alxgmpr/adum4165-isolator/docs/revc/renders/pcb-3d-isometric.png

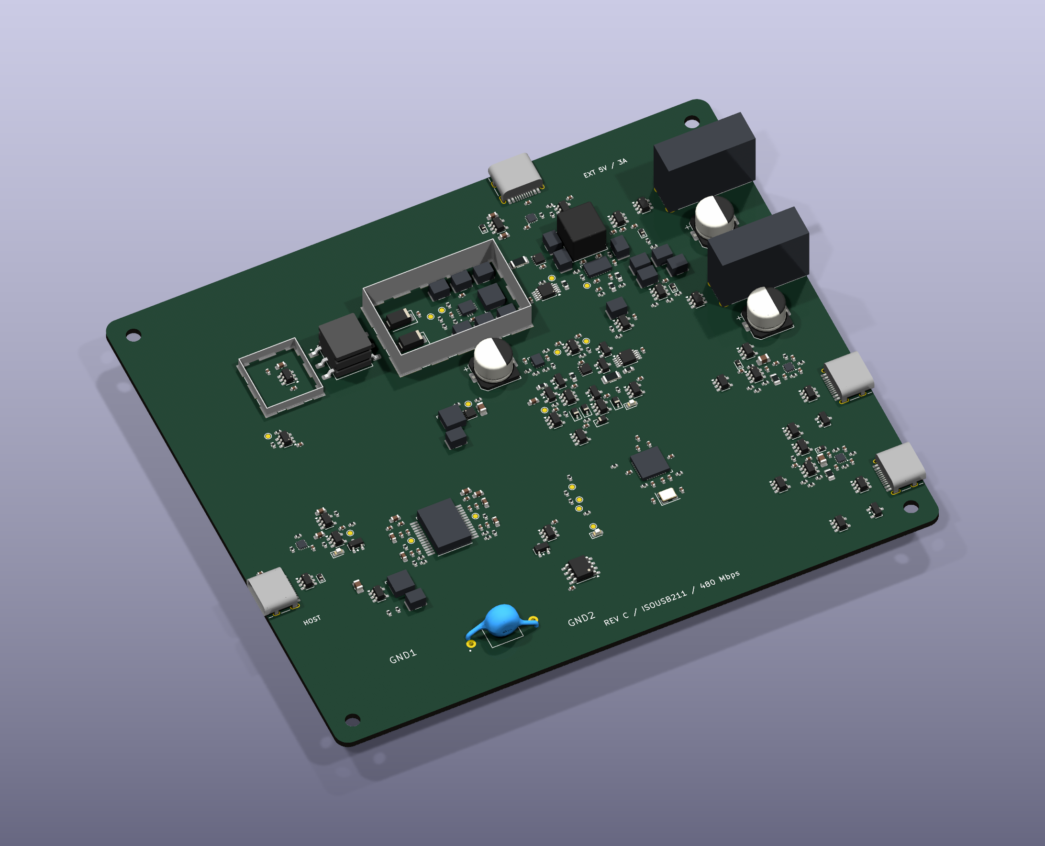
docs/revc/renders/pcb-3d-isometric.png
