alxgmpr/adum4165-isolator/docs/superpowers/reviews/2026-07-26-schematic-review.md

# Isolated 4-Port USB 2.0 Hub — Schematic Design Review

> **Repo note (2026-07-30):** this document describes the **archived 4-port
> design**. That project no longer lives at the repo root — it was archived to
> branch `4port-archive` when the repository collapsed to the single-port
> isolator. Every bare `isolator.kicad_sch` / `isolator.kicad_pcb` /
> `isolator.kicad_pro` path below refers to the **archived** files as they stood
> on that branch, **not** to the files of those names at the root today, which
> are the single-port isolator. Retrieve them with
> `git show 4port-archive:isolator.kicad_sch`.

**Project:** `isolator` (KiCad 10.0.5, single flat sheet, **no PCB yet**)
**Date:** 2026-07-26
**Branch / commit basis:** `feature/isolated-usb-hub`, after Task 11 (MPN population)
**Analyzers run:** `analyze_schematic.py` (run `2026-07-26_0129`), `deep_review_gate.py`, `check_report_sections.py`, `summarize_findings.py`, `diff_analysis.py`, `kicad-cli sch erc`
**Analyzers not run:** `analyze_pcb.py`, `cross_analysis.py`, `analyze_emc.py`, `analyze_thermal.py`, `analyze_gerbers.py`, SPICE, `lifecycle_audit.py` — see [Not Performed / Review Limits](#not-performed--review-limits)

---

## Verdict

**Schematic is release-ready for PCB layout. No blockers.**

ERC at severity `error` exits 0. Every BOM line carries a manufacturer part number (118/118 components, 37/37 BOM lines). Every IC's required externals were checked against its manufacturer PDF with page citations, and all 14 Deep Review findings passed the evidence gate with zero quarantined and zero partial citations.

One wiring change was made during this review (`U7.CP2`, see [Critical Findings](#critical-findings) DR-06). Five open items are carried to layout/bring-up; **none is a blocker and none forces a respin**. The largest, DR-01, turned out to be a documentation defect rather than a hardware one — the bus-powered ceiling is set by the host's 500 mA budget, not by the magnetics, and the spec's arithmetic has been corrected accordingly.

| Gate | Target | Result |
|---|---|---|
| `kicad-cli sch erc --severity-error` | exit 0 | **0 violations, exit 0** |
| Analyzer MPN coverage | ≥ 80% of BOM | **100% (118/118 components, 37/37 lines)** |
| SS-001 / SS-002 sourcing gate | cleared | **cleared — no SS finding emitted** |
| DS-001 / DS-002 / DS-003 datasheet gate | cleared | **cleared — 12 PDFs present, MPN coverage ≥ 90%** |
| Deep Review evidence gate | 0 quarantined | **14 verified, 0 partial, 0 quarantined** |
| Report completeness (`check_report_sections.py`) | all sections | **19/19 present, exit 0** |

---

## Overview

A galvanically isolated 4-port USB 2.0 hub. A USB-C host port (J1) feeds an **ADuM4165BRIZ** 5.7 kV<sub>rms</sub> high-speed USB isolator (U1, V<sub>ISO</sub> = 5700 V rms for 1 minute, V<sub>IORM</sub> = 849 V peak) with a local 24 MHz crystal on Side 1. The power barrier is set by T1's 5000 V rms insulation test voltage, so the assembly is a 5 kV<sub>rms</sub>-class design overall even though the isolator itself is rated higher. Isolated power is generated by an **SN6505BDBVR** push-pull driver (U5) into a **Würth 750313638** 1:1.3 transformer (T1), Schottky-rectified (D1/D2) to `DCDC_RAW` and regulated to 5.0 V by a **MIC29302WU** adjustable LDO (U6). An alternative external supply arrives on a power-only USB-C receptacle (J2); two **TLV7041DBVR** comparators (U13/U14) watch the CC lines for a 3 A source advertisement, and a **TPS2121RUXR** priority mux (U7) merges the two 5 V sources into `ISO_5V`. A **USB2514B-AEZC** 4-port hub (U4) runs from `ISO_3V3` (AP2112K-3.3, U8) with its own 24 MHz crystal, driving two USB-A (J3/J4) and two USB-C (J5/J6) downstream ports, each gated by a **TPS2553DBVR** current-limited switch (U9–U12) and protected by an **NUP4202W1T2G** ESD array (U15–U18).

Two ground domains only — `GND1` (host) and `GND2` (isolated) — bridged solely by U1 and T1. Design intent auto-classified as prototype / IPC class 2 / hobby (`design_intent.confidence` 0.3, all fields `auto`).

---

## Critical Findings

No blockers. Findings are ordered by the risk they carry into fab.

| ID | Sev | Area | Finding | Status |
|---|---|---|---|---|
| **DR-01** | Important | Power budget | **The bus-powered ceiling is the host's 500 mA budget, not the magnetics.** A compliant host gives 2.5 W; after U1 Side 1 (~0.35 W) and ~90 % converter efficiency, `ISO_5V` tops out at **≈310 mA**. Isolated-side self-draw is **≈235 mA**, leaving **≈75 mA for all four downstream ports combined** in bus-powered mode. The spec's "≈700 mA usable / 400–500 mA remains" is wrong by roughly 6×. | **Open — spec corrected, characterize at bring-up** |
| **DR-02** | Important | Regulator stability | MIC29302WU specifies a **7 mA minimum load**; `DCDC_5V` carries only **~3.1 mA** (124 µA divider + 2.9 mA LED branch) whenever the mux is running from external power. Below minimum load Microchip states the output rises. | **Open — bleeder at layout** |
| **DR-03** | Important | USB compliance | Downstream bulk capacitance is **89.0 µF nominal** against the 120 µF-per-hub requirement; MLCC DC-bias derating takes the effective figure to ~55–70 µF. | **Open — add cap at layout** |
| **DR-04** | Moderate | Part selection | `USB2514B-AEZC` is the **legacy** 36-pin QFN order code, rated **0 °C…85 °C**. Microchip recommends the 36-pin SQFN (`/M2`) for new designs. Industrial drop-in on the same footprint is `USB2514Bi-AEZG`. | **Accepted for prototype** |
| **DR-05** | Moderate | Thermal | U8 (AP2112K-3.3, SOT-23-5) dissipates up to **272 mW** feeding the hub — a ~68 °C junction rise at 250 °C/W. Current is fine (600 mA part); thermal is the constraint. Confirms the Task-7 deferred note. | **Open — copper pour at layout** |
| **DR-06** | — | Power path | **Fixed during this review.** `U7.CP2` was hard-grounded, so with PR1 pulled low the TPS2121 entered *VCOMP* mode, which selects the **higher** input — not IN2. `VCOMP` is specified 0/280/600 mV, so at the datasheet minimum a 5.0–5.25 V weak brick would beat `DCDC_5V` at 4.85–4.97 V, defeating the weak-source lockout. CP2 is now wired to `n3A_DET` (already high whenever no 3 A source is present), giving `CP2 ≥ VREF, PR1 < VREF → OUT = IN2` unconditionally. Zero new parts. Verified in all five quadrants including cold start (external present, host absent). Completing the analysis surfaced a conditional hunting risk — CP2's pull-up rail is downstream of the mux — which is mitigable but must not be actioned pre-emptively. | **Fixed; one conditional risk documented** |

Detail, citations and recommendations for all six live in `analysis/deep_review.json`; the narrative is in [Deep Review](#deep-review).

---

## Previous Review Delta

Prior analyzer runs exist (10 runs, `2026-07-25_1925` … `2026-07-26_0059`). `diff_analysis.py analysis/2026-07-26_0059/schematic.json analysis/2026-07-26_0129/schematic.json` reports 121 changes: +2 added, −1 removed, ~118 modified. No prior review markdown exists — this is the first full design review; per-task reviews were recorded in `.superpowers/sdd/2026-07-25-isolated-usb-hub-schematic/progress.md`.

| Status | Count | Detail |
|---|---|---|
| Fixed since the last run | 2 | `SS-001` (MPN coverage < 50%, `high`) cleared by MPN population. `inconsistent_mpn` property issue on Y1/Y2 cleared by disambiguating the two crystals' `Value` fields (`24M` → `24M 8pF` / `24M 12pF`). |
| Still open | 23 | 16 × `PP-001`, 5 × `RS-001`, 2 × `PU-001` — all triaged as analyzer false positives, see [False Positives](#false-positives--reviewer-overrides). |
| New | 1 net change | `U7.CP2`: `GND2` → `n3A_DET` (DR-06). `#PWR40` (a `power:GND2` symbol) removed, one local label added. |
| Carried from per-task ledger | 4 | PGOOD R25/R26 ship decision, dim ST LED (~273 µA), U8 thermal margin, 7 justified `lib_symbol_mismatch` ERC warnings. |

Findings counts moved 70 → 69 analyzer findings (error 17 → 16 as SS-001 cleared), plus 14 Deep Review findings = 83 total in the run summary.

---

## Component Summary

| Metric | Value |
|---|---|
| Placed symbols | 120 (49 C, 36 R, 18 IC, 6 connectors, 3 diodes, 3 LEDs, 2 transistors, 2 crystals, 1 transformer) |
| BOM components (in_bom, non-DNP) | 118 |
| Unique BOM lines | 37 |
| MPN coverage | **118/118 (100%)**, `bom_lock.status = pass` |
| Footprint coverage | 120/120, `missing_footprint = []` |
| DNP parts | **2** — R26 (100 k, the PGOOD pull-up alternative) and C49 (1 nF 2 kV barrier stitching cap). *The analyzer's `statistics.dnp_parts` counter reports 0; the per-component `dnp` flags are set correctly on both, so the counter is wrong, not the schematic.* |
| Unique footprints | 21 |
| Local datasheets | 12 PDFs in `datasheets/` |

### MPN selection and sourcing check

Every MPN below was checked against the LCSC jlcsearch API (no auth) plus, for parts where the local PDF exists, against the datasheet's own ordering guide. Prices are indicative LCSC qty-1 in USD, captured 2026-07-26.

| Refs | Value | MPN | Mfr | LCSC | Stock | $1 | Basis |
|---|---|---|---|---|---|---|---|
| U1 | ADuM4165 | `ADUM4165BRIZ` | Analog Devices | C5361362 (`-RL` reel) | 17 | 19.02 | Ordering Guide p.27: `ADUM4165BRIZ`, −55…+125 °C, 20-lead SOIC (increased creepage), RI-20-1 ✔ |
| U2/U3/U15–U18 | NUP4202 | `NUP4202W1T2G` | onsemi | C2937014 | 14,907 | 0.075 | Same part ADI fits on EVAL-ADuM4165EBZ (UG Table 4) |
| U4 | USB2514B | `USB2514B-AEZC` | Microchip | C633338 / C16251 (TR) | 23 / 4,903 | 1.21 | PIS p.55, 36-QFN 6×6, 0…85 °C — see DR-04 |
| U5 | SN6505BDBV | `SN6505BDBVR` | TI | C74518 | 2,241 | 0.517 | SOT-23-6 ✔ |
| U6 | MIC29302WU | `MIC29302WU` | Microchip | C18221475 / C11149 (TR) | 4,162 / 8,074 | 0.72 | PIS example (c): "MIC29302WU: 3A … Adjustable … 5-Lead TO-263" ✔ |
| U7 | TPS2121 | `TPS2121RUXR` | TI | C485916 | 4,833 | 0.867 | VQFN-HR-12 2.0×2.5 mm ✔ |
| U8 | AP2112K-3.3 | `AP2112K-3.3TRG1` | Diodes Inc | C51118 | 41,270 | 0.127 | SOT-23-5 ✔ |
| U9–U12 | TPS2553DBV | `TPS2553DBVR` | TI | C55266 | 31,628 | 0.184 | SOT-23-6, adjustable ILIM ✔ |
| U13/U14 | TLV7041DBV | `TLV7041DBVR` | TI | C702122 | **311** | 0.463 | SOT-23-5 ✔ — thin stock, see note |
| T1 | 750313638 | `750313638` | Würth Elektronik | — | **not stocked at LCSC** | — | TI SLLSEP9I Table 9-3 (p.29) recommends this exact part for SN6505B 5 V→5 V — source via Digi-Key/Mouser |
| Y1 | 24M 8pF | `SX3B24.000F0810F30` | SCTF | C2901675 | 2,470 | 0.086 | 24 MHz, CL 8 pF, **±10 ppm initial tolerance / ±30 ppm stability**, ESR 30 Ω, −40…85 °C, SMD3225-4P |
| Y2 | 24M 12pF | `X322524MOB4SI` | YXC | C70590 | 28,895 | 0.093 | 24 MHz, CL 12 pF, **±10 ppm initial tolerance / ±20 ppm stability**, ESR 50 Ω, −40…85 °C, SMD3225-4P |
| J1/J5/J6 | USB-C 16P | `TYPE-C-31-M-12` | HRO | C165948 | 336,394 | 0.161 | Exact part the KiCad footprint `USB_C_Receptacle_HRO_TYPE-C-31-M-12` is drawn for |
| J2 | USB-C 6P power | `USB4125-GF-A` | GCT | C3151650 | 1,008 | 0.771 | Matches footprint `USB_C_Receptacle_GCT_USB4125-xx-x_6P_TopMnt_Horizontal` |
| J3/J4 | USB-A | `67643-0910` | Molex | C2798029 | 2,563 | 0.869 | Matches footprint `USB_A_Molex_67643_Horizontal` |
| Q1/Q2 | 2N7002 | `2N7002LT1G` | onsemi | C16338 | 57,171 | 0.029 | SOT-23 G/S/D — see datasheet-coverage note |
| D1/D2 | SS34 | `SS34` | MDD | C8678 (basic) | 3,282,802 | 0.026 | SMA / DO-214AC ✔ |
| D5 | 1N4148WS | `1N4148WS-7-F` | Diodes Inc | C60580 | 611,244 | 0.014 | SOD-323 ✔ |
| D3/D4/D6 | LED | `KT-0603G` | Hubei KENTO | C12624 | 30,043 | 0.011 | Green 0603 |
| C1/C2 | 8p | `CC0603CRNPO9BN8R0` | YAGEO | C327316 | 200,300 | 0.010 | C0G/NP0 0603 |
| C32/C33 | 18p | `CC0603JRNPO9BN180` | YAGEO | C107040 | 105,800 | 0.012 | C0G/NP0 ±5% |
| 30 × 0.1u/100n | 0.1 µF | `CC0603KRX7R9BB104` | YAGEO | C14663 (basic) | 81 M | 0.002 | 50 V X7R ±10% |
| C21/C22/C34 | 1u | `CL10B105KA8NNNC` | Samsung | C29936 | 1,070,750 | 0.005 | 25 V X7R ±10% |
| 8 × 10u | 10 µF | `CL21A106KAYNNNE` | Samsung | C15850 (basic) | 12.6 M | 0.009 | 25 V X5R ±10% 0805 |
| C8/C10/C18 | 47u | `TMK325ABJ476MM-P` | Taiyo Yuden | C90142 | 14,611 | 0.29 | 25 V X5R 1210 |
| 36 resistors | 11 values | `RC0603FR-07…L` | YAGEO | 11 codes | 10 k…5.6 M | ~0.001 | Whole family is **±1 %, ±100 ppm/K** — satisfies the R_ILIM / RBIAS / divider precision requirements |

**Indicative LCSC BOM cost ≈ $29 per board excluding T1** (dominated by U1 at ~$19). T1 must be priced at Digi-Key/Mouser.

Sourcing notes and gaps:
- **U13/U14 (`TLV7041DBVR`) — 311 pcs at LCSC.** Thin for anything beyond a prototype run. `TLV7041DBVT` (small-reel) and the SC70 variant are alternates; check Digi-Key/Mouser before a production buy.
- **T1 (`750313638`) — no LCSC listing.** Expected: Würth/Midcom magnetics are distributor-only. Not blocking; it is the part TI names in its own recommended-transformer table.
- **U1 (`ADUM4165BRIZ`) — 17 pcs, and only the `-RL` reel variant at LCSC.** The tube part number (`ADUM4165BRIZ`) is set in the schematic because that is the base order code in the Ordering Guide; buy from Digi-Key/Mouser (tube of 31) or LCSC's reel (`-RL`).
- **U4 (`USB2514B-AEZC`) — 23 pcs of the tray part, 4,903 of `-AEZC-TR`.** Order the `-TR` suffix for volume; the datasheet states "Add `-TR` to the end of any QFN order number to order tape and reel".
- No distributor API keys were available (`DIGIKEY_CLIENT_ID` etc. unset), so DigiKey/Mouser/element14 stock and lifecycle status were **not** queried. See [Component Lifecycle](#component-lifecycle).

---

## Power Tree

```
USB-C host J1 ── VBUS_HOST (5 V, PWR_FLAG) ─┬─ U1.VBUS1  → internal LDO → VDD1 (3.3 V int., C5 = 0.1 µF)
                                            └─ U5 SN6505B VCC/EN ── T1 (1:1.3, 5 kVrms)
                                                                      ║  isolation barrier
      ══════════════════════════════════════════════════════════════ ║ ═══════════════════
                                                D1/D2 ── DCDC_RAW (≈6 V, PWR_FLAG)
                                                            └─ U6 MIC29302WU (adj, R3/R4) → DCDC_5V 4.972 V
USB-C power-only J2 ── EXT_5V (5 V, PWR_FLAG) ──────────────────────────────┐
                          └─ R5/R6 (5.1k Rd) → U13/U14 CC comparators → n3A_DET ─┐
                                                                                 ├─ U7.CP2  (new)
                                                          Q1 ── PR1_SENSE ───────┴─ U7.PR1
                          U7 TPS2121 priority mux (ILM 3.00 A, SS 0.1 µF) ── ISO_5V (5 V)
                                                                              ├─ U1.VBUS2 → VDD2 (C36 = 0.1 µF)
                                                                              ├─ U8 AP2112K-3.3 → ISO_3V3 → U4, U13, U14
                                                                              └─ U9–U12 TPS2553 (649 mA nom each)
                                                                                    └─ P1..P4_VBUS → J3..J6
```

Rail voltages resolved by the analyzer: `VBUS_HOST` 5.0, `EXT_5V` 5.0, `DCDC_5V` **4.972** (`vref_source = lookup`), `ISO_5V` 5.0, `ISO_3V3` 3.3, `P1..P4_VBUS` 5.0. Ground domains: exactly two (`GND1` 24 connections, `GND2` 105), `multiple_domains = false`, crossed only by U1 and T1 — the spec's central invariant holds.

---

## Power Budget

`power_budget` in the analyzer JSON only counts ICs it can attribute to a rail and applies a flat 10 mA/IC placeholder, so it under-reports badly (it reports `estimated_load_mA = 0` for `DCDC_5V` and `ISO_3V3`). The real budget was derived from the datasheets:

| Rail | Load | Source | Worst case |
|---|---|---|---|
| `VBUS_HOST` | U1 Side 1 `IDD1(H)` | ADuM4165 p.3 | 70 mA |
| | U5 + reflected isolated load | — | ≈ 295 mA at 80 % efficiency |
| `ISO_3V3` | U4 `IHCH1` base + 3 × 25 mA extra ports | USB2514B p.41 | 155 mA |
| | U13/U14, strap and divider network | — | < 1 mA |
| `ISO_5V` | U1 Side 2 `IDD2(H)` | ADuM4165 p.3 | 70 mA |
| | U8 input current | — | 160 mA |
| | LEDs D4/D6 | — | ~3 mA |
| | **Isolated-side self-draw, no devices attached** | | **≈ 235 mA** |
| | 4 downstream ports at the TPS2553 limit | computed | + up to 2.85 A (external power only) |

### DR-01 — the bus-powered ceiling is the host port, not the magnetics

The binding constraint in bus-powered mode is the **500 mA a USB 2.0 host port is obliged to supply**, and the arithmetic is short:

| Step | Value |
|---|---|
| Host budget, 500 mA at 5 V | 2.50 W |
| less U1 Side 1 (`IDD1(H)` 70 mA at 5 V) | −0.35 W |
| available to the converter | 2.15 W |
| × ~90 % end-to-end efficiency (SN6505B + transformer + rectifier) | 1.94 W |
| at `DCDC_RAW` ≈ 6.15 V → current through the LDO pass element | ≈ 315 mA |
| less MIC29302 ground current | **`ISO_5V` ceiling ≈ 310 mA** |
| less isolated-side self-draw | −235 mA |
| **left for all four downstream ports combined** | **≈ 75 mA** |

That is the real finding, and it is a **budget** fact, not a component-rating fact. Sensitivity: my own DCR-based estimate of `DCDC_RAW` lands between 5.8 V and 6.2 V depending on the SS34 forward drop, which moves the ceiling to ≈310–325 mA — it does not move the conclusion.

**The magnetics are not the limit, and the "100 mA" in TI's Table 9-3 is not a rating.** Four independent pieces of evidence:

1. The "100 mA" sits in Table 9-3's **application** column ("5 V → 5 V, 100 mA, SN6505B"), alongside a turns ratio and a size — it describes the operating point TI characterised, not a maximum.
2. TI's own curves for the electrically identical entry — Figures 6-21/6-22, captioned "SN6505B + Würth 760390014, VCC = 5 V", a 1:1.3, 5 V → 5 V, "100 mA" row — **sweep the load-current axis to 200 mA** with efficiency plotted to 90 %. TI characterises a "100 mA" entry at twice that current. (750313638's own rows carry **no** "Refer to Figure" reference, so TI published no curves for it at all.)
3. **The same part number appears twice in Table 9-3** with two different "ratings" — 1:1.3 for 5 V → 5 V at "100 mA" and 1.3:1 for 5 V → 3.3 V at "100 mA". A single transformer cannot have two different current ratings; the column is describing applications.
4. The LDO column is a **headroom** fact, not a capacity one, and TI corrected it after publication — the revision history records "Changed LDO from 'No' to 'Yes' for transformer ORDER NO. 750313638 and 750313626 in Table 9-3". It says post-regulation is needed, which this design already has.

Würth's own data agrees the part has headroom: the datasheet's "Typical Temperature Rise vs. Current Characteristics" curve (p.3) runs the **push-pull output current axis to 1.2 A**, with roughly a 40 K rise at 0.65 A — the same 0.65 A the agency-rated typical-application tables cite as I<sub>Out1</sub>. And the winding resistances hold the raw rail up: with R<sub>DC1</sub> = 0.35 Ω, R<sub>DC2</sub> = 0.33 Ω and the SN6505B's 0.25 Ω R<sub>ON</sub>, `DCDC_RAW` still sits at **≥ 5.49 V at 635 mA** — above the MIC29302's dropout at that current, so the 5 V rail would hold even at a load far beyond anything the host can feed.

Two further constraints compound the host-budget ceiling and belong on the bring-up sheet:

- A bus-powered USB device may draw **100 mA before configuration**. Side 1's draw during enumeration (U1 at 70 mA plus whatever the DC-DC reflects) exceeds that. The spec already accepts descriptor-honesty deviations for bus-powered mode; this is the electrical corollary.
- `ISO_3V3`'s own consumer, the hub, is 155 mA of the 235 mA self-draw — so most of the bus-powered budget is spent before a single downstream port is energised.

None of this is a wiring defect, and none of it argues for changing T1. "Bus-powered mode is a light-load mode" (spec, Known limitations) is the operative truth; what needed fixing was the spec's arithmetic, which has been corrected in `docs/superpowers/specs/2026-07-25-usb-isolator-design.md`.

## Power Sequencing

Two regulators with controlled enables, both intentional and both verified against their datasheets:

| Regulator | Rail | EN net | Behaviour |
|---|---|---|---|
| U6 MIC29302WU | `DCDC_5V` | `DCDC_RAW` | EN tied to VIN — always enabled as soon as the rectifier has output. |
| U8 AP2112K-3.3 | `ISO_3V3` | `ISO_5V` | EN tied to VIN — `ISO_3V3` follows `ISO_5V`, so the hub cannot run before the isolated 5 V rail is up. |

U1's `PGOOD` (Side 2) drives `PGOOD2`, which feeds U4's `VBUS_DET` and the PGOOD LED buffer Q2. Per the ADuM4165 datasheet (p.22) PGOOD asserts only once **both** side supplies are above UVLO **and** a valid clock is present on XI1 — so `VBUS_DET` is a genuine "the host side is alive and clocked" signal, which is exactly what the hub needs to gate enumeration. Either side may power up first; when Side 2 comes up first it sits in low-power mode until Side 1 arrives.

**Carried decision (from Task 7):** ship `R25` only (PGOOD pull-down). If `PGOOD2` will not reach > 2.0 V with both sides up, PGOOD is open-drain — populate `R26` (pull-up) and remove `R25`. Both pads exist.

`HUB_RESET` is an RC (R16 10 k to `ISO_3V3`, C34 1 µF, τ ≈ 10 ms) with D5 as the discharge diode, so U4 releases reset well after `ISO_3V3` settles.

## PDN Impedance

The analyzer's `pdn_impedance` block models MLCC parasitics from 1 kHz–1 GHz, but **only for the three rails carrying a `power:` symbol** — `VBUS_HOST`, `VDD1`, `VDD2`. The `ISO_5V` and `ISO_3V3` rows below were tallied by hand from the net lists, not taken from the analyzer.

| Rail | Caps | Total C | Notable SRFs |
|---|---|---|---|
| `VBUS_HOST` *(analyzer)* | C3, C4, C6, C7 | 20.2 µF | 10 µF 0805 → 1.68 MHz; 0.1 µF 0603 → 19.0 MHz |
| `VDD1` / `VDD2` *(analyzer)* | C5 / C36 | 0.1 µF each | 19.0 MHz — value is fixed by the datasheet, see DR-07 below |
| `ISO_5V` *(hand tally)* | **8 caps: C18 (47 µF), C21 (1 µF), C19, C35, and the four TPS2553 input caps C37/C40/C43/C46 (0.1 µF each)** | 48.6 µF | 47 µF 1210 bulk plus 6 × 0.1 µF HF. The four port-switch input caps are load-bearing in this total — the 48.6 µF figure quoted in DR-03 and in the inrush calculation is **not** reachable from C18/C19/C21/C35 alone. |
| `ISO_3V3` *(hand tally)* | C16, C17, C22 (1 µF), C23–C29 | 1.9 µF | 9 × 0.1 µF spread across the hub's six supply pins, plus one 1 µF |

The `ISO_3V3` PDN is the one to watch at layout: 1.9 µF of total capacitance for a 155 mA hi-speed hub is thin on bulk. The Task-7 deferred note already calls for a 4.7–10 µF bulk cap near U4 on `ISO_3V3` at the PCB stage — **that item is still open and should be actioned during layout**, not deferred again. Placement of the 0.1 µF parts (one per VDD33/VDDA33 pin) is correct.

## Sleep Current Audit

`total_estimated_sleep_uA = 555 µA`, all of it regulator quiescent current (U6 500 µA, U8 55 µA), both nominally disable-able via EN — but both ENs are hard-tied to their inputs here, so the "realistic 0.0 µA" figure the analyzer prints is wrong for this design. **Treat 555 µA as always-on.** No resistive sleep paths were found beyond the LED and divider currents accounted for in DR-02.

The ADuM4165 supports L2 suspend (`IDD2(S)` 40 µA typ) but not L1 sleep — an accepted spec limitation.

## Inrush Analysis

| Rail | Output C | Estimated inrush | Note |
|---|---|---|---|
| `DCDC_5V` (U6) | 47.1 µF | 0.47 A | assumes 0.5 ms soft-start; MIC29302 has internal current limit |
| `ISO_3V3` (U8) | 1.9 µF | 0.013 A | negligible |
| `ISO_5V` (U7 switchover) | 48.6 µF | **~38 mA** | computed from the TPS2121's own soft-start table, not the analyzer's default |

The switchover figure is the meaningful one: C20 = 0.1 µF on `SS`, and the datasheet's worked example (p.24) gives 780 V/s for a 100 nF C<sub>SS</sub> at 5 V. 780 V/s × 48.6 µF ≈ 38 mA — a soft, well-controlled handover between sources.

---

## Signal Analysis Review

**USB data paths.** Four differential pairs detected and classified (`P1_DP/DM` … `P4_DP/DM` as `usb`, `differential: true`), plus `HOST_DP/DM` (J1 ↔ U1) and `ISO_DP/DM` (U1 ↔ U4). J1's A6/B6 and A7/B7 tie-wires are present (the KiCad USB-C symbol does not common them internally) — same for J5/J6. No cross-port swaps: each `Px_DP/DM` pair runs from the correct U4 pin pair through the correct NUP4202 to the correct connector.

**Clocking.** Two independent 24 MHz domains, one per side of the barrier — `XTALIN/XTALOUT` (Y1, U1 pins 5/6, `GND1`) and `HUB_XI/HUB_XO` (Y2, U4 pins 33/32, `GND2`). Both verified against their host IC's crystal requirements — see Deep Review DR-08 and DR-09.

**Control and status.**
- `n3A_DET`: wire-OR of U13/U14 open-drain outputs, R9 100 k pull-up to `ISO_3V3`, driving Q1's gate **and now U7.CP2**. Comparator polarity (IN+ ← `VTH` 1.227 V from R7/R8; IN− ← `EXT_CCx`) gives `n3A_DET` low when a CC line exceeds threshold, i.e. **low = 3 A source detected**, high = no 3 A source. Q1 inverts that onto `PR1_SENSE`.
- `PRTPWR1..4` → TPS2553 `EN`, `nOCS1..4` ← TPS2553 `FAULT`. Correct per-port pairing. **No pull-ups on `PRTPWR*`** — correct, those nets double as `BC_EN` straps sampled at reset (Task-7 note).
- `ST_IND`: U7's open-drain ST with R13 10 k pull-up and an R14 + D4 branch, so D4 lights when ST is released (external source active). Semantics unchanged by the CP2 fix.

**Detected subcircuits** (all reviewed, all intentional): 3 voltage dividers (R3/R4 MIC feedback, R7/R8 comparator threshold, R10/R11 PR1 sense), 2 RC filters (R36/C11 at 1.59 kHz on the DC-DC LED branch, R16/C34 at 15.9 Hz reset), 2 crystal circuits, 1 isolation barrier (2 ground domains, 1 isolation component), 1 power path (`U7` classified `power_mux`), 6 ESD arrays, 2 LDOs, 1 transistor-driven LED (Q2 → D3).

---

## USB Compliance

Analyzer roll-up: **21 pass / 10 fail / 11 info** across six connectors.

| Connector | Role | Result |
|---|---|---|
| J1 (host, USB-C 16P) | UFP / sink | CC1/CC2 5.1 k Rd **pass**, VBUS decoupling **pass**, ESD IC **pass** |
| J2 (external power, USB-C 6P) | sink | CC1/CC2 5.1 k Rd **pass** — dedicated pair R5/R6, feeding the 3 A comparators |
| J3/J4 (USB-A downstream) | DFP | ESD IC **pass**, VBUS decoupling **pass** |
| J5/J6 (USB-C downstream) | DFP | `cc1/cc2_pulldown_5k1` **fail** — false positive, see below |

All ten `fail` results are the two known heuristic classes (`vbus_esd_protection` × 6, `cc*_pulldown_5k1` × 4) triaged in [False Positives](#false-positives--reviewer-overrides). The one genuine compliance gap is bulk capacitance (**DR-03**).

Downstream USB-C ports advertise **Default USB power** via 56 kΩ Rp (R31–R34) from each CC pin to that port's VBUS — deliberately not 1.5 A or 3 A, which the 649 mA per-port limit could not honour. Correct and conservative.

Series resistors on D+/D− are reported `info` on every port: none are fitted. That is correct for USB 2.0 — the ADuM4165 and USB2514B both integrate their termination.

## Bus Topology

No KiCad bus objects are used (`bus_wire_count = 0`); connectivity is by net label throughout, per the project's working conventions. The analyzer's prefix grouping recognised the intended vectors: `PRTPWR1..4`, `nOCS1..4`, `EXT_CC1..2`, `HUB_CFG_SEL0..1`, `HUB_NON_REM0..1`, `VDD1..2`. Nothing is mis-grouped and no vector has a missing member.

The only "bus" in the protocol sense is the hub's SMBus/I²C pins, which are **not** used as a bus — see the protocol_compliance false positive below.

---

## Deep Review

Per-IC comparison of actual usage against datasheet requirements, recorded in `analysis/deep_review.json` and validated by `deep_review_gate.py`: **14 findings, 14 verified, 0 partial, 0 quarantined.** Every finding carries at least one design anchor and at least one evidence source; every datasheet quote was re-extracted from the cited page of the local PDF by the gate itself.

### U1 — ADuM4165BRIZ

- **DR-07 (verified).** `VDD1`/`VDD2` bypass is **exactly 0.1 µF** (C5, C36). The datasheet (p.22) warns that more than 0.1 µF on these internal-LDO outputs can disrupt start-up — this is a value that must not be "improved" at layout. `VBUS1` (C4) and `VBUS2` (C35) also carry the specified 0.1 µF, and both supplies sit inside the 4.5–5.5 V window given in the pin table (p.12). *Fresh check this pass.*
- **DR-08 (verified).** Crystal requirement is "≤ 50 ppm tolerance with ≤ 100 ppm stability" (p.22) plus "a typical crystal capacitance of 10 pF and capacitive loads < 10 pF". C1/C2 are 8 pF C0G, satisfying the load constraint. `EVAL-ADuM4165EBZ` Table 4 pairs exactly those 8 pF loads with a 24 MHz / ±50 ppm / **8 pF** / 50 Ω 4-SMD crystal (IQD `LFXTAL056140REEL`) — so CL = 8 pF is ADI's own validated point, and that is what has been specified. ADI publishes no XI1/XO1 pin capacitance, so CL<sub>eff</sub> can only be bounded: 5.0 pF (2 pF stray) to 8.0 pF (8 pF stray), a pull error of at most **+71 ppm** at the low end.

  **Both halves of ADI's ppm requirement are met** — LCSC's full parameter set separates the two figures the summary view collapses: the SCTF part is **±10 ppm initial ("normal temperature") frequency tolerance** with **±30 ppm stability**, against ADI's ≤ 50 ppm tolerance and ≤ 100 ppm stability. Y2's YXC part is ±10 ppm / ±20 ppm on the same split. This closes what the first pass had left open as an unconfirmed caveat.
- Pin map re-checked against p.12–13: VBUS1/GND1/VDD1/XI1/XO1/UD±/GND2/DD±/PGOOD/VDD2/VBUS2 all on the intended nets. Pins 15/16/17 (`GND2`) are explicitly "not suitable for connection of bypass capacitance" — the Task-7 layout note (C35/C36 return via pins 11/19) still stands and must be honoured in layout.

### U4 — USB2514B-AEZC

- **DR-10 (verified).** Required externals all present and correctly valued: `RBIAS` = **12.0 k ±1 %** (R15, `RC0603FR-0712KL`, a ±1 % ±100 ppm/K part) matching "a 12.0 kΩ (+/- 1%) resistor is attached from ground to this pin" (p.12); `CRFILT` and `PLLFILT` both 0.1 µF (C30/C31) at the datasheet's ceiling of "up to a 0.1 µF low-ESR capacitor to VSS" (p.14). All six VDD33/VDDA33 pins on `ISO_3V3`, VSS/ePad on `GND2`. *Fresh check this pass.*
- **DR-09 (verified).** Y2 load caps match Microchip's own worked number. Figure 7-2 (p.44) gives C1 = 2 × (CL − C0) − CS1 with C0 → 0 and CS1 = CB + CXTAL; CXTAL is 6 pF, so the ideal C1 is 15–17 pF and Note 7-2 states the values are "typically around 18 pF". C32/C33 are 18 pF, giving CL<sub>eff</sub> 12.5–13.5 pF against the CL = 12 pF crystal specified — a pull of about **−15 ppm**, far inside the ±350 ppm the hub requires.
- **DR-04 (warning).** Order-code and temperature-range note — see [Critical Findings](#critical-findings).
- `TEST` (pin 11) is a no-connect, as required ("treat as a no connect pin or connect to ground. No trace or signal should be routed or attached to this pin"). Strap pins are at their default states with no EEPROM/SMBus fitted, per the spec.

### U5 — SN6505BDBVR

- **DR-11 (verified).** Control pins follow the datasheet exactly: `EN` (pin 5) on `VBUS_HOST`, the same net as `VCC` — "If unused this pin should be tied directly to VCC" (p.3); `CLK` (pin 6) on `GND1`, and the pin is internally pulled down with automatic fall-back to the internal spread-spectrum oscillator. VCC bypass is C7 (10 µF 0805 X5R 25 V) + C6 (0.1 µF) against the required "bypassed with a 4.7 µF or greater, low ESR capacitor"; at 5 V DC bias the 25 V X5R part still retains roughly 8 µF. *Fresh check this pass.*
- **DR-01 (warning).** TI's Table 9-3 (p.29) lists the exact pairing used here — 1:1.3 ±2 %, "5 V → 5 V, 100 mA, SN6505B", LDO required, order no. 750313638, Würth/Midcom — so the topology is TI-endorsed *and* the "100 mA" is an application-column characterisation point rather than a rating. The real ceiling is the host's 500 mA budget: ≈310 mA on `ISO_5V`, ≈75 mA left for downstream ports. See [DR-01 in Power Budget](#dr-01--the-bus-powered-ceiling-is-the-host-port-not-the-magnetics).

### U6 — MIC29302WU

- **DR-12 (verified).** ADJ reference is 1.240 V typ (1.228–1.252 V); with R3 = 30.1 k over R4 = 10.0 k that is **4.972 V nominal, 4.851–5.097 V** with ±1 % divider tolerance stacked on the reference spread — matching the analyzer's independent 4.972 V estimate. Even the 4.851 V corner leaves headroom above the 4.75 V a downstream port must see after the U7 (56 mΩ) and TPS2553 drops. C10 = 47 µF clears Table 4-1's 10 µF minimum for the MIC2930x family (p.25).
- **DR-02 (warning).** Minimum load current — see [Critical Findings](#critical-findings). *Fresh check this pass; this is the finding that a value-only review would have missed.*
- Thermal: P<sub>d</sub> = 103 mW at 100 mA / 411 mW at 400 mA with ≈6 V raw, 611 mW at the 6.5 V raw corner. TO-263-5 with θ<sub>JC</sub> = 2 °C/W handles this comfortably **given a copper pour** — the tab is the only heat path. Add that to the layout brief.

### U7 — TPS2121RUXR

- **DR-13 (verified).** ILIM: Equation 2 (p.13) gives ILM = 65.2 / R<sub>ILIM</sub><sup>0.861</sup>, valid 18–100 kΩ. R12 = 35.7 k → **3.002 A**, with OCP fold-back at 2.4× that. Soft-start C20 = 0.1 µF → 780 V/s (p.24) → ~38 mA switchover inrush into the 48.6 µF on `ISO_5V`. `OV1`/`OV2` on `GND2` means the overvoltage comparators never trip — the intended "no OV protection" configuration per Table 9-3.
- **DR-06 (fixed).** The CP2 / VCOMP defect and its one-wire fix — see [Critical Findings](#critical-findings). Post-fix truth-table walk:

  | # | Condition | `n3A_DET` | CP2 | PR1 | Table 9-3 row | OUT |
  |---|---|---|---|---|---|---|
  | 1 | 3 A source on J2, host up | low | < VREF | 1.60 V ≥ VREF | CP2=0, PR1=1 | **IN1** (external) ✔ |
  | 2 | Weak / Default-USB source on J2, host up | high (3.3 V) | ≥ VREF | ≈ 0 | CP2=1, PR1=0 | **IN2** (DC-DC) ✔ |
  | 3 | Nothing on J2 | high | ≥ VREF | 0 (`EXT_5V` = 0) | IN1 ≤ UV → Invalid Input | **IN2** ✔ |
  | 4 | DC-DC failed, 3 A source present | low | < VREF | ≥ VREF | CP2=0, PR1=1 | **IN1** ✔ |
  | 5 | **Cold start: external present, host absent** | ≈ 0 (see below) | < VREF | 1.599 V ≥ VREF | rows 3 **and** 7 both → IN1 | **IN1** ✔ |

  **Cold-start quadrant (row 5), the case CP2-to-a-mux-derived-rail makes non-obvious.** With the host unplugged, `ISO_3V3` is dead, so R9 is a pull-up to 0 V — a *deterministic* pull-down on `n3A_DET`, not a float, and CP2 is unambiguously below V<sub>REF</sub>. PR1 is unaffected because its divider (R10/R11) is fed from `EXT_5V`, not from the mux output: 5 V × 47 k / 147 k = **1.599 V**, above the 1.06 V threshold. Table 9-3 resolves this two ways that agree — row 3 (`CP2 < VREF, PR1 ≥ VREF → IN1`) and row 7 (IN2 ≤ UV, "Invalid Input" → IN1) — so the mux comes up on the external supply. Once `ISO_5V` energises U8 and `ISO_3V3` rises, R9 pulls `n3A_DET` up only if no 3 A advertisement is present; with a genuine 3 A source the comparators hold it low and nothing changes. Either way row 7 keeps OUT on IN1 until the DC-DC is actually alive. **Stable in both directions; no start-up race.**

  **New risk found while completing this analysis: CP2's pull-up rail sits downstream of the mux.** The path is `OUT → U8 → ISO_3V3 → R9 → CP2`, so CP2's logic level depends on the rail the mux is producing. In the specific combination of *weak brick present + host present + DC-DC unable to hold up its load*, that closes a loop: DC-DC sags → IN2 drops toward the 2.55 V UV falling threshold → mux hands over to IN1 → the weak brick now carries the whole board → if it in turn sags, IN2 recovers unloaded and the mux hands back. The only damping is the TPS2121's own IN2 UVLO hysteresis (2.65 V rising / 2.55 V falling); nothing in the CP2 path adds any. The result would be a slow relaxation oscillation — hunting between sources — rather than a hard failure. It cannot occur while the DC-DC is comfortably within budget, which after DR-01 is the expected case, and it cannot occur at all without an external supply attached. **Mitigation, only if bring-up shows the DC-DC is marginal:** re-derive CP2's pull-up from `EXT_5V` through a divider (`EXT_5V` is upstream of the mux, so the loop opens) rather than from `ISO_3V3`. Do not implement pre-emptively — it costs two parts and the present wiring is correct for every non-marginal case.

  **Q1 is on the lockout critical path.** The whole lockout depends on Q1 pulling `PR1_SENSE` below 1.04 V while sinking the ~34 µA the R10/R11 divider delivers, driven by a 3.3 V gate. That is an enormous margin for any 2N7002 (V<sub>GS(th)</sub> ≤ 2.5 V worst case, and at 34 µA the required R<sub>DS(on)</sub> is trivial), so there is no practical risk — but it should be named: **the specified MPN's parametrics are not verified against a local datasheet**. `datasheets/2N7002.pdf` is JCET's part, the BOM specifies onsemi `2N7002LT1G`; the SOT-23 pinout was checked and matches, V<sub>GS(th)</sub> and R<sub>DS(on)</sub> were not.

  Loading check: control-pin leakage is ±0.1 µA max, so R9's 100 kΩ pull-up drops at most 10 mV — `n3A_DET` high presents ~3.29 V to CP2, well above the 1.06 V V<sub>REF</sub> rising threshold, and the comparator's V<sub>OL</sub> is a few mV, well below the 0.99 V falling threshold.

### U9–U12 — TPS2553DBVR

- **DR-14 (verified).** The three current-limit equations (p.15) at R = 40.2 kΩ give **592 / 649 / 713 mA** min/nom/max, inside the recommended 15–232 kΩ window. The 592 mA worst-case minimum clears the 500 mA a USB 2.0 high-power port must deliver; the 713 mA maximum × 4 ports = 2.85 A stays under U7's 3.00 A. Independently reproduces the Task-8 numbers.

### Interacting pairs

- **`ISO_5V` shared rail (U1, U8, U9–U12):** no sequencing conflict — U8's EN is tied to `ISO_5V`, so `ISO_3V3` cannot lead it; the TPS2553 switches are held off by `PRTPWR*` until the hub enumerates. Combined load analysed in [Power Budget](#power-budget).
- **`ISO_3V3` shared rail (U4, U13, U14):** the comparators draw 315 nA each — negligible against the hub. `VTH` (R7/R8) is referenced to the same rail as the comparator supply, so the 1.227 V threshold tracks any `ISO_3V3` error, which is the right behaviour for a ratiometric CC measurement.
- **U6 → U7 (`DCDC_5V`):** DR-02's light-load rise is only visible to U7's IN2 pin, abs-max 22 V, so there is no overstress path — the exposure is a raised `ISO_5V` if the external source is removed while DCDC_5V is high. Bounded and measurable.
- **U1 → U4 (`PGOOD2` → `VBUS_DET`):** the ADuM's PGOOD is 3.3 V-domain and U4's VBUS_DET is a 3.3 V input on the same `ISO_3V3` domain. No level-shift needed.
- **Thermal neighbours:** U6 (TO-263, up to 611 mW) and U8 (SOT-23-5, up to 272 mW) are the only meaningful heat sources. Keep them apart at layout.

---

## Test Coverage

**No test points anywhere in the design** (`test_point_count = 0`), and no debug connector. The analyzer flags four key nets as uncovered: `VBUS_HOST`, `VDD1`, `VDD2`, `HUB_RESET`. Given the number of measurements the bring-up checklist below requires, this is worth fixing at layout.

Recommended minimum test-point set for layout: `VBUS_HOST`, `DCDC_RAW`, `DCDC_5V`, `EXT_5V`, `ISO_5V`, `ISO_3V3`, `PGOOD2`, `n3A_DET`, `PR1_SENSE`, `HUB_RESET`, `GND1`, `GND2`. Ten of those are directly named in the bring-up checklist. Auto-detected `test_coverage_target` is 0.85, currently 0.

## Assembly Complexity

`complexity_score = 35/100` — "low, hand assembly feasible". 120 SMD parts, 0 through-hole. Package mix: 76 × 0603, 12 other SMD, 10 × SOT-23, 8 × 0805, 6 × SC-70, 3 × 1210, 2 × QFN, 1 × SOIC, 1 × TO-263, 1 × 1812. Two parts are flagged hard-to-solder (the two QFNs, U4 and U7 — U7 is a 2.0 × 2.5 mm VQFN-HR with 0.5 mm pitch and will want a stencil).

No 0201/0402 parts, which keeps hand-rework realistic. The TO-263 tab (U6) and the QFN thermal pads (U4, U7) need paste-aperture attention on the stencil.

## BOM Optimization

11 unique resistor values across 36 resistors and 8 unique capacitor values across 49 capacitors — a lean spread for a board this size. 21 unique footprints; 5 single-use passive values (35.7 k, 12.0 k, 30.1 k, 16.9 k and the 1 µF group), each of which is a computed value that cannot be merged without changing behaviour. The `100n`/`0.1u` value-string split remains (C4/C5 versus the other 28) but both lines now carry the **same MPN**, so it is a cosmetic label difference, not two purchase lines.

No consolidation opportunities worth taking. Do not merge Y1 and Y2 — they are different load capacitances and are deliberately distinguished in the `Value` field.

---

## Datasheet Coverage

`datasheets/` holds 12 PDFs; the coverage gate is clear (no DS-001/DS-002/DS-003 emitted). Coverage by BOM line:

| Status | Parts |
|---|---|
| **Manufacturer PDF present and cited in this review** | U1 (`ADUM4165BRIZ.pdf` → symlink to `adum4165-4166.pdf`), U4, U5, U6, U7, U9–U12, U13/U14, T1, U2/U3/U15–U18, plus the EVAL-ADuM4165 user guide |
| **PDF present but for a different manufacturer's equivalent** | Q1/Q2 — `datasheets/2N7002.pdf` is JCET's part; the specified MPN is onsemi `2N7002LT1G`. The SOT-23 pinout (1 = G, 2 = S, 3 = D) is identical and was checked against the local PDF, so the symbol's pin assignment is verified; the onsemi parametric data (V<sub>GS(th)</sub>, R<sub>DS(on)</sub>) is **not** locally verified. |
| **No local PDF** | **U8 (AP2112K-3.3)** plus passives, connectors, LEDs, D1/D2, D5, Y1, Y2 (24 lines). Specs used in this review for Y1/Y2 came from the LCSC parametric database, not from the manufacturer PDF. U8's 600 mA rating and its ~250 °C/W SOT-23-5 θ<sub>JA</sub> are from general part knowledge, not a local datasheet — the DR-05 thermal conclusion should be re-checked against the Diodes Inc PDF before fab. |

`datasheets/NUP4202W1T2G.pdf` yields no extractable text (image-only scan) — the NUP4202 claims in this review rest on the ADI eval-board BOM (which specifies the same part) and on the schematic's own pin mapping, not on a datasheet quote. Recorded as a verification gap.

Datasheet **sync was not run** — the kicad-happy DigiKey/LCSC sync scripts need API credentials that are not set in this environment. Local coverage was already sufficient for every IC-level claim made here.

---

## Analyzer Verification

The analyzer output was cross-checked against the raw `.kicad_sch` and against KiCad's own tooling rather than taken at face value.

| Check | Method | Result |
|---|---|---|
| Component count | `grep`-count of top-level `(symbol (lib_id` blocks = 236, minus power symbols and PWR_FLAGs | matches the analyzer's 120 placed / 118 BOM |
| Pin-to-net mapping | `ic_pin_analysis` compared pin-by-pin against each IC's datasheet pin table for U1, U4, U5, U6, U7, U8, U13, U14 | no discrepancies |
| Netlist agreement | `kicad-cli sch export netlist --format kicadsexpr` | exports cleanly; net membership agrees with the analyzer |
| Rail source declarations | ERC with `power_pin_not_driven = error` returning 0 violations | proves every power_in net has a driver; see False Positives |
| Regulator V<sub>out</sub> | `vref_source = "lookup"` for U6 (datasheet-backed, not heuristic); independently recomputed from the 1.240 V reference | 4.972 V both ways |
| Crystal load caps | analyzer's 7.0 pF / 12.0 pF (fixed 3 pF stray) vs. the per-IC formulas in `analysis/helpers/verify_limits.py` | analyzer's Y2 figure agrees; its Y1 figure ignores the unpublished ADuM pin capacitance, hence the bounded range in DR-08 |
| Transistor pinout | `transistor_pin_analysis` for Q1/Q2 vs. `datasheets/2N7002.pdf` SOT-23 diagram | 1 = G, 2 = S, 3 = D — matches |
| MPN ↔ footprint consistency | each connector MPN checked against the KiCad footprint it is named for | J1/J5/J6, J2, J3/J4 all match by construction |

**Trust rollup for the run:** 83 findings, `provenance_coverage_pct = 98.6`, 37 deterministic / 32 heuristic / 14 datasheet-backed (the Deep Review set). Every `error`-severity analyzer finding is heuristic, and all 16 were dismissed with raw-file evidence.

---

## False Positives / Reviewer Overrides

All 23 open analyzer warnings and errors were triaged. **None is a real defect.**

| Rule | Count | Refs | Why it is a false positive |
|---|---|---|---|
| `PP-001` (error) | 16 | U1.20, U4.5/10/15/23/29/36, U6.2, U7.2, U8.1, U9–U12.1, U13.5, U14.5 | The detector proves a DC path only to a net that `is_power_net()` recognises — i.e. a net carrying a `power:` symbol or matching a name pattern like `VDD*`/`VCC*`. `ISO_5V`, `ISO_3V3`, `DCDC_5V` and `DCDC_RAW` match neither, so the 2-hop walk terminates on capacitors and reports "AC-coupled". Raw-file evidence to the contrary: `ISO_5V` carries `U7.1 (OUT, power_out)`, `ISO_3V3` carries `U8.5 (VOUT, power_out)`, `DCDC_5V` carries `U6.4 (VOUT, power_out)`, and `DCDC_RAW` is fed by the D1/D2 rectifier cathodes from T1's secondary. Every one of these rails has a real, direct DC source. **Dismissed.** |
| `RS-001` (warning) | 5 | `DCDC_RAW`, `EXT_5V`, `VBUS_HOST`, `VDD1`, `VDD2` | The analyzer deliberately strips PWR_FLAG pins out of the net graph (`analyze_schematic.py` line 1359: "skip PWR_FLAG — it's an ERC marker, not a real connection") and then reports the same nets as having no declared source. The schematic carries exactly seven PWR_FLAGs (`#FLG01`–`#FLG06`, `#FLG08`), and the project's ERC sets `power_pin_not_driven = error`; ERC returns **0 violations**, which is only possible if every one of these five nets plus `GND1`/`GND2` carries a flag. **Dismissed.** |
| `PU-001` (warning) | 1 | U4 `RESET_N` | A pull-up **is** fitted: R16 (10 k, `RC0603FR-0710KL`) from `ISO_3V3` to `HUB_RESET`. The detector missed it for the same reason as `PP-001` — `ISO_3V3` is not in its known-power-rail set. The analyzer's own `detect_rc_filters` sees the same network ("RC filter R16/C34 at 15.92 Hz"). **Dismissed.** |
| `PU-001` (warning) | 1 | U6 `EN` | U6's EN is tied directly to VIN (`DCDC_RAW`) — the standard always-enabled configuration for the MIC2930x. A pull-up to a net the pin is already shorted to would be meaningless. **Dismissed.** |
| `usb_compliance.cc*_pulldown_5k1` (fail) | 4 | J5, J6 | J5/J6 are **downstream-facing** ports. A DFP must present Rp (pull-**up**), not Rd. R31–R34 are 56 kΩ from each CC pin to that port's VBUS = Default USB power advertisement, which is the design intent. The check hard-codes the UFP/sink pattern. Previously triaged in Task 8; **re-confirmed, not re-litigated.** |
| `usb_compliance.vbus_esd_protection` (fail) | 6 | J1–J6 | The heuristic looks for a discrete TVS on the VBUS pin. This design protects the data pairs with NUP4202 arrays (which the same analyzer scores `usb_esd_ic: pass` on five of six connectors) and relies on the TPS2553 switches, which carry 15 kV IEC 61000-4-2 ratings with external capacitance, for VBUS. Previously triaged in Task 8; **re-confirmed.** A discrete VBUS TVS per downstream port is a reasonable *addition* at layout if the board is destined for formal ESD testing, but its absence is not a defect. |
| `protocol_compliance` i2c missing pull-ups | 2 issues | `HUB_NON_REM1`, `HUB_CFG_SEL0` | These are U4's SMBus/I²C pins used **as configuration straps** — no EEPROM or SMBus master is fitted, per the spec's "default strap configuration (no SMBus/EEPROM)". Treating them as a live bus is a naming-based misfire. Previously triaged in Task 7; **re-confirmed.** |
| `lib_symbol_mismatch` (ERC warning) | 7 | Q1/Q2 group, U7, others | Cosmetic cache-vs-library-table divergence, all seven electrically verified during Tasks 5–9. Not surfaced at `--severity-error`. **Accepted.** |
| `NT-001` / single-pin nets | 0 | — | None present. |

Reviewer overrides that are *not* false positives but deliberate design choices worth recording:

- **U7 `OV1`/`OV2` tied to `GND2`** — overvoltage protection deliberately disabled; both sources are hard 5 V rails already bounded by their own regulators.
- **`ILIM`/`SS` pins typed `input` in the project symbol library** though the datasheets mark them `O` — an intentional ERC convention from Task 3.
- **D3/D4/D6 share one green LED MPN.** Colour differentiation (e.g. amber for the external-active indicator) is a drop-in BOM substitution at the same footprint, and green/amber V<sub>f</sub> differences are absorbed by the series resistors.
- **ST LED (D4) runs at ~273 µA** through R13 + R14 — visibly dim by design constraint (R13 doubles as the ST pull-up). Task-6 deferred minor; unchanged.

---

## Manufacturing / DFM / Testability

No PCB exists, so DFM analysis is limited to what the schematic determines.

- **Footprints:** 120/120 assigned, 21 unique. Two custom footprints in `isolator-lib.pretty` (the ADI RI-20-1 wide-body SOIC and the WE 750313638 transformer). The RI-20-1 dimensions were self-validated in Task 10 (E − 2L = 8.28 mm) but **a human should eyeball the ADI outline drawing before fab** — carried forward from the Task-10 ledger.
- **Creepage:** the T1 manufacturer pattern gives 7.51 mm primary-to-secondary against the plan's original 8 mm target; Task 10 ruled to accept the manufacturer pattern (the part is 5 kV<sub>rms</sub>-rated) and amended the spec to per-component criteria — 8.3 mm at U1, 7.5 mm at T1 plus a routed slot at layout. **The slot is a layout deliverable.**
- **Assembly:** low complexity (35/100), stencil recommended for the two QFNs and the TO-263 tab.
- **Testability:** zero test points — the single largest DFM gap. See [Test Coverage](#test-coverage).
- **`C49`** is the stitching-capacitor provision across the barrier, shipped DNP (verified in Task 9); it was renumbered from a non-numeric reference in Task 10 so that netlist annotation works.

## Component Lifecycle

**Not performed as an automated audit.** `lifecycle_audit.py` requires distributor API access and the analyzer emitted `LC-007` ("Lifecycle audit not run — `--lifecycle` flag not passed") to keep the gap explicit. `DIGIKEY_CLIENT_ID`, `MOUSER_SEARCH_API_KEY` and `ELEMENT14_API_KEY` are all unset in this environment.

**Partial substitute:** the LCSC jlcsearch API needs no credentials and was queried for every MPN. That gives stock and price but **not** lifecycle status (active / NRND / EOL) and **not** operating-temperature data. What it did surface:

- Two thin-stock lines — U13/U14 (311 pcs) and U1 (17 pcs of the reel variant) — flagged in [Component Summary](#component-summary).
- One part with no LCSC presence at all (T1), expected for distributor-only magnetics.
- No part returned zero stock or a discontinued marker.

**Temperature coverage was checked by hand for the ICs**, and one mismatch surfaced: `USB2514B-AEZC` is 0…85 °C while the auto-detected design intent is −10…70 °C (DR-04). The industrial alternative on the same footprint is `USB2514Bi-AEZG`. The auto-detected intent has confidence 0.3 and every field marked `auto`, so this is a question to answer rather than a violation. All other ICs are −40…+85 °C or wider (U1 is −55…+125 °C).

Run `lifecycle_audit.py analysis/2026-07-26_0129/schematic.json --temp-range industrial` once credentials exist to close this properly.

---

## Not Performed / Review Limits

- **PCB layout analysis (`analyze_pcb.py`) — not applicable.** `isolator.kicad_pcb` exists but holds only four M2.5 mounting holes and two keepout zones — no component footprints, no tracks, no vias, no filled copper. Everything that depends on placement, routing, copper, impedance, return paths or stack-up is out of scope for this review.
- **Cross-domain schematic↔PCB analysis (`cross_analysis.py`) — not applicable**, same reason.
- **EMC pre-compliance (`analyze_emc.py`) — not applicable.** The analyzer requires both schematic and PCB JSON. This matters more than usual here: an isolated push-pull DC-DC at 420 kHz across a barrier is exactly the topology EMC analysis is for. **Re-run this review's EMC section once the PCB exists.**
- **Thermal analysis (`analyze_thermal.py`) — not performed**, needs PCB JSON. Hand calculations for U6 and U8 are in `analysis/helpers/verify_limits.py` and DR-05; they are dissipation estimates, not board-level thermal simulation.
- **Gerber verification (`analyze_gerbers.py`) — not applicable.** No fabrication outputs exist.
- **SPICE simulation — skipped.** `which ngspice ltspice xyce` finds nothing on this machine. No simulator, no simulation. `simulation_readiness` reports 93/120 components as likely simulatable (77.5 %), with the 27 gaps being the connectors, transformer and ICs — a SPICE pass would need behavioural models for U1, U5, U6 and U7 before it could say anything useful about the DC-DC or the mux.
- **Lifecycle audit — skipped**, no distributor credentials. Partially substituted by LCSC stock lookups; see [Component Lifecycle](#component-lifecycle).
- **Datasheet sync — skipped**, the sync scripts need API keys. Existing local coverage was sufficient; per-part gaps are listed in [Datasheet Coverage](#datasheet-coverage).
- **NUP4202W1T2G claims are not datasheet-quoted** — the local PDF is an image-only scan with no extractable text.
- **Y1/Y2 crystal specifications come from LCSC parametric data, not manufacturer PDFs.** The tolerance/stability split that the first pass flagged as unconfirmed is now **resolved** from LCSC's full parameter set (±10 ppm initial tolerance, ±30 ppm stability for Y1; ±10/±20 ppm for Y2), and both satisfy ADI's ≤ 50 ppm / ≤ 100 ppm requirement with margin. The residual gap is that this is a distributor database rather than the manufacturer's own PDF, and neither SCTF's nor YXC's datasheet was read directly — worth a glance before a production buy, no longer a pre-fab blocker.
- **Q1/Q2 parametric data is not verified for the specified MPN** — the local PDF is JCET's 2N7002, the specified part is onsemi's `2N7002LT1G`. Pinout is verified; V<sub>GS(th)</sub> and R<sub>DS(on)</sub> are not.
- **The bus-powered ceiling (DR-01) is established analytically, not measured.** There is no vendor conflict — TI's "100 mA" is an application-column characterisation point and Würth's own curves show headroom past 0.65 A; the limit is the host port's 500 mA budget, which gives ≈310 mA on `ISO_5V` and ≈75 mA for downstream ports. The one soft input is the ~90 % end-to-end efficiency, inferred from the shape of TI's Fig 6-22 rather than measured on this hardware: at 80 % the downstream budget falls to roughly 40 mA. Bring-up step 4 characterises the actual margin.

---

## Bring-Up Checklist

Ordered so that each step gates the next. Items marked **[decision]** resolve an open design question.

1. **Power-on, external supply only.** Fit J2 with a known-good 3 A USB-C source. Confirm `EXT_5V` ≈ 5 V, `ISO_5V` ≈ 5 V, `ISO_3V3` = 3.3 V, and that the ST LED (D4) is **on**. Measure `PR1_SENSE` ≥ 1.06 V and `n3A_DET` ≈ 0 V.
2. **Weak-source lockout.** Swap to a Default-USB (non-3 A) source. `n3A_DET` should rise to ~3.3 V, `PR1_SENSE` should collapse to ~0 V, D4 should go **off**, and `ISO_5V` should now track `DCDC_5V`, not `EXT_5V`. This is the direct test of the DR-06 fix — if `ISO_5V` follows the brick instead, the CP2 rewire did not take.
   - **Then watch `ISO_5V` and `n3A_DET` on a slow scope sweep for at least 30 s** with the weak brick and the host both connected. Steady state is expected; periodic switching between sources is the hunting mode described in DR-06 (CP2's pull-up rail sits downstream of the mux). If it hunts, the DC-DC is marginal — fix the load first, and only then consider re-deriving CP2's pull-up from `EXT_5V`.
2b. **Cold start, external only.** Power J2 with the host unplugged. The mux must come up on IN1 with no chatter: `PR1_SENSE` ≈ 1.60 V (its divider is fed from `EXT_5V`, independent of the mux), `n3A_DET` held near 0 V by R9 into a dead `ISO_3V3`, D4 on. Then hot-plug the host and confirm the transition to steady state is monotonic.
3. **[decision] DR-02 — MIC29302 light load.** With the external supply active (so `DCDC_5V` is unloaded), measure `DCDC_5V`. If it exceeds **5.25 V**, populate the bleeder (≈680 Ω to `GND2`, 7.3 mA) or drop R36 to 470 Ω and rescale R3/R4 to 3.01 k / 1.00 k. Leave the bleeder pad DNP if the measurement is clean.
4. **DR-01 — characterize the bus-powered margin.** Bus-powered only (J2 removed). Measure `DCDC_RAW`, `DCDC_5V` and the `ISO_5V` current with the hub enumerated and no downstream devices, and measure the current drawn from `VBUS_HOST` at the same time. Expected: ~235 mA on `ISO_5V`, `DCDC_RAW` around 6 V, and roughly 300 mA at the host. This is a **characterization** step — confirm the ≈310 mA ceiling and the ≈75 mA left for downstream ports, and check the end-to-end efficiency against the ~90 % assumed. It is not a transformer decision: the magnetics have headroom to 0.65 A (Würth's own thermal curve runs to 1.2 A) and the host's 500 mA budget binds first. Then attach one low-power device (a serial adapter or debug probe) and confirm it enumerates and runs.
   - If the host current approaches 500 mA with nothing attached, look at efficiency and at the hub's actual `ISO_3V3` draw before suspecting T1.
5. **[decision] PGOOD strap (carried from Task 7).** Ship `R25` only (pull-down). With both sides powered, measure `PGOOD2`. If it will not reach **> 2.0 V**, the ADuM's PGOOD is open-drain — populate `R26` (pull-up) and remove `R25`. Confirm U4 leaves reset and the PGOOD LED (D3, via Q2) lights.
6. **Clock verification and CL re-derivation.** Scope `XO1` (U1 pin 6) and `HUB_XO` (U4 pin 32) with a low-capacitance probe. Both must be 24 MHz. Measure the frequency error:
   - Y1 target CL is 8 pF against 8 pF loads; the predicted error spans 0 to **+71 ppm** depending on the ADuM's unpublished pin capacitance. If the measured error exceeds ADI's 50 ppm tolerance budget, raise C1/C2 — but stay **below 10 pF** (datasheet constraint).
   - Y2 target CL is 12 pF against 18 pF loads, predicted **−15 ppm**. If it is off, Microchip's formula C1 = 2 × (CL − C0) − CS1 with CXTAL = 6 pF gives the correction directly.
   - Also confirm the ADuM's 0.3 ms crystal start-up requirement is met out of suspend/resume.
7. **ILIM verification.** Per port, sweep an electronic load on `Px_VBUS` and record the trip current. Expect **592–713 mA** (649 mA nominal). Any port outside that band means R27–R30 is not a genuine ±1 % part or the ILIM trace is picking up noise (the datasheet warns the ILIM routing must be short). Then short one port and confirm (a) the corresponding `nOCSx` asserts, (b) the hub reports the fault upstream, and (c) the **other three ports stay up**.
8. **Mux current limit.** Confirm U7 limits at ~3.0 A, not lower — this is the ceiling under which all four ports at 713 mA (2.85 A) must fit.
9. **LDO thermal (DR-05).** With the hub enumerated and all four ports active, thermal-image U8. Expect ~272 mW; if the case runs hotter than ~40 °C above ambient the SOT-23-5 pour is inadequate and a larger package is needed.
10. **Isolation integrity.** Before any of the above: confirm > 100 MΩ between `GND1` and `GND2` with the board unpowered, and confirm no copper other than U1 and T1 bridges the barrier (visual plus continuity).
11. **DR-03 bulk capacitance.** Hot-plug a 500 mA load on each port and scope `ISO_5V` droop. If the dip breaks the 4.75 V floor, fit the additional 47 µF called for in DR-03.
12. **USB tiering sanity.** Enumerate through the isolator and confirm the hub reports 4 ports; remember the isolator consumes ~3 of USB's 5 tiers, so deeply cascaded hubs downstream are expected to fail (accepted spec limitation).
13. **DR-15 — upstream inrush (accepted).** `VBUS_HOST` carries ~20 µF of input capacitance (C3 + C7 + bypass) with no inrush limiting — about 2× the USB 2.0 §7.2.4.1 bus-powered limit of 10 µF/50 µC at hot-plug. Accepted for a prototype-class bench device (real hosts tolerate it); decide accept-vs-soft-start pad at layout.

---

## Final Verdict / Readiness

**Ready for PCB layout. Not yet ready to commit to fab.**

The schematic is electrically sound, internally consistent, and — for every IC in the design — verified against the manufacturer's own documentation with page citations that a gate re-checked against the PDFs. ERC is clean at error severity, the BOM is fully specified with in-stock parts, and the single functional defect found during this review (the TPS2121 CP2 / VCOMP lockout gap) has been fixed with a one-wire change and no new components.

What stands between here and fab:

1. **DR-01 — done on paper, characterize on the bench.** The spec's power budget has been corrected: the bus-powered ceiling is the host's 500 mA, giving ≈310 mA on `ISO_5V` and ≈75 mA for downstream devices. The magnetics are not the constraint and T1 does not change. Bring-up step 4 confirms the numbers; it is not a go/no-go gate.
2. **DR-02, DR-03, DR-05** — three layout-stage additions (a bleeder pad, a bulk cap, a copper pour), all cheap, all with pads that should be placed now rather than retrofitted.
3. **DR-06's conditional hunting risk** — no action now. Watch for it at bring-up step 2; the mitigation (CP2 pull-up re-derived from `EXT_5V`) is only warranted if the DC-DC proves marginal under a weak external brick.
4. **Test points** — add them during layout; the bring-up checklist above needs ten nets probeable.
5. **One verification gap to close on paper** — a human check of the custom RI-20-1 footprint against ADI's outline drawing. (The crystal tolerance/stability question the first pass raised is now resolved: ±10 ppm initial tolerance on both parts.)
6. **Re-run this review's EMC, thermal, PCB and gerber sections once the board is laid out.** An isolated 420 kHz push-pull converter crossing a safety barrier is precisely the case where schematic-only review runs out of road.
