alxgmpr/adum4165-isolator/docs/superpowers/reviews/2026-07-26-decoupling-audit.md

# Decoupling & Required-Externals Audit vs. Datasheet Typical-Application Circuits

> **Repo note (2026-07-30):** this document describes the **archived 4-port
> design**. That project no longer lives at the repo root — it was archived to
> branch `4port-archive` when the repository collapsed to the single-port
> isolator. Every bare `isolator.kicad_sch` / `isolator.kicad_pcb` /
> `isolator.kicad_pro` path below refers to the **archived** files as they stood
> on that branch, **not** to the files of those names at the root today, which
> are the single-port isolator. Retrieve them with
> `git show 4port-archive:isolator.kicad_sch`.

**Date:** 2026-07-26
**Scope:** every IC in `isolator.kicad_sch` / `isolator.kicad_pcb`, checked against the manufacturer's
"typical application", "application information", "layout guidelines" and "power supply recommendations"
sections. Read-only audit — no project file was modified.

**Inputs**

| Source | Detail |
|---|---|
| Datasheet PDFs | `datasheets/*.pdf`, text-extracted with `pdftotext -layout` |
| AP2112 | **No local PDF.** Retrieved `cdn-shop.adafruit.com/product-files/2471/AP2112.pdf` (BCD Semiconductor Rev 2.0, Mar 2013) — diodes.com returned HTTP 403, LCSC/Mouser mirrors timed out |
| USBLC6-2 | **No local PDF.** Retrieved via `mm.digikey.com/.../USBLC6-2SC6 SOT-23-6L.PDF` (SLKOR second-source, pinout is an image) **and** `kontest.ru` mirror of **ST USBLC6-2 Rev. 2, June 2005** — the ST one has the pinout and the VBUS-cap recommendation in extractable text |
| Netlist | `analyze_schematic.py` → pin-to-net map for all 121 components |
| Placement | Pad-level global coordinates parsed directly from `isolator.kicad_pcb` (125 footprints) |
| Prior record | `docs/superpowers/reviews/2026-07-26-schematic-review.md` (claims spot-verified, see §6) |

**Caveat on placement findings.** The PCB is mid-layout (`HEAD` = "power planes… routing session").
Placement distances below are pad-centre to pad-centre in the *current* board file and are reported so
they can be fixed before routing hardens, not as final defects.

**Known break excluded from scoring:** `U7.OV2` (pin 4) is on an unnamed net — the GUI-buffer wire loss the
user is already fixing. It is scored UNVERIFIABLE, not as a deviation.

---

## 1. Verdict summary

| Verdict | Count |
|---|---|
| COMPLIANT | 42 |
| DEVIATION-JUSTIFIED | 3 |
| DEVIATION-FIX-NEEDED | 9 |
| UNVERIFIABLE | 7 |

Of the 9 fix-needed items, **3 are schematic-level** (U6 output-cap ESR/type, U6 minimum load current,
downstream bulk < USB's 120 µF/hub) and **6 are PCB-placement-level** on the isolated 5 V rail and the
two comparators.

**Headline:** the *schematic* is very close to datasheet-clean. Every mandated external exists with a
correct value. The real problem is that on the isolated side, **the `ISO_5V` decoupling caps have all been
placed on the right-hand third of the board** — `U1.VBUS2`, `U3` (ESD) and `U8` (LDO) sit 37–44 mm from the
nearest cap on their own rail, and the ADuM4165 explicitly caps that distance at **10 mm**.

---

## 2. Per-IC audit tables

### U1 — ADuM4165BRIZ (`adum4165-4166.pdf`, Rev. B)

| Component | Datasheet says | Schematic / PCB has | Verdict |
|---|---|---|---|
| VDD1 bypass | Table 12 p.11 + App Info p.22: **exactly 0.1 µF**, "required capacitor value of 0.1 μF for correct operation of the internal 3.3 V regulator"; ">0.1 μF can disrupt start-up sequencing when using the LDO regulator, while <0.1 μF can result in too much voltage ripple" | C5 `100n` X7R 0603, **3.5 mm** from pin 3 | COMPLIANT |
| VDD2 bypass | same (Table 12 p.11, pin 18) | C36 `0.1u` X7R 0603, **8.2 mm** from pin 18 | COMPLIANT |
| VBUS1 bypass | Table 12 p.11 pin 1: "bypass to GND1 using a 0.1 μF capacitor" | C50 `100n`, **2.9 mm** from pin 1 (C4/C6 also on `VBUS_HOST` but 30 mm away) | COMPLIANT |
| VBUS2 bypass | Table 12 p.11 pin 20: "bypass to GND2 using a 0.1 μF capacitor" | Net-level: `ISO_5V` carries 6 × 0.1 µF. **PCB: nearest cap on `ISO_5V` to pin 20 is C19 at 43.9 mm** | **DEVIATION-FIX-NEEDED** (PCB) |
| Bypass lead length | PCB Layout p.24: "The total lead length between both ends of the capacitor and the power supply pin must not exceed 10 mm", "low ESR type" | C5 3.5 / C50 2.9 / C36 8.2 mm ✔; VBUS2 43.9 mm ✘ | see above |
| Bypass ground return | Table 12 p.11: pins **4, 7** (GND1) and **15, 16, 17** (GND2) "are not suitable for connection of bypass capacitance". Suitable: pins 2, 10 (GND1), 11, 19 (GND2) | Schematic collapses all to `GND1`/`GND2`. PCB: C36 sits 7.3 mm from pin 19 (suitable) — geometry allows the correct return, but the board is not routed yet | UNVERIFIABLE (routing action item) |
| Crystal | p.22: ≤50 ppm tolerance, ≤100 ppm stability, start-up <0.3 ms, "a typical crystal capacitance of 10 pF and capacitive loads <10 pF"; refers to eval-guide BOM. **Eval BOM (`eval-adum4165-4166-ug-2027.pdf` Table 4, line 273): 24 MHz ±50 ppm, 8 pF, 50 Ω 4-SMD (IQD LFXTAL056140REEL) with C1/C2 = 8 pF 0402** | Y1 `SX3B24.000F0810F30` (CL 8 pF, ±10 ppm / ±30 ppm, ESR 30 Ω); C1/C2 = 8 pF C0G at **2.3 / 2.1 mm** from XI1/XO1; Y1 at 4.5 mm | COMPLIANT — an exact copy of ADI's own validated point. (CL_eff ≈ 7 pF with stray, i.e. −12.5 % vs CL, a pull of at most +71 ppm; the eval board has the identical mismatch.) |
| External D± pull-ups | p.22: "External pull-up resistors are not required because these resistors are integrated within the isolator" | none fitted | COMPLIANT |
| Barrier stitching cap | p.22: "important to minimize board capacitive coupling across the isolation barrier" — no component mandated | C49 1 nF 2 kV 2220, **DNP** | COMPLIANT (optional) |

### U4 — USB2514B-AEZC (`USB2514B-AEZC.pdf`, DS00001692E)

> **This datasheet has no Layout section and no decoupling/bypass section at all.** A grep for
> `Layout`, `decoupling`, `bypass capacitor`, `bulk capacit`, `ferrite bead`, `power supply recommend`
> across the whole document returns **zero hits**. Everything below marked *convention* is engineering
> practice / Microchip EVB practice, **not** a datasheet mandate.

| Component | Datasheet says | Schematic / PCB has | Verdict |
|---|---|---|---|
| Per-VDD33/VDDA33 0.1 µF | **silent** (convention: one per supply pin) | 6 supply pins (5, 10, 15, 23, 29, 36) all on `ISO_3V3`; rail carries **9 × 0.1 µF** (C16, C17, C23–C29) + C22 1 µF. PCB: nearest 0.1 µF per pin = 6.6 / 7.7 / 8.0 / 9.0 / 12.1 / 12.9 mm | COMPLIANT-BY-CONVENTION (placement marginal on pins 29/36) |
| Bulk on 3.3 V | **silent** | Only C22 `1u` (which is really the AP2112 COUT). Total `ISO_3V3` = **1.9 µF nominal** | DEVIATION-JUSTIFIED (no datasheet basis) — but 1.9 µF for a 155 mA hi-speed hub is thin; the prior review's open action for a 4.7–10 µF bulk near U4 still stands |
| CRFILT | p.14 Table 3-2: "this pin can have **up to a 0.1 µF** low-ESR capacitor to VSS, or be left unconnected" | C30 `0.1u` (at the ceiling); **11.5 mm** from pin 14 | COMPLIANT (value); placement marginal |
| PLLFILT | p.14 Table 3-2: identical wording | C31 `0.1u`; **15.3 mm** from pin 34 | COMPLIANT (value); placement marginal |
| RBIAS | p.13 Table 3-2: "a **12.0 kΩ (+/- 1%)** resistor is attached from ground to this pin" | R15 `12.0k`, `RC0603FR-0712KL` = ±1 % ✔. PCB: **27.9 mm** from pin 35 | COMPLIANT (value) / **DEVIATION-FIX-NEEDED** (placement) |
| XTAL loading | p.44 Fig 7-2: `C1 = 2 × (CL − C0) − CS1`, C0 → 0; Note 7-2: "Each of these capacitance values is **typically around 18 pF**". Crystal spec p.44: parallel resonant, fundamental, 24 MHz ±350 ppm | Y2 `X322524MOB4SI` CL = 12 pF, ±10 ppm / ±20 ppm; C32/C33 = **18 pF** C0G → 2×12 − CS ≈ 18 pF with CS ≈ 6 pF | COMPLIANT (textbook match). PCB: C32/C33 are 12.3–12.8 mm from XTALIN/XTALOUT — long for a 24 MHz loop |
| RESET_N network | §5.5.1 p.36: "assertion of RESET_N for a **minimum of 1 µs** after all power supplies are within operating range". No RC mandated | R16 10 k pull-up + C34 1 µF → 10 ms; D5 1N4148WS reverse-discharge to `ISO_3V3` | COMPLIANT (RC is convention, 10 000× the minimum) |
| VBUS_DET | p.12: "For self-powered applications with a permanently attached host, this pin must be connected to a **dedicated host control output**, or connected to the 3.3 V domain that powers the host" | `PGOOD2` ← U1 pin 14 PGOOD (a VDD2-referenced 3.3 V output) + R25/R26 100 k bias pair | COMPLIANT — PGOOD is precisely a "host is alive and clocked" control output |
| NON_REM straps | p.14 Table 3-3: 47–100 kΩ for I/O-type strap pins | R23/R24 = 47 k | COMPLIANT |
| CFG_SEL straps | p.14 Table 3-3 / Fig 3-4 | R21/R22 = 10 k to GND2 → CFG_SEL[1:0] = 00 | COMPLIANT |
| TEST pin | p.14: "treat as a no connect pin or connect to ground. No trace or signal should be routed or attached to this pin" | pin 11 unconnected | COMPLIANT |
| OCS_N pull-ups | **silent** (FAULT is open-drain, so needed) | R17–R20 = 100 k to `ISO_3V3` | COMPLIANT-BY-CONVENTION |

### U5 — SN6505BDBVR (`SN6505BDBVR.pdf`, SLLSEP9I)

| Component | Datasheet says | Schematic / PCB has | Verdict |
|---|---|---|---|
| VCC bypass | Table 5-1 p.3: "It should be bypassed with a **4.7 μF or greater, low ESR capacitor**". §11.1 p.34: 1–10 µF X5R/X7R, ≥10 V, closest to VIN/GND pins | C7 `10u` 0805 at **5.9 mm**, C6 `0.1u` at **7.2 mm** from pin 2 | COMPLIANT |
| HF bypass | §9.2.2.4 p.25: "the device requires a bypass capacitor in the range of **10 nF to 100 nF**" | C6 `0.1u` | COMPLIANT |
| Primary centre-tap bulk | §9.2.2.4 p.25 / §11.1 p.34: "**1 μF to 10 μF**", ≥16 V, X5R/X7R, close to the centre-tap | Shared `VBUS_HOST`: C6/C7 at 7.7/8.1 mm from T1 pin 2; C3 `10u` + C4 `0.1u` at the J1 entrance | COMPLIANT |
| Snubbers on D1/D2 | **Not recommended anywhere** — grep for "snubber" across the whole datasheet: 0 hits. §11.1 only asks for short D1/D2-to-primary traces | none fitted | COMPLIANT (no deviation — the absence is correct) |
| EN | Table 5-1 p.3: "If unused this pin should be tied **directly to VCC**" | pin 5 → `VBUS_HOST` (= VCC net) | COMPLIANT |
| CLK | Table 5-1 p.3: "Internally it is pulled down to GND. If valid clock is not detected on this pin, the device shifts automatically to internal clock" | pin 6 → `GND1` → internal oscillator + spread-spectrum active | COMPLIANT |
| Rectifier diodes | §11.1 p.34: "should be Schottky diodes with low forward voltage" | D1/D2 `SS34` (40 V 3 A Schottky, SMA) | COMPLIANT (conservative vs TI's MBR0520L) |
| Rectifier-output bulk | §9.2.2.4 p.25 / §11.1 p.34: "**1 μF to 10 μF**", ≥16 V, X5R/X7R | `DCDC_RAW`: C8 `47u` 1210 + C9 `0.1u`, at 22.0 / 24.9 mm from U6 VIN | **DEVIATION-JUSTIFIED** — 4.7× the recommended ceiling, but §9.3 states soft-start exists specifically to prevent "high inrush current from VCC while charging **large secondary side decoupling capacitors**", and the downstream load is a 1.5 A-class LDO, not TI's 100 mA example. Value is fine; **placement is not** (see fix list) |

### U6 — MIC29302WU (`MIC29302WU.pdf`, DS20005685A — MIC2915X/30X/50X/75X family)

| Component | Datasheet says | Schematic / PCB has | Verdict |
|---|---|---|---|
| **Output cap (stability)** | §4.2 p.25, Table 4-1: MIC2930x minimum **10 µF at full load**. Then verbatim: "This capacitor **need not be an expensive low ESR type**: aluminum electrolytics are adequate. In fact, **extremely low ESR capacitors may contribute to instability**. **Tantalum capacitors are recommended** for systems where fast load transient response is important." Front-page typical app (p.3) and Fig 4-2 (p.26) both show a **tantalum** | C10 `47u` **1210 MLCC** (`TMK325ABJ476MM-P`, X5R-class, ESR of order 2–5 mΩ) + C11 `0.1u` | **DEVIATION-FIX-NEEDED** — this is the one true LDO-stability deviation in the design. A PNP-pass LDO of this family wants ESR in a window; a bare 47 µF MLCC sits far below it |
| Input cap | Front page p.3 typical app: **10 µF tantalum**. §4.2 p.25: "Where the regulator is powered from a source with high AC impedance, a **0.1 µF** capacitor connected between Input and GND is recommended. This capacitor should have good characteristics to above 250 kHz" | C8 `47u` + C9 `0.1u` on `DCDC_RAW` (input is a 400 kHz push-pull rectifier — definitely "high AC impedance") | COMPLIANT (value); placement 22.0 / 24.9 mm — too far |
| ADJ divider | Eq. 4-6 §4.4 p.25: `R1 = R2 × (VOUT/1.240 − 1)`. Adjust-pin bias current 40 nA typ / **120 nA max** (Elec. Char. p.9) | R3 30.1 k / R4 10 k → **1.240 × 4.01 = 4.972 V** ✔. Divider current 124 µA = **1030 × IADJ(max)**; worst-case bias error 3.6 mV | COMPLIANT |
| **Minimum load current** | §4.3 p.25, Table 4-2: MIC2930x = **7 mA**. "If the output current is too small, leakage currents dominate and the output voltage rises." §4.4 adds: "Applications with widely varying load currents may scale the resistors to draw the minimum load current required" | `DCDC_5V` permanent load = R36 1 k + green LED D6 ≈ **2.9 mA**, plus the 124 µA divider ≈ **3.0 mA total**. When `EXT_5V` wins the mux, U7's IN2 draws only ~65 µA quiescent, so 3.0 mA is the whole load | **DEVIATION-FIX-NEEDED** (2.4× under the specified minimum) |
| EN | MIC29xx2 has an enable input | pin 1 → `DCDC_RAW` = VIN → always enabled | COMPLIANT |
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
