alxgmpr/adum4165-isolator/docs/superpowers/reviews/2026-07-28-v1-part-selection.md

# Part Selection: 5.0 V LDO, VBUS TVS, Barrier Stitching Capacitor (Task 2)

> **Repo note (2026-07-30):** the design this document calls "v1" is now simply
> **the isolator** — the single, shipping project at the repo root
> (`isolator.kicad_sch` / `.kicad_pcb` / `.kicad_pro`). It is no longer a
> sub-project under `v1/`, and paths below have been updated accordingly. What
> this document calls "v2" is the **archived 4-port design**, now on branch
> `4port-archive`. Past-tense passages comparing the two are kept as written —
> they record why decisions were made and only make sense in that tense.

**Date:** 2026-07-28 (originally); **updated 2026-07-28 in fix round 1** — the LDO and CY1
sections were superseded after review (Critical 1 and Critical 2); the VBUS TVS section (D5, D6)
was reviewed and approved unchanged. Read the "Fix round 1" notes inline in each section for what
changed and why.
**Scope:** select and datasheet-verify three parts the isolator needs that the 4-port design does not carry (or carries
incorrectly): the ISO_5V LDO, the VBUS ESD/TVS diodes (D5, D6), and the barrier stitching
capacitor CY1. No schematic wiring performed in this task — selection, symbol/footprint
resolution, and pin-table extraction only.
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
