alxgmpr/adum4165-isolator/docs/revc/renders/land-pattern-review.png

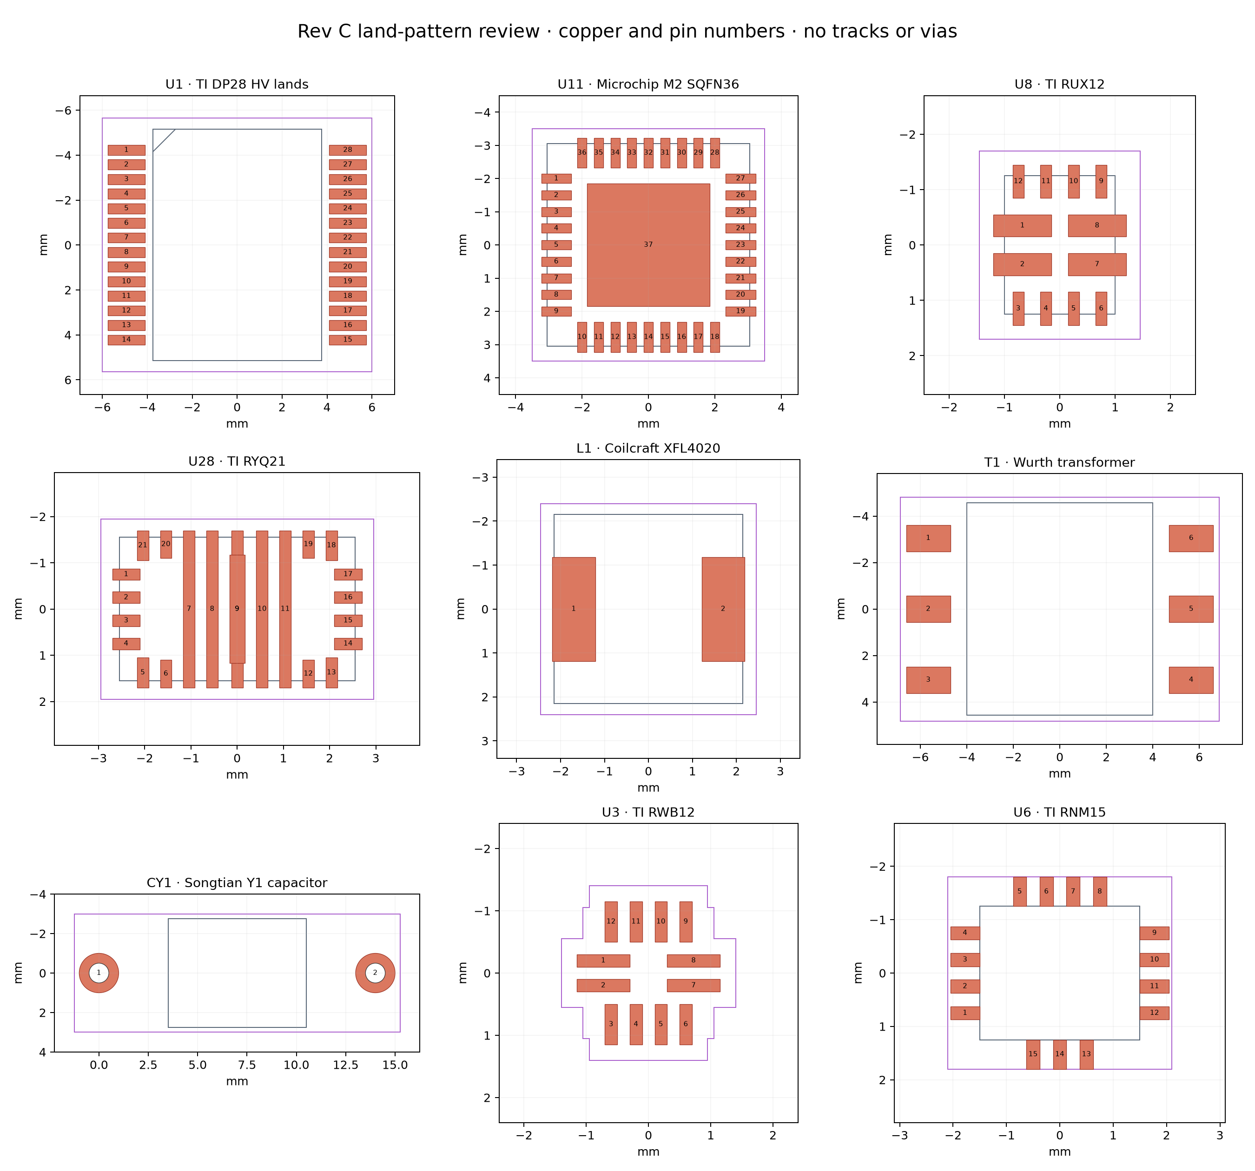
docs/revc/renders/land-pattern-review.png
