alxgmpr/adum4165-isolator/docs/revc/renders/pcb-3d-bottom.png

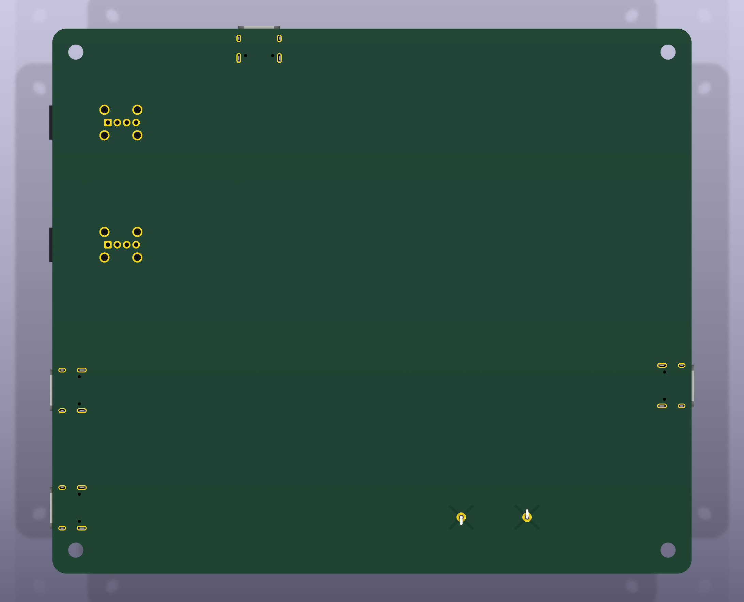
docs/revc/renders/pcb-3d-bottom.png
