alxgmpr/adum4165-isolator/docs/revc/renders/pcb-3d-top.png

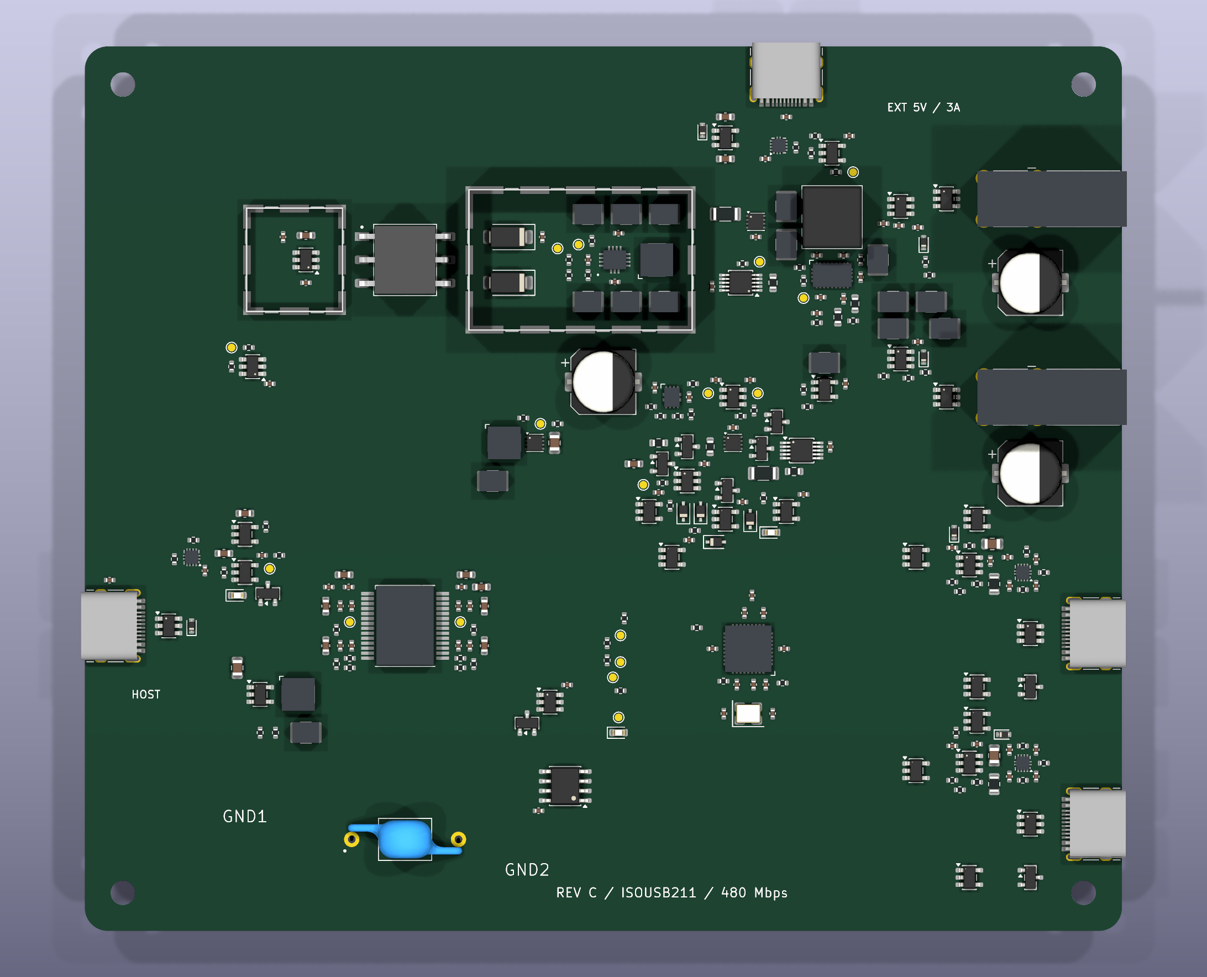
docs/revc/renders/pcb-3d-top.png
