alxgmpr/adum4165-isolator/docs/revc/renders/placement-bottom.png

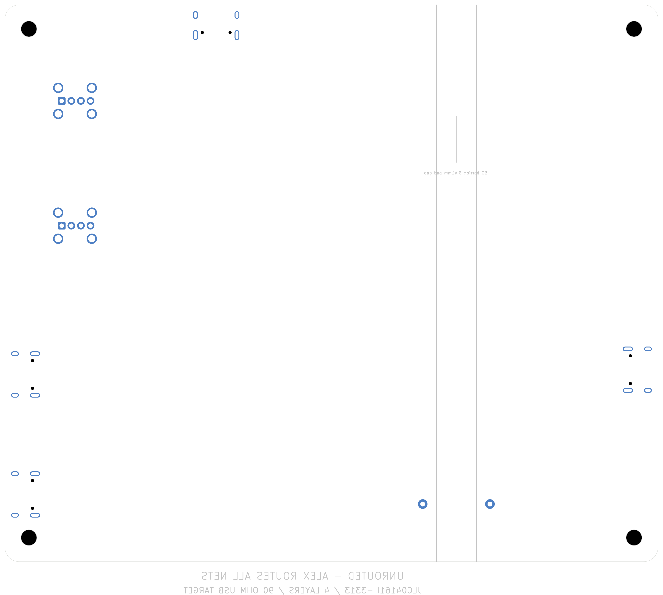
docs/revc/renders/placement-bottom.png
