alxgmpr/adum4165-isolator/docs/revc/renders/placement-courtyards.png

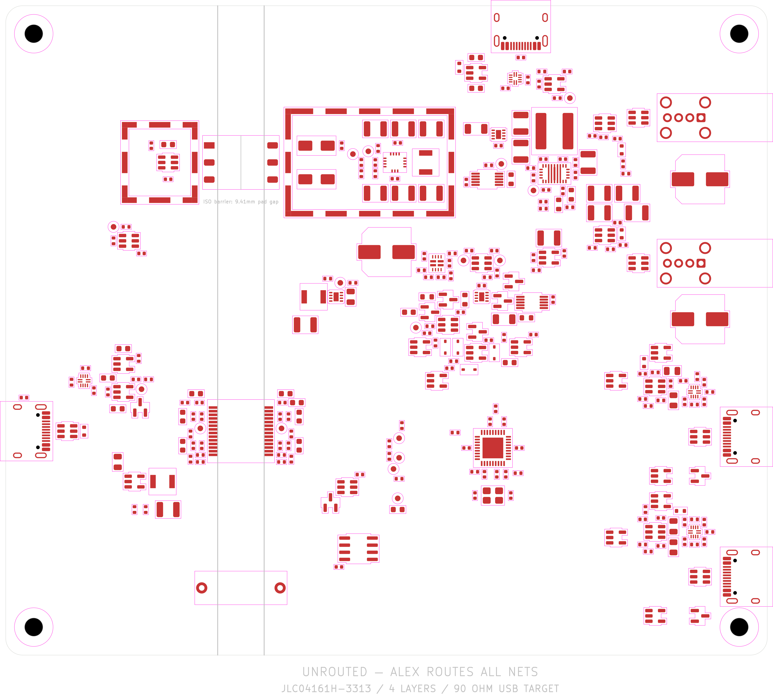
docs/revc/renders/placement-courtyards.png
