alxgmpr/adum4165-isolator/docs/revc/renders/schematic/hub-BUS START.png

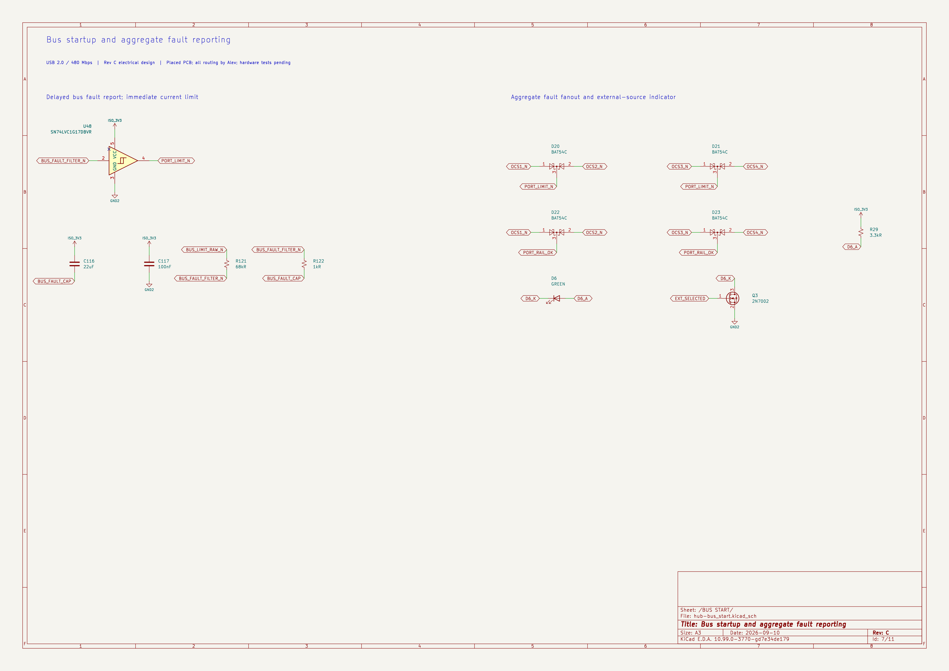
docs/revc/renders/schematic/hub-BUS START.png
