alxgmpr/adum4165-isolator/docs/revc/renders/schematic/hub-CONVERTER.png

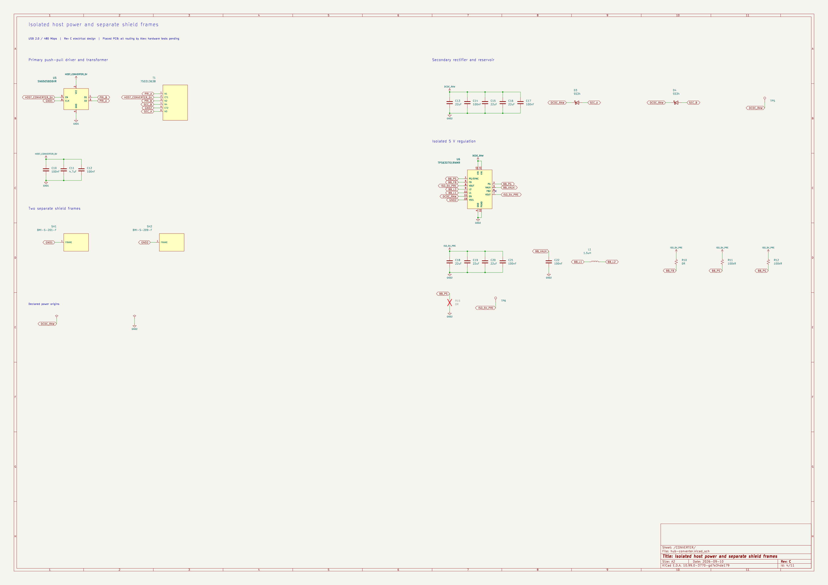
docs/revc/renders/schematic/hub-CONVERTER.png
