alxgmpr/adum4165-isolator/docs/revc/renders/schematic/hub-DISTRIBUTION.png

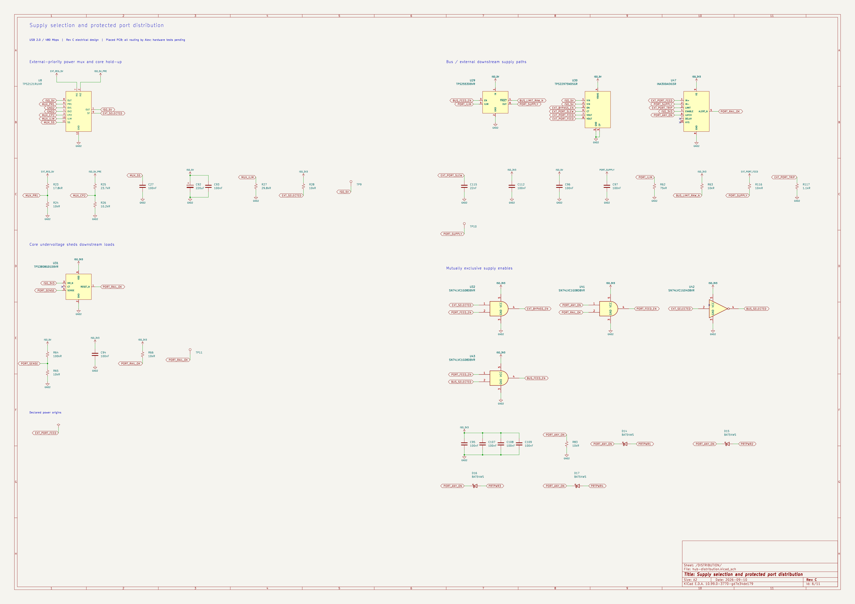
docs/revc/renders/schematic/hub-DISTRIBUTION.png
