alxgmpr/adum4165-isolator/docs/revc/renders/schematic/hub-EXTERNAL.png

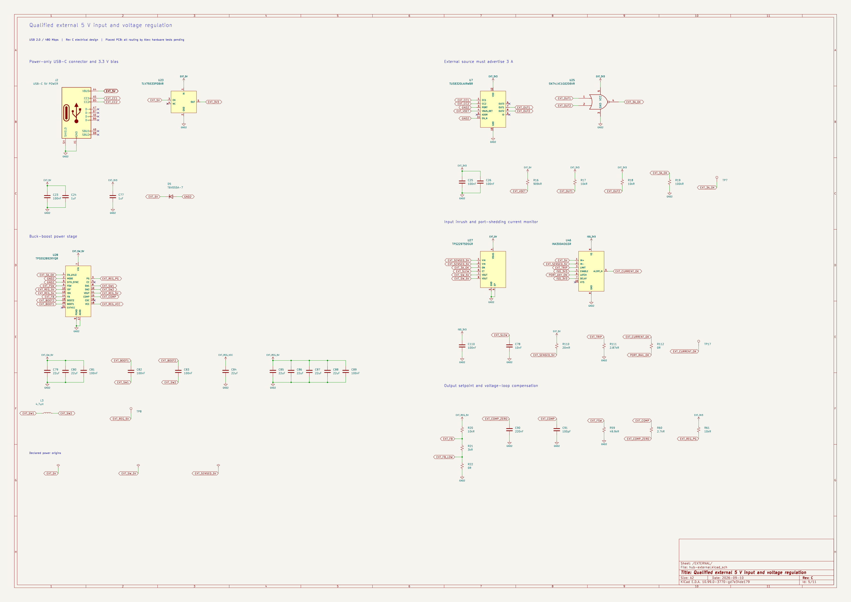
docs/revc/renders/schematic/hub-EXTERNAL.png
