alxgmpr/adum4165-isolator/docs/revc/renders/schematic/hub-HOST.png

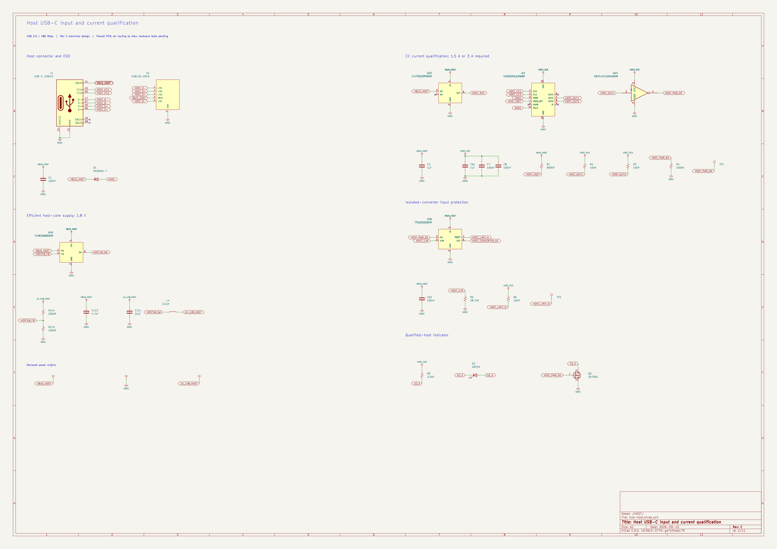
docs/revc/renders/schematic/hub-HOST.png
