alxgmpr/adum4165-isolator/docs/revc/renders/schematic/hub-HUB.png

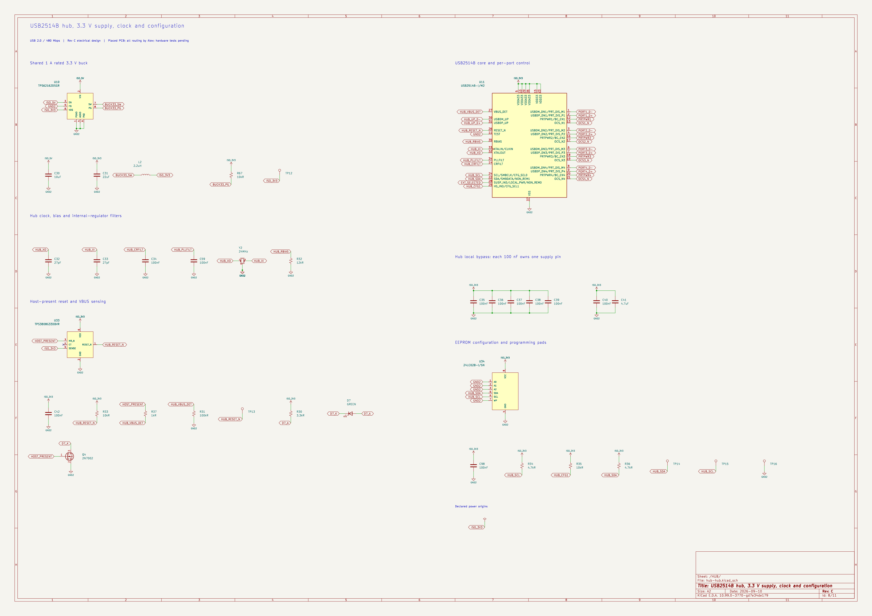
docs/revc/renders/schematic/hub-HUB.png
