alxgmpr/adum4165-isolator/docs/revc/renders/schematic/hub-ISOLATION.png

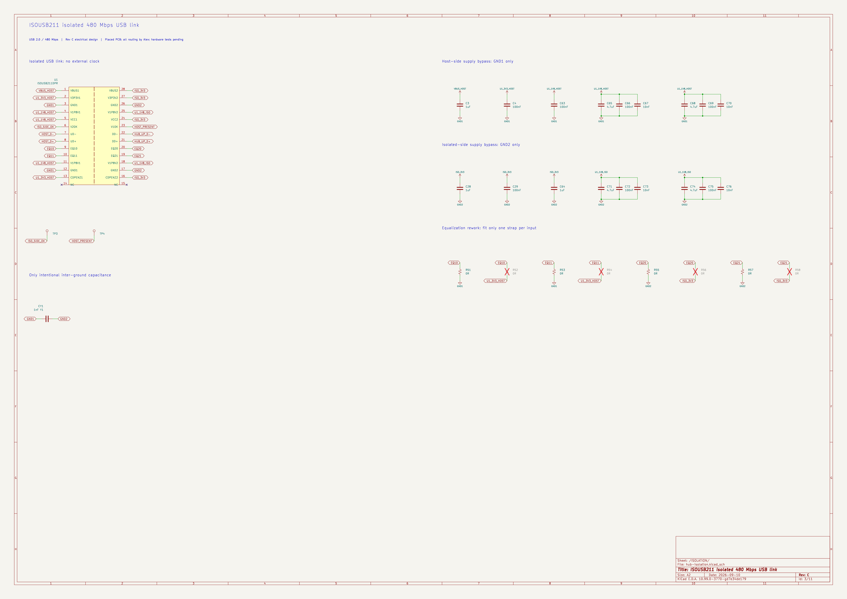
docs/revc/renders/schematic/hub-ISOLATION.png
