alxgmpr/adum4165-isolator/docs/revc/renders/schematic/hub-PORT C3.png

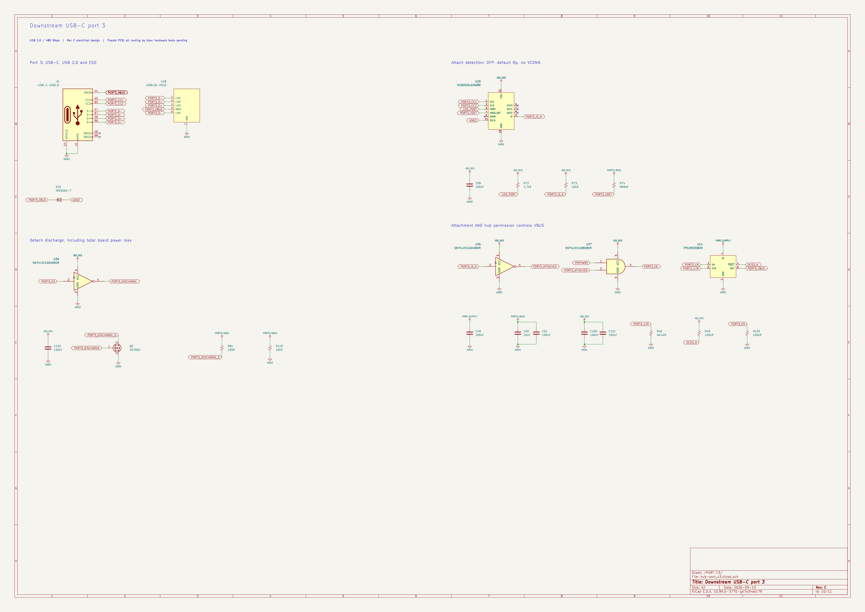
docs/revc/renders/schematic/hub-PORT C3.png
