alxgmpr/adum4165-isolator/docs/revc/renders/schematic/hub-PORTS A.png

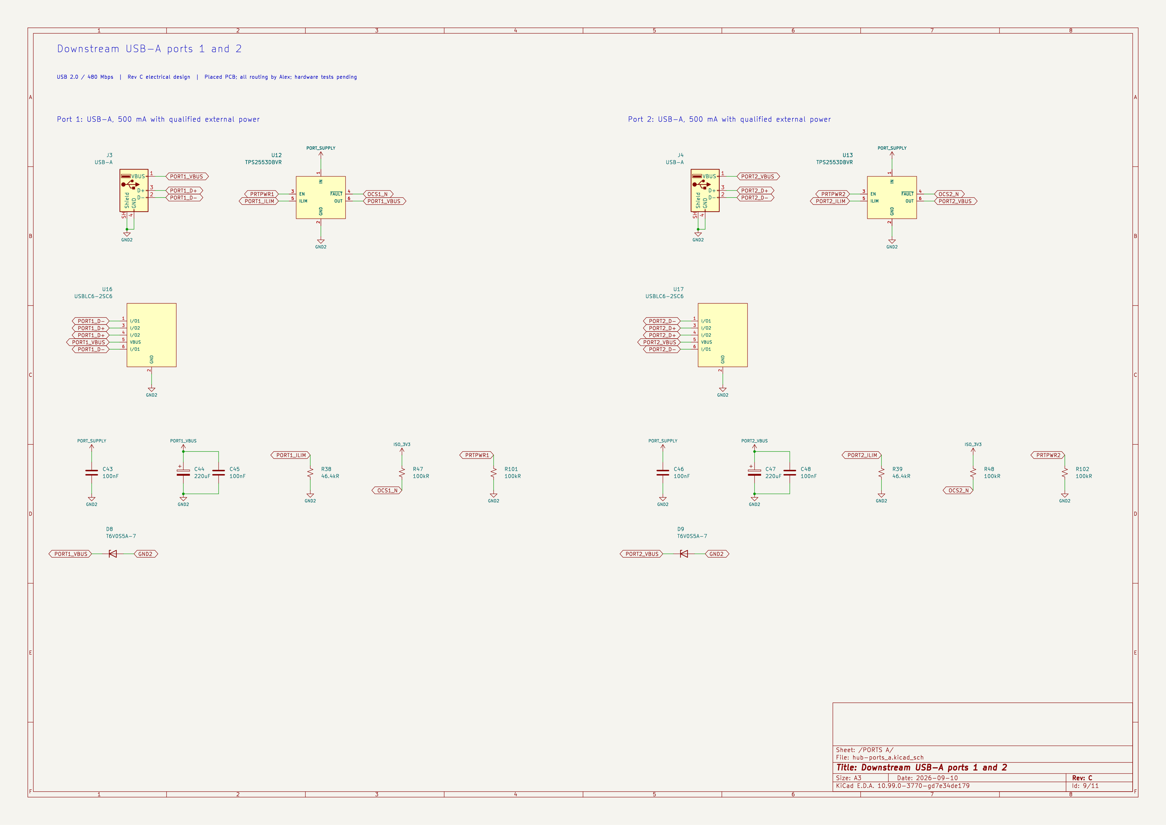
docs/revc/renders/schematic/hub-PORTS A.png
