alxgmpr/adum4165-isolator/docs/revc/renders/schematic/hub.png

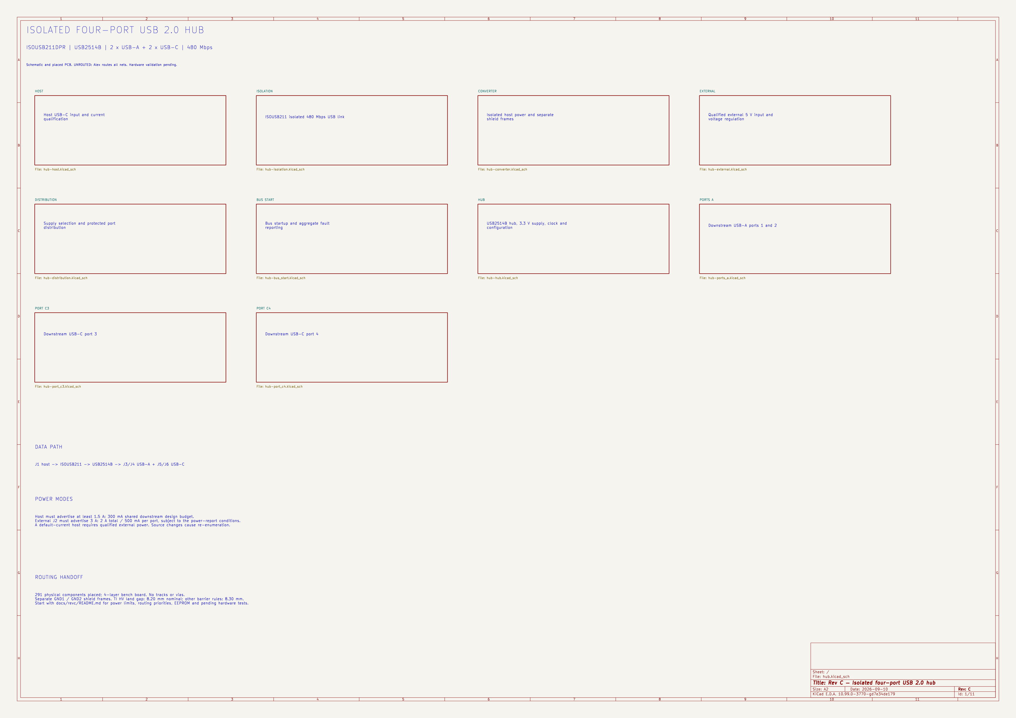
docs/revc/renders/schematic/hub.png
