alxgmpr/adum4165-isolator/docs/revc/reports/pcb-pad-net-map.csv

Reference | Pad | Net | X mm | Y mm | Width mm | Height mm | Angle deg
J1 | A1 | GND1 | 7.195 | 72.75 | 0.6 | 1.45 | 270
J1 | A4 | VBUS_HOST | 7.195 | 73.55 | 0.6 | 1.45 | 270
J1 | A5 | HOST_CC1 | 7.195 | 74.75 | 0.3 | 1.45 | 270
J1 | A6 | HOST_D+ | 7.195 | 75.75 | 0.3 | 1.45 | 270
J1 | A7 | HOST_D- | 7.195 | 76.25 | 0.3 | 1.45 | 270
J1 | A8 | unconnected-(J1-SBU1-PadA8) | 7.195 | 77.25 | 0.3 | 1.45 | 270
J1 | A9 | VBUS_HOST | 7.195 | 78.45 | 0.6 | 1.45 | 270
J1 | A12 | GND1 | 7.195 | 79.25 | 0.6 | 1.45 | 270
J1 | B1 | GND1 | 7.195 | 79.25 | 0.6 | 1.45 | 270
J1 | B4 | VBUS_HOST | 7.195 | 78.45 | 0.6 | 1.45 | 270
J1 | B5 | HOST_CC2 | 7.195 | 77.75 | 0.3 | 1.45 | 270
J1 | B6 | HOST_D+ | 7.195 | 76.75 | 0.3 | 1.45 | 270
J1 | B7 | HOST_D- | 7.195 | 75.25 | 0.3 | 1.45 | 270
J1 | B8 | unconnected-(J1-SBU2-PadB8) | 7.195 | 74.25 | 0.3 | 1.45 | 270
J1 | B9 | VBUS_HOST | 7.195 | 73.55 | 0.6 | 1.45 | 270
J1 | B12 | GND1 | 7.195 | 72.75 | 0.6 | 1.45 | 270
J1 | SH | GND1 | 6.28 | 71.68 | 1 | 2.1 | 270
J1 | SH | GND1 | 2.1 | 71.68 | 1 | 1.6 | 270
J1 | SH | GND1 | 6.28 | 80.32 | 1 | 2.1 | 270
J1 | SH | GND1 | 2.1 | 80.32 | 1 | 1.6 | 270
J2 | A1 | GND2 | 95.25 | 7.195 | 0.6 | 1.45 | 180
J2 | A4 | EXT_5V | 94.45 | 7.195 | 0.6 | 1.45 | 180
J2 | A5 | EXT_CC1 | 93.25 | 7.195 | 0.3 | 1.45 | 180
J2 | A6 | unconnected-(J2-D+-PadA6) | 92.25 | 7.195 | 0.3 | 1.45 | 180
J2 | A7 | unconnected-(J2-D--PadA7) | 91.75 | 7.195 | 0.3 | 1.45 | 180
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
R121 | 1 | BUS_LIMIT_RAW_N | 94.25 | 45.51 | 0.54 | 0.64 | 90
R121 | 2 | BUS_FAULT_FILTER_N | 94.25 | 44.49 | 0.54 | 0.64 | 90
R122 | 1 | BUS_FAULT_FILTER_N | 94.24 | 47.25 | 0.54 | 0.64 | 0
R122 | 2 | BUS_FAULT_CAP | 95.26 | 47.25 | 0.54 | 0.64 | 0
