alxgmpr/adum4165-isolator/bom/orders/mouser-5boards.csv

Mouser Part Number | Quantity | Customer Reference
584-ADUM4165BRIZ | 5 | U1
710-750313638 | 5 | T1
81-DE1E3A102MJ4BH01F | 5 | CY1
