alxgmpr/adum4165-isolator/docs/revc/renders/schematic.pdf

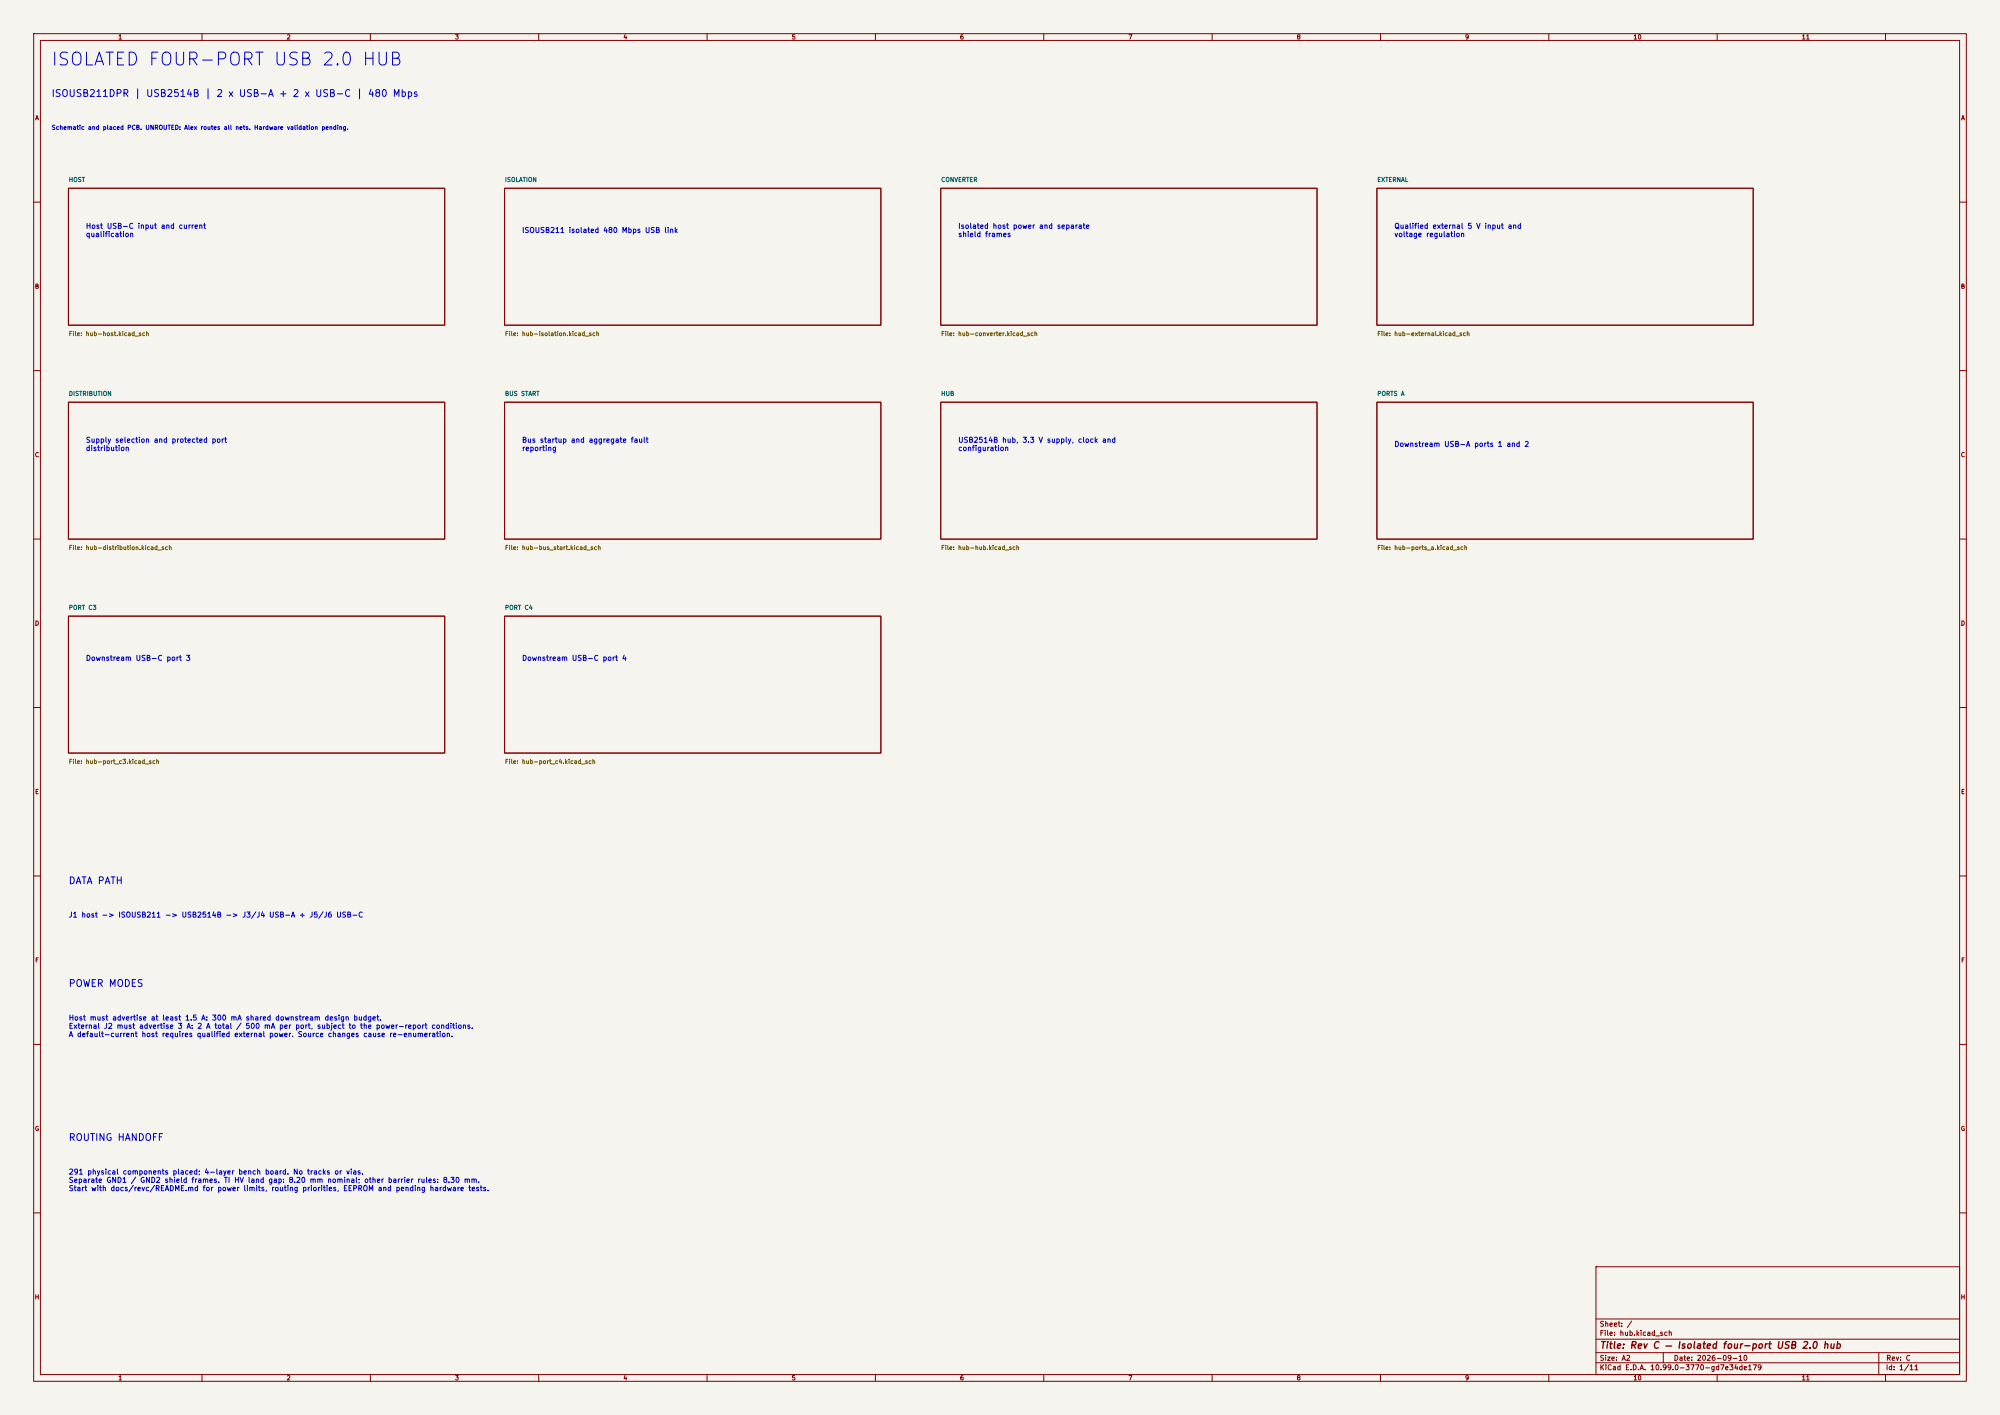
[picture p17: page 1]

HOST File: hub-host.kicad_sch DISTRIBUTION

ISOLATED FOUR-PORT USB 2.0 HUB

Schematic and placed PCB. UNROUTED: Alex routes all nets. Hardware validation pending.

ISOLATION
File: hub-isolation.kicad_sch PORT C4

EXTERNAL File: hub-external.kicad_sch HUB

Host USB-C input and current
qualification

Isolated host power and separate
shield frames

Qualified external 5 V input and
voltage regulation

ISOUSB211 isolated 480 Mbps USB link

File: hub-converter.kicad_sch BUS START File: hub-bus_start.kicad_sch

Supply selection and protected port
distribution

Bus startup and aggregate fault
reporting

USB2514B hub, 3.3 V supply, clock and
configuration

Downstream USB-A ports 1 and 2

File: hub-hub.kicad_sch PORT C3

Host must advertise at least 1.5 A: 300 mA shared downstream design budget.
External J2 must advertise 3 A: 2 A total / 500 mA per port, subject to the power-report conditions.
A default-current host requires qualified external power. Source changes cause re-enumeration.

291 physical components placed; 4-layer bench board. No tracks or vias.
Separate GND1 / GND2 shield frames. TI HV land gap: 8.20 mm nominal; other barrier rules: 8.30 mm. Start with docs/revc/README.md for power limits, routing priorities, EEPROM and pending hardware tests.

Sheet: /
File: hub.kicad_sch
Title: Rev C — Isolated four-port USB 2.0 hub

Size: A2 | Rev: C
KiCad E.D.A. 10.99.0-3770-gd7e34de179 | Id: 1/11

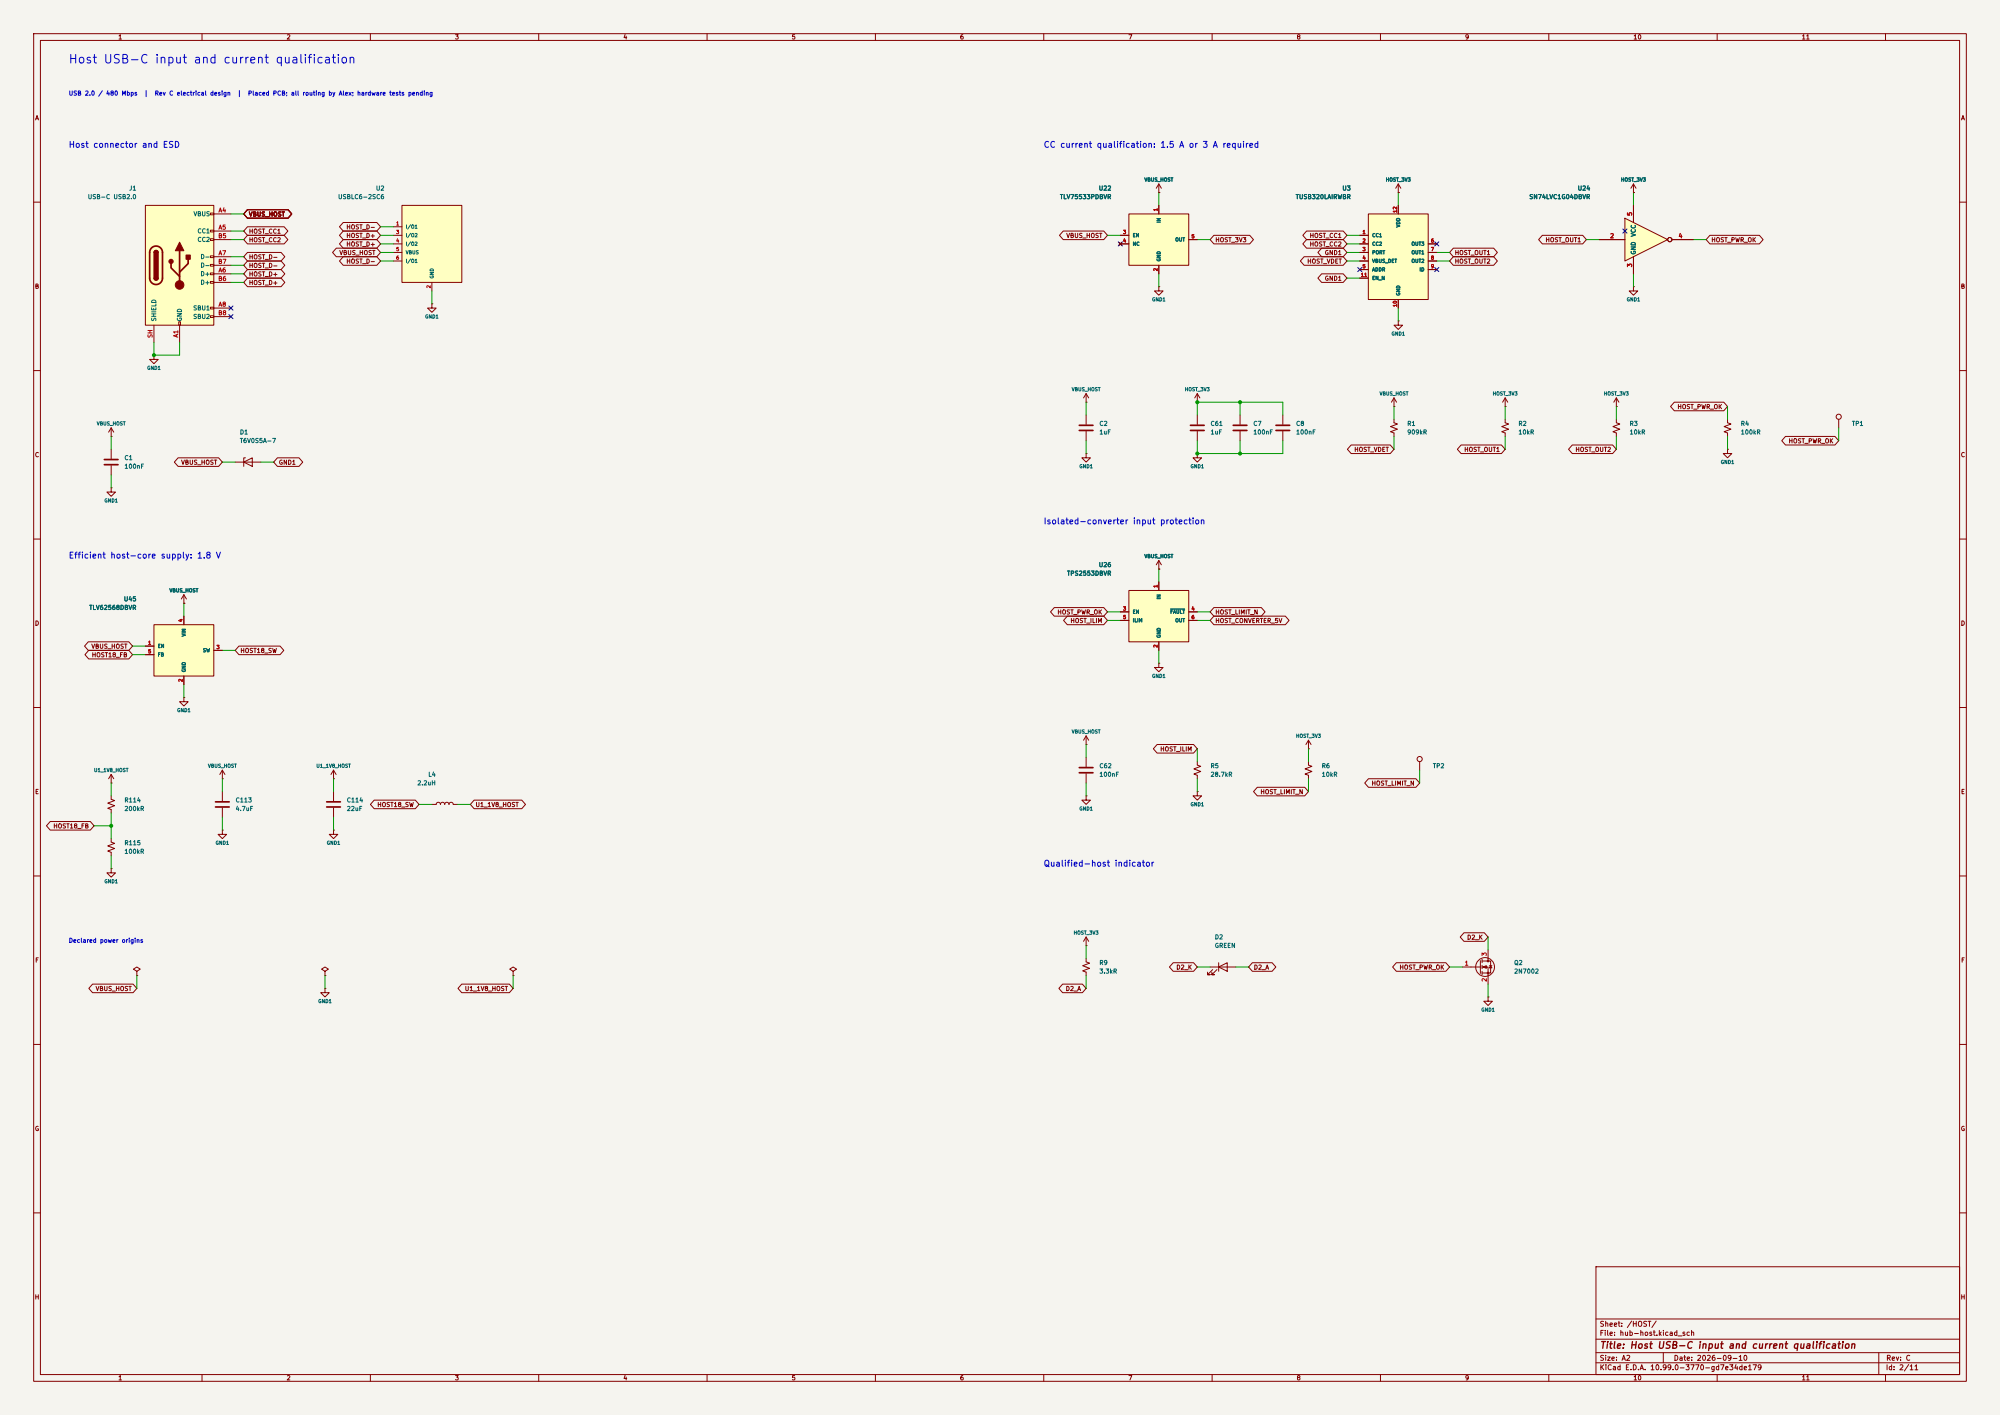
[picture p18: page 2]

Host USB-C input and current qualification

Host connector and ESD

CC current qualification: 1.5 A or 3 A required

Isolated-converter input protection

Efficient host-core supply: 1.8 V

Sheet: /HOST/
File: hub-host.kicad_sch
Title: Host USB-C input and current qualification

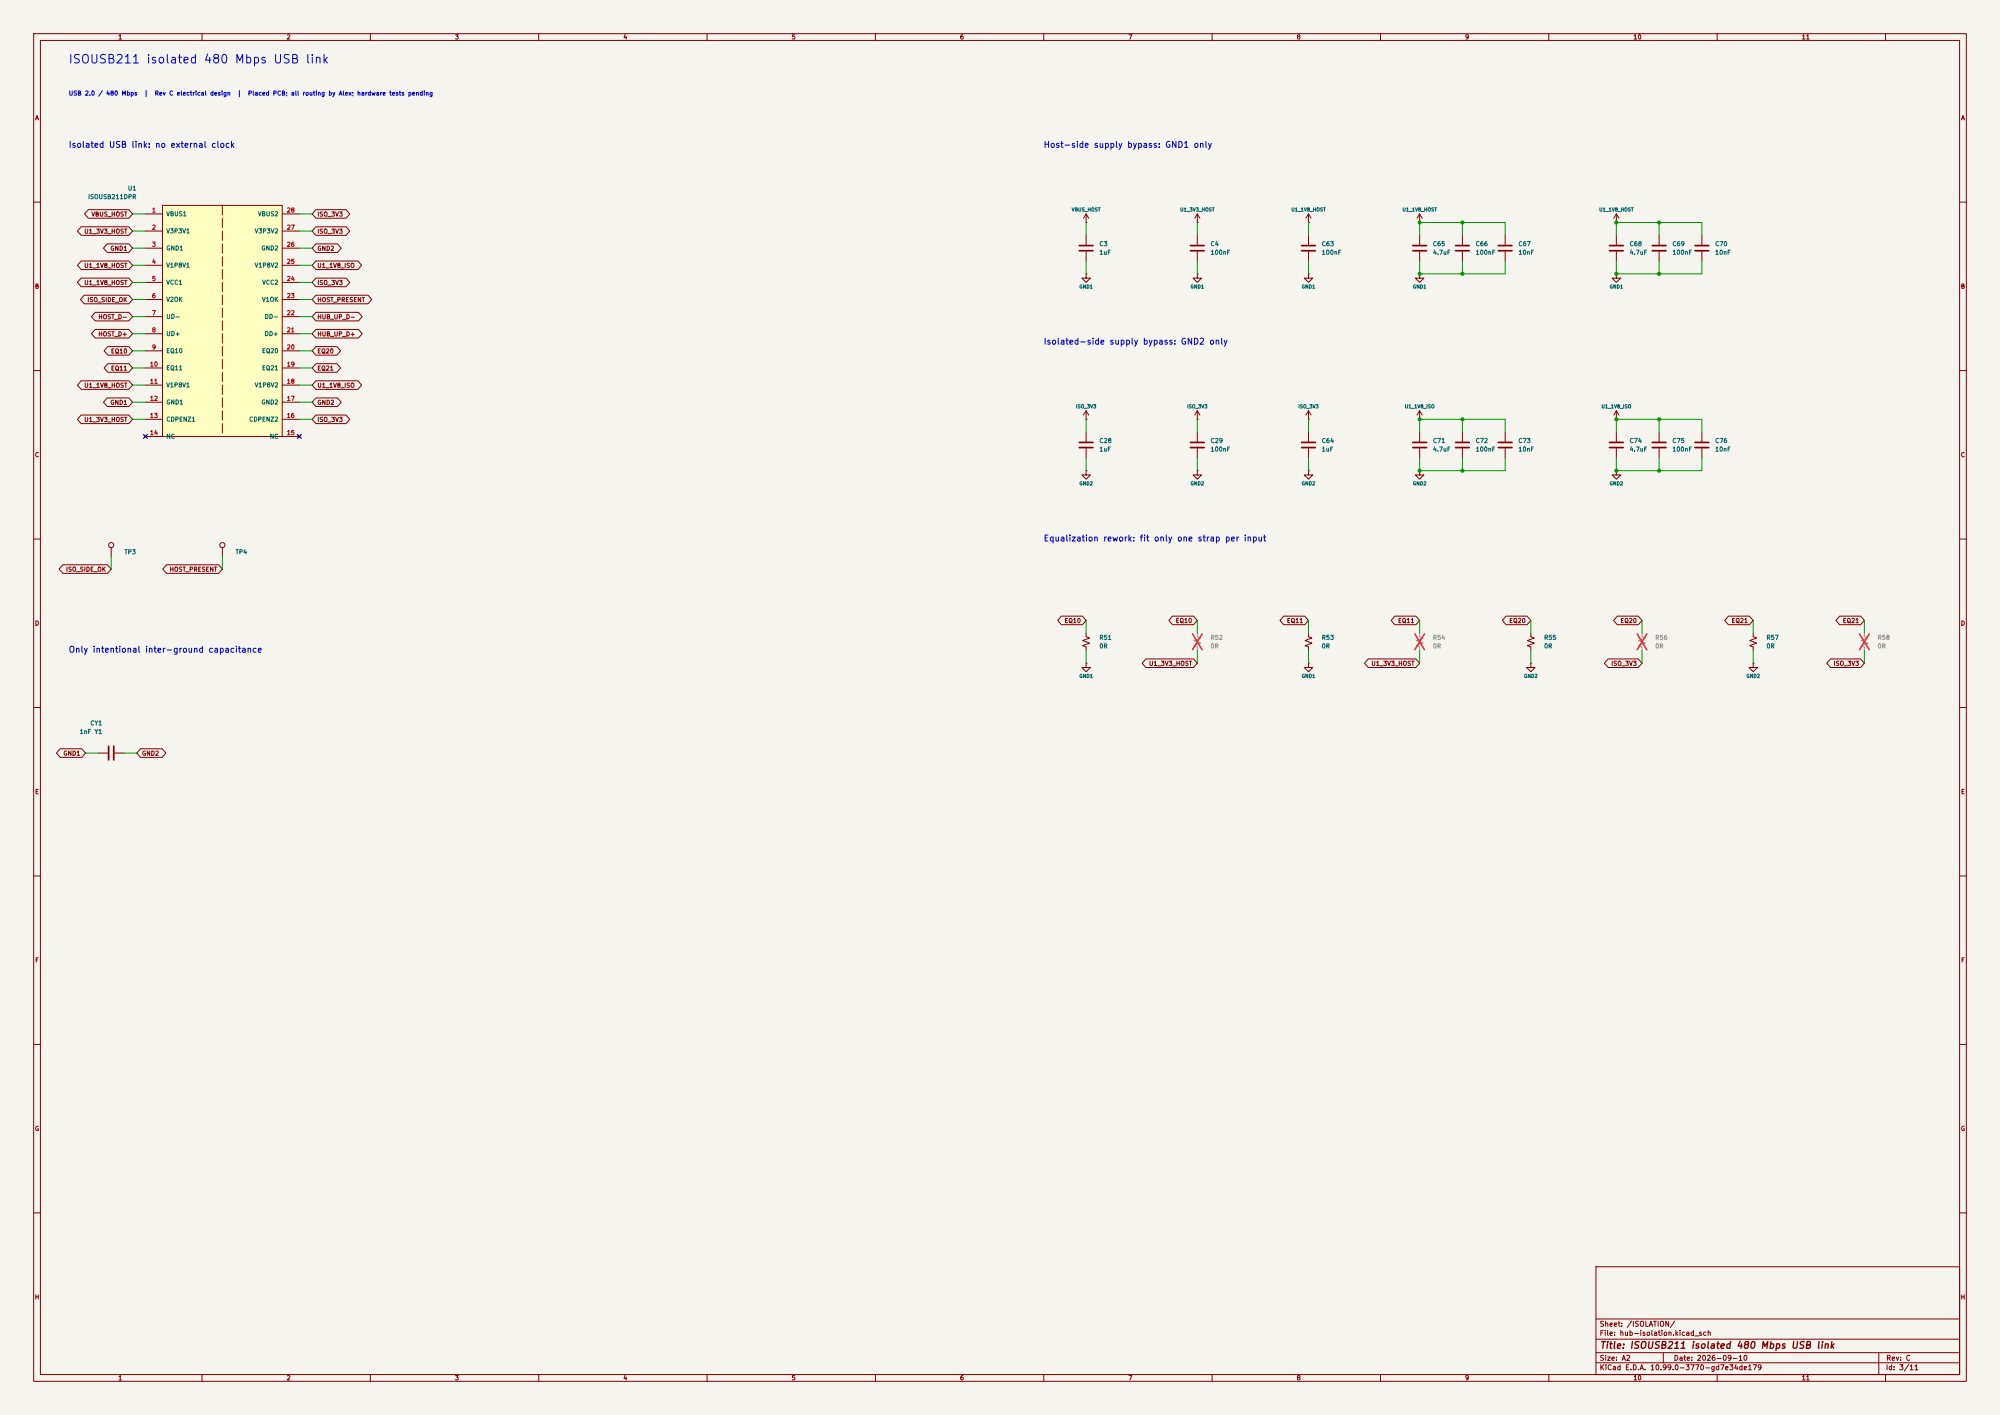
[picture p19: page 3]

ISOUSB211 isolated 480 Mbps USB link

Isolated USB link: no external clock

Host-side supply bypass: GND1 only

U1_1V8_HOST HOST_D- Only intentional inter-ground capacitance

Isolated-side supply bypass: GND2 only

Equalization rework: fit only one strap per input

Sheet: /ISOLATION/
File: hub-isolation.kicad_sch
Title: ISOUSB211 isolated 480 Mbps USB link

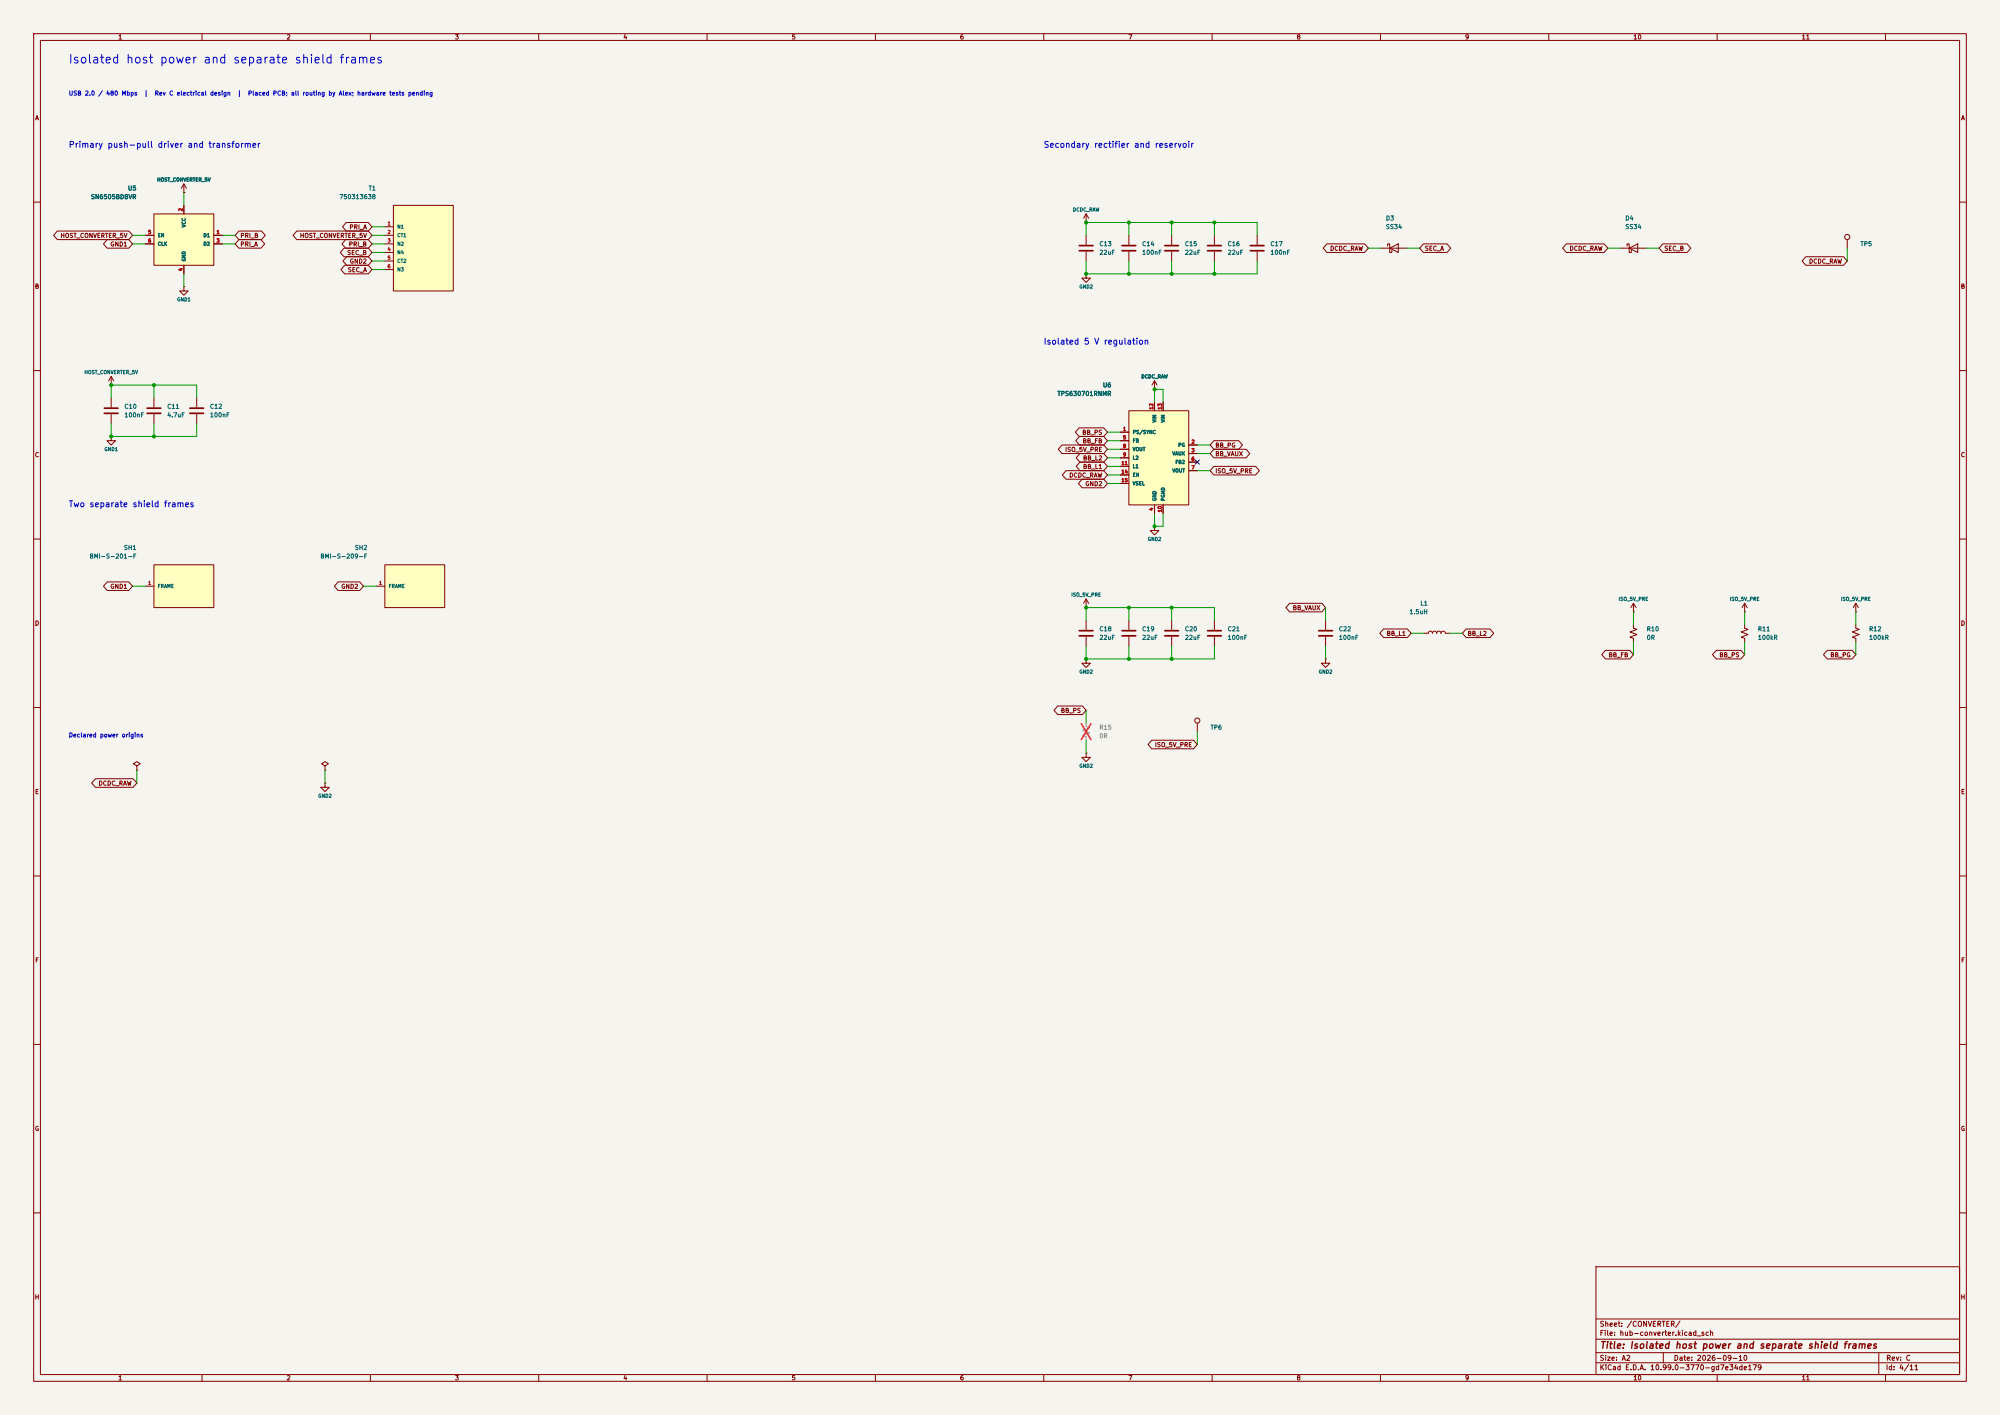
[picture p20: page 4]

Isolated host power and separate shield frames

Primary push-pull driver and transformer

Secondary rectifier and reservoir

GND2 HOST_CONVERTER_5V Two separate shield frames

Sheet: /CONVERTER/
File: hub-converter.kicad_sch
Title: Isolated host power and separate shield frames

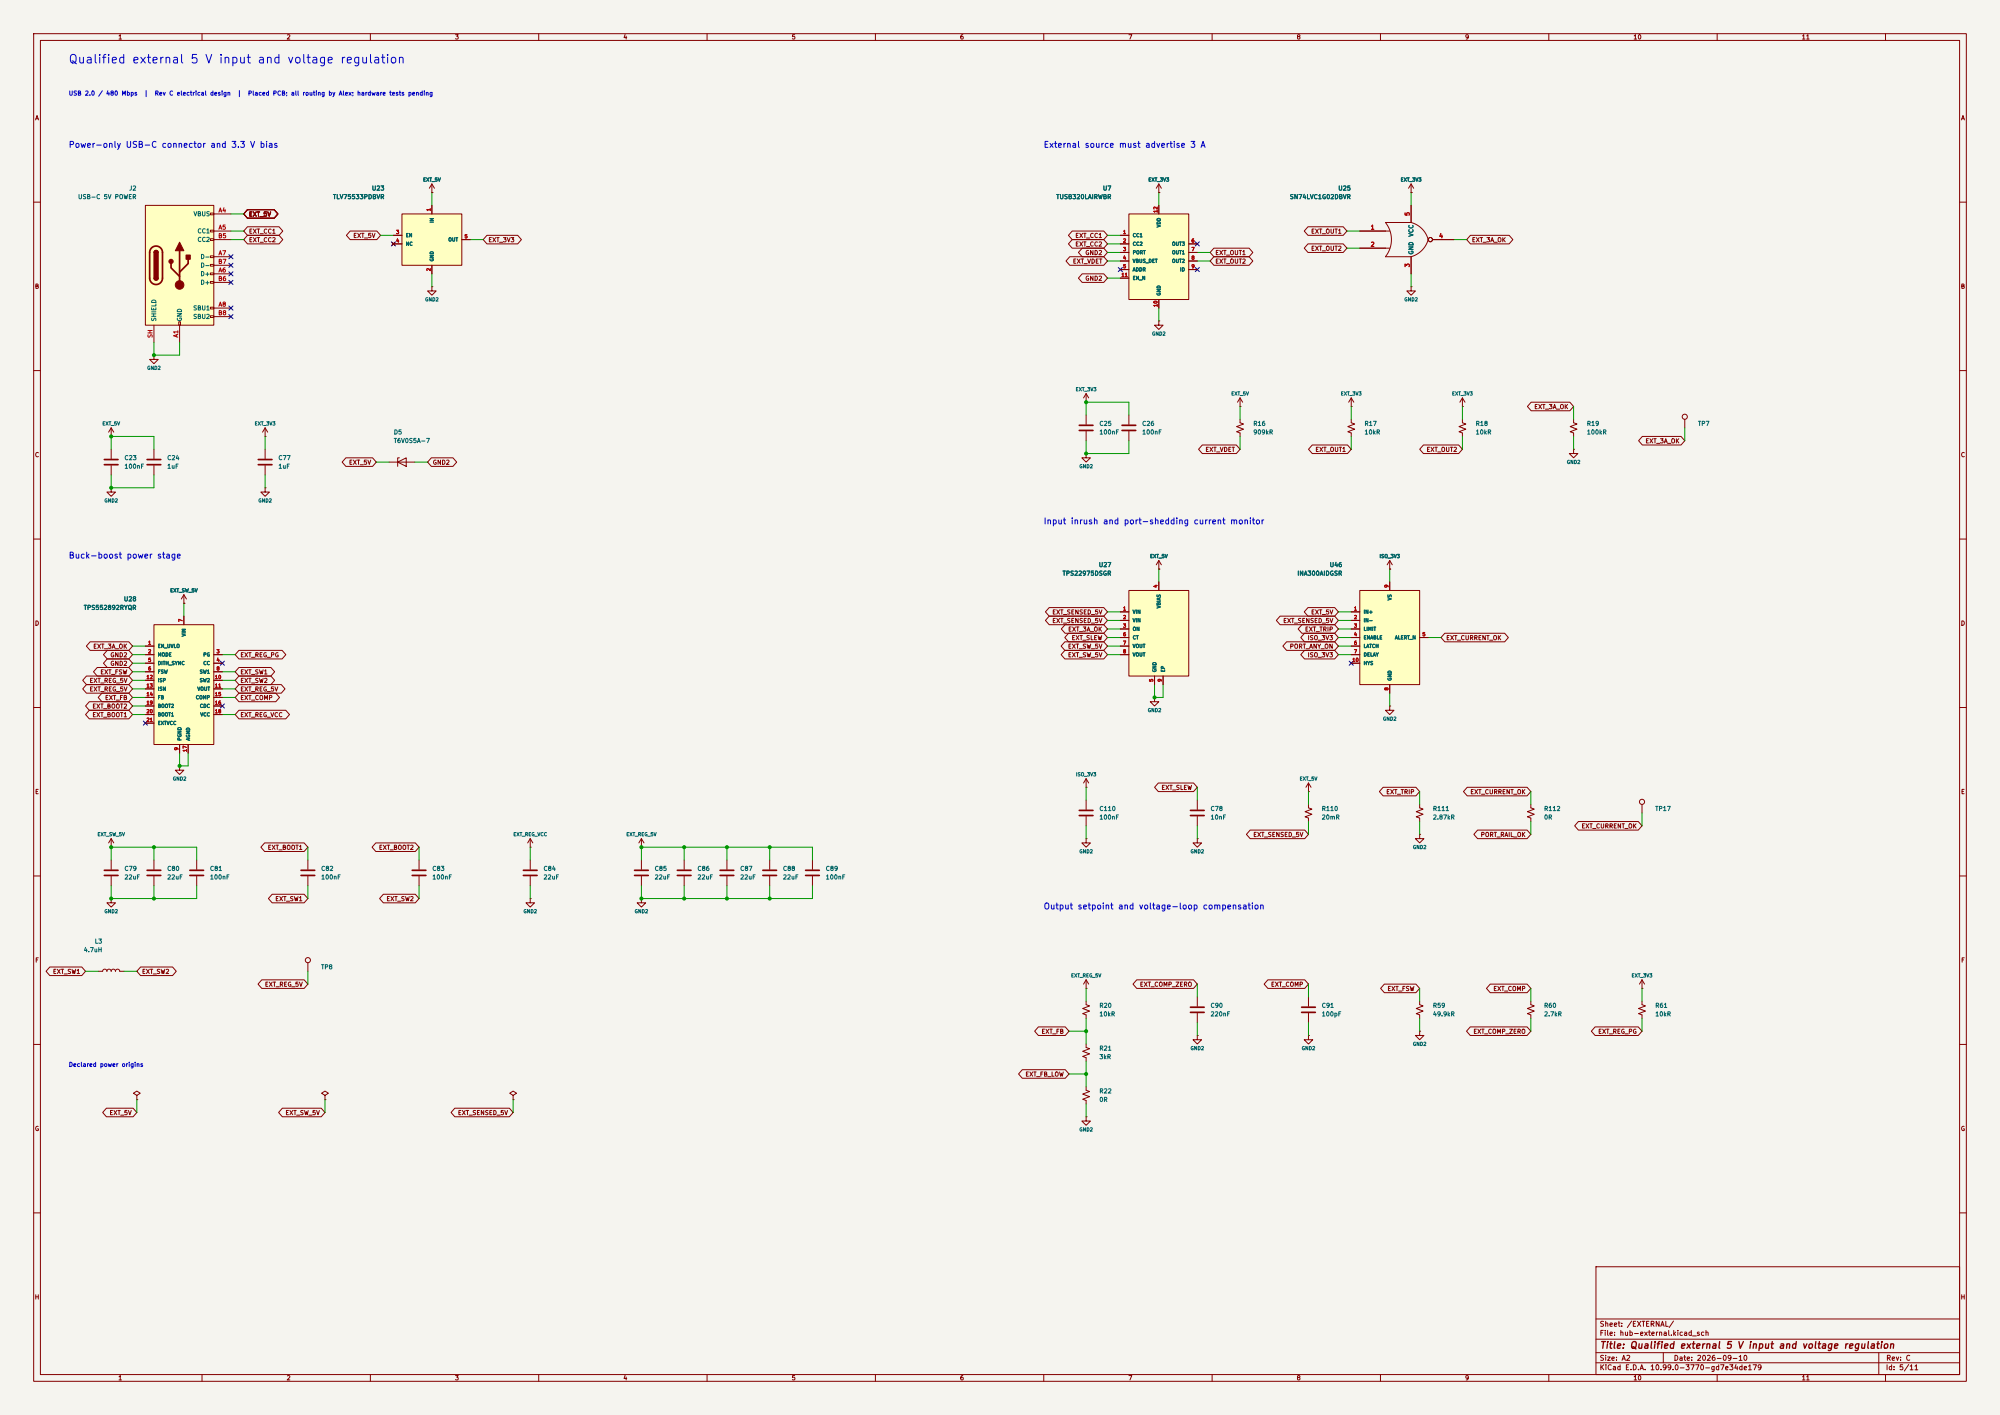
[picture p21: page 5]

Qualified external 5 V input and voltage regulation

Power-only USB-C connector and 3.3 V bias

External source must advertise 3 A

Input inrush and port-shedding current monitor

Buck-boost power stage

Output setpoint and voltage-loop compensation
EXT_REG_5VR22

Sheet: /EXTERNAL/
File: hub-external.kicad_sch
Title: Qualified external 5 V input and voltage regulation

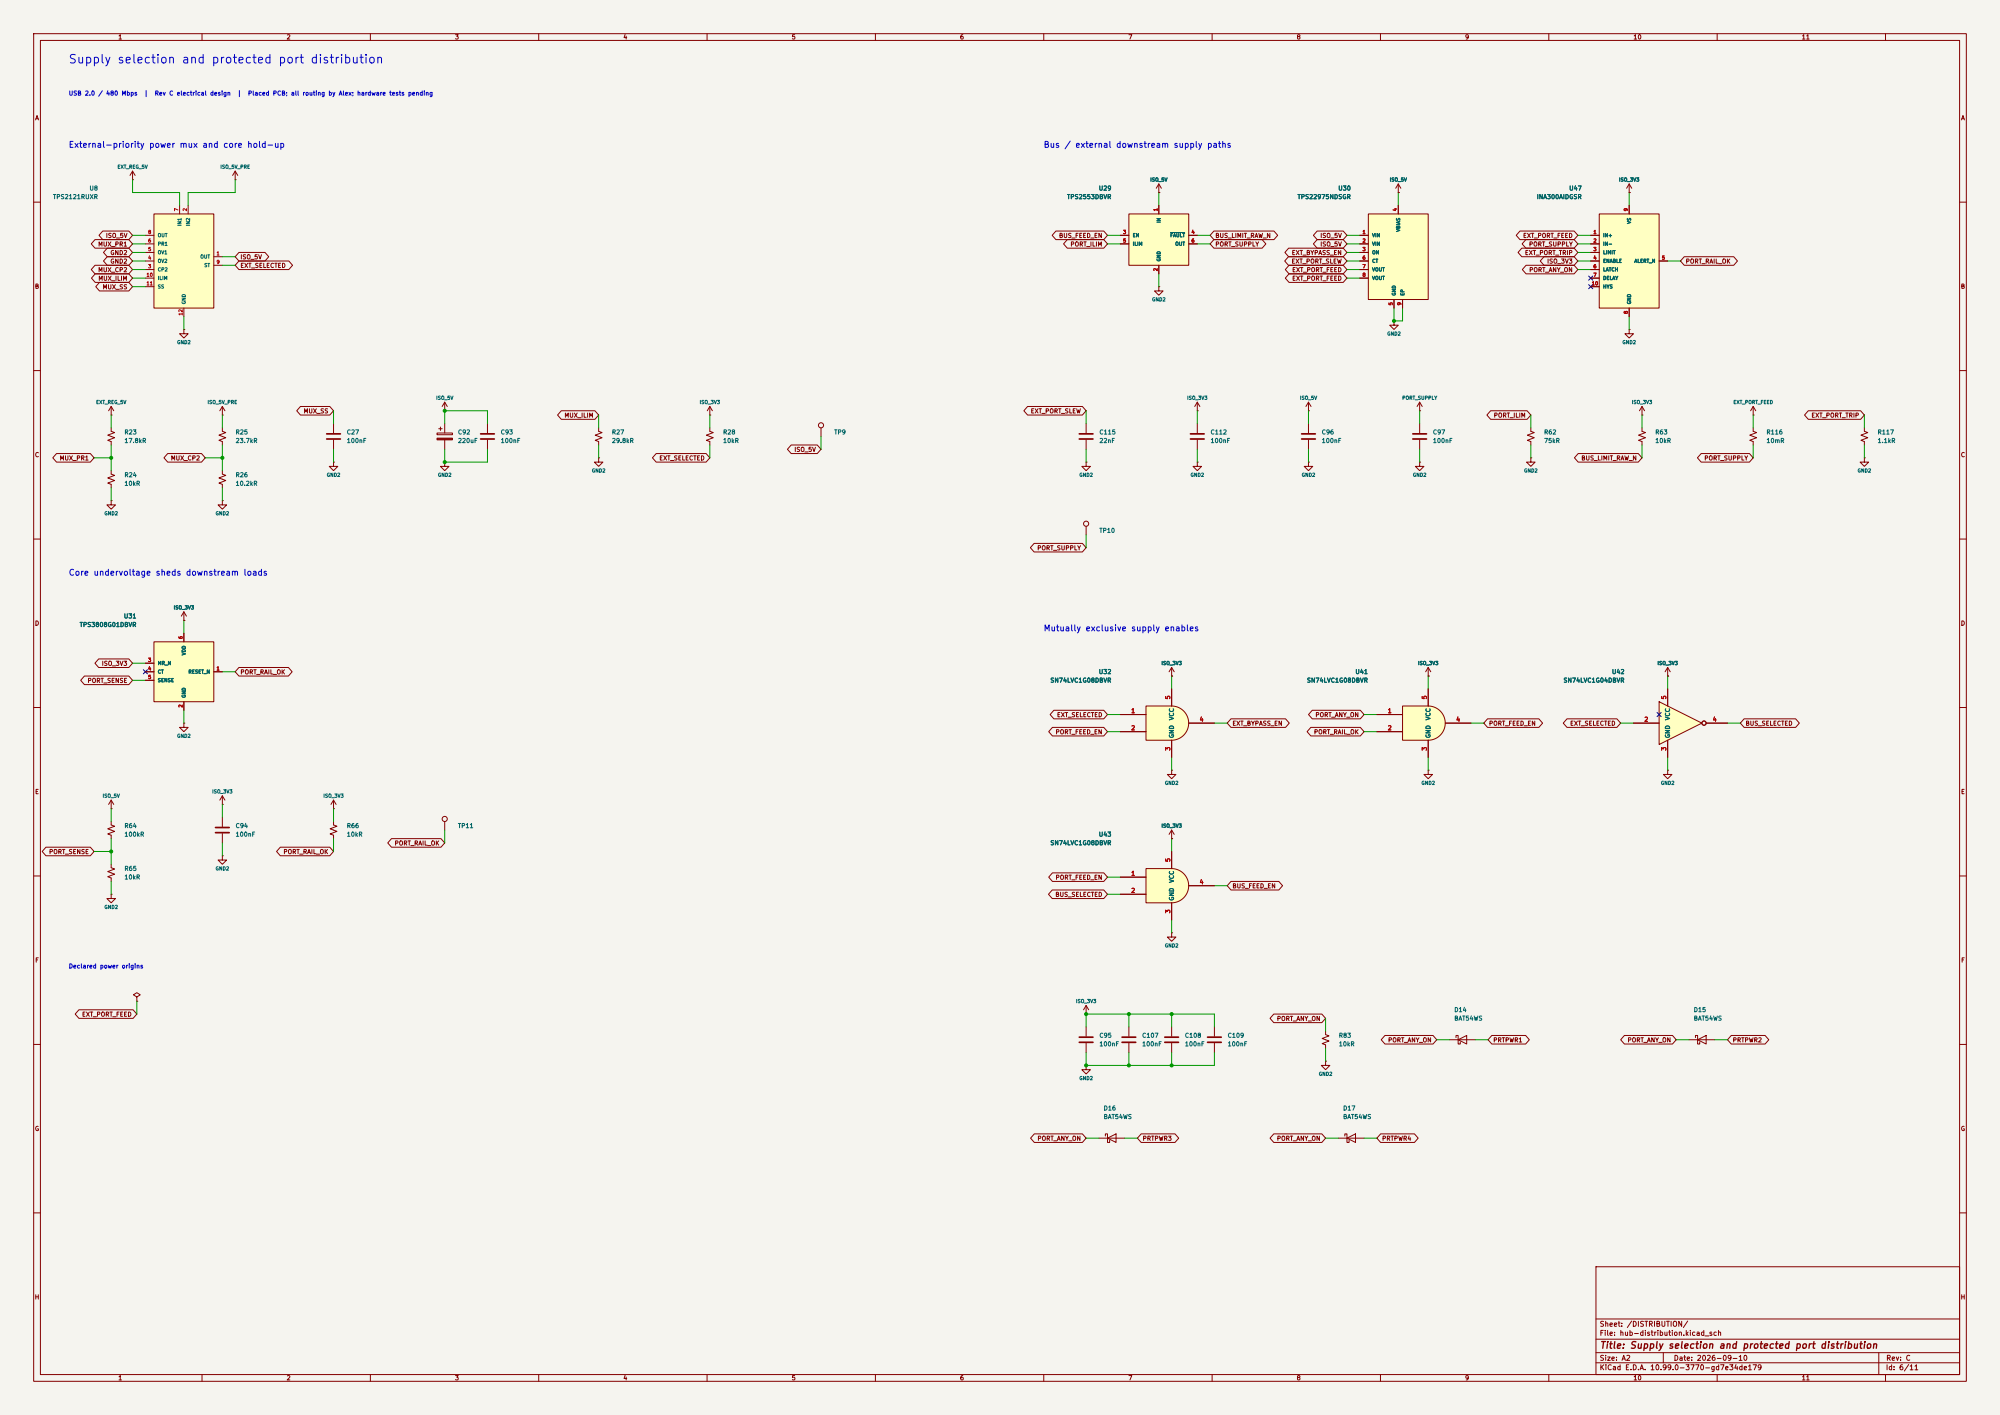
[picture p22: page 6]

Supply selection and protected port distribution

External-priority power mux and core hold-up

Bus / external downstream supply paths

Core undervoltage sheds downstream loads

Mutually exclusive supply enables
ISO_3V3 1

Sheet: /DISTRIBUTION/
File: hub-distribution.kicad_sch
Title: Supply selection and protected port distribution

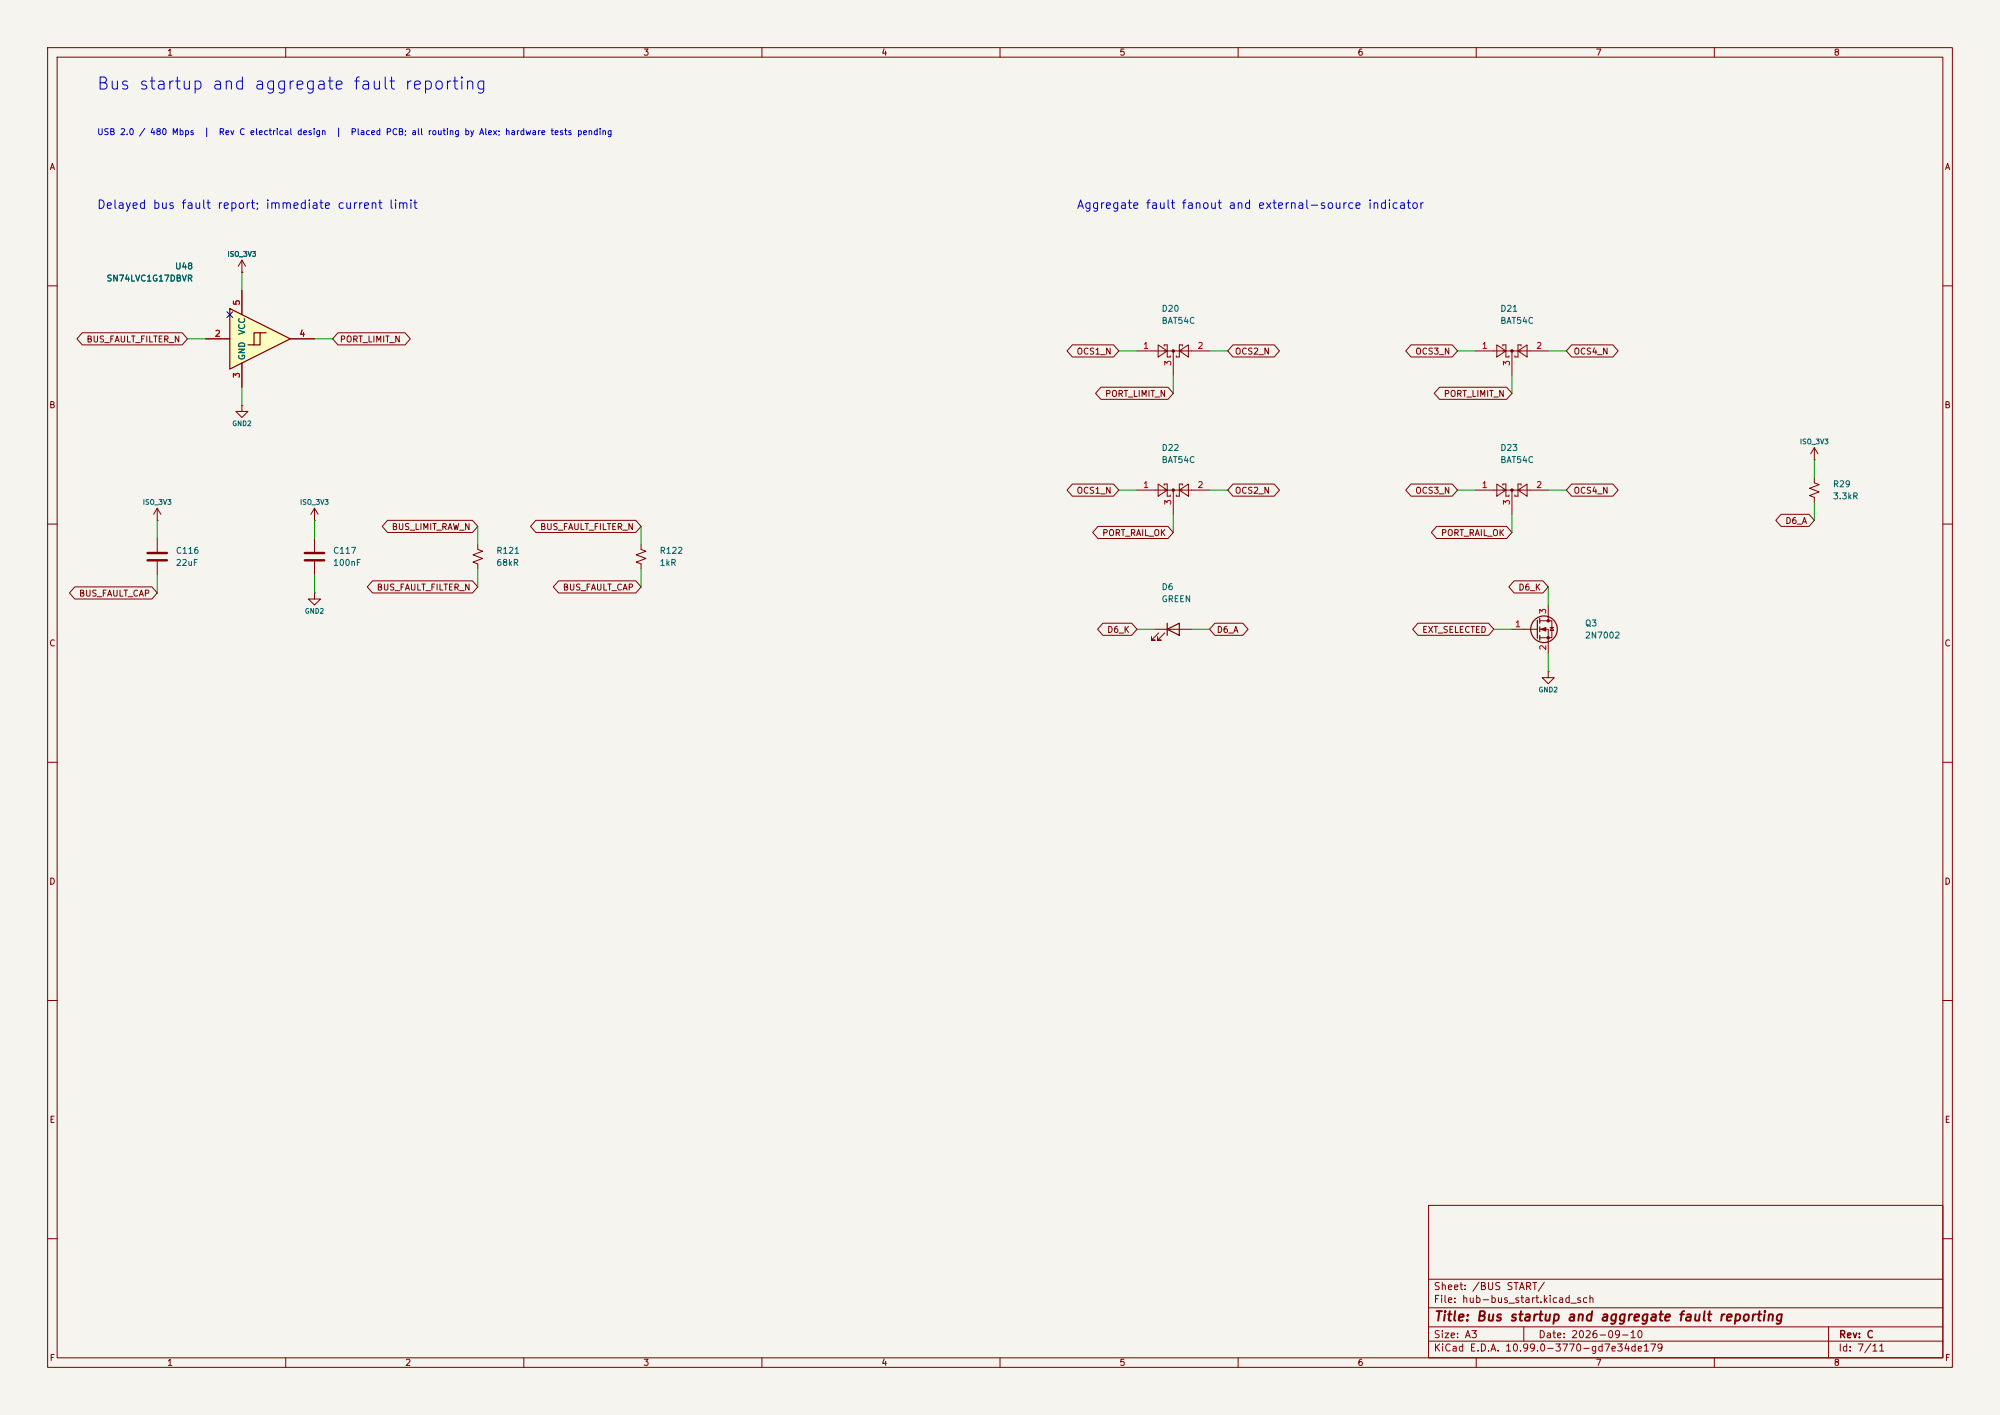
[picture p23: page 7]

Bus startup and aggregate fault reporting

Aggregate fault fanout and external-source indicator U48

Sheet: /BUS START/
File: hub-bus_start.kicad_sch
Title: Bus startup and aggregate fault reporting

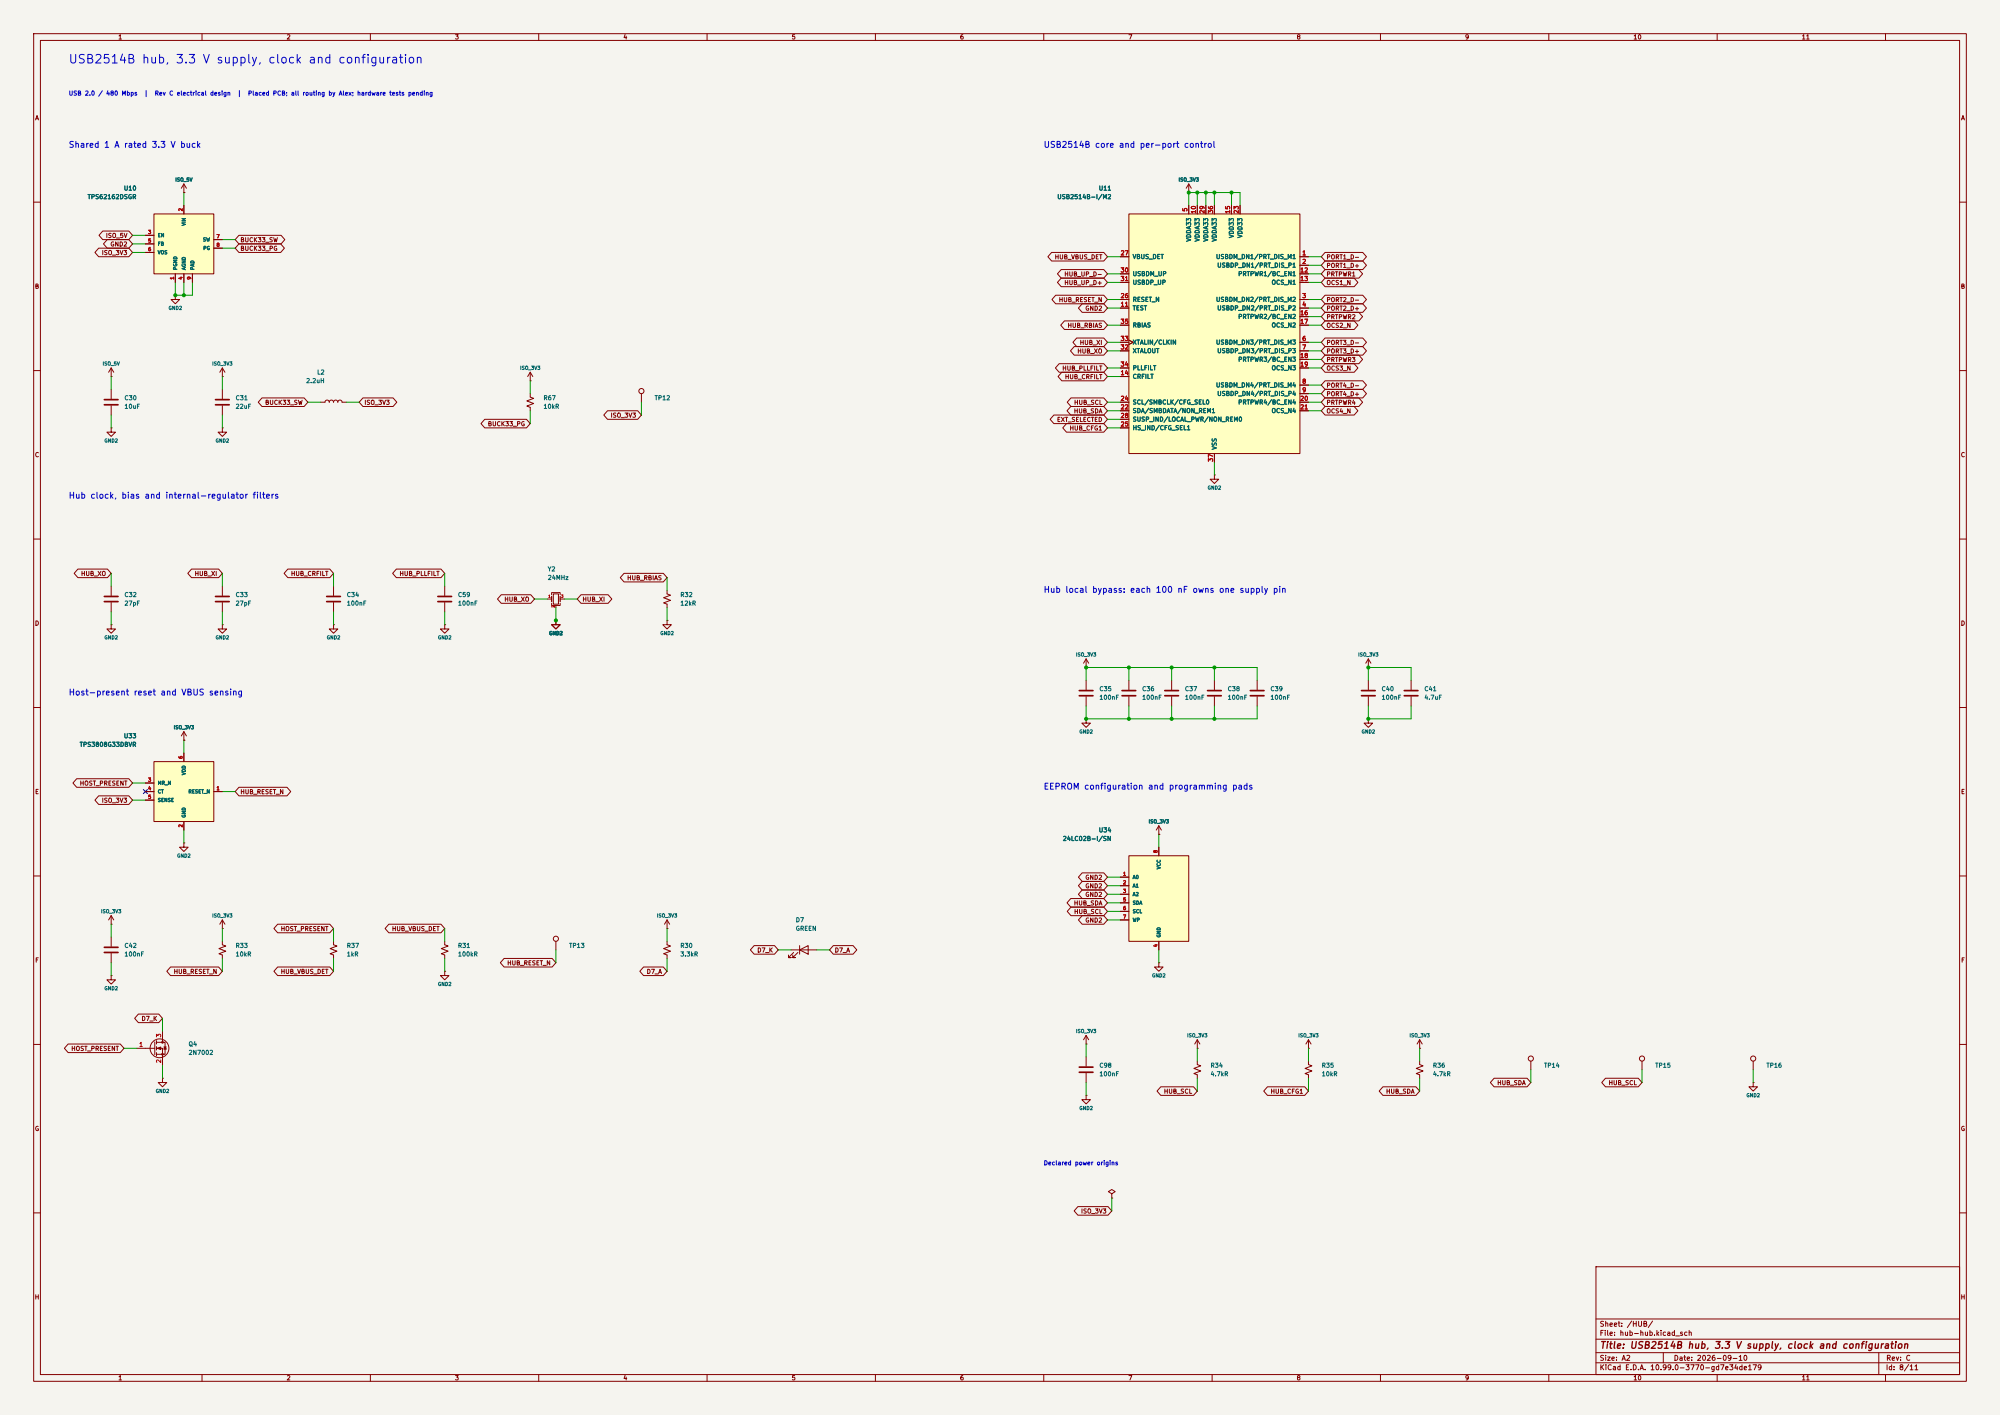
[picture p24: page 8]

USB2514B hub, 3.3 V supply, clock and configuration

USB2514B core and per-port control

PORT3_D+ Host-present reset and VBUS sensing

Hub clock, bias and internal-regulator filters

Hub local bypass: each 100 nF owns one supply pin

EEPROM configuration and programming pads

Sheet: /HUB/
File: hub-hub.kicad_sch
Title: USB2514B hub, 3.3 V supply, clock and configuration

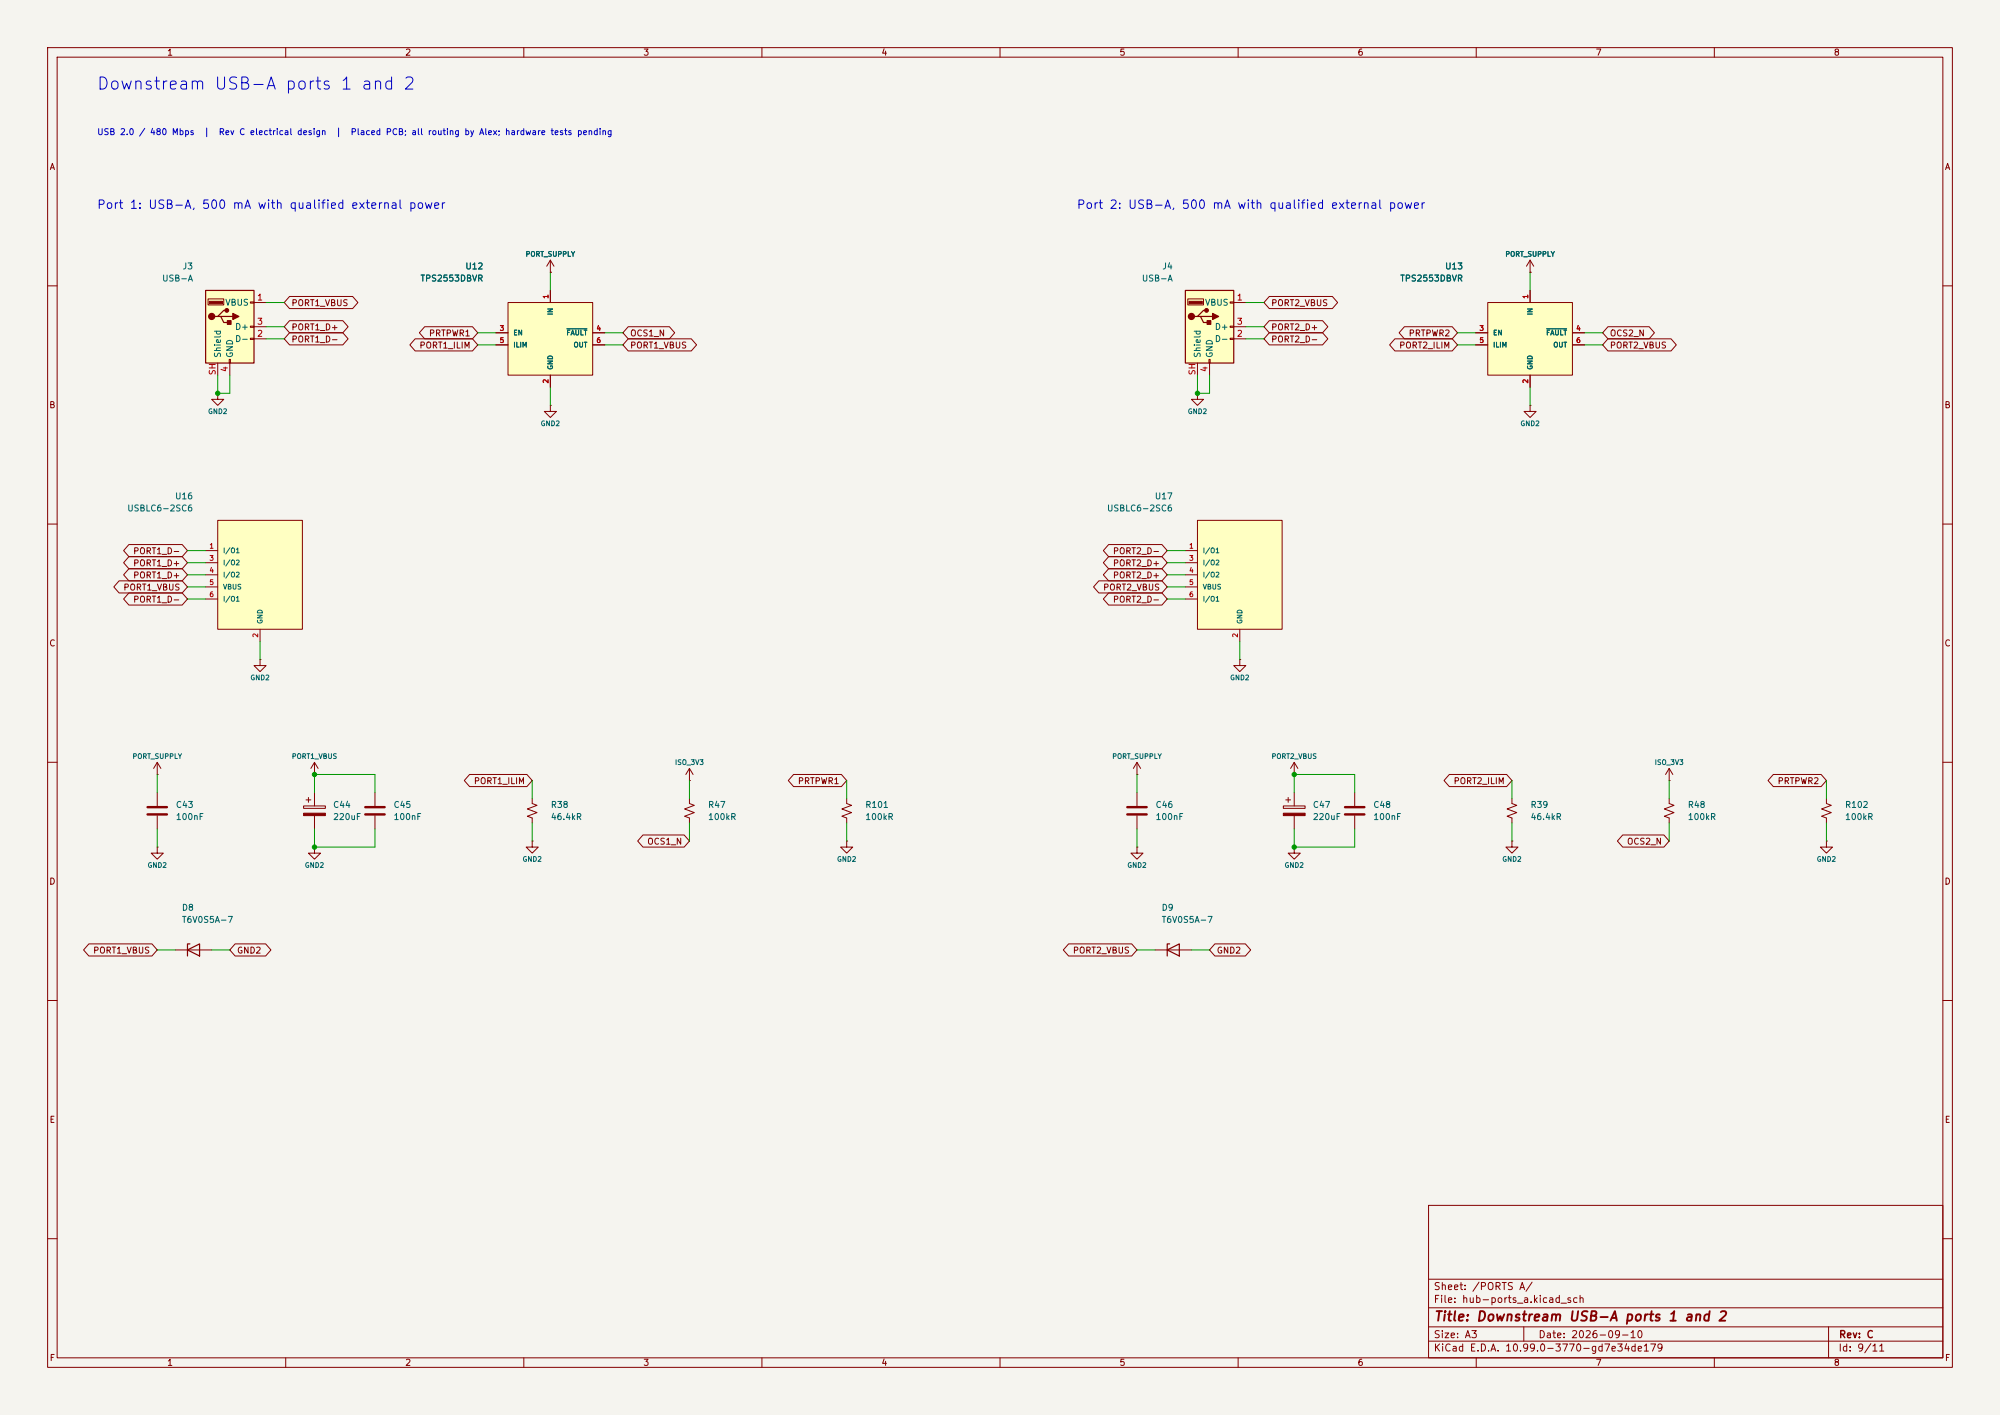
[picture p25: page 9]

Downstream USB-A ports 1 and 2

Port 2: USB-A, 500 mA with qualified external power U12

Sheet: /PORTS A/
File: hub-ports_a.kicad_sch
Title: Downstream USB-A ports 1 and 2

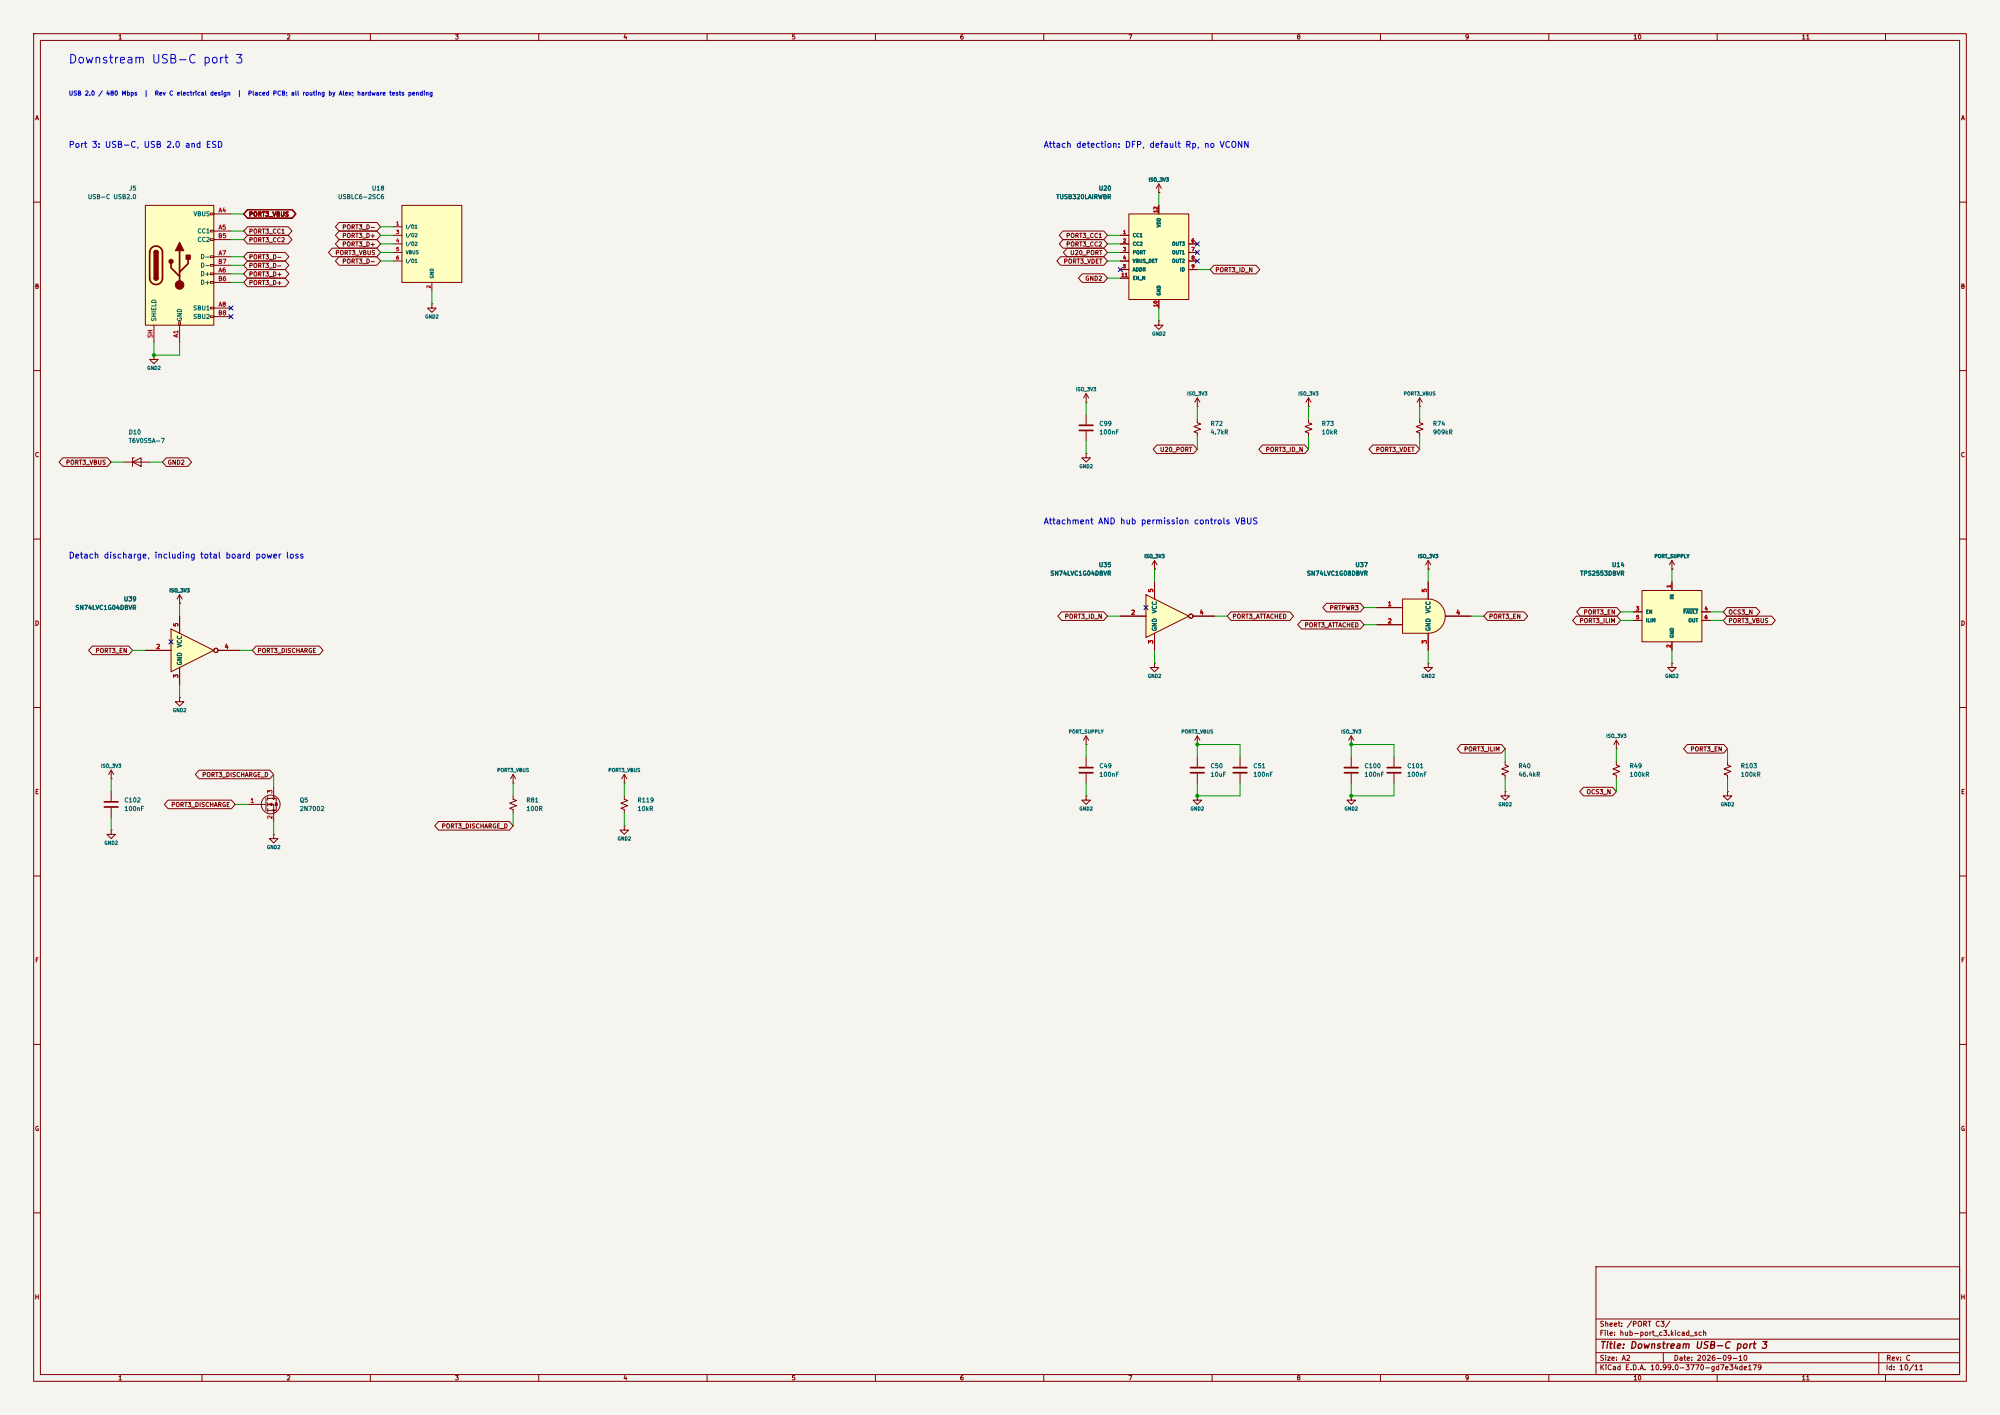
[picture p26: page 10]

Port 3: USB-C, USB 2.0 and ESD

Attach detection: DFP, default Rp, no VCONN

Attachment AND hub permission controls VBUS

Detach discharge, including total board power loss

Sheet: /PORT C3/
File: hub-port_c3.kicad_sch
Title: Downstream USB-C port 3

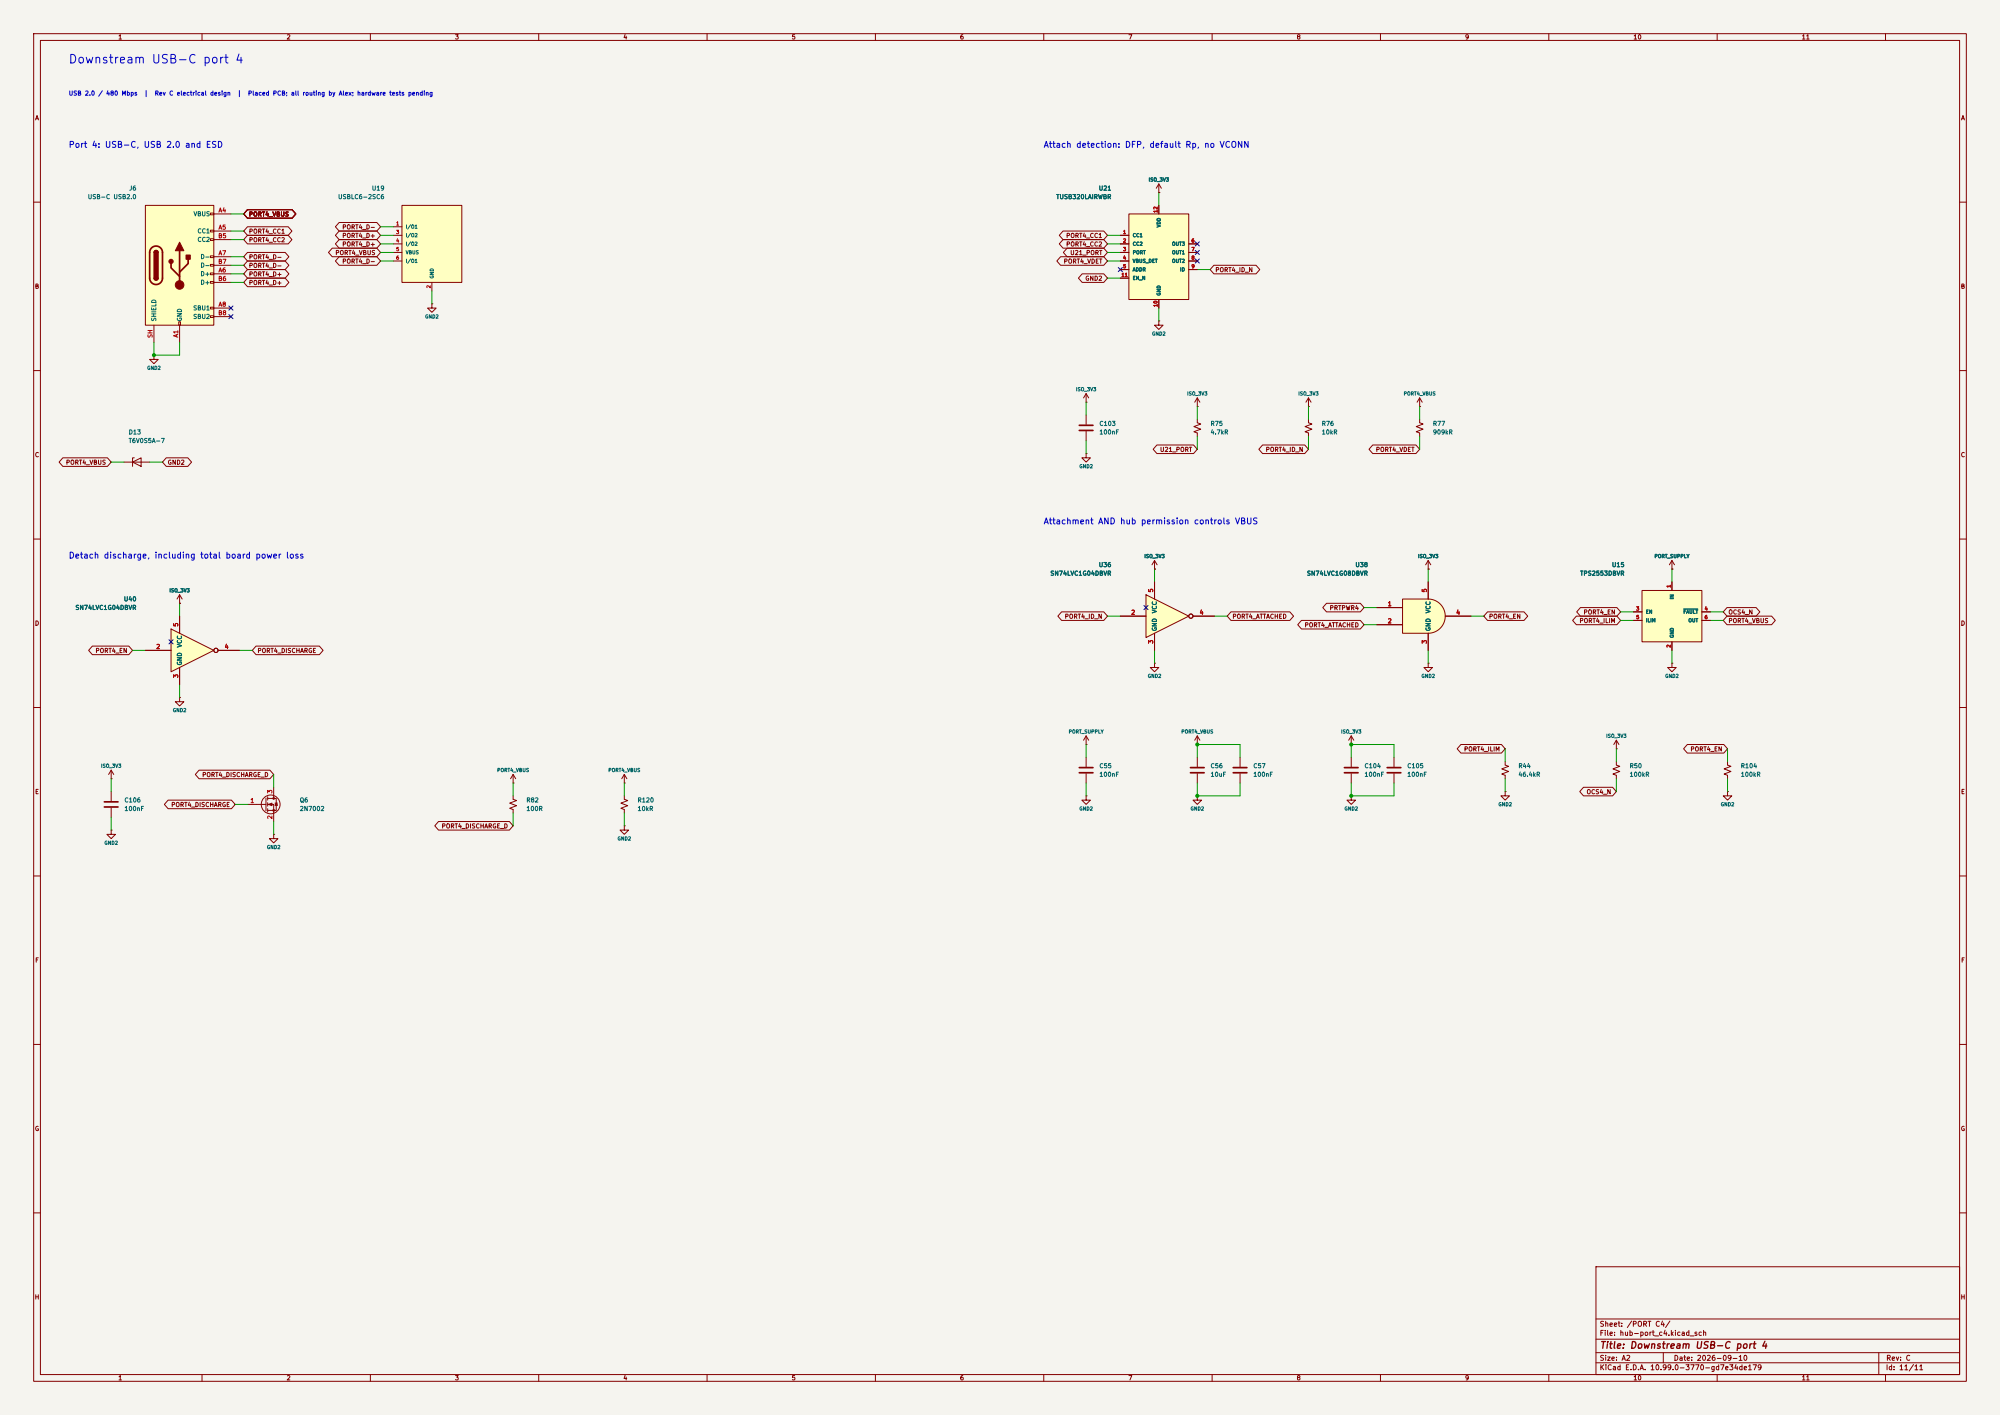
[picture p27: page 11]

Port 4: USB-C, USB 2.0 and ESD

Attach detection: DFP, default Rp, no VCONN

Attachment AND hub permission controls VBUS

Detach discharge, including total board power loss

Sheet: /PORT C4/
File: hub-port_c4.kicad_sch
Title: Downstream USB-C port 4
