alxgmpr/adum4165-isolator/(list of files, drawings)

Other design files:
docs/revc/reports/pcb-inventory-and-isolation.json
