alxgmpr/adum4165-isolator/hub.kicad_pcb

## KiCad design hub.kicad_pcb (2026-09-10)

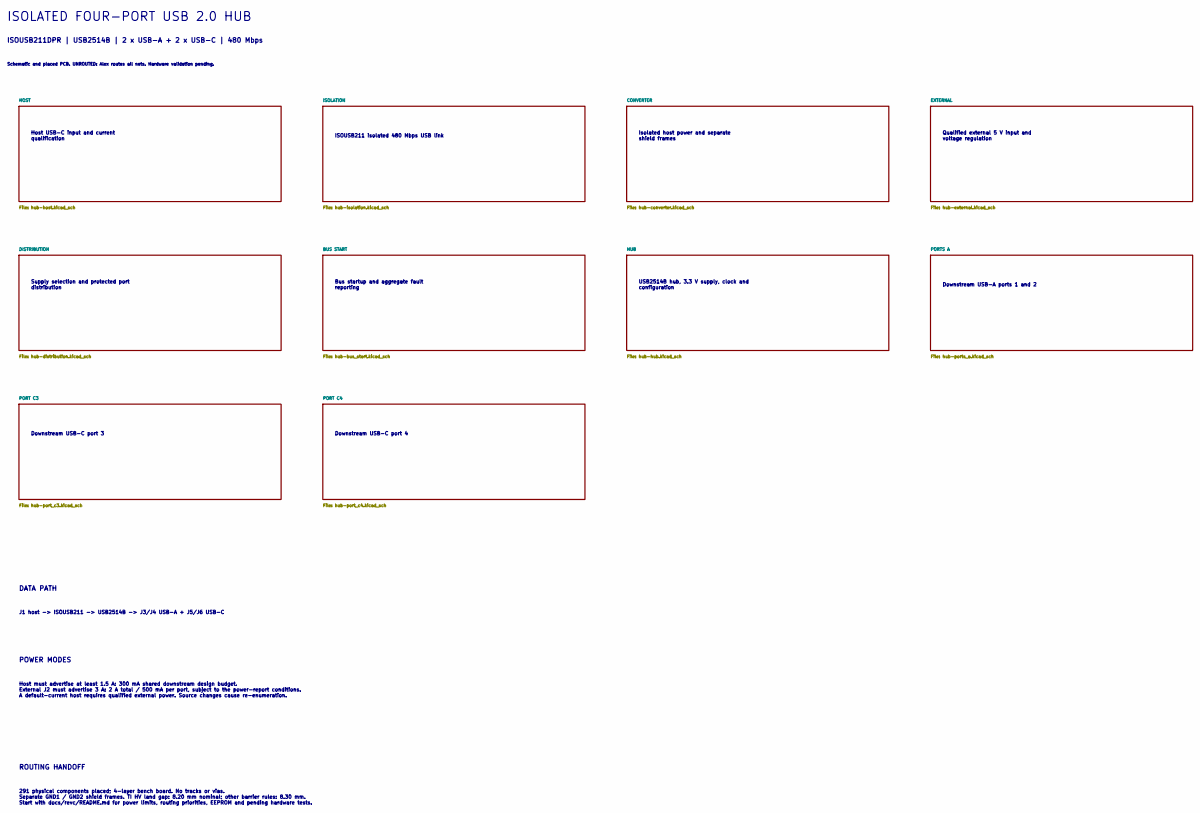
[picture p28: schematic hub.kicad_sch, Rev C — Isolated four-port USB 2.0 hub]

Notes on the sheet:
ISOLATED FOUR-PORT USB 2.0 HUB
ISOUSB211DPR | USB2514B | 2 x USB-A + 2 x USB-C | 480 Mbps
Schematic and placed PCB. UNROUTED: Alex routes all nets. Hardware validation pending.
Host USB-C input and current qualification
ISOUSB211 isolated 480 Mbps USB link
Isolated host power and separate shield frames
Qualified external 5 V input and voltage regulation
Supply selection and protected port distribution
Bus startup and aggregate fault reporting
USB2514B hub, 3.3 V supply, clock and configuration
Downstream USB-A ports 1 and 2
Downstream USB-C port 3
Downstream USB-C port 4
DATA PATH
J1 host -> ISOUSB211 -> USB2514B -> J3/J4 USB-A + J5/J6 USB-C
POWER MODES
Host must advertise at least 1.5 A: 300 mA shared downstream design budget. External J2 must advertise 3 A: 2 A total / 500 mA per port, subject to the power-report conditions. A default-current host requires qualified external power. Source changes cause re-enumeration.
ROUTING HANDOFF
291 physical components placed; 4-layer bench board. No tracks or vias. Separate GND1 / GND2 shield frames. TI HV land gap: 8.20 mm nominal; other barrier rules: 8.30 mm. Start with docs/revc/README.md for power limits, routing priorities, EEPROM and pending hardware tests.

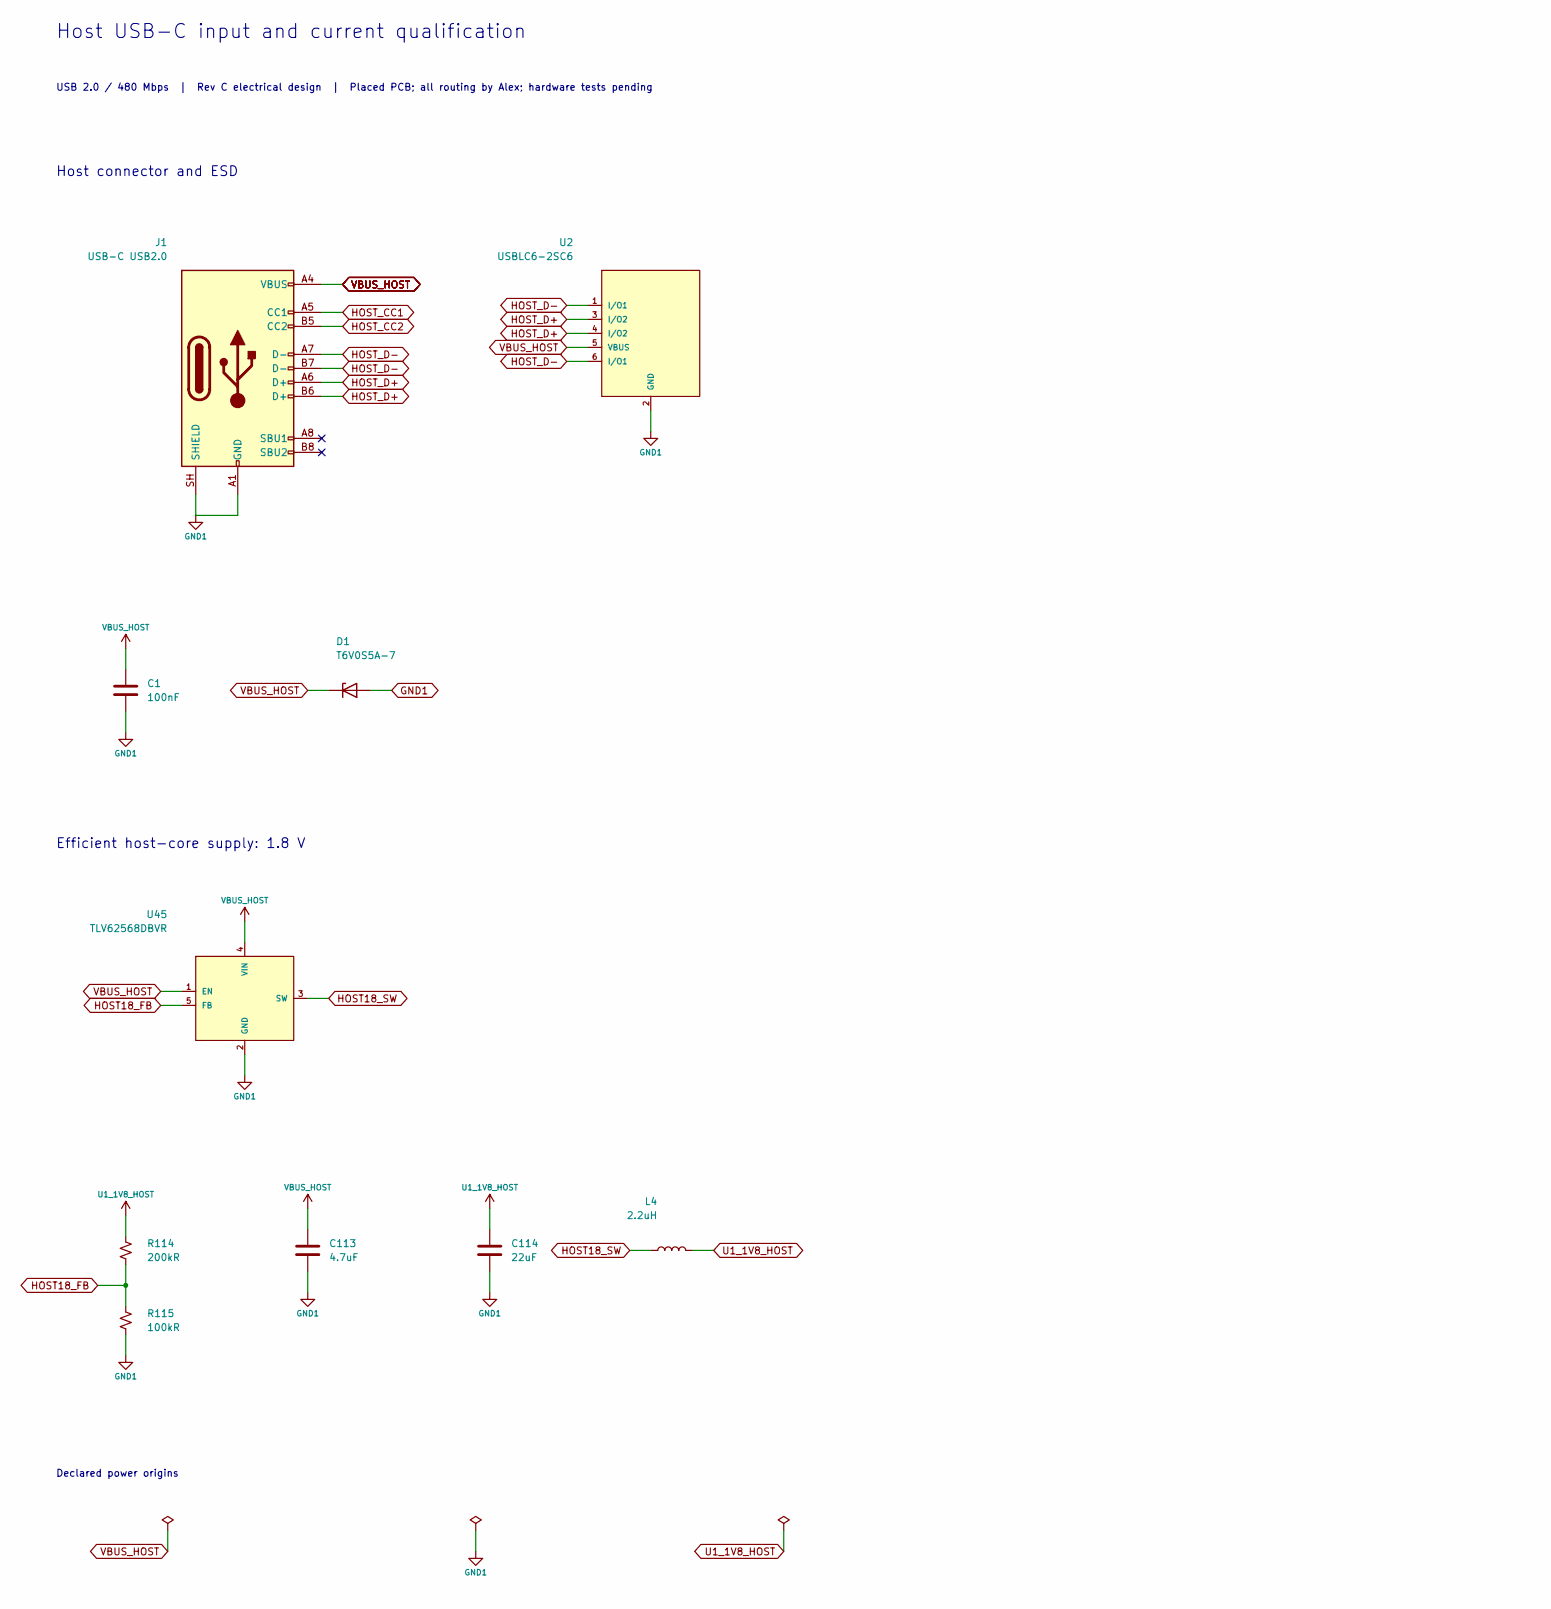
[picture p29: schematic hub-host.kicad_sch, Host USB-C input and current qualification, part in row 1, column 1]

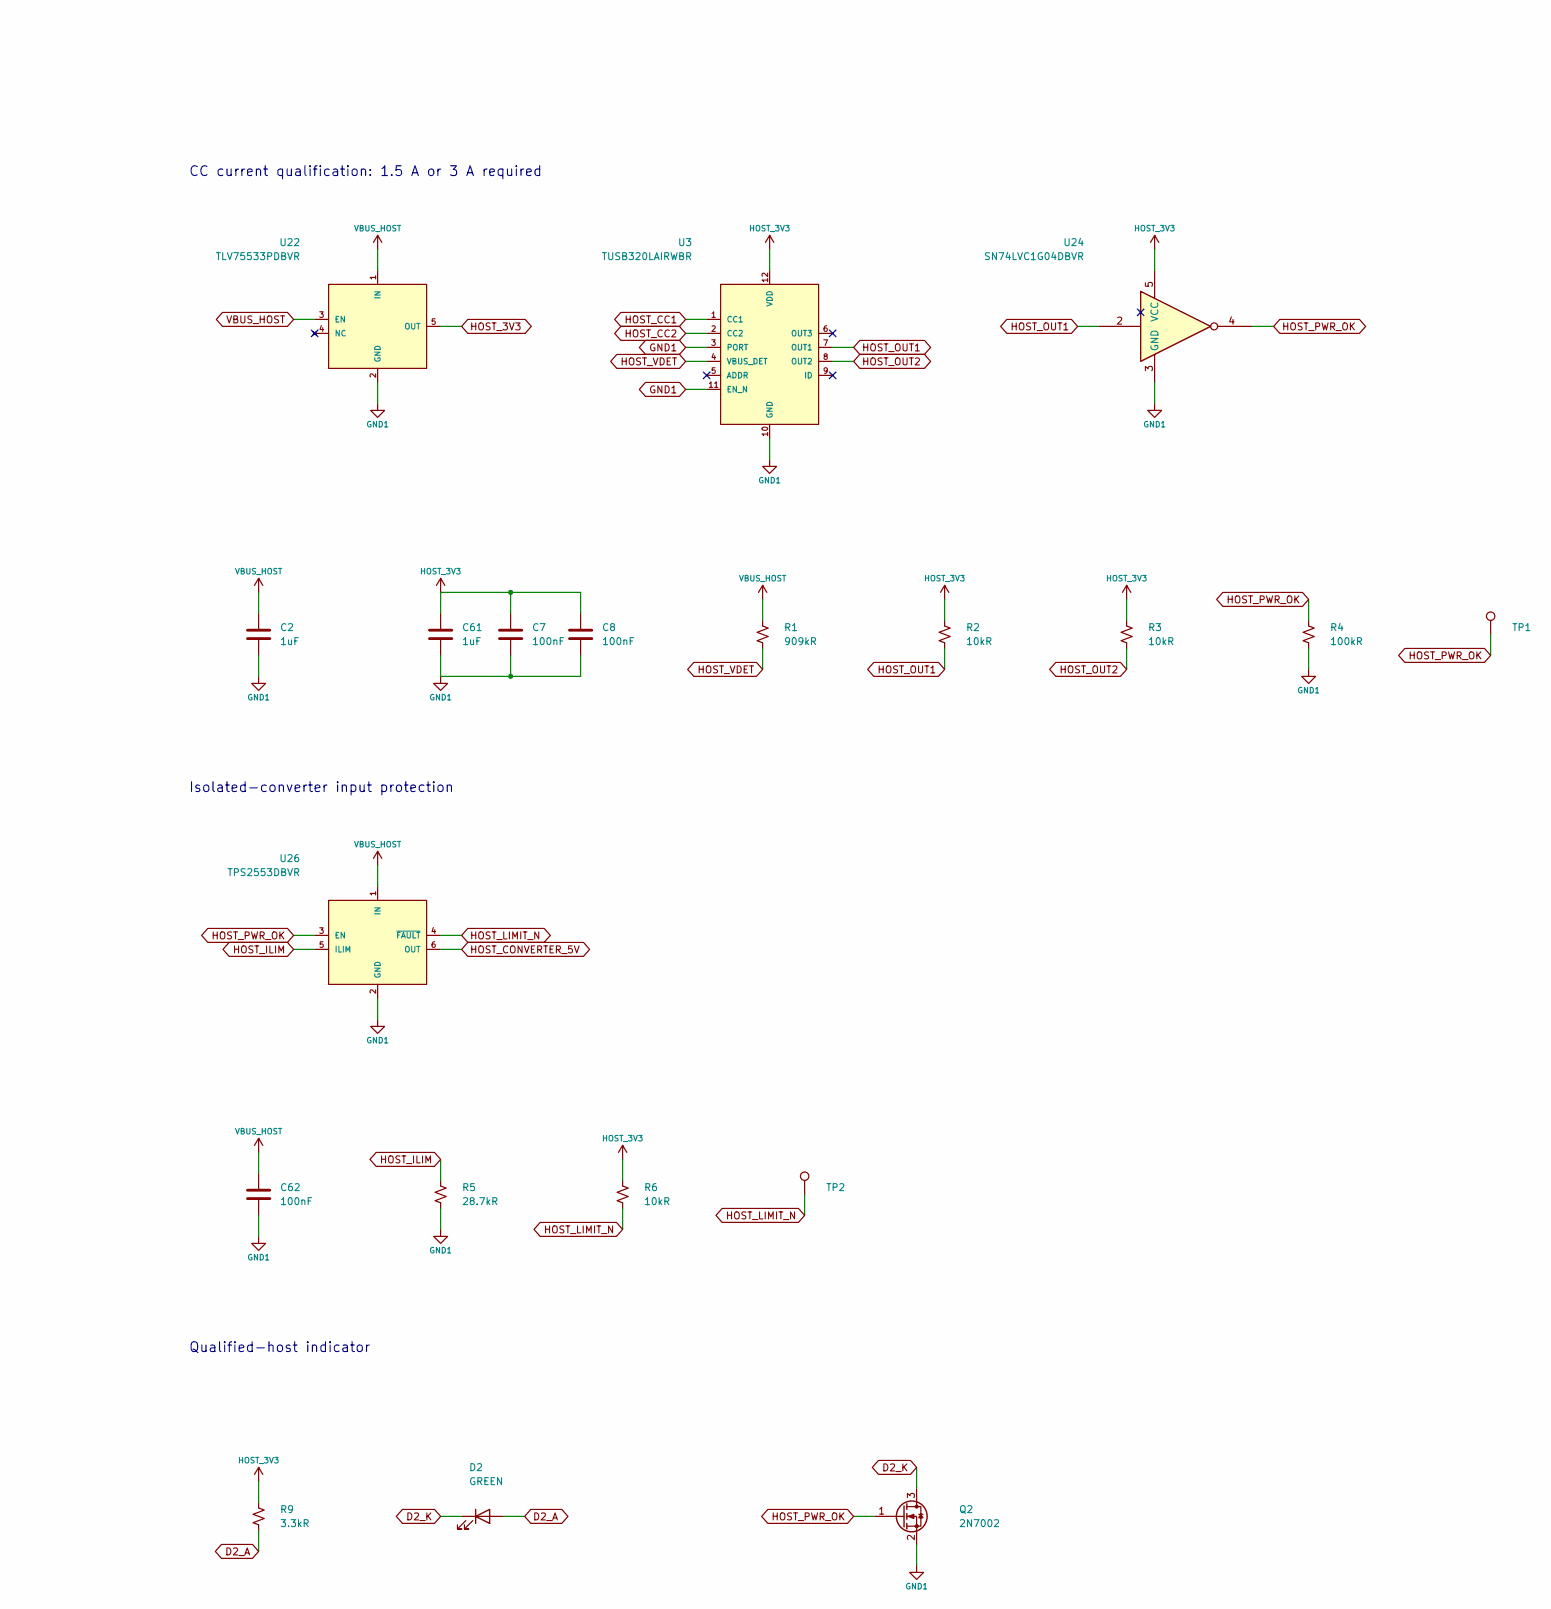
[picture p30: schematic hub-host.kicad_sch, Host USB-C input and current qualification, part in row 1, column 2]

Parts:
C1, C7, C8, C62: 100nF; C_0402_1005Metric; Ratings 50V X7R 10%; MPN GRM155R71H104KE14D; LCSC C77020
C2, C61: 1uF; C_0603_1608Metric; Ratings 25V X5R 10%; MPN GRM188R61E105KA12D; LCSC C77046
C113: 4.7uF; C_0805_2012Metric; Ratings 25V X5R 10%; MPN GRM21BR61E475KA12L; LCSC C77077
C114: 22uF; C_1210_3225Metric; Ratings 25V X7R 10%; MPN GRM32ER71E226KE15L; LCSC C21397
D1: T6V0S5A-7; D_SOD-523; Ratings See exact manufacturer datasheet; MPN T6V0S5A-7; LCSC C19950551
D2: GREEN; LED_0603_1608Metric; Ratings See exact manufacturer datasheet; MPN LTST-C190KGKT; LCSC C125094
J1: USB-C USB2.0; USB_C_Receptacle_HRO_TYPE-C-31-M-12; Ratings See exact manufacturer datasheet; MPN TYPE-C-31-M-12; LCSC C165948
L4: 2.2uH; Coilcraft_XFL4020_4x4mm; Ratings See exact manufacturer datasheet; MPN XFL4020-222MEC; LCSC C122469
Q2: 2N7002; SOT-23; Ratings See exact manufacturer datasheet; MPN 2N7002,215; LCSC C65189
R1: 909kR; R_0402_1005Metric; Ratings 1%, 0.1W, 50V; MPN ERJ2RKF9093X; LCSC C2085054
R2, R3, R6: 10kR; R_0402_1005Metric; Ratings 1%, 0.1W, 50V; MPN ERJ2RKF1002X; LCSC C191123
R4, R115: 100kR; R_0402_1005Metric; Ratings 1%, 0.1W, 50V; MPN ERJ2RKF1003X; LCSC C192169
R5: 28.7kR; R_0402_1005Metric; Ratings 1%, 0.1W, 50V; MPN ERJ2RKF2872X
R9: 3.3kR; R_0402_1005Metric; Ratings 1%, 0.1W, 50V; MPN ERJ2RKF3301X; LCSC C409909
R114: 200kR; R_0402_1005Metric; Ratings 1%, 0.1W, 50V; MPN ERJ2RKF2003X; LCSC C413111
TP1: HOST_PWR_OK; TestPoint_Pad_D1.0mm; Ratings Exposed test pad; no purchased part
TP2: HOST_LIMIT_N; TestPoint_Pad_D1.0mm; Ratings Exposed test pad; no purchased part
U2: USBLC6-2SC6; SOT-23-6; Ratings See exact manufacturer datasheet; MPN USBLC6-2SC6; LCSC C7519
U3: TUSB320LAIRWBR; Texas_X2QFN-12_1.6x1.6mm_P0.4mm; Ratings See exact manufacturer datasheet; MPN TUSB320LAIRWBR; LCSC C132554
U22: TLV75533PDBVR; SOT-23-5; Ratings See exact manufacturer datasheet; MPN TLV75533PDBVR; LCSC C404027
U24: SN74LVC1G04DBVR; SOT-23-5; Ratings See exact manufacturer datasheet; MPN SN74LVC1G04DBVR; LCSC C7827
U26: TPS2553DBVR; SOT-23-6; Ratings See exact manufacturer datasheet; MPN TPS2553DBVR; LCSC C55266
U45: TLV62568DBVR; SOT-23-5; Ratings See exact manufacturer datasheet; MPN TLV62568DBVR; LCSC C163219

Connections:
D2_A: D2.2 (A), R9.2
D2_K: D2.1 (K), Q2.3 (D)
GND1: C1.2, C2.2, C7.2, C8.2, C61.2, C62.2, C113.2, C114.2, D1.2 (A), J1.A1 (GND), J1.A12 (GND), J1.B1 (GND), J1.B12 (GND), J1.SH (SHIELD), Q2.2 (S), R4.2, R5.2, R115.2, U2.2 (GND), U3.3 (PORT), U3.10 (GND), U3.11 (EN_N), U22.2 (GND), U24.3 (GND), U26.2 (GND), U45.2 (GND); also elsewhere on the board
HOST18_FB: R114.2, R115.1, U45.5 (FB)
HOST18_SW: L4.1, U45.3 (SW)
HOST_3V3: C7.1, C8.1, C61.1, R2.1, R3.1, R6.1, R9.1, U3.12 (VDD), U22.5 (OUT), U24.5 (VCC)
HOST_CC1: J1.A5 (CC1), U3.1 (CC1)
HOST_CC2: J1.B5 (CC2), U3.2 (CC2)
HOST_CONVERTER_5V: U26.6 (OUT); also elsewhere on the board
HOST_D+: J1.A6 (D+), J1.B6 (D+), U2.3 (I/O2), U2.4 (I/O2); also elsewhere on the board
HOST_D-: J1.A7 (D-), J1.B7 (D-), U2.1 (I/O1), U2.6 (I/O1); also elsewhere on the board
HOST_ILIM: R5.1, U26.5 (ILIM)
HOST_LIMIT_N: R6.2, TP2.1, U26.4 (~FAULT)
HOST_OUT1: R2.2, U3.7 (OUT1), U24.2
HOST_OUT2: R3.2, U3.8 (OUT2)
HOST_PWR_OK: Q2.1 (G), R4.1, TP1.1, U24.4, U26.3 (EN)
HOST_VDET: R1.2, U3.4 (VBUS_DET)
U1_1V8_HOST: C114.1, L4.2, R114.1; also elsewhere on the board
VBUS_HOST: C1.1, C2.1, C62.1, C113.1, D1.1 (K), J1.A4 (VBUS), J1.A9 (VBUS), J1.B4 (VBUS), J1.B9 (VBUS), R1.1, U2.5 (VBUS), U22.1 (IN), U22.3 (EN), U26.1 (IN), U45.1 (EN), U45.4 (VIN); also elsewhere on the board

Notes on the sheet:
Host USB-C input and current qualification
USB 2.0 / 480 Mbps | Rev C electrical design | Placed PCB; all routing by Alex; hardware tests pending
Host connector and ESD
CC current qualification: 1.5 A or 3 A required
Isolated-converter input protection
Efficient host-core supply: 1.8 V
Qualified-host indicator
Declared power origins

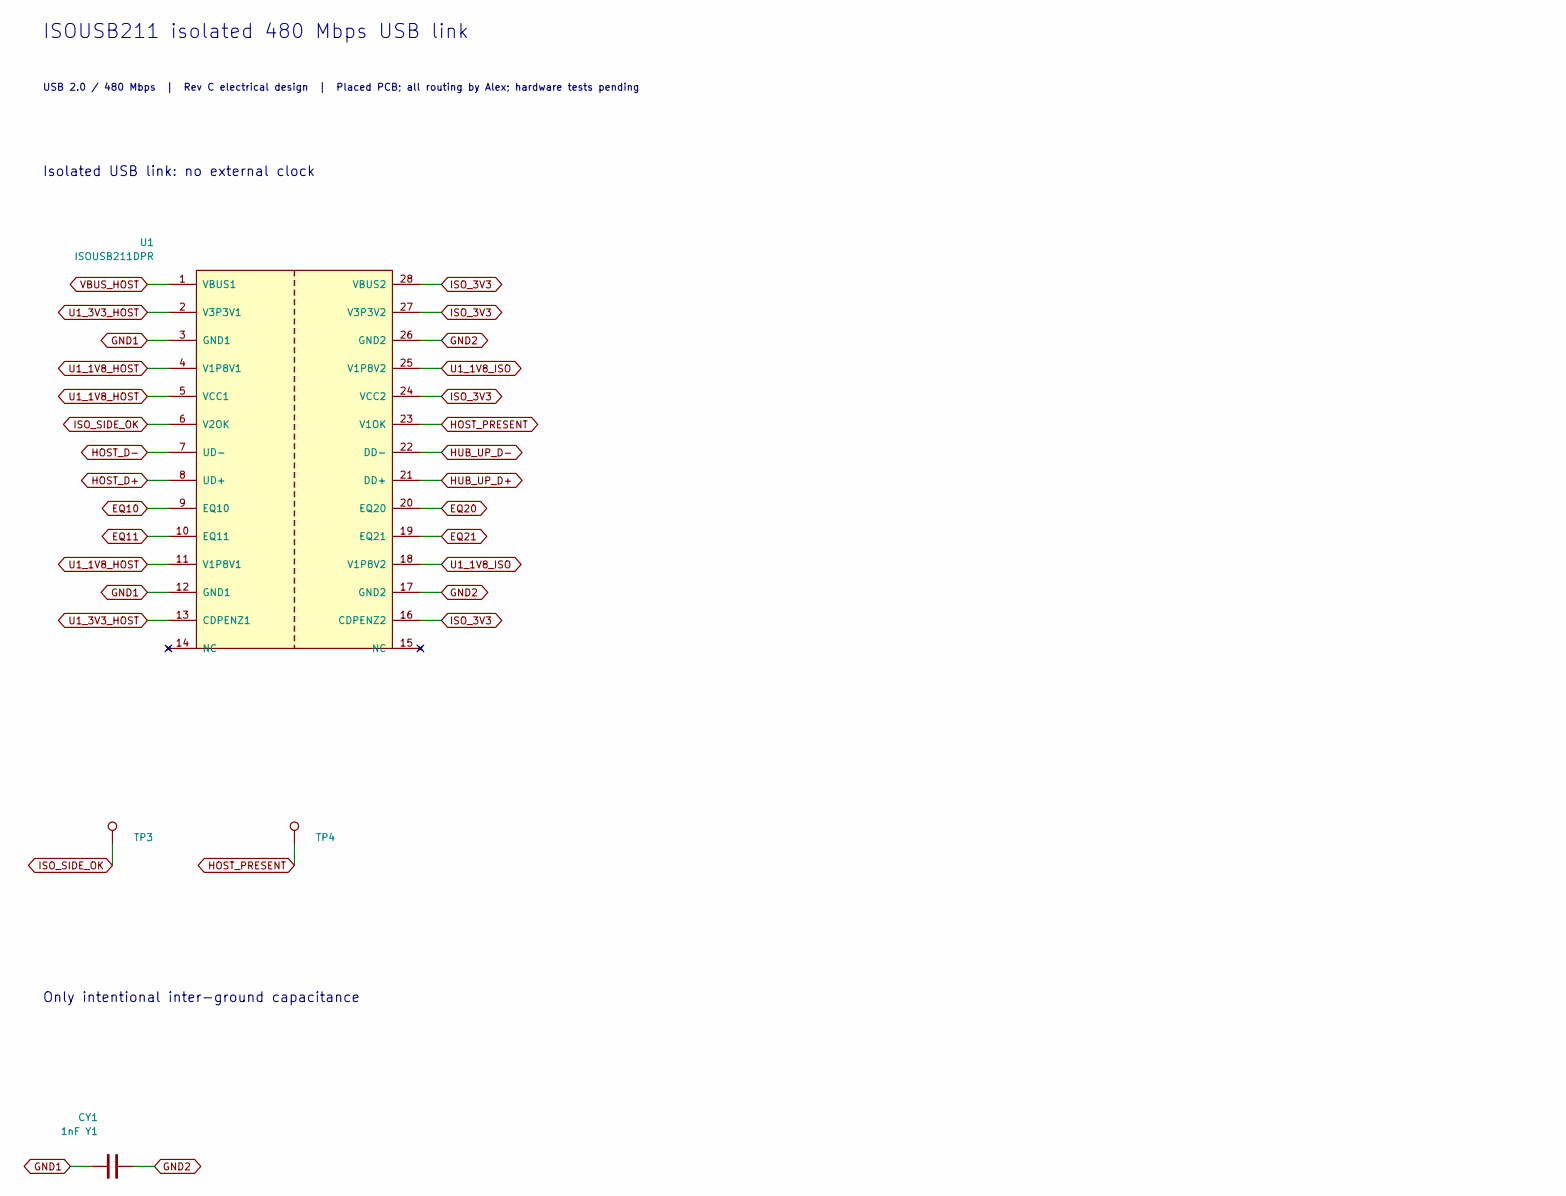
[picture p31: schematic hub-isolation.kicad_sch, ISOUSB211 isolated 480 Mbps USB link, part in row 1, column 1]

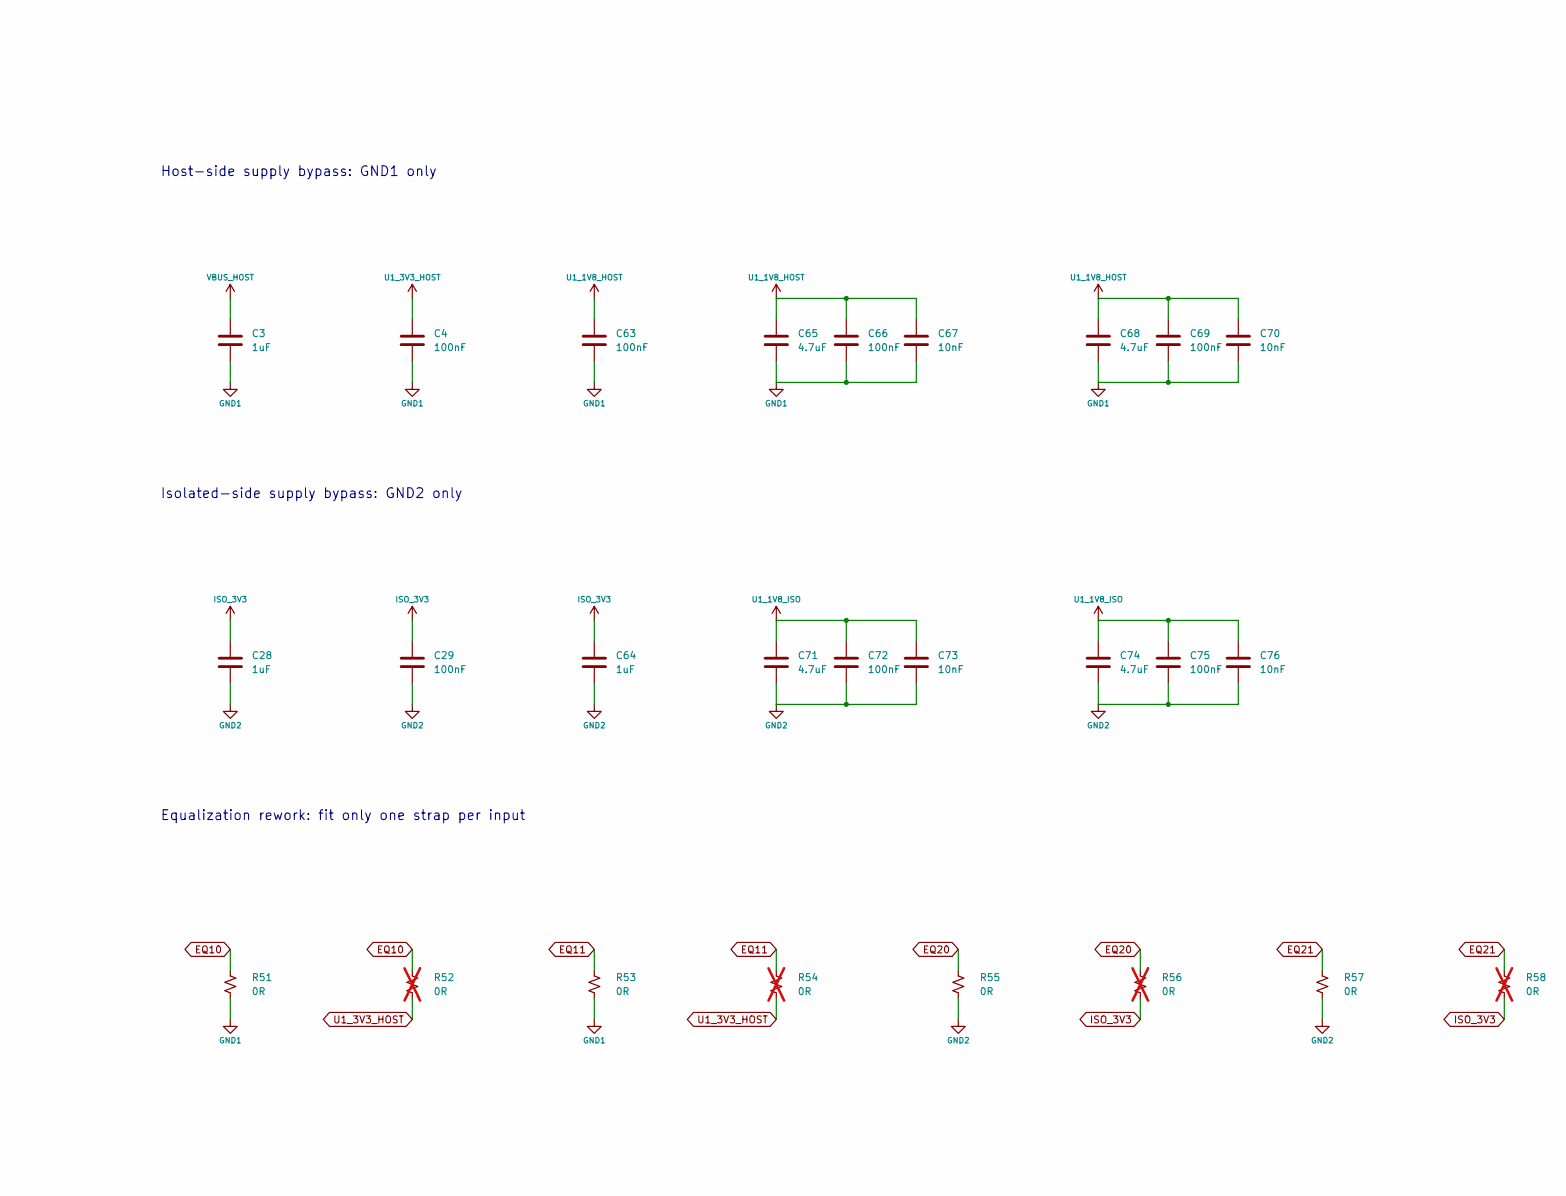
[picture p32: schematic hub-isolation.kicad_sch, ISOUSB211 isolated 480 Mbps USB link, part in row 1, column 2]

Parts:
C3, C28, C64: 1uF; C_0603_1608Metric; Ratings 25V X5R 10%; MPN GRM188R61E105KA12D; LCSC C77046
C4, C29, C63, C66, C69, C72, C75: 100nF; C_0402_1005Metric; Ratings 50V X7R 10%; MPN GRM155R71H104KE14D; LCSC C77020
C65, C68, C71, C74: 4.7uF; C_0603_1608Metric; Ratings 25V X5R 10%; MPN GRM188R61E475KE11D; LCSC C90057
C67, C70, C73, C76: 10nF; C_0402_1005Metric; Ratings 50V X7R 10%; MPN GRM155R71H103KA88D; LCSC C77019
CY1: 1nF Y1; C_Disc_D7.0mm_W5.5mm_P14.00mm; Ratings See exact manufacturer datasheet; MPN Q07F3Z102MA5B0S0N0; LCSC C2914611
R51, R53, R55, R57: 0R; R_0402_1005Metric; Ratings 0R jumper, 0402, 1A rated current; MPN ERJ2GE0R00X; LCSC C242160
R52, R54, R56, R58: 0R; R_0402_1005Metric; Ratings 0R jumper, 0402, 1A rated current; MPN ERJ2GE0R00X; LCSC C242160; not fitted
TP3: ISO_SIDE_OK; TestPoint_Pad_D1.0mm; Ratings Exposed test pad; no purchased part
TP4: HOST_PRESENT; TestPoint_Pad_D1.0mm; Ratings Exposed test pad; no purchased part
U1: ISOUSB211DPR; TI_DP0028A-C02_HV_SSOP28_8.2mm_Clearance; Ratings See exact manufacturer datasheet; MPN ISOUSB211DPR; LCSC C5772877

Connections:
EQ10: R51.1, R52.1, U1.9 (EQ10)
EQ11: R53.1, R54.1, U1.10 (EQ11)
EQ20: R55.1, R56.1, U1.20 (EQ20)
EQ21: R57.1, R58.1, U1.19 (EQ21)
GND1: C3.2, C4.2, C63.2, C65.2, C66.2, C67.2, C68.2, C69.2, C70.2, CY1.1, R51.2, R53.2, U1.3 (GND1), U1.12 (GND1); also elsewhere on the board
GND2: C28.2, C29.2, C64.2, C71.2, C72.2, C73.2, C74.2, C75.2, C76.2, CY1.2, R55.2, R57.2, U1.17 (GND2), U1.26 (GND2); also elsewhere on the board
HOST_D+: U1.8 (UD+); also elsewhere on the board
HOST_D-: U1.7 (UD-); also elsewhere on the board
HOST_PRESENT: TP4.1, U1.23 (V1OK); also elsewhere on the board
HUB_UP_D+: U1.21 (DD+); also elsewhere on the board
HUB_UP_D-: U1.22 (DD-); also elsewhere on the board
ISO_3V3: C28.1, C29.1, C64.1, R56.2, R58.2, U1.16 (CDPENZ2), U1.24 (VCC2), U1.27 (V3P3V2), U1.28 (VBUS2); also elsewhere on the board
ISO_SIDE_OK: TP3.1, U1.6 (V2OK)
U1_1V8_HOST: C63.1, C65.1, C66.1, C67.1, C68.1, C69.1, C70.1, U1.4 (V1P8V1), U1.5 (VCC1), U1.11 (V1P8V1); also elsewhere on the board
U1_1V8_ISO: C71.1, C72.1, C73.1, C74.1, C75.1, C76.1, U1.18 (V1P8V2), U1.25 (V1P8V2)
U1_3V3_HOST: C4.1, R52.2, R54.2, U1.2 (V3P3V1), U1.13 (CDPENZ1)
VBUS_HOST: C3.1, U1.1 (VBUS1); also elsewhere on the board

Notes on the sheet:
ISOUSB211 isolated 480 Mbps USB link
USB 2.0 / 480 Mbps | Rev C electrical design | Placed PCB; all routing by Alex; hardware tests pending
Isolated USB link: no external clock
Host-side supply bypass: GND1 only
Isolated-side supply bypass: GND2 only
Equalization rework: fit only one strap per input
Only intentional inter-ground capacitance

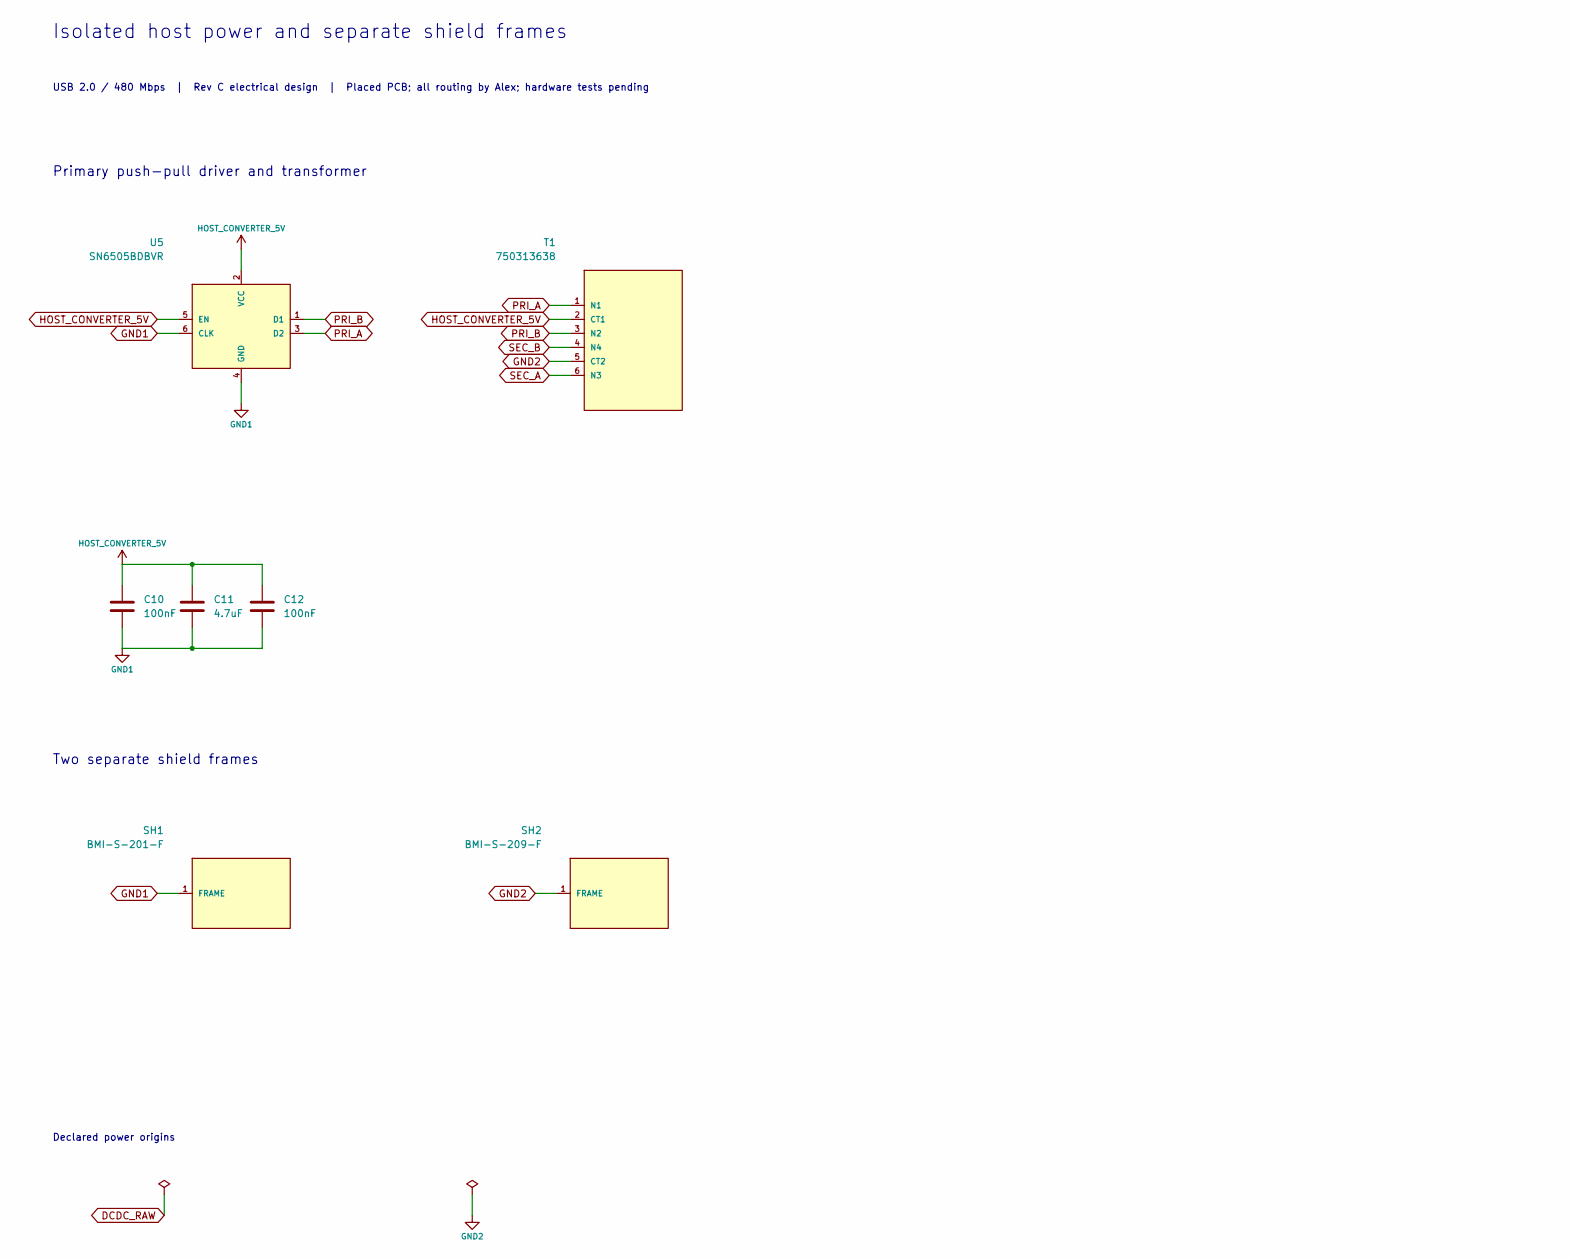
[picture p33: schematic hub-converter.kicad_sch, Isolated host power and separate shield frames, part in row 1, column 1]

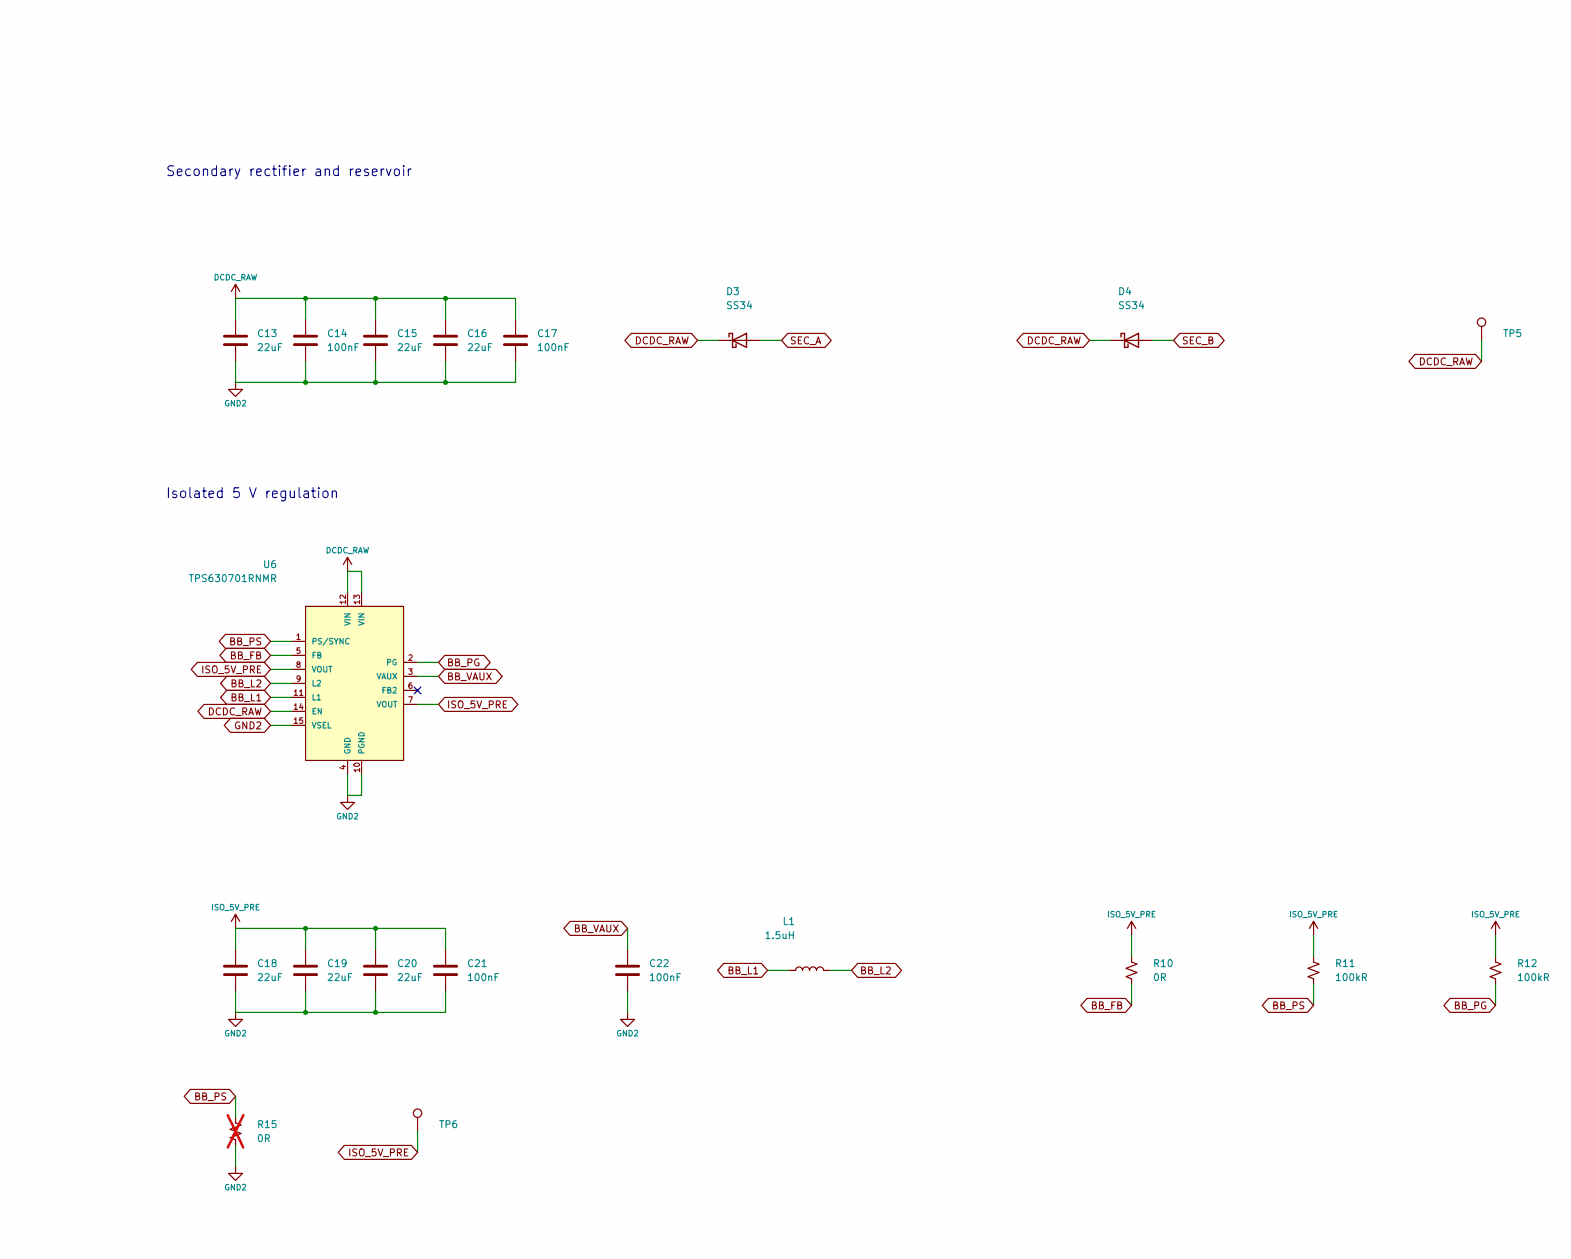
[picture p34: schematic hub-converter.kicad_sch, Isolated host power and separate shield frames, part in row 1, column 2]

Parts:
C10, C12, C14, C17, C21, C22: 100nF; C_0402_1005Metric; Ratings 50V X7R 10%; MPN GRM155R71H104KE14D; LCSC C77020
C11: 4.7uF; C_0603_1608Metric; Ratings 25V X5R 10%; MPN GRM188R61E475KE11D; LCSC C90057
C13, C15, C16, C18, C19, C20: 22uF; C_1210_3225Metric; Ratings 25V X7R 10%; MPN GRM32ER71E226KE15L; LCSC C21397
D3, D4: SS34; D_SMA; Ratings See exact manufacturer datasheet; MPN SS34; LCSC C8678
L1: 1.5uH; Coilcraft_XFL4020_4x4mm; Ratings See exact manufacturer datasheet; MPN XFL4020-152MEC; LCSC C3033018
R10: 0R; R_0402_1005Metric; Ratings 0R jumper, 0402, 1A rated current; MPN ERJ2GE0R00X; LCSC C242160
R11, R12: 100kR; R_0402_1005Metric; Ratings 1%, 0.1W, 50V; MPN ERJ2RKF1003X; LCSC C192169
R15: 0R; R_0402_1005Metric; Ratings 0R jumper, 0402, 1A rated current; MPN ERJ2GE0R00X; LCSC C242160; not fitted
SH1: BMI-S-201-F; Laird_Technologies_BMI-S-201-F_13.66x12.70mm; Ratings Separate grounded frame; removable BMI-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; MPN BMI-S-201-F
SH2: BMI-S-209-F; Laird_Technologies_BMI-S-209-F_29.36x18.50mm; Ratings Separate grounded frame; removable BMI-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; MPN BMI-S-209-F
T1: 750313638; WE_750313638; Ratings See exact manufacturer datasheet; MPN 750313638
TP5: DCDC_RAW; TestPoint_Pad_D1.0mm; Ratings Exposed test pad; no purchased part
TP6: ISO_5V_PRE; TestPoint_Pad_D1.0mm; Ratings Exposed test pad; no purchased part
U5: SN6505BDBVR; SOT-23-6; Ratings See exact manufacturer datasheet; MPN SN6505BDBVR; LCSC C74518
U6: TPS630701RNMR; TPS630701RNM_VQFN-HR-15; Ratings See exact manufacturer datasheet; MPN TPS630701RNMR; LCSC C2876599

Connections:
BB_FB: R10.2, U6.5 (FB)
BB_L1: L1.1, U6.11 (L1)
BB_L2: L1.2, U6.9 (L2)
BB_PG: R12.2, U6.2 (PG)
BB_PS: R11.2, R15.1, U6.1 (PS/SYNC)
BB_VAUX: C22.1, U6.3 (VAUX)
DCDC_RAW: C13.1, C14.1, C15.1, C16.1, C17.1, D3.1 (K), D4.1 (K), TP5.1, U6.12 (VIN), U6.13 (VIN), U6.14 (EN)
GND1: C10.2, C11.2, C12.2, SH1.1 (FRAME), U5.4 (GND), U5.6 (CLK); also elsewhere on the board
GND2: C13.2, C14.2, C15.2, C16.2, C17.2, C18.2, C19.2, C20.2, C21.2, C22.2, R15.2, SH2.1 (FRAME), T1.5 (CT2), U6.4 (GND), U6.10 (PGND), U6.15 (VSEL); also elsewhere on the board
HOST_CONVERTER_5V: C10.1, C11.1, C12.1, T1.2 (CT1), U5.2 (VCC), U5.5 (EN); also elsewhere on the board
ISO_5V_PRE: C18.1, C19.1, C20.1, C21.1, R10.1, R11.1, R12.1, TP6.1, U6.7 (VOUT), U6.8 (VOUT); also elsewhere on the board
PRI_A: T1.1 (N1), U5.3 (D2)
PRI_B: T1.3 (N2), U5.1 (D1)
SEC_A: D3.2 (A), T1.6 (N3)
SEC_B: D4.2 (A), T1.4 (N4)

Notes on the sheet:
Isolated host power and separate shield frames
USB 2.0 / 480 Mbps | Rev C electrical design | Placed PCB; all routing by Alex; hardware tests pending
Primary push-pull driver and transformer
Secondary rectifier and reservoir
Isolated 5 V regulation
Two separate shield frames
Declared power origins
