alxgmpr/adum4165-isolator/hub.kicad_pcb

## KiCad design hub.kicad_pcb (continued)

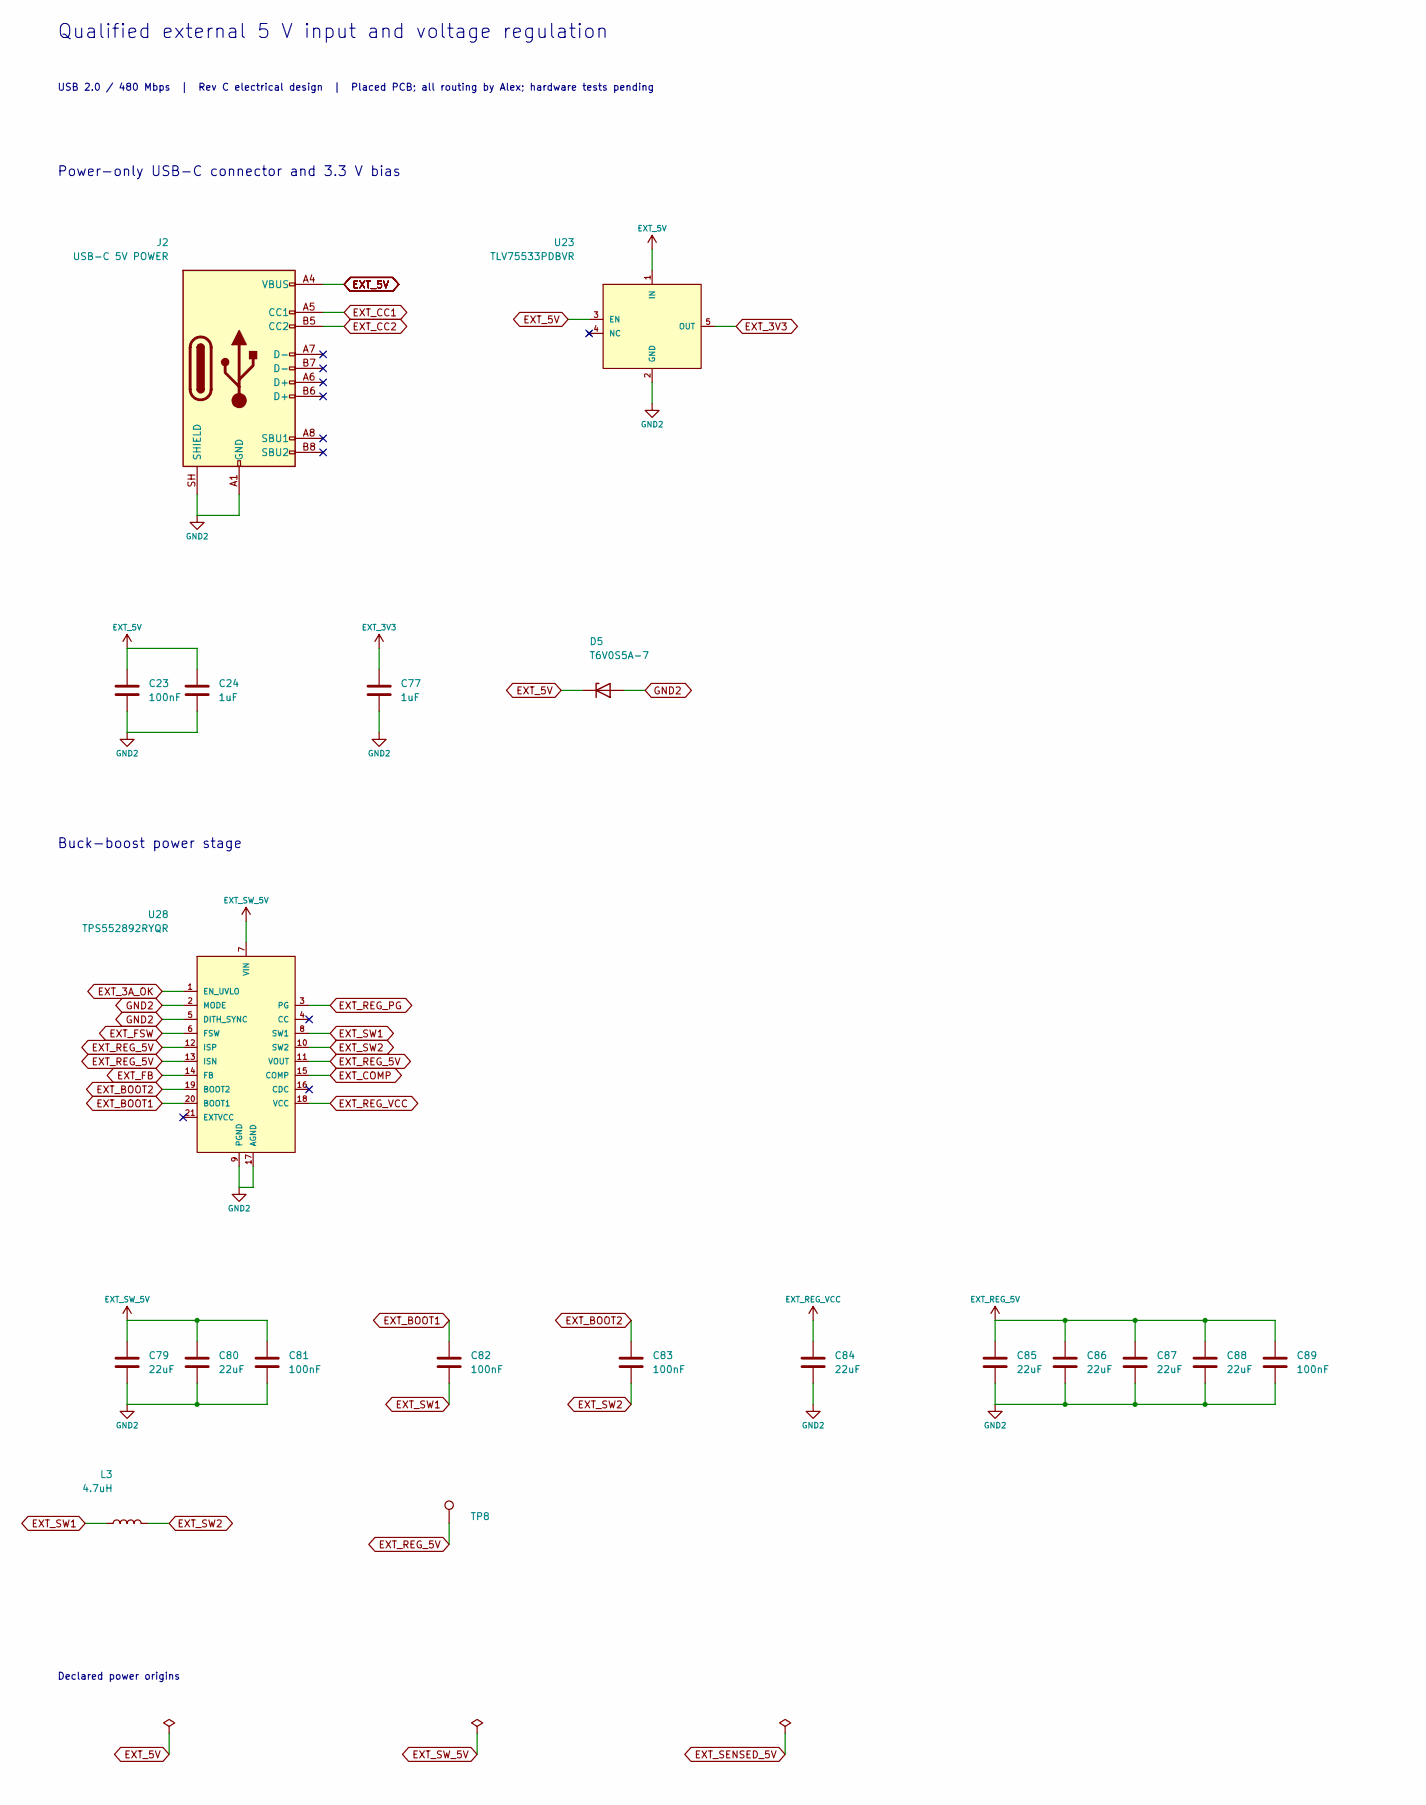
[picture p35: schematic hub-external.kicad_sch, Qualified external 5 V input and voltage regulation, part in row 1, column 1]

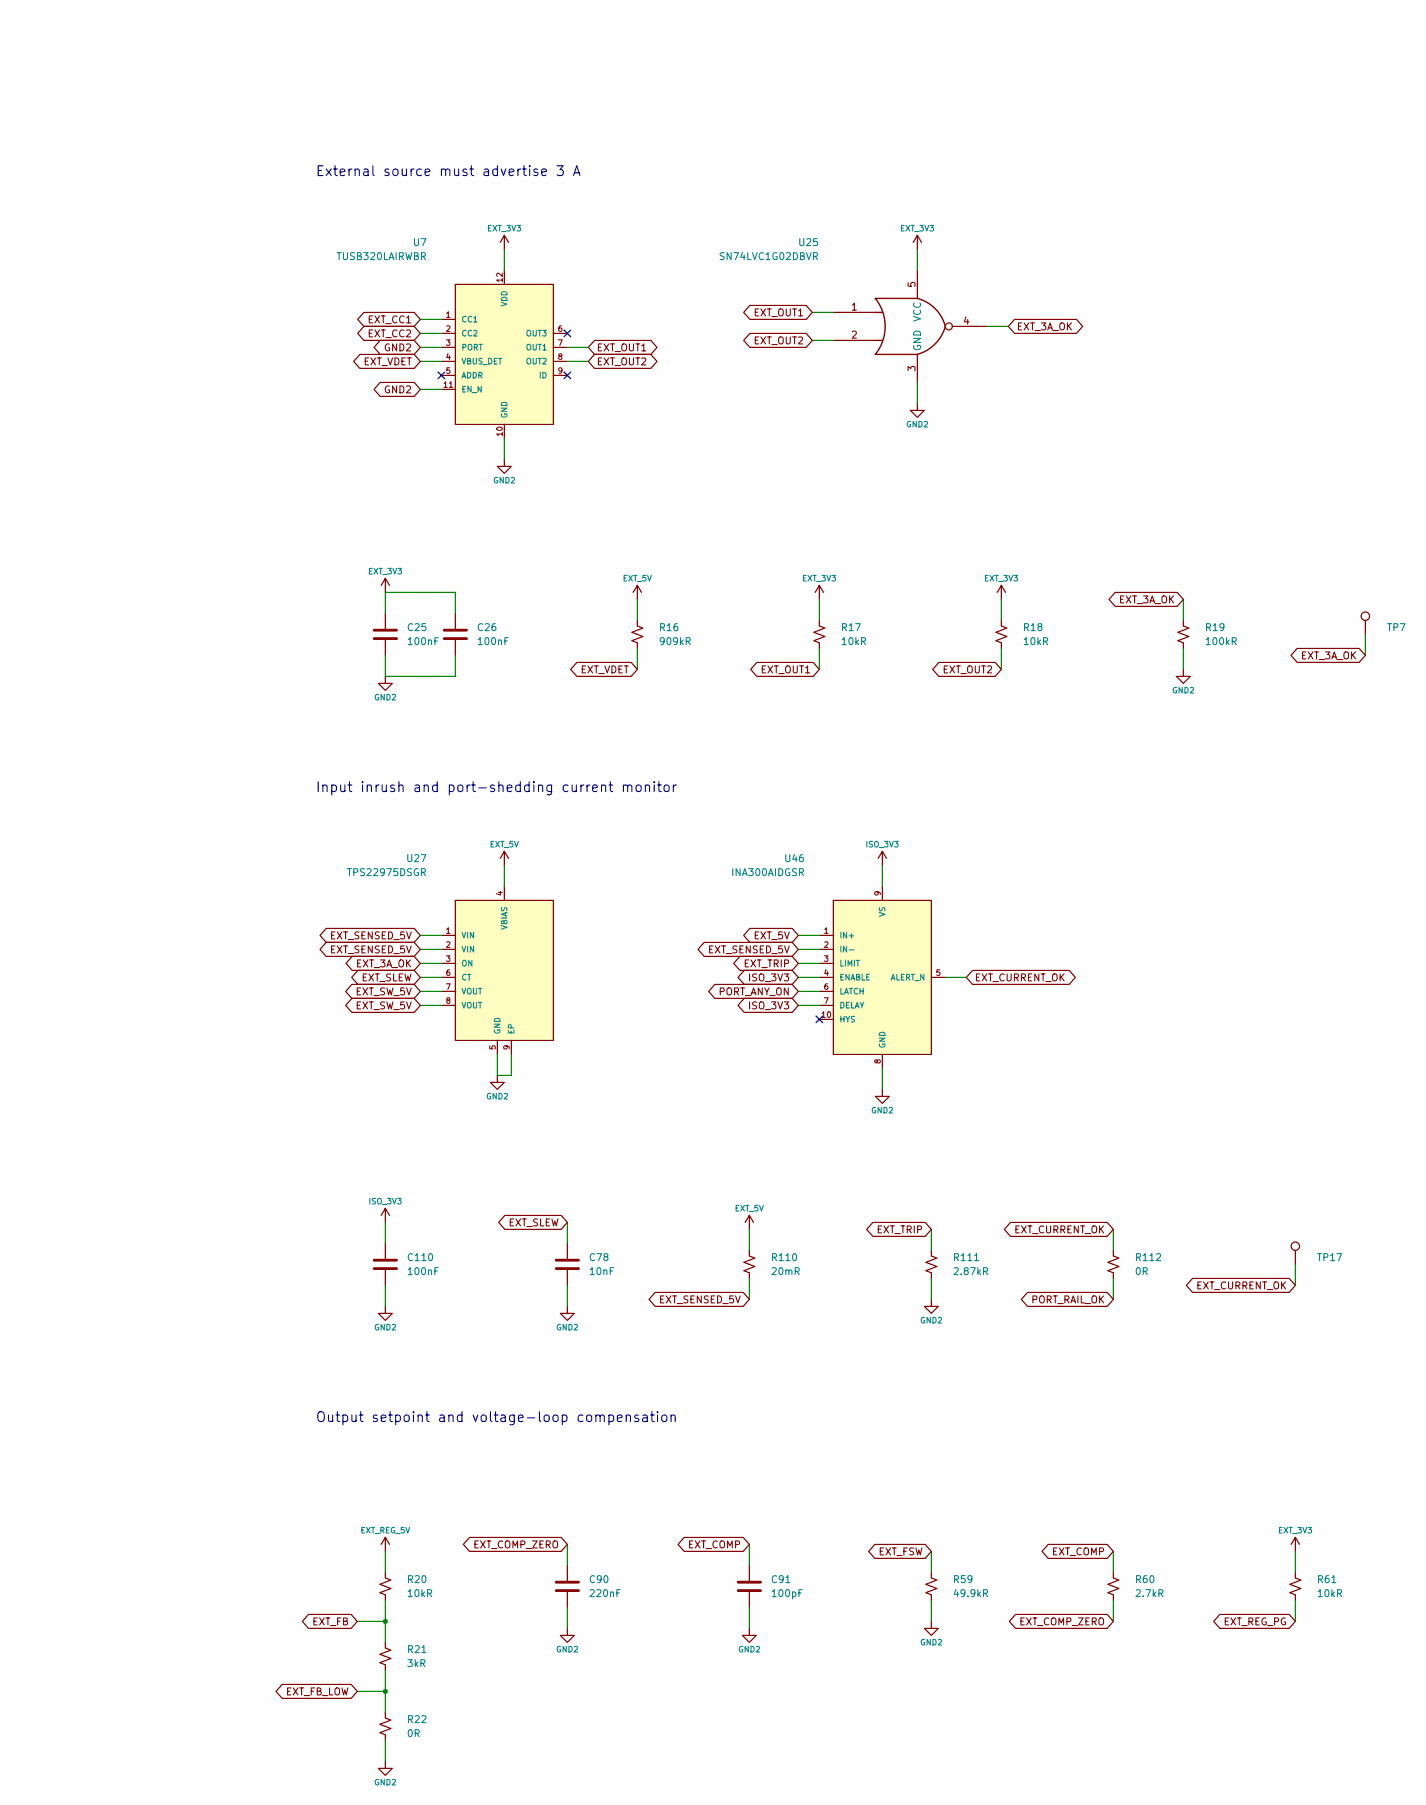
[picture p36: schematic hub-external.kicad_sch, Qualified external 5 V input and voltage regulation, part in row 1, column 2]

Parts:
C23, C25, C26, C81, C82, C83, C89, C110: 100nF; C_0402_1005Metric; Ratings 50V X7R 10%; MPN GRM155R71H104KE14D; LCSC C77020
C24, C77: 1uF; C_0603_1608Metric; Ratings 25V X5R 10%; MPN GRM188R61E105KA12D; LCSC C77046
C78: 10nF; C_0402_1005Metric; Ratings 50V X7R 10%; MPN GRM155R71H103KA88D; LCSC C77019
C79, C80, C84, C85, C86, C87, C88: 22uF; C_1210_3225Metric; Ratings 25V X7R 10%; MPN GRM32ER71E226KE15L; LCSC C21397
C90: 220nF; C_0402_1005Metric; Ratings 16V X7R 10%; MPN GRM155R71C224KA12D; LCSC C77011
C91: 100pF; C_0402_1005Metric; Ratings 50V C0G 5%; MPN GRM1555C1H101JA01D; LCSC C77177
D5: T6V0S5A-7; D_SOD-523; Ratings See exact manufacturer datasheet; MPN T6V0S5A-7; LCSC C19950551
J2: USB-C 5V POWER; USB_C_Receptacle_HRO_TYPE-C-31-M-12; Ratings See exact manufacturer datasheet; MPN TYPE-C-31-M-12; LCSC C165948
L3: 4.7uH; L_Coilcraft_XAL7070-XXX; Ratings See exact manufacturer datasheet; MPN XAL7070-472MEC; LCSC C3911513
R16: 909kR; R_0402_1005Metric; Ratings 1%, 0.1W, 50V; MPN ERJ2RKF9093X; LCSC C2085054
R17, R18, R61: 10kR; R_0402_1005Metric; Ratings 1%, 0.1W, 50V; MPN ERJ2RKF1002X; LCSC C191123
R19: 100kR; R_0402_1005Metric; Ratings 1%, 0.1W, 50V; MPN ERJ2RKF1003X; LCSC C192169
R20: 10kR; R_0603_1608Metric; Ratings 0.1%, 10ppm/C thin film, 0.1W; MPN RT0603BRB0710KL; LCSC C860067
R21: 3kR; R_0603_1608Metric; Ratings 0.1%, 10ppm/C thin film, 0.1W; MPN RT0603BRB073KL; LCSC C860379
R22, R112: 0R; R_0402_1005Metric; Ratings 0R jumper, 0402, 1A rated current; MPN ERJ2GE0R00X; LCSC C242160
R59: 49.9kR; R_0402_1005Metric; Ratings 1%, 0.1W, 50V; MPN ERJ2RKF4992X; LCSC C409918
R60: 2.7kR; R_0402_1005Metric; Ratings 1%, 0.1W, 50V; MPN ERJ2RKF2701X; LCSC C413089
R110: 20mR; R_1206_3216Metric; Ratings 1W, 1%, 75ppm/C; Kelvin sense; MPN WSLP1206R0200FEA; LCSC C441558
R111: 2.87kR; R_0603_1608Metric; Ratings 0.1%, 25ppm/C thin film, 0.1W; MPN RT0603BRD072K87L; LCSC C861305
TP7: EXT_3A_OK; TestPoint_Pad_D1.0mm; Ratings Exposed test pad; no purchased part
TP8: EXT_REG_5V; TestPoint_Pad_D1.0mm; Ratings Exposed test pad; no purchased part
TP17: EXT_CURRENT_OK; TestPoint_Pad_D1.0mm; Ratings Exposed test pad; no purchased part
U7: TUSB320LAIRWBR; Texas_X2QFN-12_1.6x1.6mm_P0.4mm; Ratings See exact manufacturer datasheet; MPN TUSB320LAIRWBR; LCSC C132554
U23: TLV75533PDBVR; SOT-23-5; Ratings See exact manufacturer datasheet; MPN TLV75533PDBVR; LCSC C404027
U25: SN74LVC1G02DBVR; SOT-23-5; Ratings See exact manufacturer datasheet; MPN SN74LVC1G02DBVR; LCSC C16360
U27: TPS22975DSGR; Texas_DSG0008A_WSON-8-1EP_2x2mm_P0.5mm_EP0.9x1.6mm; Ratings See exact manufacturer datasheet; MPN TPS22975DSGR; LCSC C524777
U28: TPS552892RYQR; TI_RYQ0021A_VQFN21_3x5mm; Ratings See exact manufacturer datasheet; MPN TPS552892RYQR; LCSC C19272254
U46: INA300AIDGSR; MSOP-10_3x3mm_P0.5mm; Ratings See exact manufacturer datasheet; MPN INA300AIDGSR; LCSC C529558

Connections:
EXT_3A_OK: R19.1, TP7.1, U25.4, U27.3 (ON), U28.1 (EN_UVLO)
EXT_3V3: C25.1, C26.1, C77.1, R17.1, R18.1, R61.1, U7.12 (VDD), U23.5 (OUT), U25.5 (VCC)
EXT_5V: C23.1, C24.1, D5.1 (K), J2.A4 (VBUS), J2.A9 (VBUS), J2.B4 (VBUS), J2.B9 (VBUS), R16.1, R110.1, U23.1 (IN), U23.3 (EN), U27.4 (VBIAS), U46.1 (IN+)
EXT_BOOT1: C82.1, U28.20 (BOOT1)
EXT_BOOT2: C83.1, U28.19 (BOOT2)
EXT_CC1: J2.A5 (CC1), U7.1 (CC1)
EXT_CC2: J2.B5 (CC2), U7.2 (CC2)
EXT_COMP: C91.1, R60.1, U28.15 (COMP)
EXT_COMP_ZERO: C90.1, R60.2
EXT_CURRENT_OK: R112.1, TP17.1, U46.5 (ALERT_N)
EXT_FB: R20.2, R21.1, U28.14 (FB)
EXT_FB_LOW: R21.2, R22.1
EXT_FSW: R59.1, U28.6 (FSW)
EXT_OUT1: R17.2, U7.7 (OUT1), U25.1
EXT_OUT2: R18.2, U7.8 (OUT2), U25.2
EXT_REG_5V: C85.1, C86.1, C87.1, C88.1, C89.1, R20.1, TP8.1, U28.11 (VOUT), U28.12 (ISP), U28.13 (ISN); also elsewhere on the board
EXT_REG_PG: R61.2, U28.3 (PG)
EXT_REG_VCC: C84.1, U28.18 (VCC)
EXT_SENSED_5V: R110.2, U27.1 (VIN), U27.2 (VIN), U46.2 (IN-)
EXT_SLEW: C78.1, U27.6 (CT)
EXT_SW1: C82.2, L3.1, U28.8 (SW1)
EXT_SW2: C83.2, L3.2, U28.10 (SW2)
EXT_SW_5V: C79.1, C80.1, C81.1, U27.7 (VOUT), U27.8 (VOUT), U28.7 (VIN)
EXT_TRIP: R111.1, U46.3 (LIMIT)
EXT_VDET: R16.2, U7.4 (VBUS_DET)
GND2: C23.2, C24.2, C25.2, C26.2, C77.2, C78.2, C79.2, C80.2, C81.2, C84.2, C85.2, C86.2, C87.2, C88.2, C89.2, C90.2, C91.2, C110.2, D5.2 (A), J2.A1 (GND), J2.A12 (GND), J2.B1 (GND), J2.B12 (GND), J2.SH (SHIELD), R19.2, R22.2, R59.2, R111.2, U7.3 (PORT), U7.10 (GND), U7.11 (EN_N), U23.2 (GND), U25.3 (GND), U27.5 (GND), U27.9 (EP), U28.2 (MODE), U28.5 (DITH_SYNC), U28.9 (PGND), U28.17 (AGND), U46.8 (GND); also elsewhere on the board
ISO_3V3: C110.1, U46.4 (ENABLE), U46.7 (DELAY), U46.9 (VS); also elsewhere on the board
PORT_ANY_ON: U46.6 (LATCH); also elsewhere on the board
PORT_RAIL_OK: R112.2; also elsewhere on the board

Notes on the sheet:
Qualified external 5 V input and voltage regulation
USB 2.0 / 480 Mbps | Rev C electrical design | Placed PCB; all routing by Alex; hardware tests pending
Power-only USB-C connector and 3.3 V bias
External source must advertise 3 A
Input inrush and port-shedding current monitor
Buck-boost power stage
Output setpoint and voltage-loop compensation
Declared power origins

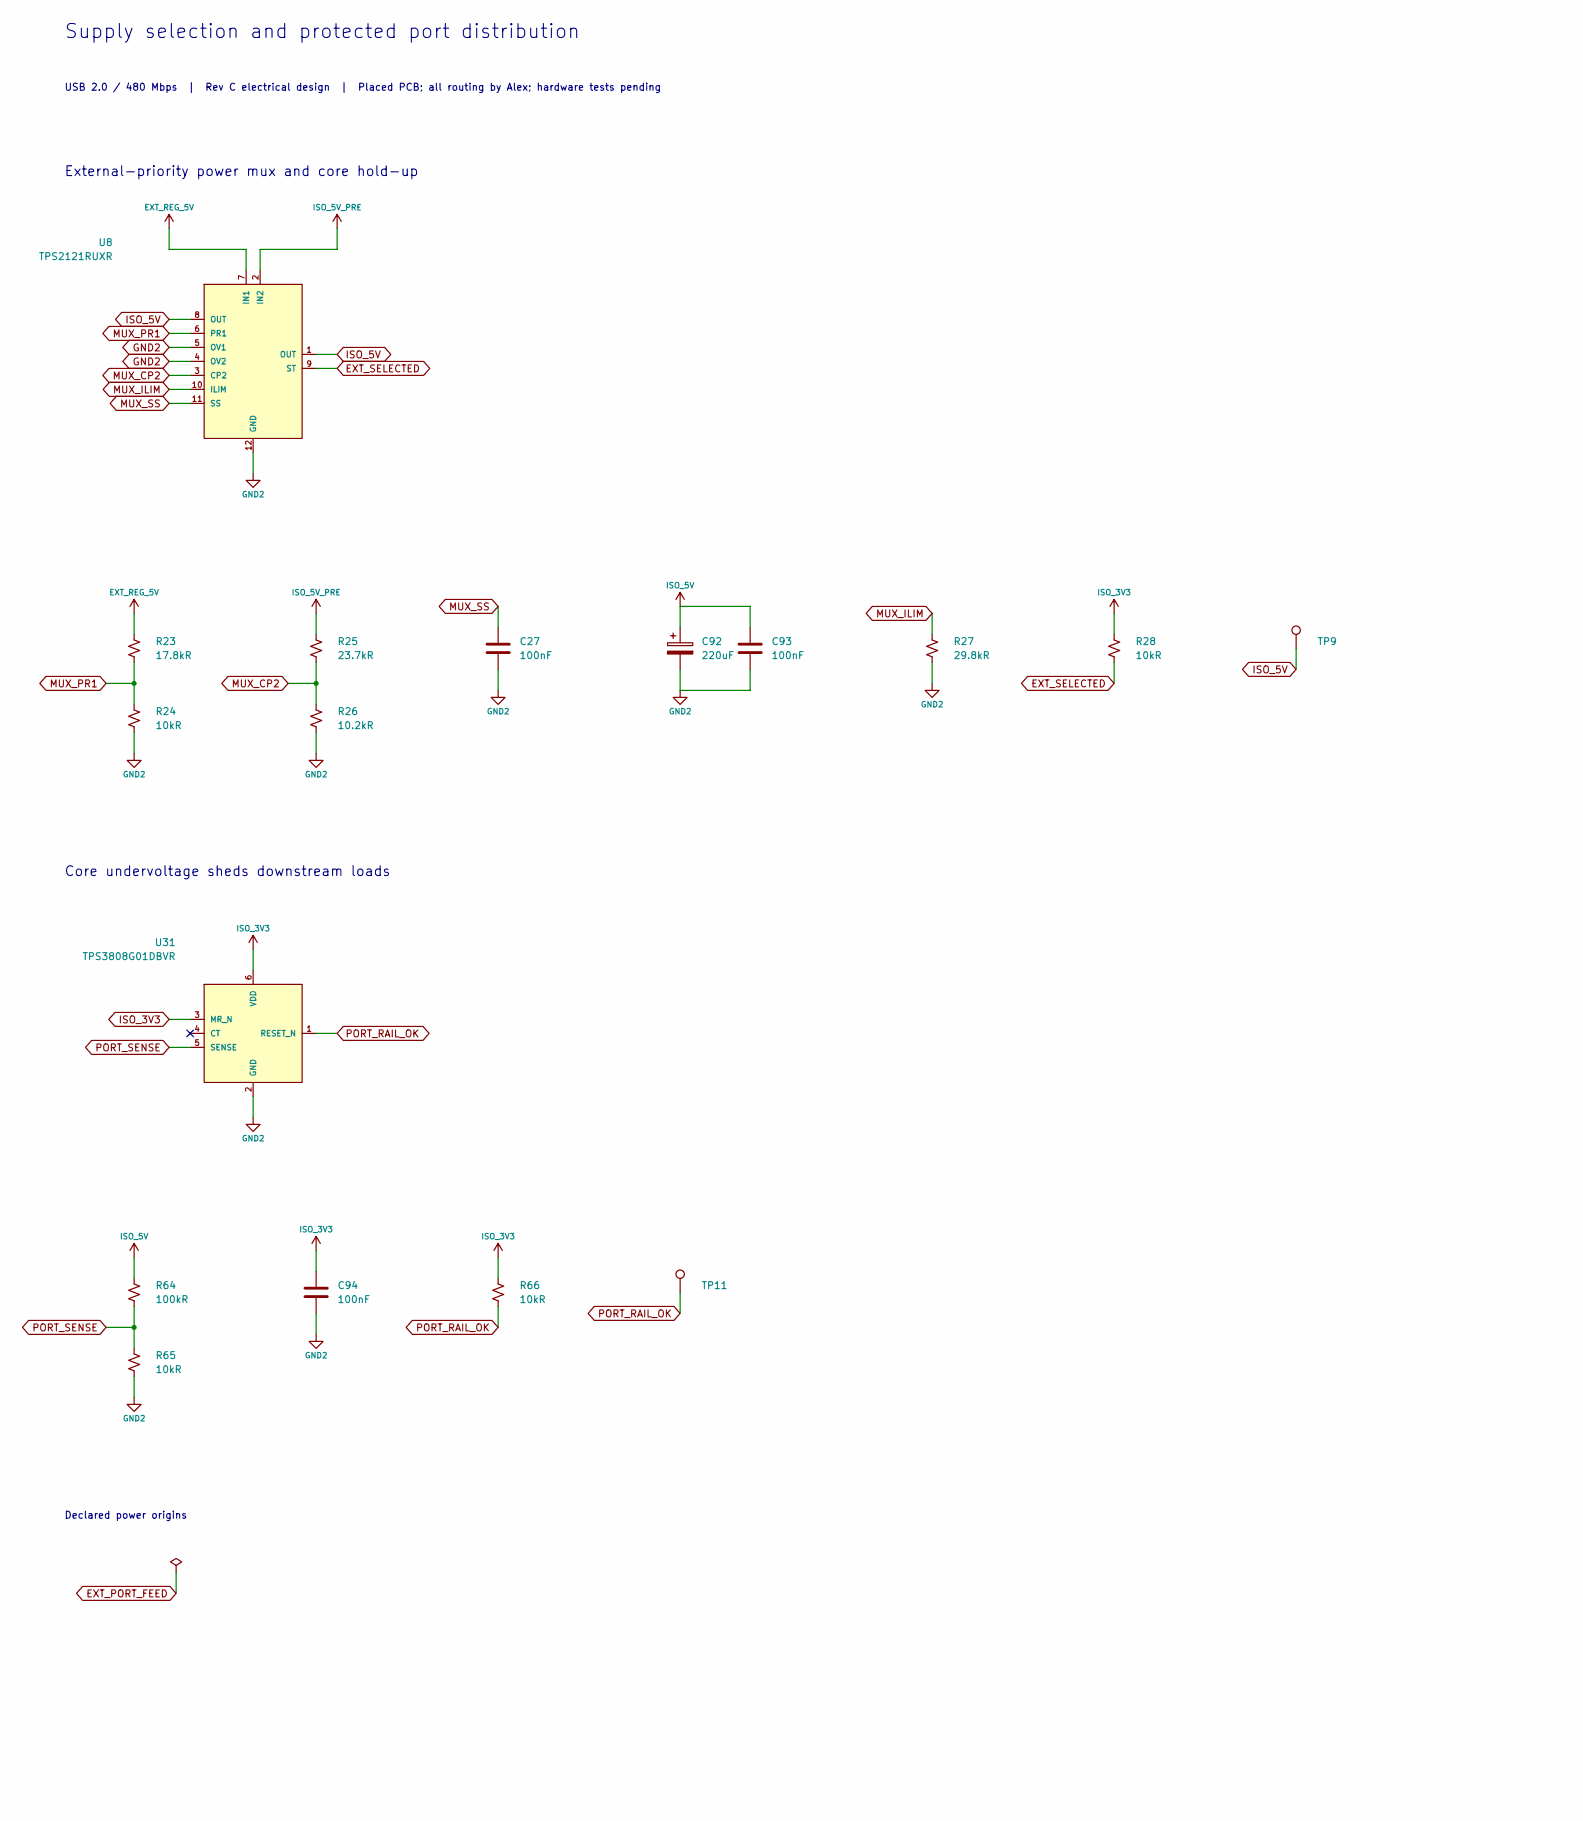
[picture p37: schematic hub-distribution.kicad_sch, Supply selection and protected port distribution, part in row 1, column 1]

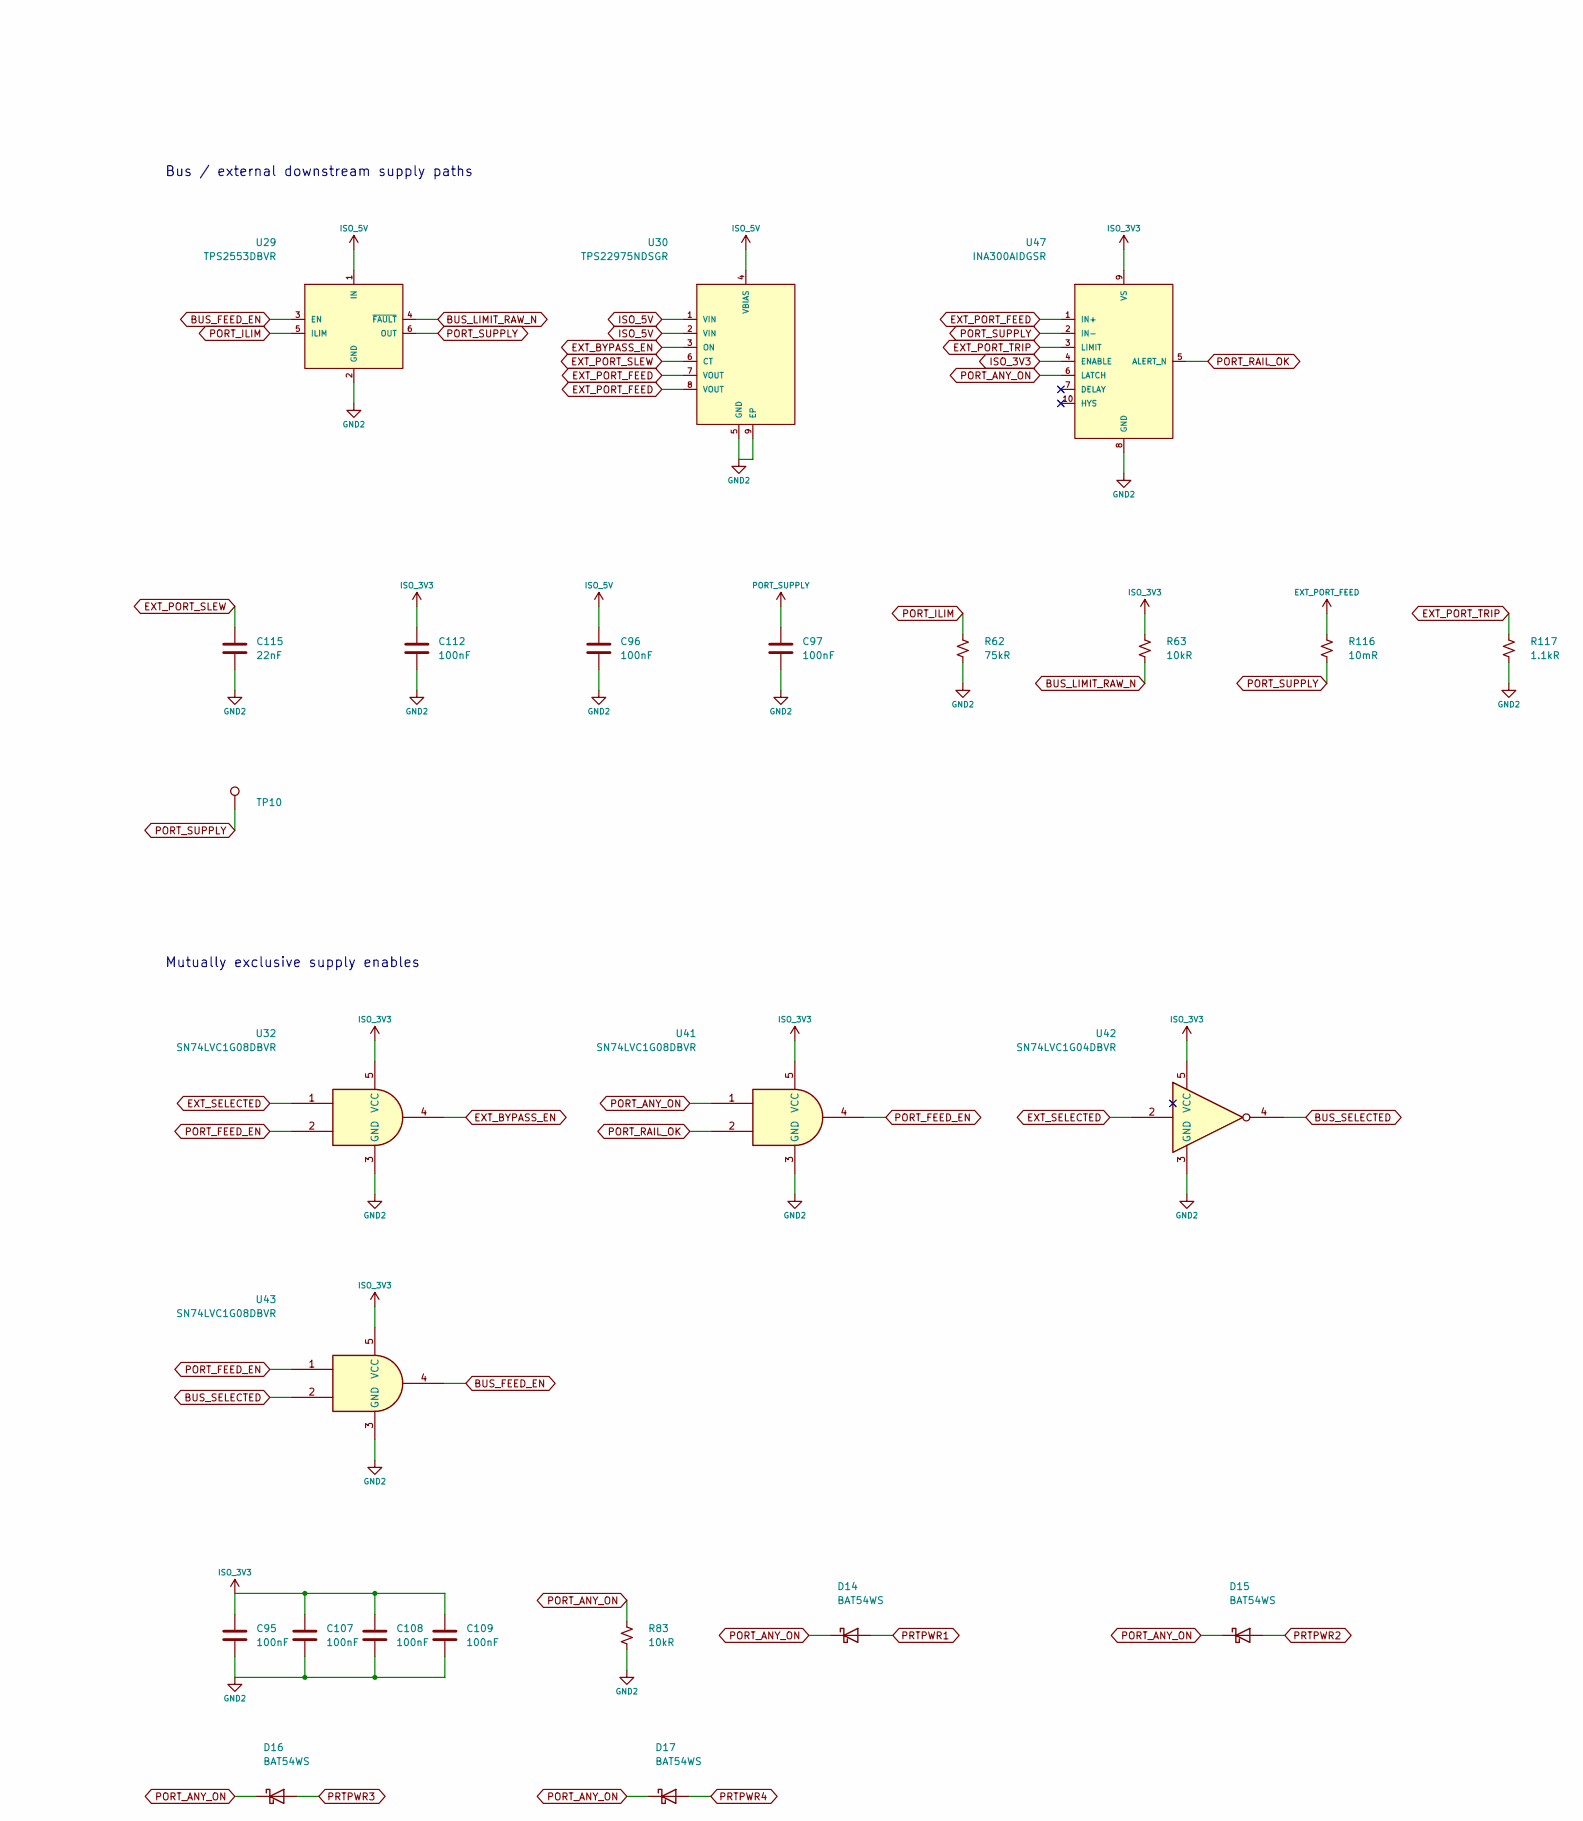
[picture p38: schematic hub-distribution.kicad_sch, Supply selection and protected port distribution, part in row 1, column 2]

Parts:
C27, C93, C94, C95, C96, C97, C107, C108, C109, C112: 100nF; C_0402_1005Metric; Ratings 50V X7R 10%; MPN GRM155R71H104KE14D; LCSC C77020
C92: 220uF; CP_Elec_8x6.2; Ratings 220uF 10V +/-20%; 8mm diameter, 6.5mm m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; MPN EEEFK1A221P; LCSC C401648
C115: 22nF; C_0402_1005Metric; Ratings 50V X7R 10%; MPN GRM155R71H223KA12D; LCSC C77023
D14, D15, D16, D17: BAT54WS; D_SOD-323; Ratings See exact manufacturer datasheet; MPN BAT54WS-7-F; LCSC C124205
R23: 17.8kR; R_0402_1005Metric; Ratings 1%, 0.1W, 50V; MPN ERJ2RKF1782X
R24, R28, R63, R66, R83: 10kR; R_0402_1005Metric; Ratings 1%, 0.1W, 50V; MPN ERJ2RKF1002X; LCSC C191123
R25: 23.7kR; R_0402_1005Metric; Ratings 1%, 0.1W, 50V; MPN ERJ2RKF2372X
R26: 10.2kR; R_0402_1005Metric; Ratings 1%, 0.1W, 50V; MPN ERJ2RKF1022X; LCSC C2076944
R27: 29.8kR; R_0402_1005Metric; Ratings 1%, 0.1W, 50V; MPN ERJ2RKF2982X
R62: 75kR; R_0402_1005Metric; Ratings 1%, 0.1W, 50V; MPN ERJ2RKF7502X; LCSC C413105
R64: 100kR; R_0603_1608Metric; Ratings 0.1%, 10ppm/C thin film, 0.1W; MPN RT0603BRB07100KL; LCSC C860056
R65: 10kR; R_0603_1608Metric; Ratings 0.1%, 10ppm/C thin film, 0.1W; MPN RT0603BRB0710KL; LCSC C860067
R116: 10mR; R_1206_3216Metric; Ratings 1W, 1%, 75ppm/C; Kelvin sense; MPN WSLP1206R0100FEA; LCSC C844910
R117: 1.1kR; R_0603_1608Metric; Ratings 0.1%, 10ppm/C thin film, 0.1W; MPN RT0603BRB071K1L; LCSC C860186
TP9: ISO_5V; TestPoint_Pad_D1.0mm; Ratings Exposed test pad; no purchased part
TP10: PORT_SUPPLY; TestPoint_Pad_D1.0mm; Ratings Exposed test pad; no purchased part
TP11: PORT_RAIL_OK; TestPoint_Pad_D1.0mm; Ratings Exposed test pad; no purchased part
U8: TPS2121RUXR; TI_RUX0012A_VQFN-HR12_2x2.5mm; Ratings See exact manufacturer datasheet; MPN TPS2121RUXR; LCSC C485916
U29: TPS2553DBVR; SOT-23-6; Ratings See exact manufacturer datasheet; MPN TPS2553DBVR; LCSC C55266
U30: TPS22975NDSGR; Texas_DSG0008A_WSON-8-1EP_2x2mm_P0.5mm_EP0.9x1.6mm; Ratings See exact manufacturer datasheet; MPN TPS22975NDSGR; LCSC C2149871
U31: TPS3808G01DBVR; SOT-23-6; Ratings See exact manufacturer datasheet; MPN TPS3808G01DBVR; LCSC C19653
U32, U41, U43: SN74LVC1G08DBVR; SOT-23-5; Ratings See exact manufacturer datasheet; MPN SN74LVC1G08DBVR; LCSC C7666
U42: SN74LVC1G04DBVR; SOT-23-5; Ratings See exact manufacturer datasheet; MPN SN74LVC1G04DBVR; LCSC C7827
U47: INA300AIDGSR; MSOP-10_3x3mm_P0.5mm; Ratings See exact manufacturer datasheet; MPN INA300AIDGSR; LCSC C529558

Connections:
BUS_FEED_EN: U29.3 (EN), U43.4
BUS_LIMIT_RAW_N: R63.2, U29.4 (~FAULT); also elsewhere on the board
BUS_SELECTED: U42.4, U43.2
EXT_BYPASS_EN: U30.3 (ON), U32.4
EXT_PORT_FEED: R116.1, U30.7 (VOUT), U30.8 (VOUT), U47.1 (IN+)
EXT_PORT_SLEW: C115.1, U30.6 (CT)
EXT_PORT_TRIP: R117.1, U47.3 (LIMIT)
EXT_REG_5V: R23.1, U8.7 (IN1); also elsewhere on the board
EXT_SELECTED: R28.2, U8.9 (ST), U32.1, U42.2; also elsewhere on the board
GND2: C27.2, C92.2, C93.2, C94.2, C95.2, C96.2, C97.2, C107.2, C108.2, C109.2, C112.2, C115.2, R24.2, R26.2, R27.2, R62.2, R65.2, R83.2, R117.2, U8.4 (OV2), U8.5 (OV1), U8.12 (GND), U29.2 (GND), U30.5 (GND), U30.9 (EP), U31.2 (GND), U32.3 (GND), U41.3 (GND), U42.3 (GND), U43.3 (GND), U47.8 (GND); also elsewhere on the board
ISO_3V3: C94.1, C95.1, C107.1, C108.1, C109.1, C112.1, R28.1, R63.1, R66.1, U31.3 (MR_N), U31.6 (VDD), U32.5 (VCC), U41.5 (VCC), U42.5 (VCC), U43.5 (VCC), U47.4 (ENABLE), U47.9 (VS); also elsewhere on the board
ISO_5V: C92.1, C93.1, C96.1, R64.1, TP9.1, U8.1 (OUT), U8.8 (OUT), U29.1 (IN), U30.1 (VIN), U30.2 (VIN), U30.4 (VBIAS); also elsewhere on the board
ISO_5V_PRE: R25.1, U8.2 (IN2); also elsewhere on the board
MUX_CP2: R25.2, R26.1, U8.3 (CP2)
MUX_ILIM: R27.1, U8.10 (ILIM)
MUX_PR1: R23.2, R24.1, U8.6 (PR1)
MUX_SS: C27.1, U8.11 (SS)
PORT_ANY_ON: D14.1 (K), D15.1 (K), D16.1 (K), D17.1 (K), R83.1, U41.1, U47.6 (LATCH); also elsewhere on the board
PORT_FEED_EN: U32.2, U41.4, U43.1
PORT_ILIM: R62.1, U29.5 (ILIM)
PORT_RAIL_OK: R66.2, TP11.1, U31.1 (RESET_N), U41.2, U47.5 (ALERT_N); also elsewhere on the board
PORT_SENSE: R64.2, R65.1, U31.5 (SENSE)
PORT_SUPPLY: C97.1, R116.2, TP10.1, U29.6 (OUT), U47.2 (IN-); also elsewhere on the board
PRTPWR1: D14.2 (A); also elsewhere on the board
PRTPWR2: D15.2 (A); also elsewhere on the board
PRTPWR3: D16.2 (A); also elsewhere on the board
PRTPWR4: D17.2 (A); also elsewhere on the board

Notes on the sheet:
Supply selection and protected port distribution
USB 2.0 / 480 Mbps | Rev C electrical design | Placed PCB; all routing by Alex; hardware tests pending
External-priority power mux and core hold-up
Bus / external downstream supply paths
Core undervoltage sheds downstream loads
Mutually exclusive supply enables
Declared power origins

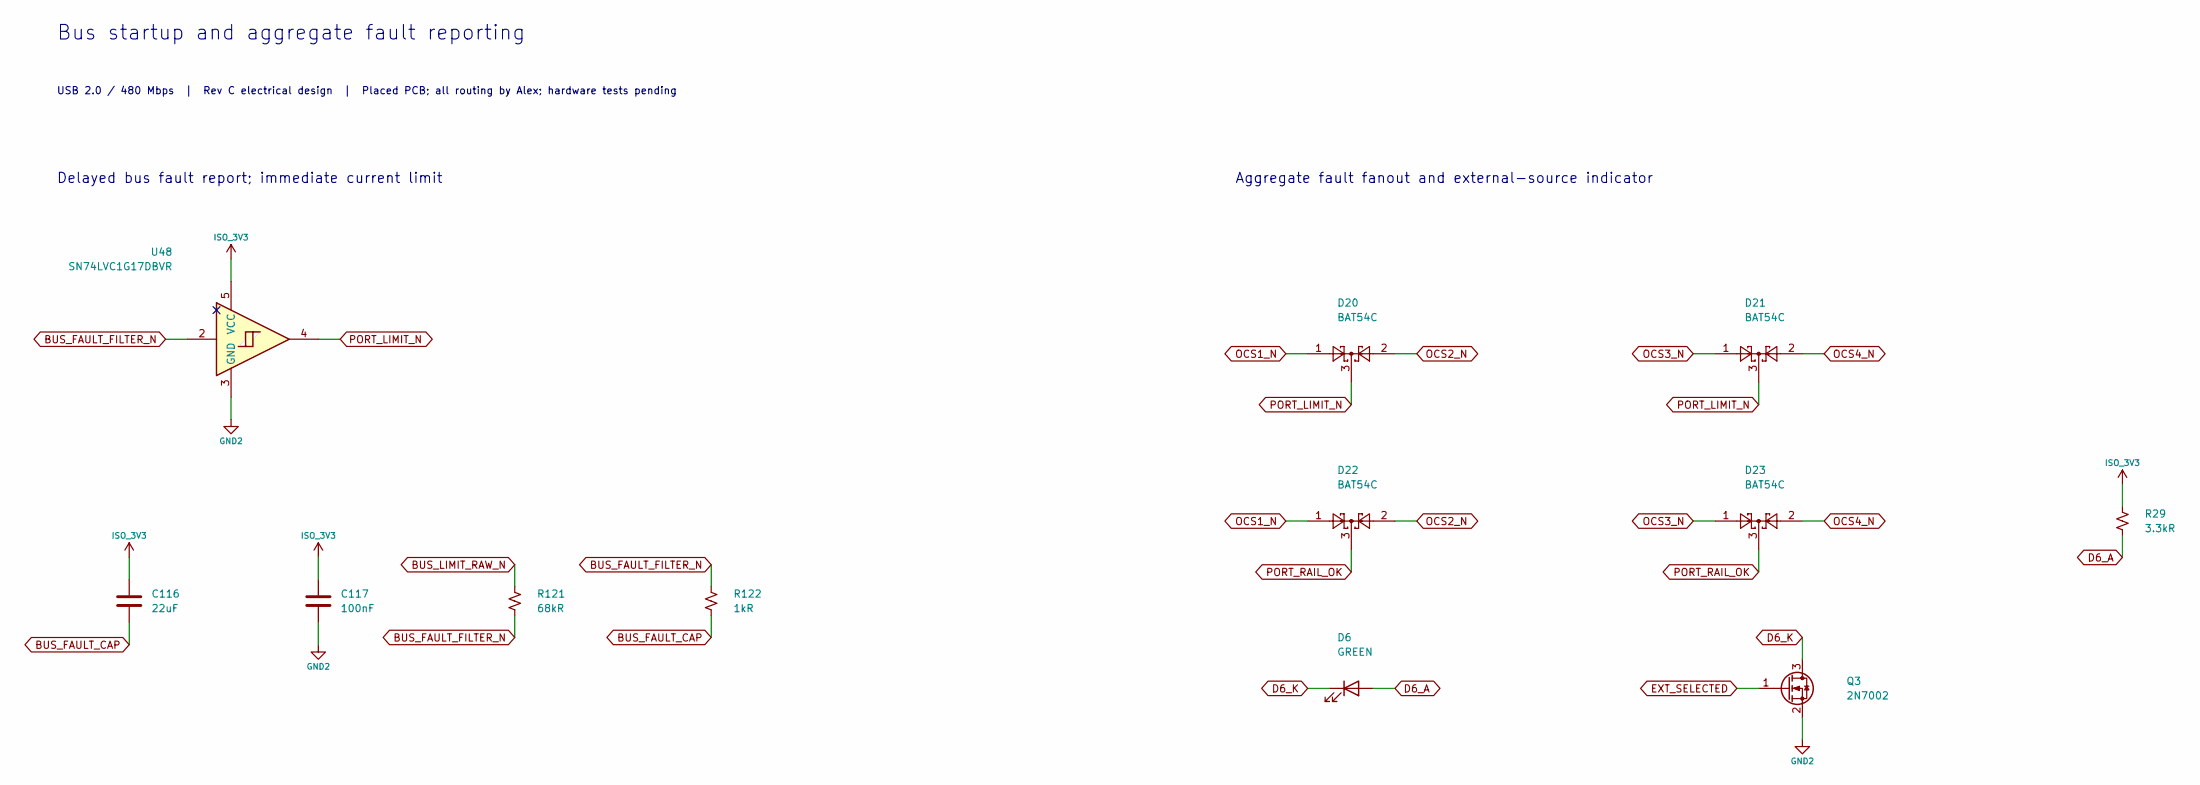
[picture p39: schematic hub-bus_start.kicad_sch, Bus startup and aggregate fault reporting]

Parts:
C116: 22uF; C_1210_3225Metric; Ratings 25V X7R 10%; MPN GRM32ER71E226KE15L; LCSC C21397
C117: 100nF; C_0402_1005Metric; Ratings 50V X7R 10%; MPN GRM155R71H104KE14D; LCSC C77020
D6: GREEN; LED_0603_1608Metric; Ratings See exact manufacturer datasheet; MPN LTST-C190KGKT; LCSC C125094
D20, D21, D22, D23: BAT54C; SOT-23; Ratings See exact manufacturer datasheet; MPN BAT54C,215; LCSC C37704
Q3: 2N7002; SOT-23; Ratings See exact manufacturer datasheet; MPN 2N7002,215; LCSC C65189
R29: 3.3kR; R_0402_1005Metric; Ratings 1%, 0.1W, 50V; MPN ERJ2RKF3301X; LCSC C409909
R121: 68kR; R_0402_1005Metric; Ratings 1%, 0.1W, 50V; MPN ERJ2RKF6802X; LCSC C77607
R122: 1kR; R_0402_1005Metric; Ratings 1%, 0.1W, 50V; MPN ERJ2RKF1001X; LCSC C242161
U48: SN74LVC1G17DBVR; SOT-23-5; Ratings See exact manufacturer datasheet; MPN SN74LVC1G17DBVR; LCSC C7836

Connections:
BUS_FAULT_CAP: C116.2, R122.2
BUS_FAULT_FILTER_N: R121.2, R122.1, U48.2
BUS_LIMIT_RAW_N: R121.1; also elsewhere on the board
D6_A: D6.2 (A), R29.2
D6_K: D6.1 (K), Q3.3 (D)
EXT_SELECTED: Q3.1 (G); also elsewhere on the board
GND2: C117.2, Q3.2 (S), U48.3 (GND); also elsewhere on the board
ISO_3V3: C116.1, C117.1, R29.1, U48.5 (VCC); also elsewhere on the board
OCS1_N: D20.1, D22.1; also elsewhere on the board
OCS2_N: D20.2, D22.2; also elsewhere on the board
OCS3_N: D21.1, D23.1; also elsewhere on the board
OCS4_N: D21.2, D23.2; also elsewhere on the board
PORT_LIMIT_N: D20.3, D21.3, U48.4
PORT_RAIL_OK: D22.3, D23.3; also elsewhere on the board

Notes on the sheet:
Bus startup and aggregate fault reporting
USB 2.0 / 480 Mbps | Rev C electrical design | Placed PCB; all routing by Alex; hardware tests pending
Delayed bus fault report; immediate current limit
Aggregate fault fanout and external-source indicator
