alxgmpr/adum4165-isolator/hub.kicad_pcb

## KiCad design hub.kicad_pcb (continued)

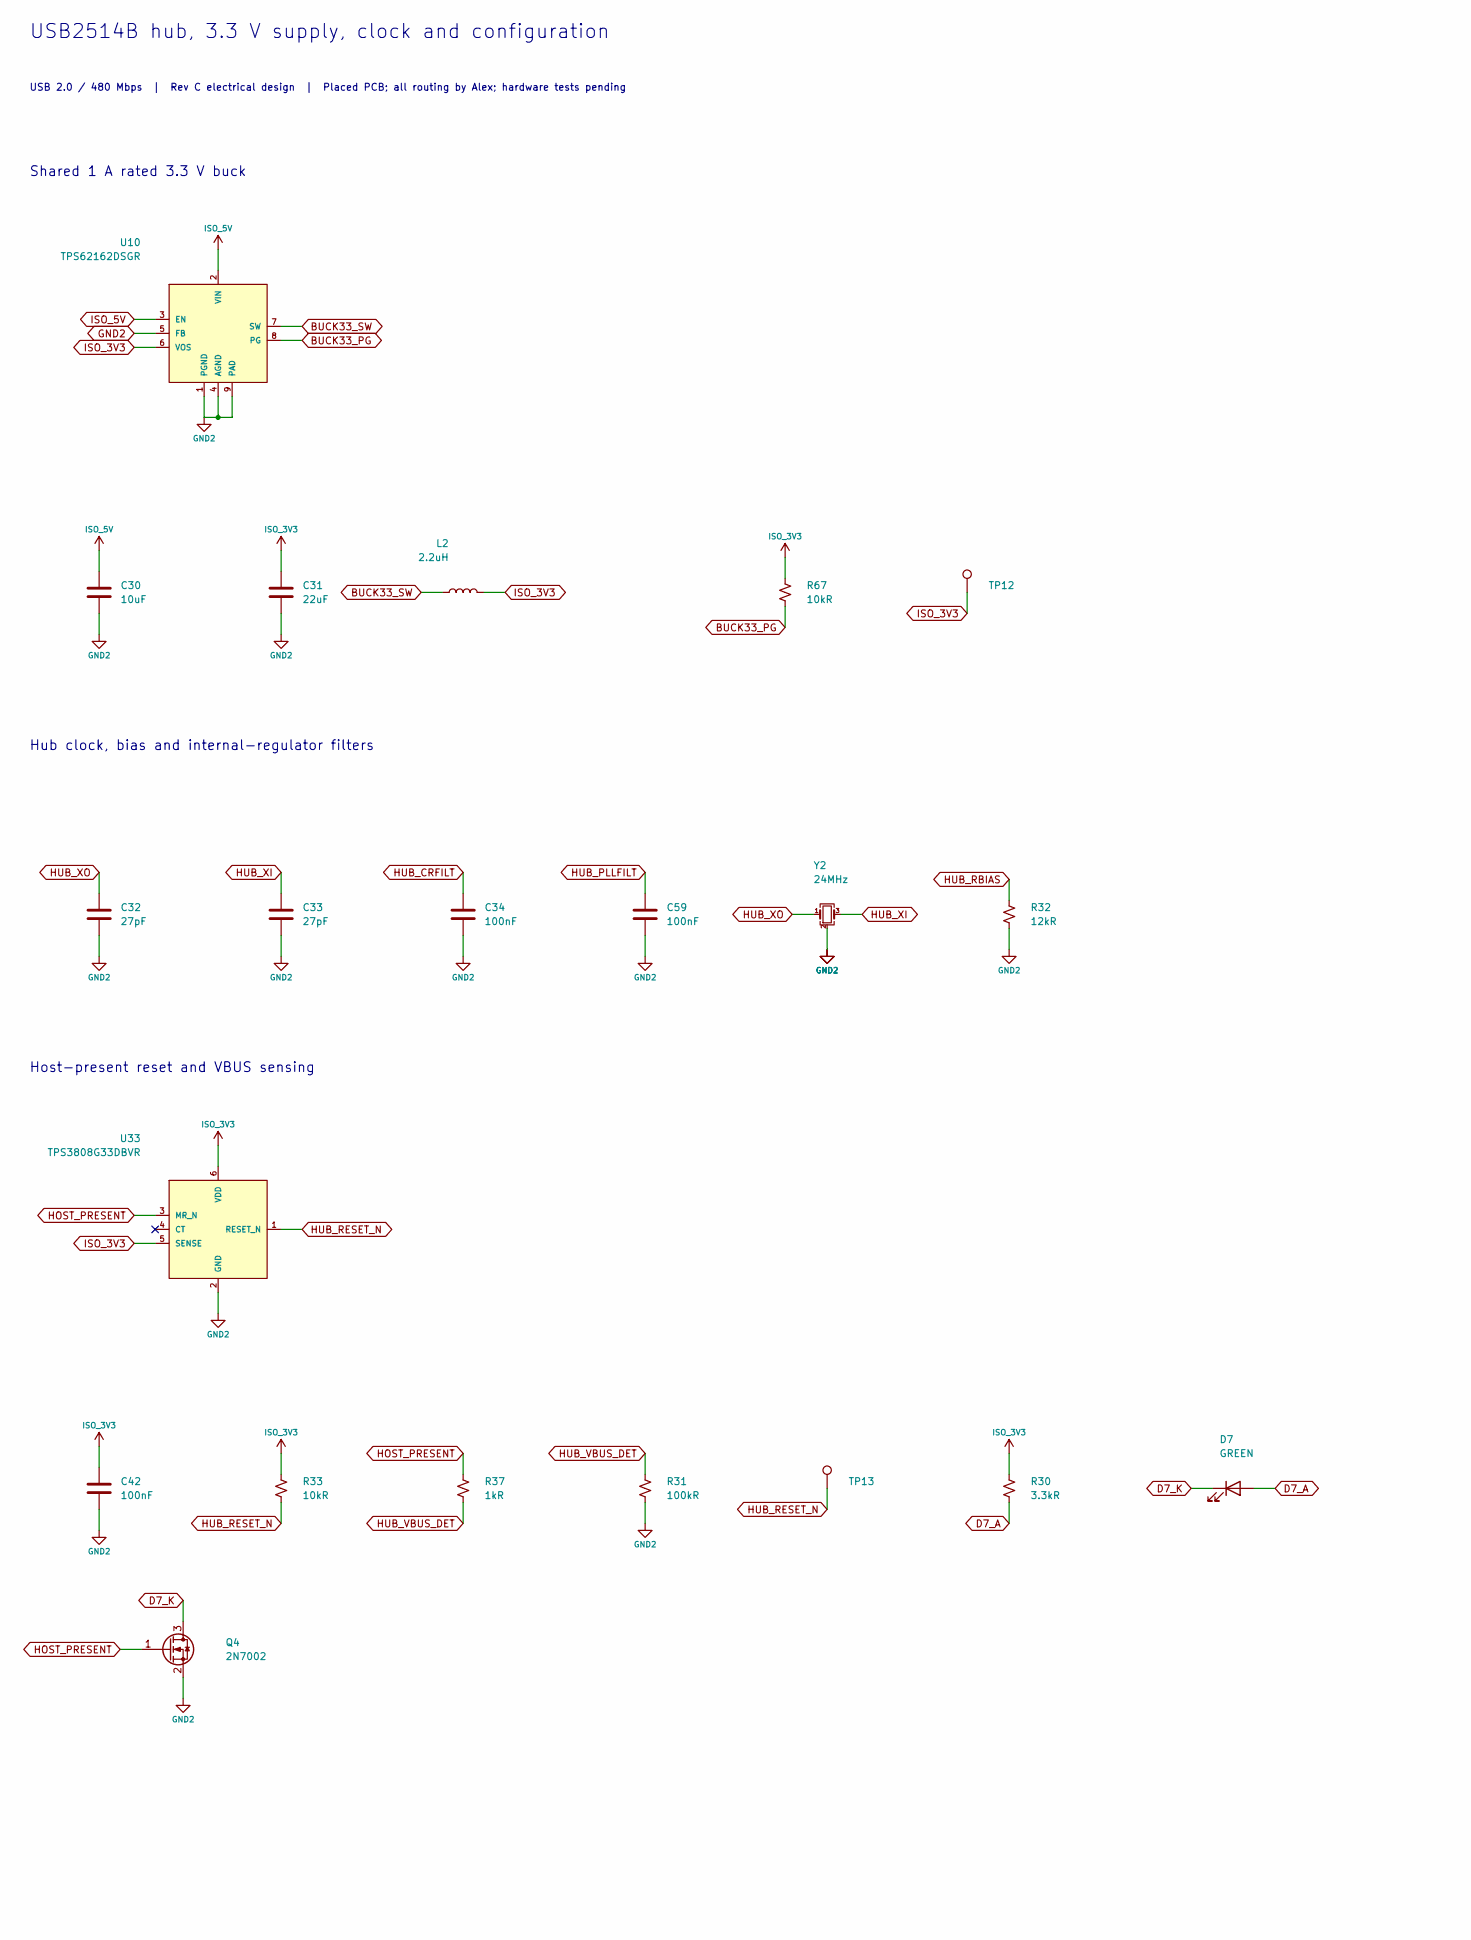
[picture p40: schematic hub-hub.kicad_sch, USB2514B hub, 3.3 V supply, clock and configuration, part in row 1, column 1]

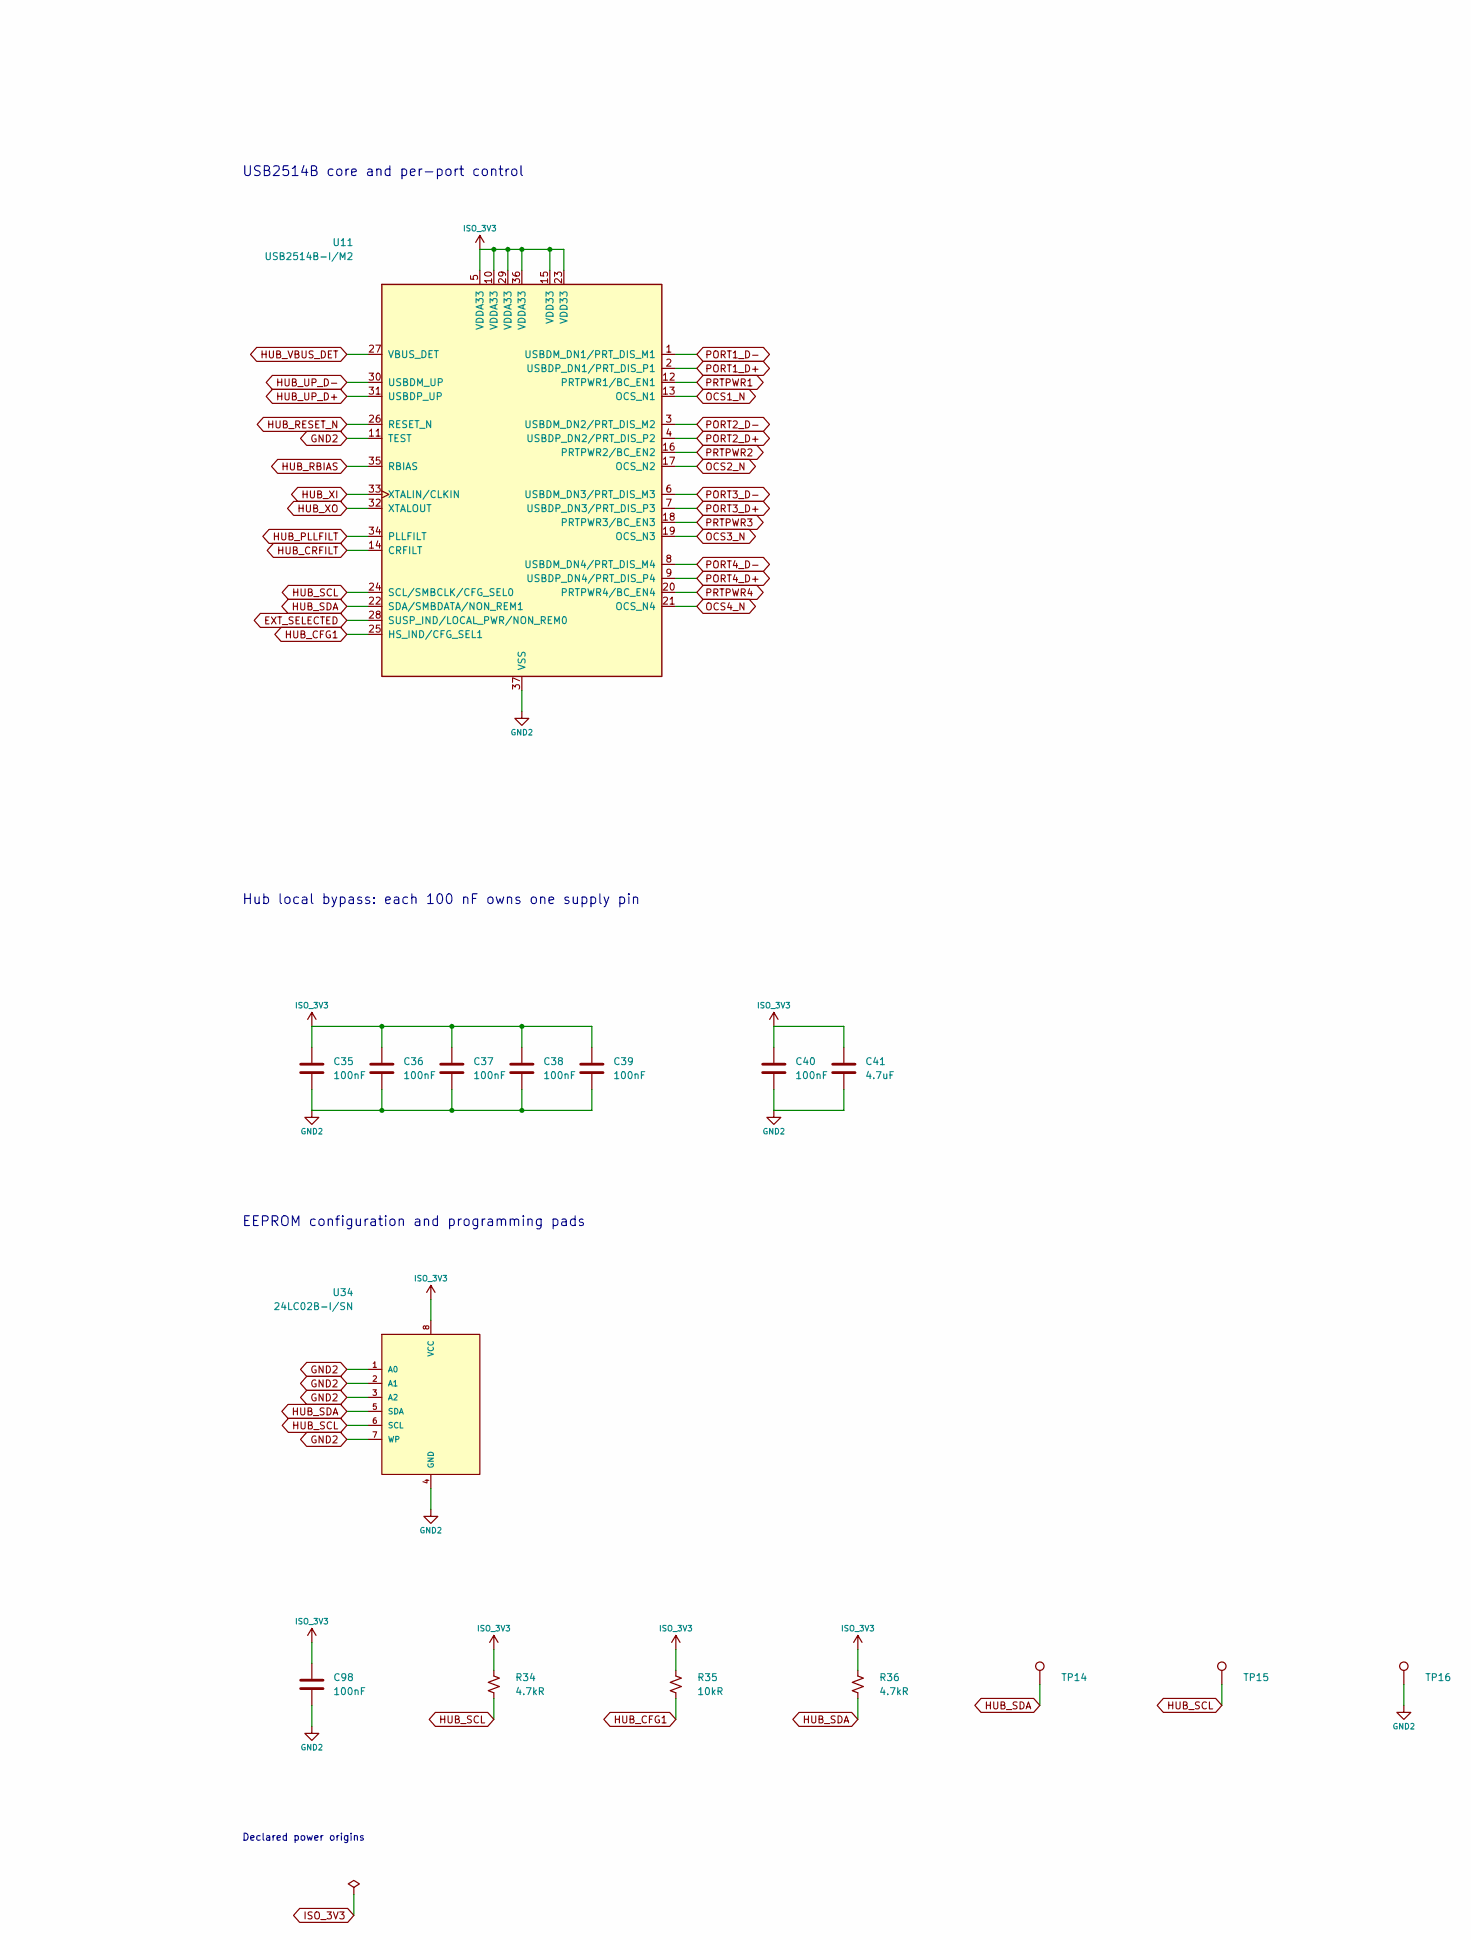
[picture p41: schematic hub-hub.kicad_sch, USB2514B hub, 3.3 V supply, clock and configuration, part in row 1, column 2]

Parts:
C30: 10uF; C_0805_2012Metric; Ratings 25V X5R 10%; MPN GRM21BR61E106KA73L; LCSC C84416
C31: 22uF; C_1210_3225Metric; Ratings 25V X7R 10%; MPN GRM32ER71E226KE15L; LCSC C21397
C32, C33: 27pF; C_0402_1005Metric; Ratings 50V C0G 5%; MPN GCM1555C1H270JA16D; LCSC C126504
C34, C35, C36, C37, C38, C39, C40, C42, C59, C98: 100nF; C_0402_1005Metric; Ratings 50V X7R 10%; MPN GRM155R71H104KE14D; LCSC C77020
C41: 4.7uF; C_0603_1608Metric; Ratings 25V X5R 10%; MPN GRM188R61E475KE11D; LCSC C90057
D7: GREEN; LED_0603_1608Metric; Ratings See exact manufacturer datasheet; MPN LTST-C190KGKT; LCSC C125094
L2: 2.2uH; Coilcraft_XFL4020_4x4mm; Ratings See exact manufacturer datasheet; MPN XFL4020-222MEC; LCSC C122469
Q4: 2N7002; SOT-23; Ratings See exact manufacturer datasheet; MPN 2N7002,215; LCSC C65189
R30: 3.3kR; R_0402_1005Metric; Ratings 1%, 0.1W, 50V; MPN ERJ2RKF3301X; LCSC C409909
R31: 100kR; R_0402_1005Metric; Ratings 1%, 0.1W, 50V; MPN ERJ2RKF1003X; LCSC C192169
R32: 12kR; R_0402_1005Metric; Ratings 1%, 0.1W, 50V; MPN ERJ2RKF1202X; LCSC C413095
R33, R35, R67: 10kR; R_0402_1005Metric; Ratings 1%, 0.1W, 50V; MPN ERJ2RKF1002X; LCSC C191123
R34, R36: 4.7kR; R_0402_1005Metric; Ratings 1%, 0.1W, 50V; MPN ERJ2RKF4701X; LCSC C400631
R37: 1kR; R_0402_1005Metric; Ratings 1%, 0.1W, 50V; MPN ERJ2RKF1001X; LCSC C242161
TP12: ISO_3V3; TestPoint_Pad_D1.0mm; Ratings Exposed test pad; no purchased part
TP13: HUB_RESET_N; TestPoint_Pad_D1.0mm; Ratings Exposed test pad; no purchased part
TP14: HUB_SDA; TestPoint_Pad_D1.0mm; Ratings Exposed test pad; no purchased part
TP15: HUB_SCL; TestPoint_Pad_D1.0mm; Ratings Exposed test pad; no purchased part
TP16: GND2; TestPoint_Pad_D1.0mm; Ratings Exposed test pad; no purchased part
U10: TPS62162DSGR; Texas_DSG0008A_WSON-8-1EP_2x2mm_P0.5mm_EP0.9x1.6mm; Ratings See exact manufacturer datasheet; MPN TPS62162DSGR; LCSC C40256
U11: USB2514B-I/M2; Microchip_SQFN36_6x6mm_EP3.7mm; Ratings See exact manufacturer datasheet; MPN USB2514B-I/M2; LCSC C220679
U33: TPS3808G33DBVR; SOT-23-6; Ratings See exact manufacturer datasheet; MPN TPS3808G33DBVR; LCSC C43698
U34: 24LC02B-I/SN; SOIC-8_3.9x4.9mm_P1.27mm; Ratings See exact manufacturer datasheet; MPN 24LC02B-I/SN; LCSC C1348870
Y2: 24MHz; Crystal_SMD_3225-4Pin_3.2x2.5mm; Ratings See exact manufacturer datasheet; MPN ABM8G-24.000MHZ-18-D2Y-T; LCSC C596911

Connections:
BUCK33_PG: R67.2, U10.8 (PG)
BUCK33_SW: L2.1, U10.7 (SW)
D7_A: D7.2 (A), R30.2
D7_K: D7.1 (K), Q4.3 (D)
EXT_SELECTED: U11.28 (SUSP_IND/LOCAL_PWR/NON_REM0); also elsewhere on the board
GND2: C30.2, C31.2, C32.2, C33.2, C34.2, C35.2, C36.2, C37.2, C38.2, C39.2, C40.2, C41.2, C42.2, C59.2, C98.2, Q4.2 (S), R31.2, R32.2, TP16.1, U10.1 (PGND), U10.4 (AGND), U10.5 (FB), U10.9 (PAD), U11.11 (TEST), U11.37 (VSS), U33.2 (GND), U34.1 (A0), U34.2 (A1), U34.3 (A2), U34.4 (GND), U34.7 (WP), Y2.2 (G), Y2.4 (G); also elsewhere on the board
HOST_PRESENT: Q4.1 (G), R37.1, U33.3 (MR_N); also elsewhere on the board
HUB_CFG1: R35.2, U11.25 (HS_IND/CFG_SEL1)
HUB_CRFILT: C34.1, U11.14 (CRFILT)
HUB_PLLFILT: C59.1, U11.34 (PLLFILT)
HUB_RBIAS: R32.1, U11.35 (RBIAS)
HUB_RESET_N: R33.2, TP13.1, U11.26 (RESET_N), U33.1 (RESET_N)
HUB_SCL: R34.2, TP15.1, U11.24 (SCL/SMBCLK/CFG_SEL0), U34.6 (SCL)
HUB_SDA: R36.2, TP14.1, U11.22 (SDA/SMBDATA/NON_REM1), U34.5 (SDA)
HUB_UP_D+: U11.31 (USBDP_UP); also elsewhere on the board
HUB_UP_D-: U11.30 (USBDM_UP); also elsewhere on the board
HUB_VBUS_DET: R31.1, R37.2, U11.27 (VBUS_DET)
HUB_XI: C33.1, U11.33 (XTALIN/CLKIN), Y2.3
HUB_XO: C32.1, U11.32 (XTALOUT), Y2.1
ISO_3V3: C31.1, C35.1, C36.1, C37.1, C38.1, C39.1, C40.1, C41.1, C42.1, C98.1, L2.2, R30.1, R33.1, R34.1, R35.1, R36.1, R67.1, TP12.1, U10.6 (VOS), U11.5 (VDDA33), U11.10 (VDDA33), U11.15 (VDD33), U11.23 (VDD33), U11.29 (VDDA33), U11.36 (VDDA33), U33.5 (SENSE), U33.6 (VDD), U34.8 (VCC); also elsewhere on the board
ISO_5V: C30.1, U10.2 (VIN), U10.3 (EN); also elsewhere on the board
OCS1_N: U11.13 (OCS_N1); also elsewhere on the board
OCS2_N: U11.17 (OCS_N2); also elsewhere on the board
OCS3_N: U11.19 (OCS_N3); also elsewhere on the board
OCS4_N: U11.21 (OCS_N4); also elsewhere on the board
PORT1_D+: U11.2 (USBDP_DN1/PRT_DIS_P1); also elsewhere on the board
PORT1_D-: U11.1 (USBDM_DN1/PRT_DIS_M1); also elsewhere on the board
PORT2_D+: U11.4 (USBDP_DN2/PRT_DIS_P2); also elsewhere on the board
PORT2_D-: U11.3 (USBDM_DN2/PRT_DIS_M2); also elsewhere on the board
PORT3_D+: U11.7 (USBDP_DN3/PRT_DIS_P3); also elsewhere on the board
PORT3_D-: U11.6 (USBDM_DN3/PRT_DIS_M3); also elsewhere on the board
PORT4_D+: U11.9 (USBDP_DN4/PRT_DIS_P4); also elsewhere on the board
PORT4_D-: U11.8 (USBDM_DN4/PRT_DIS_M4); also elsewhere on the board
PRTPWR1: U11.12 (PRTPWR1/BC_EN1); also elsewhere on the board
PRTPWR2: U11.16 (PRTPWR2/BC_EN2); also elsewhere on the board
PRTPWR3: U11.18 (PRTPWR3/BC_EN3); also elsewhere on the board
PRTPWR4: U11.20 (PRTPWR4/BC_EN4); also elsewhere on the board

Notes on the sheet:
USB2514B hub, 3.3 V supply, clock and configuration
USB 2.0 / 480 Mbps | Rev C electrical design | Placed PCB; all routing by Alex; hardware tests pending
Shared 1 A rated 3.3 V buck
USB2514B core and per-port control
Hub clock, bias and internal-regulator filters
Hub local bypass: each 100 nF owns one supply pin
Host-present reset and VBUS sensing
EEPROM configuration and programming pads
Declared power origins

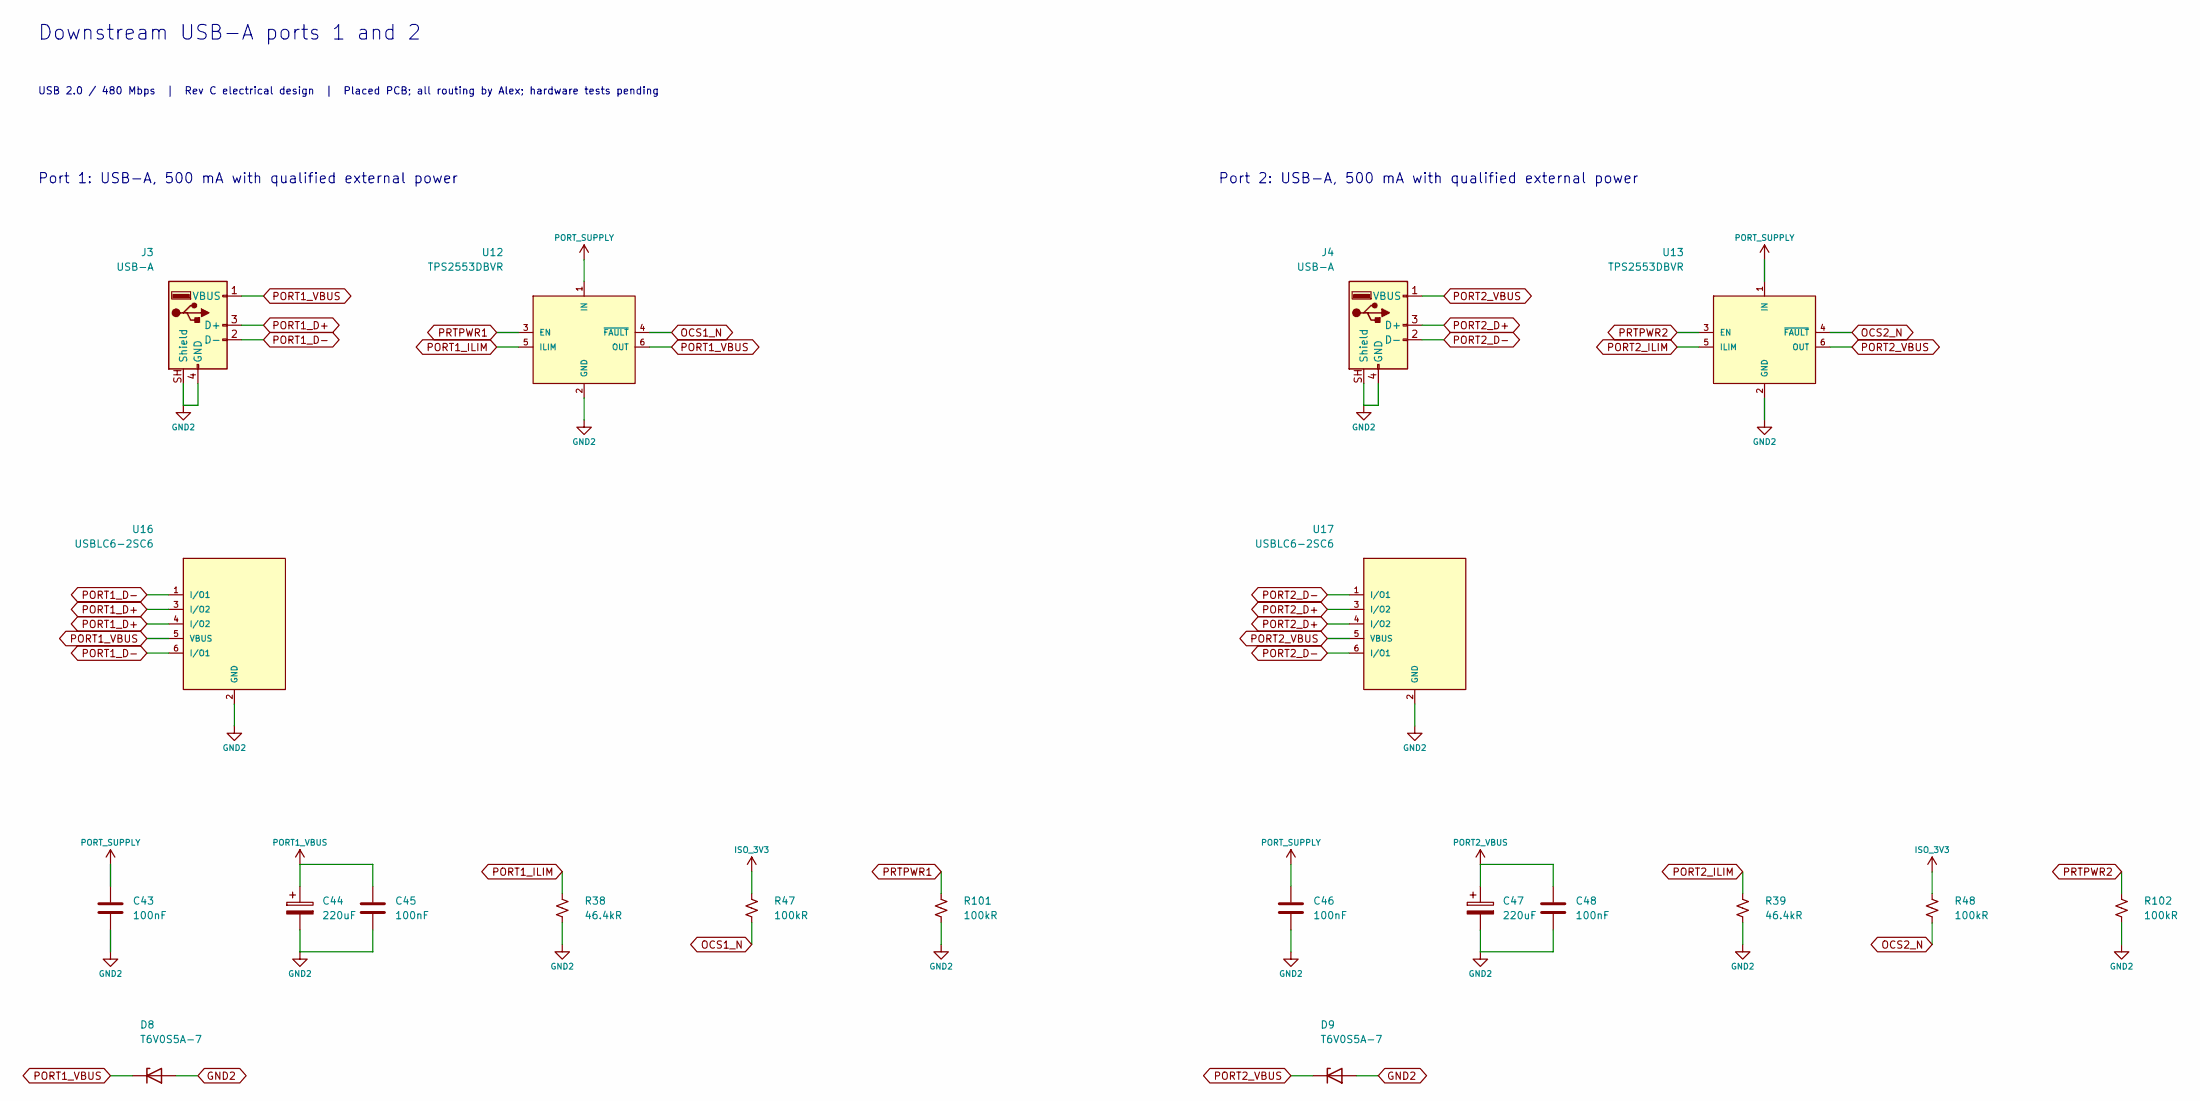
[picture p42: schematic hub-ports_a.kicad_sch, Downstream USB-A ports 1 and 2]

Parts:
C43, C45, C46, C48: 100nF; C_0402_1005Metric; Ratings 50V X7R 10%; MPN GRM155R71H104KE14D; LCSC C77020
C44, C47: 220uF; CP_Elec_8x6.2; Ratings 220uF 10V +/-20%; 8mm diameter, 6.5mm m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; MPN EEEFK1A221P; LCSC C401648
D8, D9: T6V0S5A-7; D_SOD-523; Ratings See exact manufacturer datasheet; MPN T6V0S5A-7; LCSC C19950551
J3, J4: USB-A; USB_A_Wuerth_614004134726_Horizontal; Ratings See exact manufacturer datasheet; MPN 614004134726
R38, R39: 46.4kR; R_0402_1005Metric; Ratings 1%, 0.1W, 50V; MPN ERJ2RKF4642X; LCSC C416544
R47, R48, R101, R102: 100kR; R_0402_1005Metric; Ratings 1%, 0.1W, 50V; MPN ERJ2RKF1003X; LCSC C192169
U12, U13: TPS2553DBVR; SOT-23-6; Ratings See exact manufacturer datasheet; MPN TPS2553DBVR; LCSC C55266
U16, U17: USBLC6-2SC6; SOT-23-6; Ratings See exact manufacturer datasheet; MPN USBLC6-2SC6; LCSC C7519

Connections:
GND2: C43.2, C44.2, C45.2, C46.2, C47.2, C48.2, D8.2 (A), D9.2 (A), J3.4 (GND), J3.SH (Shield), J4.4 (GND), J4.SH (Shield), R38.2, R39.2, R101.2, R102.2, U12.2 (GND), U13.2 (GND), U16.2 (GND), U17.2 (GND); also elsewhere on the board
ISO_3V3: R47.1, R48.1; also elsewhere on the board
OCS1_N: R47.2, U12.4 (~FAULT); also elsewhere on the board
OCS2_N: R48.2, U13.4 (~FAULT); also elsewhere on the board
PORT1_D+: J3.3 (D+), U16.3 (I/O2), U16.4 (I/O2); also elsewhere on the board
PORT1_D-: J3.2 (D-), U16.1 (I/O1), U16.6 (I/O1); also elsewhere on the board
PORT1_ILIM: R38.1, U12.5 (ILIM)
PORT1_VBUS: C44.1, C45.1, D8.1 (K), J3.1 (VBUS), U12.6 (OUT), U16.5 (VBUS)
PORT2_D+: J4.3 (D+), U17.3 (I/O2), U17.4 (I/O2); also elsewhere on the board
PORT2_D-: J4.2 (D-), U17.1 (I/O1), U17.6 (I/O1); also elsewhere on the board
PORT2_ILIM: R39.1, U13.5 (ILIM)
PORT2_VBUS: C47.1, C48.1, D9.1 (K), J4.1 (VBUS), U13.6 (OUT), U17.5 (VBUS)
PORT_SUPPLY: C43.1, C46.1, U12.1 (IN), U13.1 (IN); also elsewhere on the board
PRTPWR1: R101.1, U12.3 (EN); also elsewhere on the board
PRTPWR2: R102.1, U13.3 (EN); also elsewhere on the board

Notes on the sheet:
Downstream USB-A ports 1 and 2
USB 2.0 / 480 Mbps | Rev C electrical design | Placed PCB; all routing by Alex; hardware tests pending
Port 1: USB-A, 500 mA with qualified external power
Port 2: USB-A, 500 mA with qualified external power

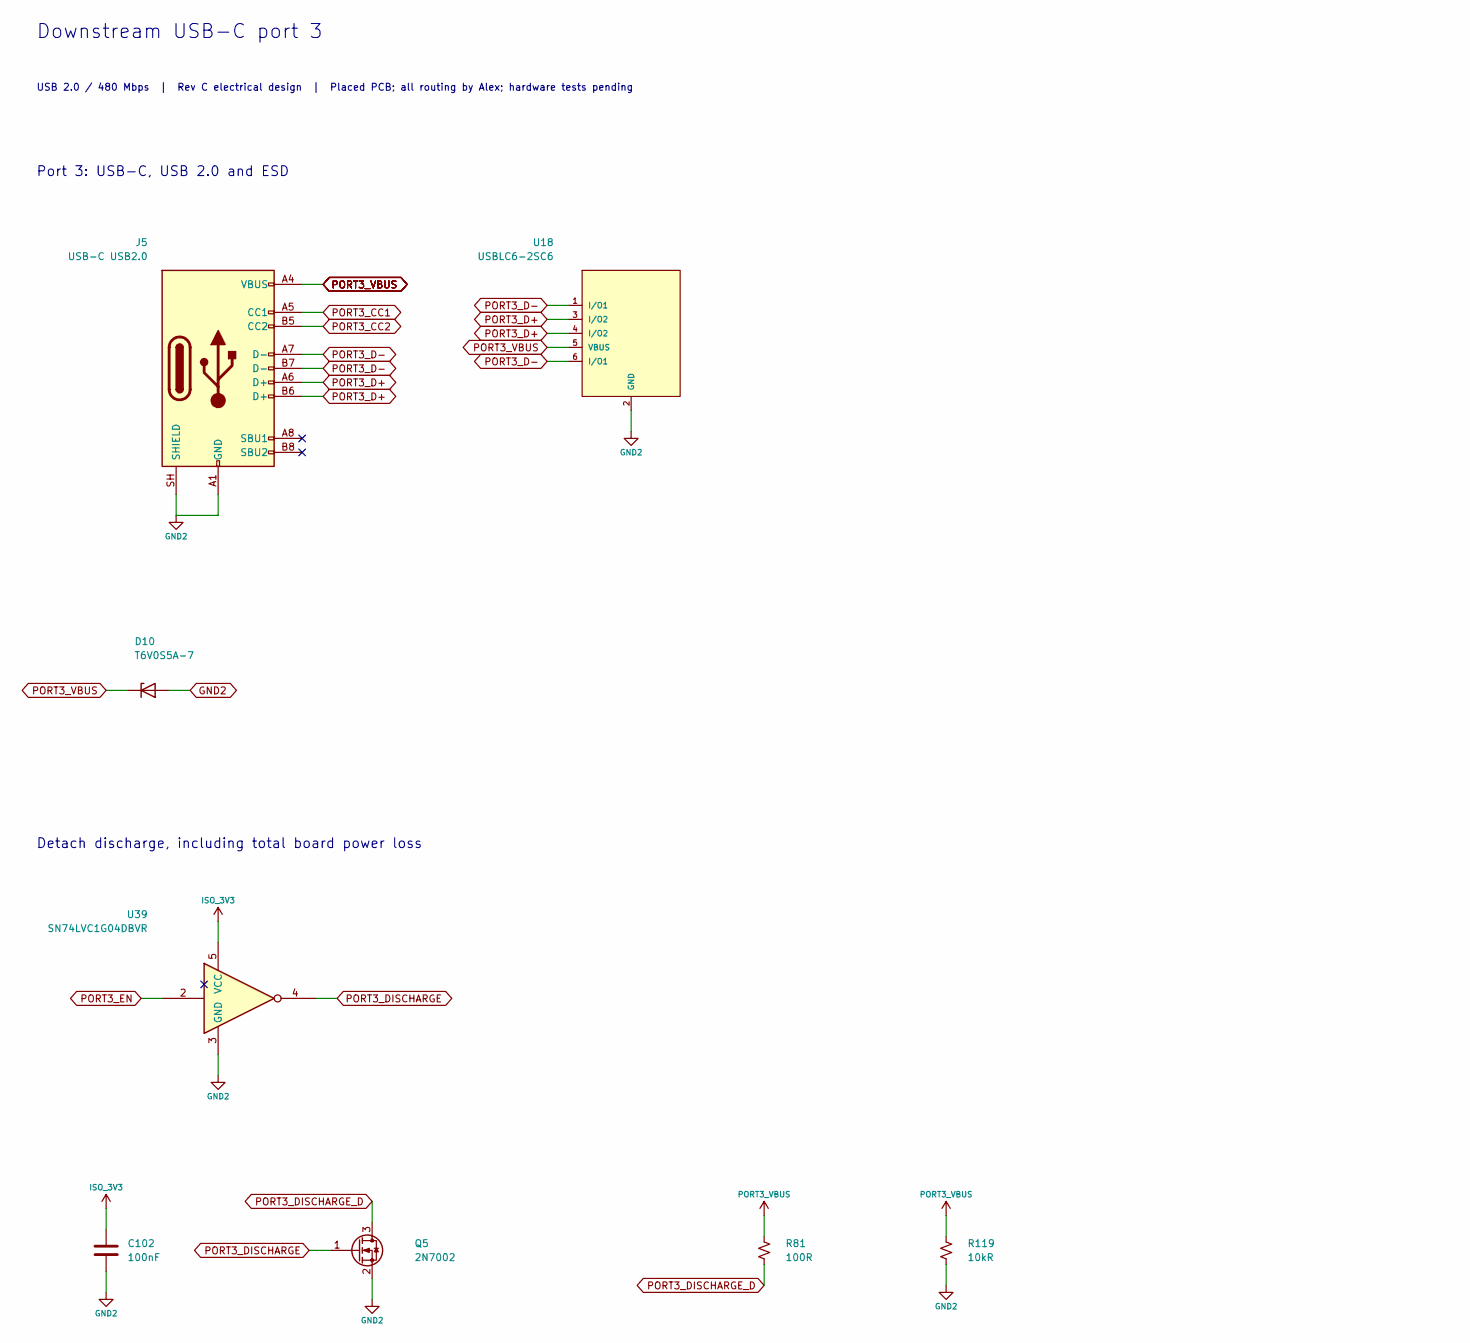
[picture p43: schematic hub-port_c3.kicad_sch, Downstream USB-C port 3, part in row 1, column 1]

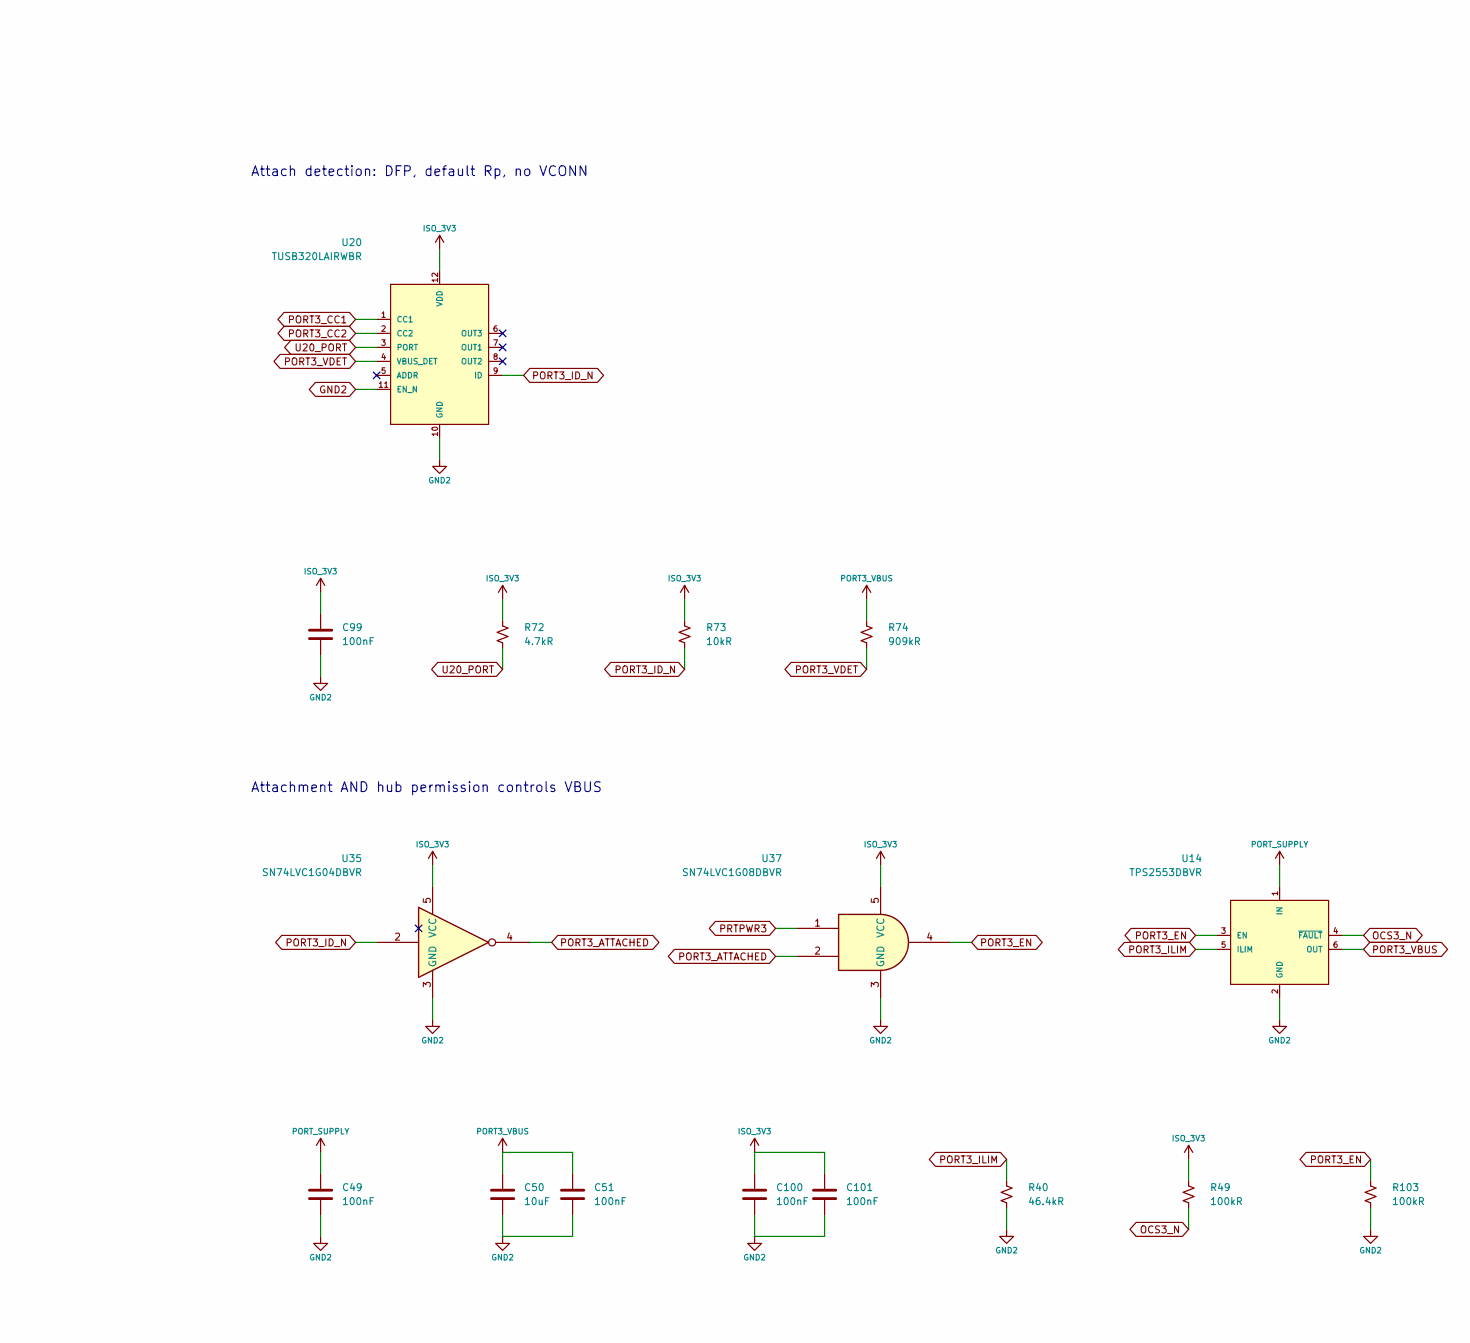
[picture p44: schematic hub-port_c3.kicad_sch, Downstream USB-C port 3, part in row 1, column 2]

Parts:
C49, C51, C99, C100, C101, C102: 100nF; C_0402_1005Metric; Ratings 50V X7R 10%; MPN GRM155R71H104KE14D; LCSC C77020
C50: 10uF; C_0805_2012Metric; Ratings 25V X5R 10%; MPN GRM21BR61E106KA73L; LCSC C84416
D10: T6V0S5A-7; D_SOD-523; Ratings See exact manufacturer datasheet; MPN T6V0S5A-7; LCSC C19950551
J5: USB-C USB2.0; USB_C_Receptacle_HRO_TYPE-C-31-M-12; Ratings See exact manufacturer datasheet; MPN TYPE-C-31-M-12; LCSC C165948
Q5: 2N7002; SOT-23; Ratings See exact manufacturer datasheet; MPN 2N7002,215; LCSC C65189
R40: 46.4kR; R_0402_1005Metric; Ratings 1%, 0.1W, 50V; MPN ERJ2RKF4642X; LCSC C416544
R49, R103: 100kR; R_0402_1005Metric; Ratings 1%, 0.1W, 50V; MPN ERJ2RKF1003X; LCSC C192169
R72: 4.7kR; R_0402_1005Metric; Ratings 1%, 0.1W, 50V; MPN ERJ2RKF4701X; LCSC C400631
R73, R119: 10kR; R_0402_1005Metric; Ratings 1%, 0.1W, 50V; MPN ERJ2RKF1002X; LCSC C191123
R74: 909kR; R_0402_1005Metric; Ratings 1%, 0.1W, 50V; MPN ERJ2RKF9093X; LCSC C2085054
R81: 100R; R_0805_2012Metric; Ratings 100R 1%, 0.125W; 0.20mJ maximum design 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; MPN ERJ6ENF1000V; LCSC C193990
U14: TPS2553DBVR; SOT-23-6; Ratings See exact manufacturer datasheet; MPN TPS2553DBVR; LCSC C55266
U18: USBLC6-2SC6; SOT-23-6; Ratings See exact manufacturer datasheet; MPN USBLC6-2SC6; LCSC C7519
U20: TUSB320LAIRWBR; Texas_X2QFN-12_1.6x1.6mm_P0.4mm; Ratings See exact manufacturer datasheet; MPN TUSB320LAIRWBR; LCSC C132554
U35, U39: SN74LVC1G04DBVR; SOT-23-5; Ratings See exact manufacturer datasheet; MPN SN74LVC1G04DBVR; LCSC C7827
U37: SN74LVC1G08DBVR; SOT-23-5; Ratings See exact manufacturer datasheet; MPN SN74LVC1G08DBVR; LCSC C7666

Connections:
GND2: C49.2, C50.2, C51.2, C99.2, C100.2, C101.2, C102.2, D10.2 (A), J5.A1 (GND), J5.A12 (GND), J5.B1 (GND), J5.B12 (GND), J5.SH (SHIELD), Q5.2 (S), R40.2, R103.2, R119.2, U14.2 (GND), U18.2 (GND), U20.10 (GND), U20.11 (EN_N), U35.3 (GND), U37.3 (GND), U39.3 (GND); also elsewhere on the board
ISO_3V3: C99.1, C100.1, C101.1, C102.1, R49.1, R72.1, R73.1, U20.12 (VDD), U35.5 (VCC), U37.5 (VCC), U39.5 (VCC); also elsewhere on the board
OCS3_N: R49.2, U14.4 (~FAULT); also elsewhere on the board
PORT3_ATTACHED: U35.4, U37.2
PORT3_CC1: J5.A5 (CC1), U20.1 (CC1)
PORT3_CC2: J5.B5 (CC2), U20.2 (CC2)
PORT3_D+: J5.A6 (D+), J5.B6 (D+), U18.3 (I/O2), U18.4 (I/O2); also elsewhere on the board
PORT3_D-: J5.A7 (D-), J5.B7 (D-), U18.1 (I/O1), U18.6 (I/O1); also elsewhere on the board
PORT3_DISCHARGE: Q5.1 (G), U39.4
PORT3_DISCHARGE_D: Q5.3 (D), R81.2
PORT3_EN: R103.1, U14.3 (EN), U37.4, U39.2
PORT3_ID_N: R73.2, U20.9 (ID), U35.2
PORT3_ILIM: R40.1, U14.5 (ILIM)
PORT3_VBUS: C50.1, C51.1, D10.1 (K), J5.A4 (VBUS), J5.A9 (VBUS), J5.B4 (VBUS), J5.B9 (VBUS), R74.1, R81.1, R119.1, U14.6 (OUT), U18.5 (VBUS)
PORT3_VDET: R74.2, U20.4 (VBUS_DET)
PORT_SUPPLY: C49.1, U14.1 (IN); also elsewhere on the board
PRTPWR3: U37.1; also elsewhere on the board
U20_PORT: R72.2, U20.3 (PORT)

Notes on the sheet:
Downstream USB-C port 3
USB 2.0 / 480 Mbps | Rev C electrical design | Placed PCB; all routing by Alex; hardware tests pending
Port 3: USB-C, USB 2.0 and ESD
Attach detection: DFP, default Rp, no VCONN
Attachment AND hub permission controls VBUS
Detach discharge, including total board power loss
