alxgmpr/adum4165-isolator/hub.kicad_pcb

## KiCad design hub.kicad_pcb (continued)

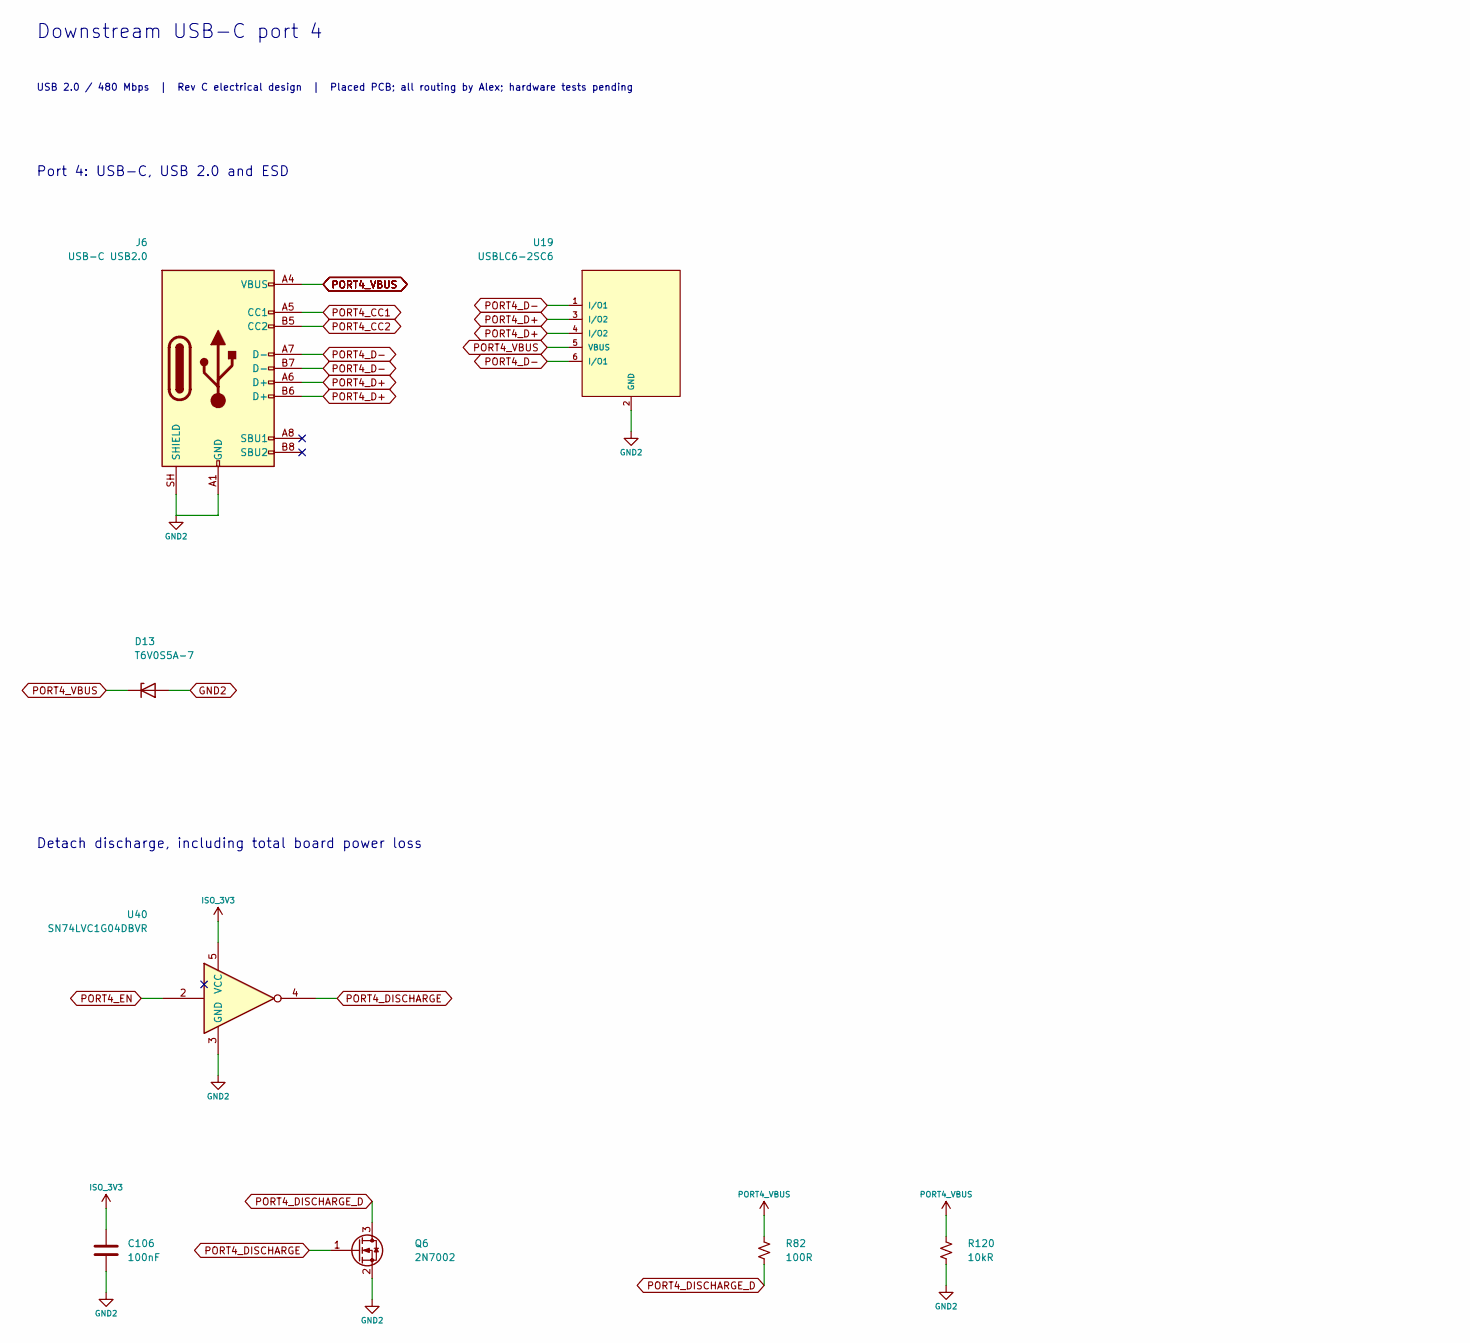
[picture p45: schematic hub-port_c4.kicad_sch, Downstream USB-C port 4, part in row 1, column 1]

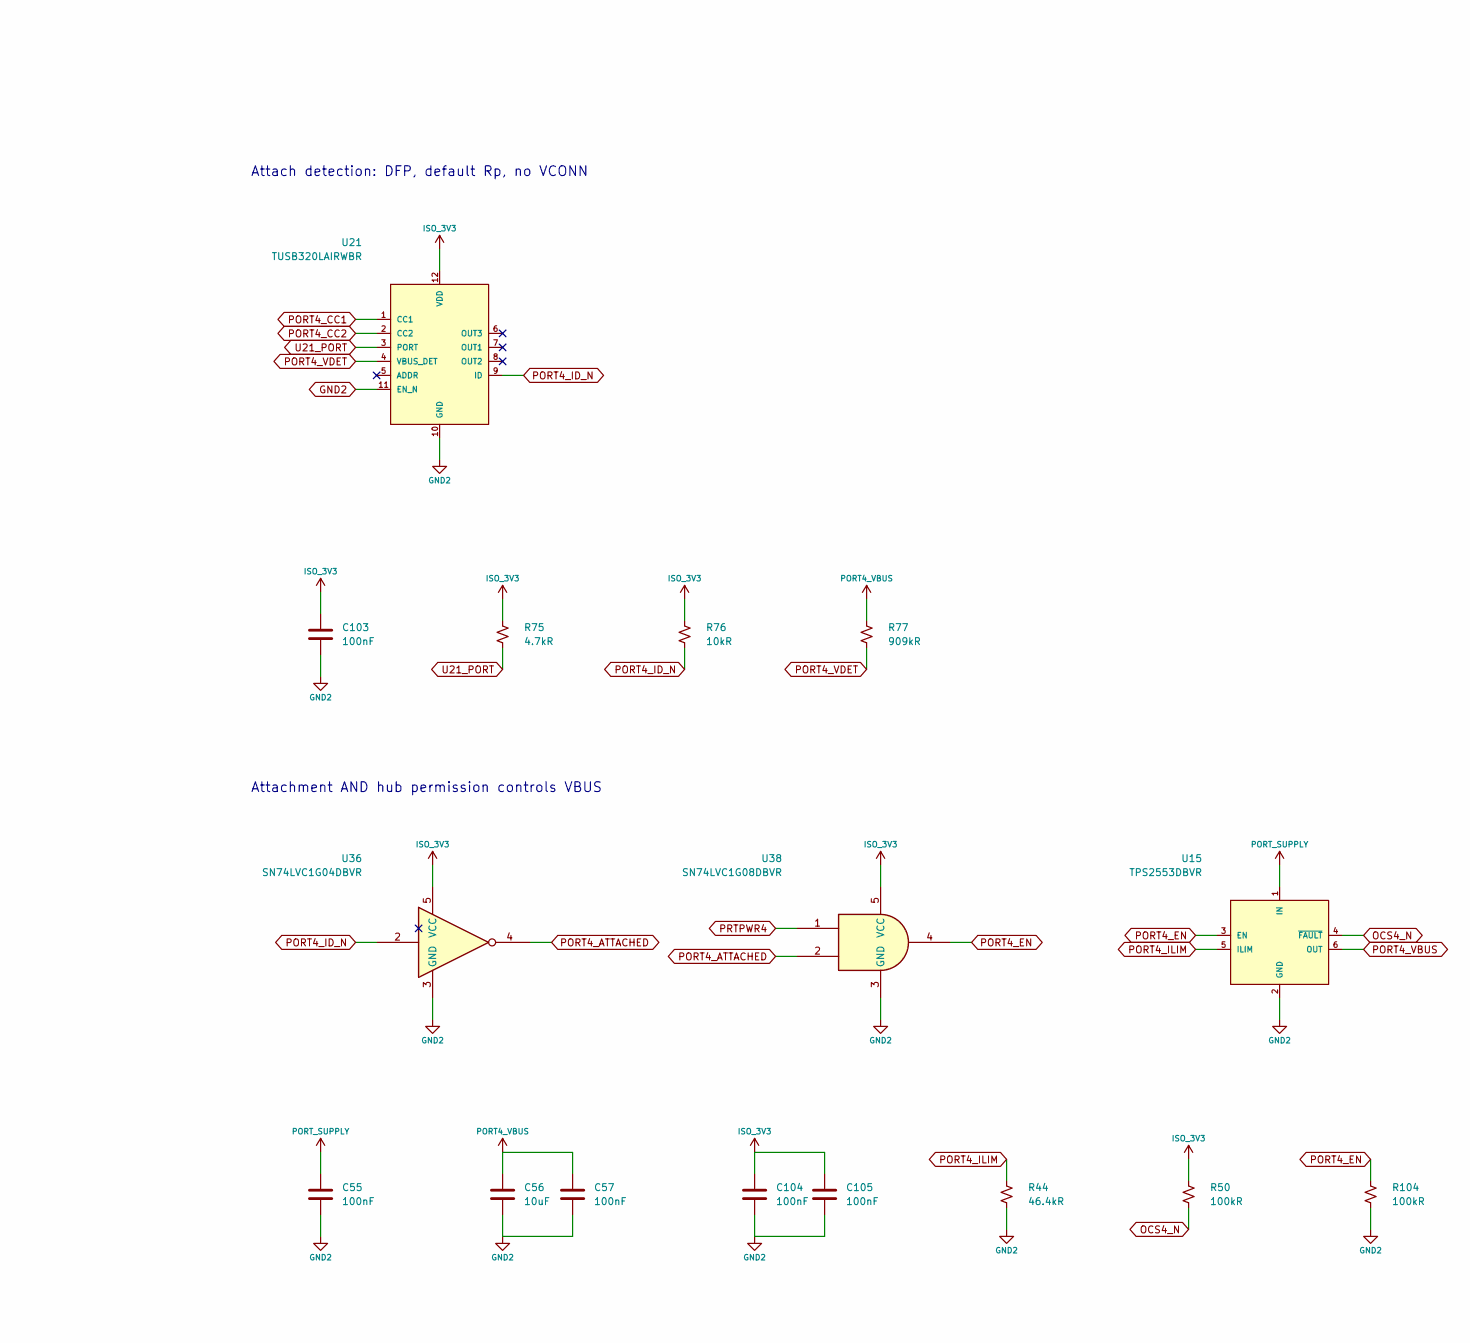
[picture p46: schematic hub-port_c4.kicad_sch, Downstream USB-C port 4, part in row 1, column 2]

Parts:
C55, C57, C103, C104, C105, C106: 100nF; C_0402_1005Metric; Ratings 50V X7R 10%; MPN GRM155R71H104KE14D; LCSC C77020
C56: 10uF; C_0805_2012Metric; Ratings 25V X5R 10%; MPN GRM21BR61E106KA73L; LCSC C84416
D13: T6V0S5A-7; D_SOD-523; Ratings See exact manufacturer datasheet; MPN T6V0S5A-7; LCSC C19950551
J6: USB-C USB2.0; USB_C_Receptacle_HRO_TYPE-C-31-M-12; Ratings See exact manufacturer datasheet; MPN TYPE-C-31-M-12; LCSC C165948
Q6: 2N7002; SOT-23; Ratings See exact manufacturer datasheet; MPN 2N7002,215; LCSC C65189
R44: 46.4kR; R_0402_1005Metric; Ratings 1%, 0.1W, 50V; MPN ERJ2RKF4642X; LCSC C416544
R50, R104: 100kR; R_0402_1005Metric; Ratings 1%, 0.1W, 50V; MPN ERJ2RKF1003X; LCSC C192169
R75: 4.7kR; R_0402_1005Metric; Ratings 1%, 0.1W, 50V; MPN ERJ2RKF4701X; LCSC C400631
R76, R120: 10kR; R_0402_1005Metric; Ratings 1%, 0.1W, 50V; MPN ERJ2RKF1002X; LCSC C191123
R77: 909kR; R_0402_1005Metric; Ratings 1%, 0.1W, 50V; MPN ERJ2RKF9093X; LCSC C2085054
R82: 100R; R_0805_2012Metric; Ratings 100R 1%, 0.125W; 0.20mJ maximum design 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; MPN ERJ6ENF1000V; LCSC C193990
U15: TPS2553DBVR; SOT-23-6; Ratings See exact manufacturer datasheet; MPN TPS2553DBVR; LCSC C55266
U19: USBLC6-2SC6; SOT-23-6; Ratings See exact manufacturer datasheet; MPN USBLC6-2SC6; LCSC C7519
U21: TUSB320LAIRWBR; Texas_X2QFN-12_1.6x1.6mm_P0.4mm; Ratings See exact manufacturer datasheet; MPN TUSB320LAIRWBR; LCSC C132554
U36, U40: SN74LVC1G04DBVR; SOT-23-5; Ratings See exact manufacturer datasheet; MPN SN74LVC1G04DBVR; LCSC C7827
U38: SN74LVC1G08DBVR; SOT-23-5; Ratings See exact manufacturer datasheet; MPN SN74LVC1G08DBVR; LCSC C7666

Connections:
GND2: C55.2, C56.2, C57.2, C103.2, C104.2, C105.2, C106.2, D13.2 (A), J6.A1 (GND), J6.A12 (GND), J6.B1 (GND), J6.B12 (GND), J6.SH (SHIELD), Q6.2 (S), R44.2, R104.2, R120.2, U15.2 (GND), U19.2 (GND), U21.10 (GND), U21.11 (EN_N), U36.3 (GND), U38.3 (GND), U40.3 (GND); also elsewhere on the board
ISO_3V3: C103.1, C104.1, C105.1, C106.1, R50.1, R75.1, R76.1, U21.12 (VDD), U36.5 (VCC), U38.5 (VCC), U40.5 (VCC); also elsewhere on the board
OCS4_N: R50.2, U15.4 (~FAULT); also elsewhere on the board
PORT4_ATTACHED: U36.4, U38.2
PORT4_CC1: J6.A5 (CC1), U21.1 (CC1)
PORT4_CC2: J6.B5 (CC2), U21.2 (CC2)
PORT4_D+: J6.A6 (D+), J6.B6 (D+), U19.3 (I/O2), U19.4 (I/O2); also elsewhere on the board
PORT4_D-: J6.A7 (D-), J6.B7 (D-), U19.1 (I/O1), U19.6 (I/O1); also elsewhere on the board
PORT4_DISCHARGE: Q6.1 (G), U40.4
PORT4_DISCHARGE_D: Q6.3 (D), R82.2
PORT4_EN: R104.1, U15.3 (EN), U38.4, U40.2
PORT4_ID_N: R76.2, U21.9 (ID), U36.2
PORT4_ILIM: R44.1, U15.5 (ILIM)
PORT4_VBUS: C56.1, C57.1, D13.1 (K), J6.A4 (VBUS), J6.A9 (VBUS), J6.B4 (VBUS), J6.B9 (VBUS), R77.1, R82.1, R120.1, U15.6 (OUT), U19.5 (VBUS)
PORT4_VDET: R77.2, U21.4 (VBUS_DET)
PORT_SUPPLY: C55.1, U15.1 (IN); also elsewhere on the board
PRTPWR4: U38.1; also elsewhere on the board
U21_PORT: R75.2, U21.3 (PORT)

Notes on the sheet:
Downstream USB-C port 4
USB 2.0 / 480 Mbps | Rev C electrical design | Placed PCB; all routing by Alex; hardware tests pending
Port 4: USB-C, USB 2.0 and ESD
Attach detection: DFP, default Rp, no VCONN
Attachment AND hub permission controls VBUS
Detach discharge, including total board power loss

Board: 4 copper layers, 295 parts (0 on the bottom side), 148 nets, no tracks yet.

Other parts of the board:
H1, H2, H3, H4: M3 NPTH; MountingHole_3.2mm_M3
