alxgmpr/adum4165-isolator/isolator.kicad_pcb

## KiCad design isolator.kicad_pcb (2026-08-09)

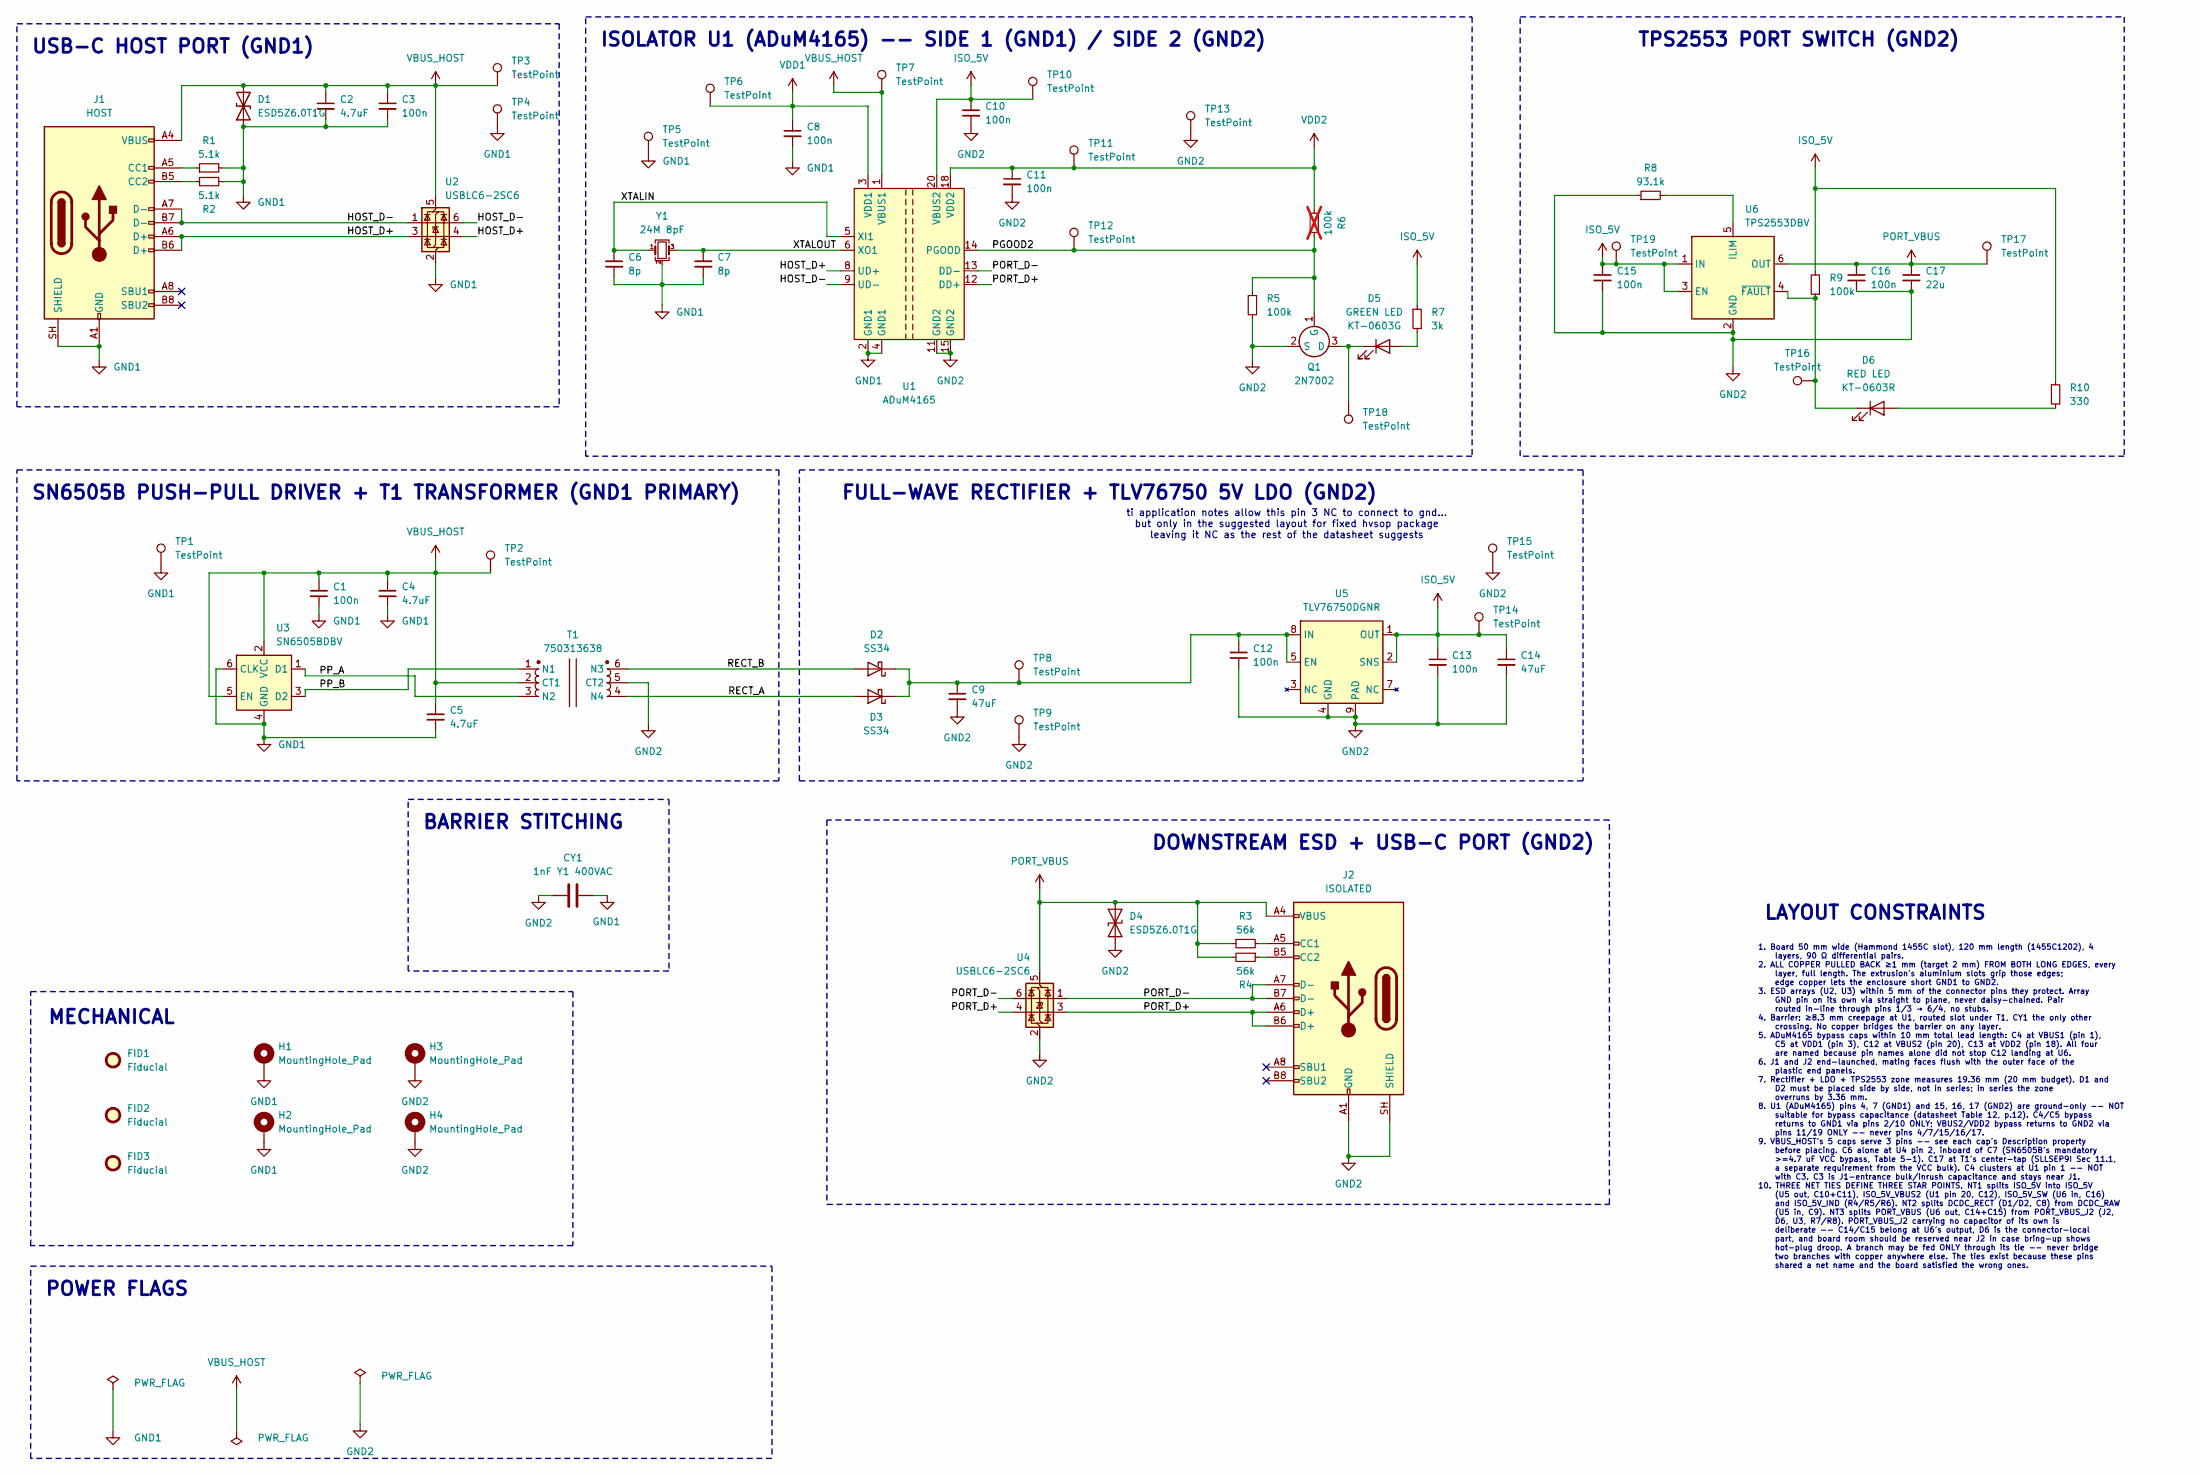
[picture p47: schematic isolator.kicad_sch, Isolated USB 2.0 Cable]

Parts:
C1: 100n; C_0805_2012Metric; Tolerance ±10%; MPN CC0805KRX7R9BB104; LCSC C49678
C2, C4, C5: 4.7uF; C_0805_2012Metric; MPN GRM21BR71E475KA73L; LCSC C1779
C3, C8, C10, C11, C12, C13, C15, C16: 100n; C_0603_1608Metric; Tolerance ±10%; MPN CC0603KRX7R9BB104; LCSC C14663
C6, C7: 8p; C_0603_1608Metric; Tolerance ±0.25pF; MPN CC0603CRNPO9BN8R0; LCSC C327316
C9, C14: 47uF; C_1210_3225Metric; MPN TMK325ABJ476MM-P; LCSC C90142
C17: 22u; C_0805_2012Metric; Tolerance ±10%; MPN GRM21BR61A226ME44L; LCSC C98190
CY1: 1nF Y1 400VAC; C_Disc_D7.0mm_W5.5mm_P14.00mm; Tolerance ±20%; MPN Q07F3Z102MA5B0S0N0; LCSC C2914611
D1, D4: ESD5Z6.0T1G; D_SOD-523; MPN ESD5Z6.0T1G; LCSC C82323
D2, D3: SS34; D_SMA; MPN SS34; LCSC C8678
D5: GREEN LED; LED_0603_1608Metric; MPN KT-0603G; LCSC C12624
D6: RED LED; LED_0603_1608Metric; MPN KT-0603R; LCSC C2286
FID1, FID2, FID3: Fiducial; Fiducial_1mm_Mask2mm
H1, H2, H3, H4: MountingHole_Pad; MountingHole_3.2mm_M3_Pad_Via
J1: HOST; USB_C_Receptacle_HRO_TYPE-C-31-M-12; MPN TYPE-C-31-M-12; LCSC C165948
J2: ISOLATED; USB_C_Receptacle_HRO_TYPE-C-31-M-12; MPN TYPE-C-31-M-12; LCSC C165948
Q1: 2N7002; SOT-23; MPN 2N7002LT1G; LCSC C8545
R1, R2: 5.1k; R_0603_1608Metric; Tolerance ±1%; MPN RC0603FR-075K1L; LCSC C23186
R3, R4: 56k; R_0603_1608Metric; Tolerance ±1%; MPN RC0603FR-0756KL; LCSC C23206
R5, R9: 100k; R_0603_1608Metric; Tolerance ±1%; MPN RC0603FR-07100KL; LCSC C25803
R6: 100k; R_0603_1608Metric; Tolerance ±1%; MPN RC0603FR-07100KL; LCSC C14675; not fitted
R7: 3k; R_0603_1608Metric; Tolerance ±1%; MPN RC0603FR-073KL; LCSC C4211
R8: 93.1k; R_0603_1608Metric; Tolerance ±1%; MPN RC0603FR-0793K1L; LCSC C273780
R10: 330; R_0603_1608Metric; Tolerance ±1%; MPN RC0603FR-07330RL; LCSC C23138
T1: 750313638; WE_750313638; MPN 750313638
TP1, TP2, TP3, TP4, TP5, TP6, TP7, TP8, TP9, TP10, TP11, TP12, TP13, TP14, TP15, TP16, TP17, TP18, TP19: TestPoint; TestPoint_Pad_D1.0mm
U1: ADuM4165; ADI_SOIC_IC_20_RI-20-1; MPN ADUM4165BRIZ
U2, U4: USBLC6-2SC6; SOT-23-6; MPN USBLC6-2SC6; LCSC C2687116
U3: SN6505BDBV; SOT-23-6; MPN SN6505BDBVR; LCSC C74518
U5: TLV76750DGNR; HVSSOP-8-1EP_3x3mm_P0.65mm_EP1.57x1.89mm; MPN TLV76750DGNR; LCSC C3752807
U6: TPS2553DBV; SOT-23-6; MPN TPS2553DBVR; LCSC C55266
Y1: 24M 8pF; Crystal_SMD_3225-4Pin_3.2x2.5mm; Tolerance ±30ppm; MPN SX3B24.000F0810F30; LCSC C2901675

Connections:
/HOST_D+: J1.A6 (D+), J1.B6 (D+), U1.8 (UD+), U2.3 (I/O2), U2.4 (I/O2)
/HOST_D-: J1.A7 (D-), J1.B7 (D-), U1.9 (UD-), U2.1 (I/O1), U2.6 (I/O1)
/PGOOD2: Q1.1 (G), R5.1, R6.2, TP12.1 (1_1), U1.14 (PGOOD)
/PORT_D+: J2.A6 (D+), J2.B6 (D+), U1.12 (DD+), U4.3 (I/O2), U4.4 (I/O2)
/PORT_D-: J2.A7 (D-), J2.B7 (D-), U1.13 (DD-), U4.1 (I/O1), U4.6 (I/O1)
/PP_A: T1.3 (N2), U3.1 (D1)
/PP_B: T1.1 (N1), U3.3 (D2)
/RECT_A: D3.2 (A), T1.4 (N4)
/RECT_B: D2.2 (A), T1.6 (N3)
/XTALIN: C6.1, U1.5 (XI1), Y1.1
/XTALOUT: C7.1, U1.6 (XO1), Y1.3
GND1: C1.2, C2.2, C3.2, C4.2, C5.2, C6.2, C7.2, C8.2, CY1.2, D1.1 (A1), H1.1 (1_1), H2.1 (1_1), J1.A1 (GND), J1.A12 (GND), J1.B1 (GND), J1.B12 (GND), J1.SH (SHIELD), R1.2, R2.2, TP1.1 (1_1), TP4.1 (1_1), TP5.1 (1_1), U1.2 (GND1), U1.4 (GND1), U1.7 (GND1), U1.10 (GND1), U2.2 (GND), U3.4 (GND), U3.6 (CLK), Y1.2 (G), Y1.4 (G)
GND2: C9.2, C10.2, C11.2, C12.2, C13.2, C14.2, C15.2, C16.2, C17.2, CY1.1, D4.2 (A2), H3.1 (1_1), H4.1 (1_1), J2.A1 (GND), J2.A12 (GND), J2.B1 (GND), J2.B12 (GND), J2.SH (SHIELD), Q1.2 (S), R5.2, R8.1, T1.5 (CT2), TP9.1 (1_1), TP13.1 (1_1), TP15.1 (1_1), U1.11 (GND2), U1.15 (GND2), U1.16 (GND2), U1.17 (GND2), U1.19 (GND2), U4.2 (GND), U5.4 (GND), U5.6 (GND), U5.9 (PAD), U6.2 (GND)
ISO_5V: C10.1, C13.1, C14.1, C15.1, R7.1, R9.2, R10.1, TP10.1 (1_1), TP14.1 (1_1), TP19.1 (1_1), U1.20 (VBUS2), U5.1 (OUT), U5.2 (SNS), U6.1 (IN), U6.3 (EN)
unnamed: C9.1, C12.1, D2.1 (K), D3.1 (K), TP8.1 (1_1), U5.5 (EN), U5.8 (IN)
unnamed: D5.2 (A), R7.2
unnamed: D5.1 (K), Q1.3 (D), TP18.1 (1_1)
unnamed: D6.2 (A), R10.2
unnamed: D6.1 (K), R9.1, TP16.1 (1_1), U6.4 (~FAULT)
unnamed: J1.A5 (CC1), R1.1
unnamed: J1.B5 (CC2), R2.1
unnamed: J2.A5 (CC1), R3.2
unnamed: J2.B5 (CC2), R4.1
unnamed: R8.2, U6.5 (ILIM)
PORT_VBUS: C16.1, C17.1, D4.1 (A1), J2.A4 (VBUS), J2.A9 (VBUS), J2.B4 (VBUS), J2.B9 (VBUS), R3.1, R4.2, TP17.1 (1_1), U4.5 (VBUS), U6.6 (OUT)
VBUS_HOST: C1.1, C2.1, C3.1, C4.1, C5.1, D1.2 (A2), J1.A4 (VBUS), J1.A9 (VBUS), J1.B4 (VBUS), J1.B9 (VBUS), T1.2 (CT1), TP2.1 (1_1), TP3.1 (1_1), TP7.1 (1_1), U1.1 (VBUS1), U2.5 (VBUS), U3.2 (VCC), U3.5 (EN)
VDD1: C8.1, TP6.1 (1_1), U1.3 (VDD1)
VDD2: C11.1, R6.1, TP11.1 (1_1), U1.18 (VDD2)

Notes on the sheet:
1. Board 50 mm wide (Hammond 1455C slot), 120 mm length (1455C1202), 4 layers, 90 Ω differential pairs. 2. ALL COPPER PULLED BACK ≥1 mm (target 2 mm) FROM BOTH LONG EDGES, every layer, full length. The extrusion's aluminium slots grip those edges; edge copper lets the enclosure short GND1 to GND2. 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
BARRIER STITCHING
ISOLATOR U1 (ADuM4165) -- SIDE 1 (GND1) / SIDE 2 (GND2)
USB-C HOST PORT (GND1)
MECHANICAL
DOWNSTREAM ESD + USB-C PORT (GND2)
POWER FLAGS
ti application notes allow this pin 3 NC to connect to gnd... but only in the suggested layout for fixed hvsop package leaving it NC as the rest of the datasheet suggests
LAYOUT CONSTRAINTS
SN6505B PUSH-PULL DRIVER + T1 TRANSFORMER (GND1 PRIMARY)
TPS2553 PORT SWITCH (GND2)
FULL-WAVE RECTIFIER + TLV76750 5V LDO (GND2)

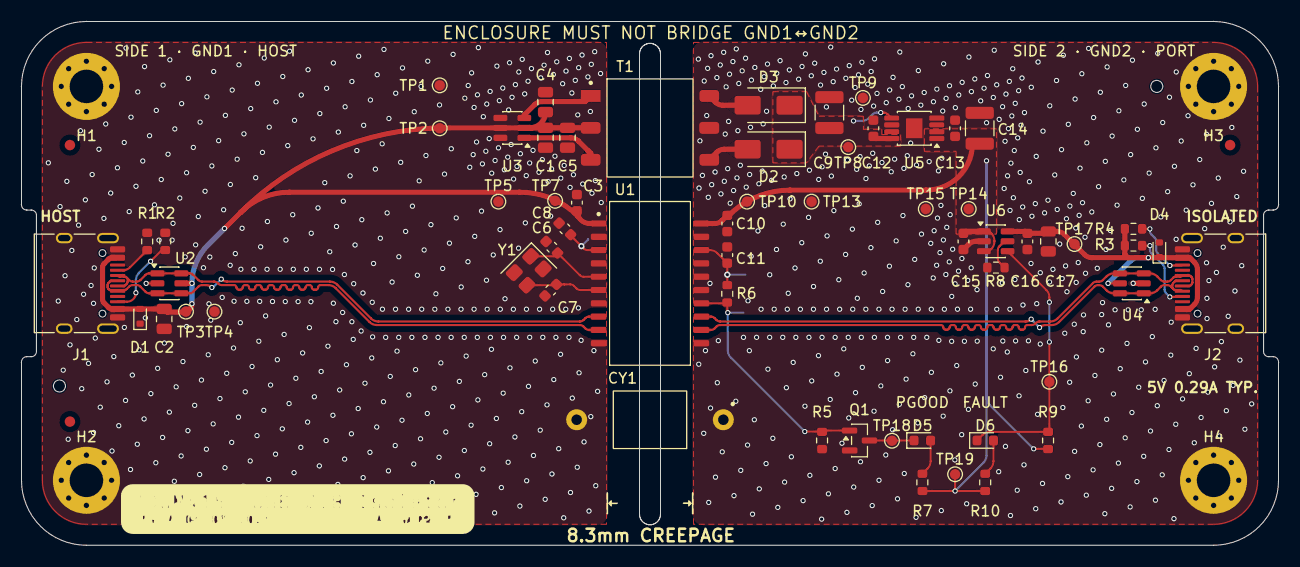
[picture p48: board isolator.kicad_pcb from above]

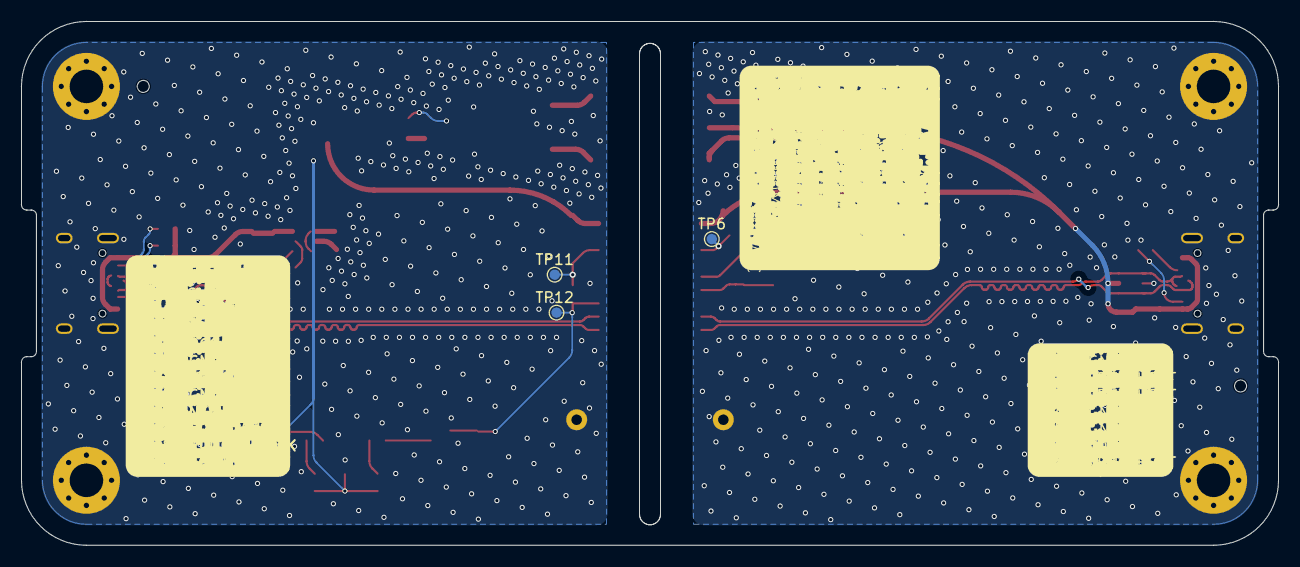
[picture p49: board isolator.kicad_pcb from below]

Board: 4 copper layers, 120.0 x 50.0 mm, 73 parts (3 on the bottom side), 28 nets.

Other parts of the board:
TH1, TH2: ToolingHole_1.152mm
