alxgmpr/adum4165-isolator/(commit log)

2026-07-26 Add design spec for isolated 4-port USB 2.0 hub; snapshot current schematic
    [isolator.kicad_pcb, isolator.kicad_sch]
2026-07-26 docs: implementation plan for isolated USB hub schematic; spec amendments (MIC29302, TLV7041)
2026-07-26 docs: datasheet pin tables for custom symbols
2026-07-26 feat(sch): upstream USB-C host section
    Add J1 (USB-C receptacle), R1/R2 (CC pull-downs), C3-C5 (VBUS_HOST/VDD1
    decoupling) and wire VBUS_HOST, HOST_DP, HOST_DM, GND1 per the task-4
    brief. Rewire U2 (NUP4202) as the host-side ESD array: two of its four
    I/O channels clamp HOST_DP/HOST_DM, its GND pin ties to GND1, its VBUS
    pin ties to VBUS_HOST, and the two unused channels get no_connect.
    Terminate all ADuM4165 (U1) Side-1 pins; Side-2 pins not yet used by
    this task get explicit no_connect markers.
    Also add PWR_FLAG symbols on GND1, GND2, VBUS_HOST and VDD1, and
    no_connect markers on U3's six pins, so `kicad-cli sch erc` exits 0
    across the whole file (the project's ERC config marks
    power_pin_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
    [isolator.kicad_sch]
2026-07-26 feat(sch): SN6505B isolated DC-DC, 5V LDO
    Add SN6505BDBV push-pull driver, WE-PPTI transformer (T1), full-wave
    center-tap Schottky rectifier (D1/D2), and MIC29302WU adjustable LDO
    (U6) implementing the bus-powered isolated DC-DC path: VBUS_HOST ->
    U5/T1 -> DCDC_RAW (rectified, PWR_FLAG'd) -> U6 -> DCDC_5V (~4.97V via
    30.1k/10k divider, Vref=1.24V confirmed against MIC29302WU datasheet).
    T1 is the only component spanning the GND1/GND2 domains, per the
    verified center-tapped-secondary topology from Task 2's extraction
    (with a drive-by fix to that extraction's misstated isolation-test
    pin numbers). kicad-cli sch erc --severity-error exits 0; analyzer net
    membership matches spec exactly for DCDC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
    [isolator.kicad_sch]
2026-07-26 feat(sch): external USB-C power, CC 3A detect, TPS2121 mux
    [isolator.kicad_sch]
2026-07-26 feat(sch): ADuM side 2, USB2514B hub core, 3.3V rail
    [isolator.kicad_sch]
2026-07-26 fix(sch): PGOOD2 provisions, reset discharge diode, self-powered doc
    [isolator.kicad_sch]
2026-07-26 feat(sch): 4 downstream ports with per-port current limiting
    Add U9-U12 (TPS2553DBV power switches, R_ILIM=40.2k -> ~649mA nominal
    current limit per datasheet eq.), U15-U18 (NUP4202 ESD), J3/J4 (USB-A),
    J5/J6 (USB-C with CC1/CC2 56k pull-ups to own VBUS), and per-port VBUS
    bulk decoupling. Wired to the Task 7 hub label stubs by matching label
    text. ERC: 0 errors; the 12 isolated_pin_label warnings from Task 7 are
    gone.
    [isolator.kicad_sch]
2026-07-26 feat(sch): indicators, PWR_FLAGs, stitching provision; ERC clean
    Add D3 (PGOOD indicator, buffered through spare 2N7002 Q2 so the LED
    never loads the shared PGOOD2 logic node) and D6 (DCDC bus-power
    indicator, direct on the regulated DCDC_5V rail). Add C_stitch (1nF
    2kV, DNP, in_bom no) as the sole deliberate GND1<->GND2 EMI stitching
    provision besides U1, with a schematic text note. Verify the Task 4-8
    PWR_FLAG sweep already covers every required rail (nothing added).
    Audit no_connects: 19 total, zero stale/colliding with wires.
    Reconcile lib_symbol_mismatch: fixed 5 of 11 (D_Schottky, MIC29302WU,
    USB_C_Receptacle_PowerOnly_6P, LED) by restoring metadata/graphics
    dropped from the cached co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
    [isolator.kicad_sch]
2026-07-26 feat(sch): footprint assignment, custom RI-20-1 + WE transformer footprints
    [isolator.kicad_sch]
2026-07-26 fix(sch): accept T1 7.51mm clearance in spec, renumber stitching cap
    [isolator.kicad_sch]
2026-07-26 feat(sch): MPN population + TPS2121 CP2 lockout fix
    Populate MPN / Manufacturer / LCSC / Tolerance properties on all 118 BOM
    components (37/37 BOM lines, 100% coverage). Clears the SS-001 sourcing
    gate and the DS-003 datasheet-coverage finding. Core ICs verified against
    their datasheets' own ordering guides (ADUM4165BRIZ p.27, USB2514B-AEZC
    PIS p.55, MIC29302WU PIS example c); every MPN cross-checked for stock and
    price against the LCSC jlcsearch API.
    Also fixes a real functional defect found during the Task 11 deep review:
    U7 pin 3 (CP2) was hard-grounded, so with PR1 pulled low the TPS2121 fell
    into VCOMP mode, which selects the HIGHER of the two inputs rather than
    IN2. VCOMP is specified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
    [isolator.kicad_sch]
2026-07-26 docs: schematic design review
    Full kicad-happy design review of isolator.kicad_sch per the kicad skill's
    Design Review Contract. Verdict: ready for PCB layout, no blockers.
    - analyze_schematic.py run 2026-07-26_0129: 69 findings (16 error, 7 warning);
    all 23 error/warning findings triaged as analyzer false positives with
    raw-file evidence (PP-001 and PU-001 both stem from ISO_5V/ISO_3V3/DCDC_*
    not matching the power-net name heuristic; RS-001 from the analyzer
    stripping PWR_FLAG pins out of the net graph).
    - Deep Review pass over U1/U4/U5/U6/U7 (plus U8/U9-U12/Y1/Y2) against the
    manufacturer PDFs: 14 findings, 14 verified by deep_review_gate.py,
    0 partial, 0 quarantined. Evidenc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
2026-07-26 docs: correct DR-01 root cause, complete DR-06 analysis, fix spec power budget
    Documentation-only fix round; isolator.kicad_sch is untouched and the
    TPS2121 CP2 rewire from the previous commit stands.
    DR-01 had the wrong culprit. TI's "100 mA" against the 750313638 is an
    application-column characterization point, not a rating: Figures 6-21/6-22
    (p.10) characterize the electrically identical 1:1.3 5V->5V "100 mA" entry
    out to 200 mA, the same PN is listed twice in Table 9-3 with two different
    "ratings", and the LDO column is a headroom fact TI corrected in revision.
    Wurth's p.3 thermal curve runs to 1.2 A and the winding DCR holds
    DCDC_RAW >= 5.49 V at 635 mA. The real constraint is the host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
2026-07-26 docs: fix stale DR-01 sentence in review limits
    The Not Performed / Review Limits section still described bus-powered
    capacity as "unresolved between two vendor sources", contradicting the
    DR-01 rewrite in fix round 1. Replaced with a statement consistent with
    the corrected narrative: no vendor conflict exists, the ceiling is
    established analytically from the host's 500 mA budget, the only soft
    input is the ~90% efficiency assumption (80% would drop the downstream
    budget to ~40 mA), and bring-up step 4 characterizes the actual margin.
2026-07-26 docs: document upstream inrush deviation, fix indicator LED wording
2026-07-26 style(sch): full readability pass — boxed sections, GND orientation, PWR_FLAG corner, zero text overlap
    Layout-only pass over the single A1 sheet. Net membership is bit-for-bit
    identical (verified by normalised netlist diff); ERC is unchanged at 0 errors
    and the same 7 lib_symbol_mismatch warnings.
    - Segmented the sheet into 8 titled, framed functional blocks: UPSTREAM HOST
    (GND1), ISOLATION BARRIER, ISOLATED DC-DC, EXTERNAL POWER + PRIORITY MUX,
    USB HUB, DOWNSTREAM PORTS, INDICATORS, POWER FLAGS. No wire crosses a frame.
    - Collected all 7 PWR_FLAGs into a dedicated POWER FLAGS corner, each on its
    own vertical stub terminated by its net label (GND1/GND2 as ground symbols,
    VBUS_HOS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
    [isolator.kicad_sch]
2026-07-26 style(sch): fix inverted GND at R4, redraw transformer symbol for legibility
    [isolator.kicad_sch]
2026-07-26 chore: carry KiCad GUI session updates to pcb/pro files
    [isolator.kicad_pcb]
2026-07-26 feat(pcb): initial placement — isolation barrier + slot, edge connectors, functional clusters, 120x75mm outline
    [isolator.kicad_pcb]
2026-07-26 feat(pcb): 4-layer stack (SIG/GND/PWR/SIG), full-height barrier slot, JLCPCB rules, netclasses with 90R diff profile + colors, barrier creepage DRC
    [isolator.kicad_pcb]
2026-07-26 chore(sch): carry GUI session edits; restore U7 OV2 ground wires lost in GUI edit
    [isolator.kicad_sch]
2026-07-26 feat: swap NUP4202 ESD for flow-through USBLC6-2SC6 (sch+pcb), symmetric USB pair routing
    Replaces all six NUP4202 SOT-363 ESD arrays (U2 host, U3 hub-upstream,
    U15-U18 downstream ports) with USBLC6-2SC6 in SOT-23-6.
    The NUP4202 pinout forced each USB HS pair to split - one line off the top
    of the package, the other off the bottom - so the pairs could not be routed
    symmetrically. The USBLC6-2SC6 is flow-through: I/O1 appears on pins 1 and 6,
    I/O2 on pins 3 and 4, so a pair enters one edge and leaves the opposite edge
    at constant 1.9 mm spacing with no crossing.
    Schematic:
    - lib_symbols cache: NUP4202 removed, USBLC6-2SC6 added (flattened from the
    stock Power_Protection library, which def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
    [isolator.kicad_pcb, isolator.kicad_sch]
2026-07-26 feat(pcb): extend barrier slot under C49 (now 2220), rounded corners with concentric mounting holes, corrected 90R diff geometry per JLC-7628
    [isolator.kicad_pcb, isolator.kicad_sch]
2026-07-26 fix(pcb): routable class geometry — PWR 0.5/0.15 via 0.7, USB diff via 0.5/0.3, connector-courtyard neckdown rule to 0.127; carry in-progress routing
    [isolator.kicad_pcb]
2026-07-26 wip(pcb): routing session — J1 escape, D± pairs through U2
    [isolator.kicad_pcb]
2026-07-26 feat(pcb): power planes — In2 split VBUS_HOST|ISO_5V pours, GND zones trimmed to barrier lines (84/93)
    [isolator.kicad_pcb]
2026-07-27 wip(pcb): routing session 2 — GND stitching pours, more escapes
    [isolator.kicad_pcb, isolator.kicad_sch]
2026-07-27 fix: decoupling audit fixes — tantalum C10 (T491D, polarity-correct), R36 330R min-load, 22u port bulk, re-seat ISO_5V bypass caps at their ICs per datasheet distances
    [isolator.kicad_pcb, isolator.kicad_sch]
2026-07-27 wip(pcb): zone refill
    [isolator.kicad_pcb]
2026-07-27 feat(pcb): plane hookup pass — 94 stitching vias/stubs + QFN EP thermal vias, C10 dedupe (orphan removed, linked instance repositioned), crystal-area via fix
    [isolator.kicad_pcb]
2026-07-27 feat(pcb): route-ready passive placement — datasheet-oriented decoupling, chains, and port clusters
    [isolator.kicad_pcb]
2026-07-27 wip(pcb): user session — U15 realigned, port1 routing started
    [isolator.kicad_pcb]
2026-07-27 fix(pcb): USB ESD alignment — U16 derotated, U17/U18 centered on their connectors' D-pad axes; CC Rp/caps re-seated; stale fragments cleared
    [isolator.kicad_pcb]
2026-07-27 fix(pcb): rotate U3 180° and shift 0.6 mm west so the ISO_D pair does not cross
    U3 (ISO-side USBLC6-2SC6) sat at rot 0, which put ISO_D+/ISO_D- in the
    opposite order to BOTH neighbours:
    U1 pad12 = ISO_D+ (y 75.445), pad13 = ISO_D- (y 74.175) -> D- north
    U3 pad1 = ISO_D+ (y 72.05), pad3 = ISO_D- (y 73.95) -> D- south
    U4 pad31 = ISO_D+ (x 116.5), pad30 = ISO_D- (x 117.0) -> D- east
    A differential pair cannot swap members without a layer crossunder, so the
    old orientation cost two crossunders (4 vias) on the isolated high-speed
    link — one between U1 and U3 and another between U3 and U4. Rotating U3
    180° makes the member order agree at both ends, so the pair runs with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
    [isolator.kicad_pcb]
2026-07-27 feat(pcb): route cluster-local nets
    22 short two/three-point nets whose pads all sit within ~9 mm of each other,
    routed on F.Cu with 45/90 geometry only, 0.20 mm width, no vias:
    ILIM sense /P1_ILIM /P2_ILIM /P3_ILIM /P4_ILIM /ILIM_SET
    hub straps /HUB_CFG_SEL0 /HUB_CFG_SEL1 /HUB_NON_REM0 /HUB_NON_REM1
    hub analog /HUB_RBIAS /HUB_CRFILT /HUB_PLLFILT /HUB_XO
    soft start /SS_SET
    regulator ADJ Net-(U6-ADJ)
    USB-C CC /P3_CC1 /P4_CC1 /P4_CC2
    indicators /ST_LED /PGOOD_LED_A /PGOOD_LED_K /DCDC_LED_A
    Every candidate path was walked against an exact clearance model (rotated-rect
    pads, capsule tracks, circular vias; 0.15 mm inter-net clearance, 0.30 mm to
    t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
    [isolator.kicad_pcb]
2026-07-27 style(pcb): 45/90 tidy pass
    All 23 track segments whose angle was not a multiple of 45 degrees have been
    replaced by two-segment doglegs with identical endpoints, width, layer and net.
    For each one both dogleg orientations (axis-first and 45-first) were built and
    clearance-checked against an exact obstacle model; the orientation whose corner
    sits furthest from other copper was kept.
    The 23 were 20 GND2 plane-stitching stubs, one /VBUS_HOST stub, one /ISO_5V
    stub and one 0.129 mm GND1 jog at U1. None needed to be left as-is.
    Removal of the originals was done in a separate pcbnew session after the
    replacements were added, then the zones were refilled.
    Verified: 0 segments off the 45/90 gri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
    [isolator.kicad_pcb]
2026-07-27 feat: swap hub port bundles 1<->4 2<->3 for crossing-free fanout (sch+pcb)
    U4 (USB2514B) is at rot 0 with all four downstream port pin bundles on its
    WEST edge, while all four ports are on the far EAST side and are approached
    heading east. Any path from "heading west" to "heading east" is a 180 degree
    turn, which reverses the transverse order of the ribbon: the pairs left U4 as
    P1,P2,P3,P4 (north->south) and arrived as P4,P3,P2,P1, while the destinations
    need P1,P2,P3,P4. That is a full reversal of four items = 6 pair-to-pair
    crossings, i.e. at least three crossunders (12 vias) on 480 Mbit/s pairs.
    No rotation of U4 fixes it - handedness is preserved under rotation.
    Hub ports 1-4 are func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
    [isolator.kicad_pcb, isolator.kicad_sch]
2026-07-27 feat(pcb): route USB differential pairs + A/B-row ties
    Lands the differential-pair copper that the previous pass designed but could
    not emit. All members 0.21 mm, 0.337 mm centre-to-centre, 45/90 only, coupled
    bends, F.Cu except the ISO long haul.
    Landed
    ISO_D U1 -> U3 (F.Cu) skew -0.008 mm
    ISO_D U3 -> U4 (B.Cu + 4 vias) skew +0.680 mm
    P1_D U4 -> U15 (F.Cu) skew +1.168 mm
    P2_D U4 -> U16 (F.Cu) skew +1.085 mm
    P2_D U16 -> J4 (F.Cu) skew 0.000 mm
    HOST_D J1 B6/B7 -> U2 A/B-row ties, spliced onto the owner's existing
    0.5 mm U2 escapes (extended, nothing ripped)
    Enabling change: /HUB_XO ran straight up U4 pad 31's ow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
    [isolator.kicad_pcb]
2026-07-27 feat(pcb): complete USB pair routing — P3/P4 B.Cu detour, J5/J6 ties, CC crossunders
    All six differential pairs are now routed end to end.
    * ISO_D U3->U4 re-run north on B.Cu (its old diagonal sat exactly where P3/P4
    need to dive). Old B.Cu removed in its own session, re-added after.
    * P3/P4 escape U4 on F.Cu, dive to B.Cu in the 0.55 mm slot between the ISO
    haul and the GND2 stitch via at (108.125, 70), descend past the C16/C32
    pinch, and surface south of P1/P2's east runs. 2 vias per member,
    16-19 mm of B.Cu each, entirely inside the x>93.5 In2 pour.
    * P3 needs a second 4 mm B.Cu hop to reach U17: R29 and C45 leave only a
    0.10 mm wide F.Cu window at y=96.6, so the pair passe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
    [isolator.kicad_pcb]
2026-07-28 feat(pcb): autoroute remaining nets via Freerouting pipeline — 110 nets landed (146->36 unconnected), pairs verified conserved, planes locked out, PGOOD2 barrier fix
    [isolator.kicad_pcb]
2026-07-28 docs: v1 simplified isolator design spec + v2 CC ESD finding
    v1 is a single-port inline isolator: USB-C in, USB-C out, bus-powered
    only, no hub, in a Hammond 1455C802 extrusion. Same ADuM4165 core as the
    4-port design, ~125 footprints down to ~50. Ships as a bench tool and
    validates blocks v2 inherits back.
    Key decisions:
    - Bus-powered to a plain 500 mA host, no upstream CC sensing. Dropping
    the hub raises the downstream budget from ~75 mA shared across four
    ports to ~240 mA on one.
    - MIC29302 (3 A) -> ~1 A fixed 5.0 V LDO; the bus-powered path can never
    exceed ~315 mA even in v2, so the 3 A part was always oversized.
    - Extrusion bonded to neither ground. This makes >=1 mm edge copper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
2026-07-28 docs: v1 schematic implementation plan (8 tasks)
    Covers the v1 spec from empty project to reviewed, ERC-clean,
    footprint-assigned, MPN-populated schematic. PCB layout is a follow-on.
    Task 1 front-loads the mechanical feasibility gate so we do not build a
    schematic for a board that cannot fit the 1455C802, with the 1455C1202
    fallback stated as an outline-only change.
    Pin numbers, topology, and component values are lifted from the v2
    netlist rather than retyped -- the DC-DC secondary is center-tapped, so
    the rectifier is two-diode full-wave, and that is now stated explicitly
    instead of left as an open question the way the v2 plan did.
    Two things the plan refuses to let the implementer guess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
2026-07-28 feat(v1): project skeleton, shared lib tables, mechanical feasibility gate
    [isolator-v1.kicad_pcb, isolator-v1.kicad_sch]
2026-07-28 fix(v1): correct kicad_pro self-references to v1 filenames/uuid
    meta.filename, top_level_sheets[0].filename/name/uuid, and sheets[0] entry
    still pointed at v2's isolator.kicad_pro/isolator.kicad_sch and its root
    sheet UUID after the verbatim Step 1 copy. Point them at
    isolator-v1.kicad_pro/isolator-v1.kicad_sch and the UUID actually used in
    v1/isolator-v1.kicad_sch (00000000-0000-0000-0000-000000000001).
2026-07-28 feat(v1): select 5V LDO, VBUS TVS, and Y2 stitching cap
2026-07-29 fix(v1): Task 2 review round 1 - proper LDO survey, Y1 CY1 reclassification, corrected feasibility
    Critical 1: survey TLV767 small packages, AP2114, AP7361C, MIC5219, TLV757P, NCP1117
    against the real operating point instead of stopping at the brief's package row.
    AP2114/AP7361C fail on Vin ceiling (6.0-6.5V, too tight against 6.1V unloaded DCDC_RAW),
    TLV757P fails on Vin ceiling (5.5V max), NCP1117 fails on dropout (1.07-1.2V @ 800mA,
    datasheet-confirmed). Winner: TLV76750DGNR (TI, HVSSOP-8, thermal pad, 21.9 mm^2
    courtyard vs MIC29302WU's 188.1 mm^2). New symbol isolator-lib:TLV76750DGNR added
    (no stock HVSSOP-8 symbol exists for TLV767). MIC29302WU kept documented as fallback.
    Critical 2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
2026-07-30 feat(v1/sch): upstream USB-C host section, ADuM Side 1, crystal
    Places and wires everything on the host side of the isolation barrier: J1
    (USB-C receptacle), U1 (ADuM4165, Side 1 pins only, Side 2 no-connected for
    Tasks 4/5), U2 (USBLC6-2SC6 D+/D- ESD), Y1 (24MHz crystal + C1/C2 load caps),
    D5 (new T6V0S5A-7 VBUS TVS), R1/R2 (dedicated 5.1k CC pulldowns), C3 (4.7uF,
    not v2's 10uF, to leave headroom under the USB 10uF/50uC bus-power limit),
    C4/C5 (VBUS_HOST/VDD1 bypass).
    Lifted lib_symbols and symbol instances verbatim from isolator.kicad_sch
    (v2) wherever v2 already had the same subcircuit -- same refdes, same sheet
    coordinates, regenerated UUIDs -- since v2's host-side wiring already uses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
    [isolator-v1.kicad_sch]
2026-07-30 fix(v1/sch): Task 3 review round 1 - D5 polarity, GND2 no-connect, VDD1 typing
    Critical: D5 (VBUS TVS) was wired backwards. T6V0S5A-7 datasheet and KiCad's
    Device:D convention both confirm pin 1 = cathode, pin 2 = anode; my original
    placement had pin 1 on GND1 and pin 2 on VBUS_HOST, forward-biasing the diode
    continuously at 5V. Swapped which net each pin lands on so pin 1 -> VBUS_HOST,
    pin 2 -> GND1, and corrected the symbol's Description property to match.
    Important: removed the no_connect markers from U1's GND2 pins (11, 15, 16,
    17, 19) -- they self-connect via KiCad's same-name hidden-power-pin rule, so
    marking them no_connect was a real contradiction (ERC's no_connect_connected
    warning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
    [isolator-v1.kicad_sch]
2026-07-30 feat(v1/sch): SN6505B isolated DC-DC, full-wave rectifier, 5V LDO
    Adds Task 4's isolated power section to v1/isolator-v1.kicad_sch: U4
    (SN6505BDBV push-pull driver), T1 (750313638 transformer), D1/D2 (SS34
    full-wave center-tap rectifier), U5 (TLV76750DGNR 5.0V LDO), and their
    associated bypass/bulk capacitors (C6-C11), producing the DCDC_RAW,
    ISO_5V, and GND2 nets. Topology transcribed verbatim from the reviewed
    v2 design; TLV76750DGNR pinout (including SNS-to-OUT tie and thermal
    pad to GND2) verified against the TI datasheet.
    ERC: 0 errors (severity-error gate), 1 pre-existing informational
    warning inherited unavoidably from copying v2's own embedded
    SN6505BDBV symbol (confirmed identical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
    [isolator-v1.kicad_sch]
2026-07-30 fix(plan): isolation check false-positived on every net touching U1
    The check put U1/T1/CY1 in both domain sets, so any ordinary net they
    touch -- HOST_D+, VBUS_HOST, DCDC_RAW -- contained a member of both and
    reported a bridge. Task 4's implementer hit 8 false positives and had to
    trace them pin-by-pin by hand.
    Subtract the allowed crossings from both domain sets up front, then ask
    whether a non-crossing host-side part shares a net with a non-crossing
    isolated-side part.
2026-07-30 docs(v1): verify SS34 polarity against manufacturer datasheet
    Task 4 review flagged that D1/D2's cathode/anode wiring was verified
    against the KiCad symbol and v2's netlist but never against the SS34
    part's own datasheet - the same failure class that caused Task 3's
    reversed TVS. Fetched the MDD (Microdiode Electronics) SS34 datasheet
    (LCSC C8678, the exact part already referenced in D1/D2's properties)
    and confirmed "Polarity: Color band denotes cathode end" in
    DO-214AC/SMA package, matching Diode_SMD:D_SMA pad 1 = pin 1 = K.
    No schematic change: the existing wiring was already correct. Adds
    datasheets/extracted/SS34-pins.md as the documented verification
    record.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
2026-07-30 feat(v1/sch): ADuM Side 2, TPS2553 port switch, downstream USB-C
    Wires the isolated (GND2) output side of the v1 USB isolator - the last
    electrical task. ADuM4165 U1 Side-2 pins (DD+/DD-/PGOOD/VDD2/VBUS2) are
    now live; TPS2553DBV (U6) current-limited port switch, USBLC6-2SC6 (U3)
    ESD protection, T6V0S5A-7 (D6) VBUS TVS, PGOOD/FAULT LED indicators
    (D3/D4), and the downstream USB-C receptacle (J2) are placed and wired.
    Four datasheet-driven decisions, each independently verified rather than
    assumed or copied:
    - D6 TVS polarity re-derived from the Diodes Inc. datasheet's own device
    schematic diagram (pin1=cathode->PORT_VBUS, pin2=anode->GND2) rather
    than copied from D5's wiring, per the re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
    [isolator-v1.kicad_sch]
2026-07-30 fix(v1/sch): Task 5 review round 1 - PGOOD buffer via 2N7002, layout overlaps
    Important: the "PGOOD is push-pull, direct-drive the LED" conclusion didn't
    hold up - absence of a VOH/VOL spec and no pull-up in the datasheet's block
    diagram is not evidence of push-pull, and v2's own schematic already drives
    this identical PGOOD2 signal through a 2N7002 (Q2) with a 100k pull-up to
    its isolated 3.3V rail and a 100k pull-down, not a direct LED drive.
    Replicated that arrangement: Q1 (2N7002) buffers PGOOD2, R9 (100k) pulls
    the gate up to VDD2 - never ISO_5V, since the ADuM4165 abs-max on PGOOD is
    VDD2+0.5V (Table 8) and a 5V pull-up would exceed it if the pin is actually
    open-drain - and R10 (100k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
    [isolator-v1.kicad_sch]
2026-07-30 fix(v1): Task 5 review round 2 - PGOOD confirmed push-pull, remove R9/R10, fix 4 label overlaps
    PGOOD structure resolved from primary evidence rather than left as a hedge: ADI's own
    EVAL-ADuM4165EBZ/EVAL-ADuM4166EBZ schematics and BOMs (datasheets/eval-adum4165-4166-ug-2027.pdf,
    Figure 3/6 + Table 4/5) wire PGOOD straight to a test header with zero external resistors on
    either board, and the pin description (adum4165-4166.pdf Table 12/13) describes "high output"/
    "low output" states, not open-drain release. Push-pull confirmed -> removed R9 (pull-up) and R10
    (pull-down), the indeterminate bias divider on Q1's gate; Q1 itself is kept as a level-shifting
    buffer for the 5V-domain LED drive. VDD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
    [isolator-v1.kicad_sch]
2026-07-30 fix(v1): Task 5 review round 3 - PGOOD reclassified unspecified, restore R9 (DNP)/R10 (populated)
    Independent review found the eval-board evidence has no differential power: VDD1/VBUS1 (LDO
    power rails, unambiguously not open-drain-relevant) route to unpopulated DNI test headers the
    identical way PGOOD does, and Table 3 of the eval guide confirms this is the generic convention
    for all nine test points regardless of pin type. The "high output/low output" pin-description
    language doesn't distinguish push-pull from open-drain either. PGOOD reclassified from "confirmed
    push-pull" to "unspecified" -> implemented the brief's third case:
    - R10 restored: 100k, PGOOD2 -> GND2, POPULATED. Gate parks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
    [isolator-v1.kicad_sch]
2026-07-30 feat(v1/sch): populated barrier stitching cap, PWR_FLAGs, ERC clean
    - Place CY1 (Device:C, Songtian Q07F3Z102MA5B0S0N0, 1nF Y1 400VAC,
    isolator-lib:C_Disc_D7.0mm_W5.5mm_P14.00mm) bridging GND1/GND2 --
    populated, not DNP, per Task 2's part selection. Adds the Device:C
    lib_symbol (not previously embedded) and a dedicated section box with
    a note explaining the populated-vs-DNP rationale and warning against
    substituting v2's 2220 SMD part.
    - Audit PWR_FLAGs: confirmed the existing four (GND1, GND2, VBUS_HOST,
    DCDC_RAW) are all required -- DCDC_RAW's flag was undocumented in the
    brief but is legitimate (D1/D2 rectifier pins are passive-typed, not
    a recognized ERC source), and VDD1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
    [isolator-v1.kicad_sch]
2026-07-30 docs: correct CY1 from Y2 to Y1 in spec and plan
    Task 2 reclassified the barrier-stitching cap during execution: CY1
    bridges a reinforced barrier, the same role the ADuM4165 plays, and Y1
    is the class rated for that. The reclassification is also what surfaced
    a stocked 14mm-pitch part, moving the geometric creepage margin from
    +1.1mm to +5.05mm.
    The spec and plan still said Y2, so a future reader would have been
    misled by the durable documents while the built schematic said Y1. Both
    now record the change and why, rather than silently reading Y1.
    Also notes what the review established: Y-capacitor datasheets generally
    do not publish a creepage figure at all, so this margin is derived from
    m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
2026-07-30 feat(v1/sch): footprint audit and binding layout constraints (Task 7)
    Audited all 43 v1 component instances: every symbol already carried the
    correct footprint from Tasks 2-6 (no reassignment needed). Verified all 15
    distinct footprints resolve to real files on disk (stock KiCad libraries +
    isolator-lib.pretty), not just non-empty strings.
    Added the "V1 LAYOUT CONSTRAINTS -- BINDING" text block to previously-empty
    sheet space so the PCB plan inherits the 7 binding constraints (edge
    pullback, ESD placement, barrier creepage, bypass lead length, connector
    mounting, and the 1.7 mm length-chain margin / D1+D2 side-by-side
    requirement) without needing the spec open.
    Mechanical sanity check agai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
    [isolator-v1.kicad_sch]
2026-07-30 docs: move v1 to the 120mm 1455C1202 enclosure
    Task 7's footprint audit replaced the length budget's placeholder
    dimensions with courtyards measured from the real .kicad_mod files. The
    chain went from ~78mm to 80.1-83.7mm against 80.0mm available: the USB-C
    receptacle is 9.42mm deep not 9.0, and D_SMA is 7.0mm on the load-bearing
    axis not 5.0. Every zone grew.
    Switching to the 1455C1202 is an edge-cut-only change the spec already
    documented as the fallback, and buys ~40mm of slack.
    Recorded honestly rather than as a hard failure: this is a 1-D chain model
    of a 2-D board, area utilization is only 23.7% of a 50mm-wide panel, and
    nothing forces the parts into one row. 80mm may well be placeab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
2026-07-30 docs(v1): move feasibility record to 1455C1202, fix utilization arithmetic (Task 7 fix round 1)
    Human partner ruled v1 moves to the 1455C1202 (120 mm) enclosure after the
    reviewer extended Task 7's own recompute methodology to zones 1/5 and found
    the full 5-zone chain no longer closes against 80 mm (80.1-83.7 mm real vs
    80.0 mm available). Spec/plan already updated in 7366d81.
    - Schematic constraints text (v1/isolator-v1.kicad_sch): item 1 now reads
    "120 mm length (1455C1202)"; item 7 rewritten to drop the stale 1.7 mm
    margin figure and carry forward only what survives the enclosure change
    -- the rectifier zone measures 19.36 mm and D1/D2 must be placed side by
    side, not in series.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
    [isolator-v1.kicad_sch]
2026-07-30 docs(plan): add the D1/D2 side-by-side constraint as item 7
    The schematic's binding-constraints block carries seven items; the plan's
    template listed six. Item 7 -- the rectifier zone measuring 19.36mm and
    D1/D2 needing side-by-side placement -- came out of Task 2's feasibility
    rework and was the one constraint that survived the move to the 120mm
    enclosure, so the plan should carry it too.
2026-07-30 feat(v1/sch): MPNs, BOM export, schematic design review
    Closes the two named BOM gaps (C3/C7 4.7uF, C8/C10 47uF) with live-verified
    LCSC parts, and verifies R3-R8/R9/R10/U5 LCSC codes against the live
    catalogue. Exports the BOM (25 lines, 100% MPN coverage), runs the
    kicad-happy analyzer, and walks the v1 spec point by point against the
    exported netlist (8/8 satisfied, 0 deviations). All 6 non-info analyzer
    findings triaged as false positives of one root cause (PWR_FLAG not
    recognized as a net source), already identified and accepted in Task 6.
    ERC unchanged from baseline: 0 errors, 1 pre-existing lib_symbol_mismatch
    warning on U4, not touched per prior direction.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
    [isolator-v1-bom.csv, isolator-v1.kicad_sch]
2026-07-30 docs(v1): close D5/D6 footprint pad-polarity check (Task 8 fix round 1)
    Task 2 flagged the D5/D6 TVS footprint (Diode_SMD:D_SOD-523) as
    pad-geometry-unchecked against the T6V0S5A-7's own datasheet, and it was
    never subsequently closed - Tasks 3/4/7 only verified courtyard size.
    The Device:D_TVS symbol's pins are generic (A1/A2, passive), so the
    review's "correctly oriented" claim rested on Description-property text
    alone, not a datasheet cross-check.
    Read the T6V0S5A-7 datasheet's mechanical drawing (cathode band = pin 1)
    and cross-checked it against Diode_SMD:D_SOD-523.kicad_mod's F.Fab
    diode glyph (pad 1 sits under the cathode-bar marking) - same method
    Task 4 used to close the identical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
2026-07-30 fix(v1): final whole-branch review fix wave — R3/FAULT docs, ADuM4165 GND-pin bypass trap, VBUS_HOST cap placement, PGOOD push-pull, title block
    Applies all findings from the final whole-branch review
    (docs/superpowers/reviews/2026-07-28-v1-schematic-review.md, "Fix round 2"):
    Important:
    - Corrects the spec's power-budget claim about R3/TPS2553 ILIM. R3 is kept
    unchanged (93.1 kOhm); the documentation now states I_OS = 252/286/324 mA
    min/nom/max (SLVS841F Eq. 1), that the DC-DC's own ~240 mA droop -- not the
    TPS2553 -- is the real port ceiling, that R3's job is soft-start plus a
    short-circuit backstop, and that FAULT will not light on a normal overload
    as an accepted consequence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
    [isolator-v1.kicad_sch]
2026-07-31 wip(4port): save in-progress 4-port schematic/PCB edits before archiving
    Snapshot of the uncommitted work on the 4-port isolator so it is preserved
    before the repo collapses to the single-port design at the root.
    State of this snapshot: ERC reports 3 errors, all U7 (TPS2121) pin 4 OV2
    disconnected. That is pre-existing, in-progress work on the 4-port design --
    it is NOT a regression introduced here and is deliberately left unfixed.
    This commit is the tip of branch 4port-archive; main proceeds without the
    4-port project.
    [isolator.kicad_pcb, isolator.kicad_sch]
2026-07-31 refactor: collapse repo to the single-port isolator at the root
    The single-port design is the one that ships, so it moves up from v1/ and
    becomes the only KiCad project in the repo. The 4-port design is archived on
    branch 4port-archive (tip ef23a53) and removed from main.
    Moved (via git mv, history preserved):
    v1/isolator-v1.kicad_{sch,pcb,pro,dru} -> isolator.kicad_{sch,pcb,pro,dru}
    v1/isolator-v1-bom.csv -> isolator-bom.csv
    v1/{sym,fp}-lib-table -> {sym,fp}-lib-table
    analysis-v1/ -> analysis/
    Deleted (4-port project and its artifacts): isolator.kicad_{sch,pcb,pro,prl,dru},
    isolator-erc.rpt, isolator-backups/, analysis/, l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
    [isolator-bom.csv, isolator-v1.kicad_pcb, isolator-v1.kicad_sch, isolator.kicad_pcb, isolator.kicad_sch]
2026-07-31 docs(layout): PCB layout design spec
    Design for the 120x50mm 4-layer layout into the Hammond 1455C1202.
    Five conditions measured before design, each of which changes what gets built:
    1. U1's land pattern is 8.3000 mm pad-edge to pad-edge -- exactly the
    requirement, zero margin. No DRC rule may demand more than 8.3 mm across
    the barrier or U1 fails by construction.
    2. T1's land pattern is 7.5100 mm, 0.79 mm short in straight line. That is a
    clearance figure, not creepage; the routed slot under T1 is what makes it
    pass. A barrier gate measuring naive Euclidean distance fails at T1 by
    design, so Gate 1 is creepage-aware on F.Cu.
    3. Thirteen live nets match neither HOST_SIDE nor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
2026-07-31 docs(layout): PCB layout implementation plan
    Eight tasks, each ending in an independently testable deliverable. Gates are
    written before the work they police, so every task's cycle is write-gate,
    watch-it-fail, do-the-work, watch-it-pass, commit.
    Every pcbnew API the plan's code calls was probed against KiCad 10.0.5 before
    writing: FootprintLoad, NETINFO_ITEM, SetLayerName, LSET.addLayer,
    ZONE.SetDoNotAllowPads, ZONE_FILLER.Fill, GetFilledPolysList, GetCourtyard,
    SetOrientationDegrees, track GetLength. All present.
2026-07-31 feat(pcb): board skeleton -- 120x50 outline, JLC04161H-7628 stackup, edge keepouts, Gate 2
    Also corrects the stackup's source branch in the spec and plan. It is on
    claude/jlcpcb-design-rules-4layer-6d6ae1 (5c56d3e), not 4port-archive -- the
    archived 4-port board still carries the stale 2-layer stackup (1.51mm core,
    Er 4.5) that 5c56d3e was written to replace.
    The plan's sed-based extraction was also wrong: a sed range on
    /(stackup/,/^\t\t)/ closes early on this file and drops In1.Cu and In2.Cu while
    still yielding balanced parentheses, so the truncation reads as success. Now
    extracted by paren matching.
    [isolator.kicad_pcb]
2026-07-31 fix(pcb): netclass patterns and DRC rules for the single-port design
    13 live nets matched neither HOST_SIDE nor ISO_SIDE, so the barrier rules never
    fired on them -- including all four transformer winding nets (/PP_A, /PP_B,
    /RECT_A, /RECT_B), the closest copper to the barrier on the board. /PORT_D+/-
    matched no USB_DIFF90 pattern and would have routed at Default 0.2/0.25
    geometry, missing 90 ohm on half the USB path.
    Creepage floor raised 8mm -> 8.3mm. barrier-clearance-U1 deliberately left at
    8mm: U1's pads are at exactly 8.3000mm, so a rule at 8.3mm would sit on the
    same value as the geometry it exists to permit. connector-neckdown reduced from
    J1-J6 to J1/J2.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
2026-07-31 feat(pcb): populate board -- 43 footprints, 34 nets, schematic parity clean
    Reports 170 pad bindings against 164 netlist entries: J1 and J2 each have four
    physical 'SH' shield pads mapping to a single netlist entry, so 164 + 6 = 170.
    Reconciled rather than assumed.
    kicad-cli pcb drc --schematic-parity: 0 parity issues. The 53 clearance and 128
    unconnected violations are the parking grid at y=70 and disappear at placement.
    [isolator.kicad_pcb]
2026-07-31 feat(pcb): placement, T1 barrier slot, barrier keepout, Gate 1 passing
    Gate 1: F.Cu 8.3000 mm creepage (U1's pads, the binding minimum met exactly),
    12.0000 mm on the other three layers. Gate 2 and placement assertions clean,
    DRC down to unconnected-items only, 0 schematic parity issues.
    Three real problems the gates caught, none of them predicted:
    - CY1 was mounted backwards. Its pad 1 carries GND2 but sat at x=53, on the
    HOST side of the barrier, putting isolated-domain copper in the host region.
    The cap is non-polarised so this is purely geometric: reoriented to 180 with
    origin at x=67 so pad 1 (GND2) lands isolated-side and pad 2 (GND1) host-side.
    - J1 and J2 shield pads overhun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
    [isolator.kicad_pcb]
2026-07-31 feat(pcb): split GND1/GND2 pours on both inner layers, barrier intact
    Four zones, each 2462.88 mm^2: GND1 x2..55.85 and GND2 x64.15..118 on both
    In1.Cu and In2.Cu. Equal areas are real, not a copy error -- both regions are
    53.85 x 46 mm and the through-hole content is symmetric (CY1 one pad each side,
    J1 shield GND1, J2 shield GND2).
    Gate 1 now measures 8.3000 mm on the inner layers, from the pour edges rather
    than from pads. Unconnected 128 -> 124.
    [isolator.kicad_pcb]
2026-07-31 feat(pcb): host-side routing, U2 channel swap, Gate 3
    Routing done in pcbnew by the operator: 157 tracks, 32 vias on F.Cu/B.Cu
    covering VBUS_HOST, HOST_D+/-, GND1, PP_A/B, XTALIN/XTALOUT, VDD1 and the J1 CC
    pair. Isolated side is not routed yet.
    Schematic change, verified rather than assumed: D+ and D- were swapped through
    U2's two ESD channels. HOST_D+ moves from U2 pins 1/6 to 3/4 and HOST_D- the
    reverse. Endpoints are unchanged -- J1.A6/B6 -> U1.8 is still D+ -- so this is
    electrically equivalent (the USBLC6-2SC6's channels are identical) and still
    satisfies the in-line 1/3 -> 6/4 requirement of constraint 3, with the channels
    exchanged. It is a deliberate rewire, not a library artifact: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
    [isolator.kicad_pcb, isolator.kicad_sch]
2026-07-31 fix(pcb): clear hole_to_hole and clearance violations
    hole_to_hole (x2): the four HOST_D+/HOST_D- crossover vias sat on a 0.7 mm
    horizontal pitch, which with 0.3 mm drills is a 0.400 mm hole gap against the
    0.5 mm min_hole_to_hole rule. Spread the two columns to a 0.9 mm pitch
    (x 23.8->23.7 and 24.5->24.6), giving 0.600 mm. All 16 attached track endpoints
    moved with the vias so the crossover stays intact -- the two tiny B.Cu/F.Cu
    stubs and both diagonals land exactly on the via centres.
    Vertical pitch is untouched at 0.8 mm = 0.500 mm gap. That is exactly the
    configured 0.5 mm rule; KiCad reports the threshold as 0.4995 mm because it
    applies a 0.5 um epsilon, so this is at spec rather than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
    [isolator.kicad_pcb]
2026-07-31 feat(pcb): route the isolated side -- both pairs hand-routed, gates 1-3 passing
    Unconnected 71 -> 9. Gates 1, 2 and 3 all PASS; schematic parity 0.
    /PORT_D+/- is hand-routed, not autorouted. Freerouting's attempt was discarded
    for two reasons: it put the two halves of the pair on different layers for 35 mm
    (no differential coupling at all), and it shorted U3 pins 3-4 with an external
    trace, bypassing the ESD array instead of routing in-line through it -- the exact
    thing constraint 3 forbids. The replacement uses the host side's idiom: one
    continuous trace passes THROUGH both array pads, so the array is in-line with no
    stub and connectivity closes without a pin-to-pin jumper. Skew 0.0184 mm.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
    [isolator.kicad_pcb]
2026-07-31 feat(pcb): fully routed -- 0 unconnected, all gates passing
    Unconnected 71 -> 0. Gates 1, 2, 3 PASS; schematic parity 0. The only remaining
    DRC violations are 23 silkscreen (16 silk_over_copper, 7 silk_overlap).
    barrier F.Cu 8.3000 creepage, inner 8.3000, B.Cu 10.4542
    edge 0 within 1 mm, 0 even inside the 2 mm target
    pairs HOST skew 0.0463 mm, PORT skew 0.0184 mm
    Three placement errors from Task 4 were the real blockers, not routing:
    - U5 was oriented so its DCDC_RAW inputs faced away from the rectifier and its
    ISO_5V output faced away from C10, forcing both nets to wrap around the package
    and thread past the NC pins. Rotated 180.
    - C9 is U5's input bulk cap and had t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
    [isolator.kicad_pcb]
2026-07-31 fix(pcb): clear all silkscreen violations -- DRC now completely clean
    23 silkscreen violations (16 silk_over_copper, 7 silk_overlap) cleared by moving
    29 reference designators clear of pads and neighbouring silk.
    C1 needed separate treatment: the first pass checked pads and other reference
    fields but not footprint silkscreen graphics, so it landed on Y1's outline. The
    nearest clear spot at full text size was 6.8 mm away, which would read as
    belonging to a different part, so C1's refdes is set to 0.55 mm text and sits
    1.8 mm from its own body instead.
    Board state: 0 DRC violations, 0 unconnected, 0 schematic parity issues, and all
    three verification gates passing.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
    [isolator.kicad_pcb]
2026-07-31 fix(pcb): U3.5 escapes without via-in-pad; Gate 3 rewritten to measure real path
    Two requested fixes plus a serious measurement bug found while doing them.
    (1) U3.5 no longer needs a via in its own pad. Pin 5 is the middle of U3's right
    column with D+ on pin 6 and D- on pin 4, so its only F.Cu escape is the corridor
    between U3 and J2 -- which was 0.8 mm wide and blocked by D-'s diagonal to A7.
    Moving the D- jumper into J2's pads was tried and rejected: those signal pads are
    0.3 mm tall, so even a minimum 0.2 mm drill leaves 0.250 mm to the neighbour
    against a 0.254 mm rule. Instead U3 moved 1.5 mm left, widening the corridor to
    2.300 mm (still 2.3 mm from J2's pads, inside constraint 3's 5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
    [isolator.kicad_pcb]
2026-07-31 wip: operator's mounting holes and fiducials, schematic and board edits
    Snapshot of hand work done in KiCad before any repositioning, so it cannot be
    lost. Adds H1-H4 (MountingHole_3.2mm_M3_Pad_Via) and FID1-FID4
    (Fiducial_0.5mm_Mask1.5mm), currently parked off-board around x=212..251,
    plus the corresponding schematic changes.
    Also drops a stray ~isolator.kicad_pro.lck that had been committed, and
    gitignores that pattern.
    Committed as-is, unreviewed. Verification follows in the next commit.
    [isolator.kicad_pcb, isolator.kicad_sch]
2026-07-31 fix(gates): origin-agnostic board box, real slot detection, pad-through paths
    The board was translated by (+86.875, +76.703), given 3 mm corner radii, and its
    T1 barrier slot extended from 13.6 mm to 46.06 mm. Three gates broke on that --
    the gates were wrong, not the board.
    - lib_board gains board_box()/long_edges(), derived from Edge.Cuts. Nothing may
    assume the board starts at the origin any more, because it does not.
    - edge_pullback measured against a hardcoded y=0..50 and so reported every track
    as tens of mm outside the board.
    - barrier._slots() classified an Edge.Cuts item as perimeter if it spanned >90%
    of the board. The extended slot is 46.06 mm of a 50 mm board, so it was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
2026-07-31 feat(pcb): position mounting holes and fiducials in the corners
    H1-H4 at board (3.70, 5.20) / (3.70, 44.80) / (116.30, 5.20) / (116.30, 44.80);
    FID1-4 at (7.50, 2.75) / (7.50, 47.25) / (112.50, 2.75) / (112.50, 47.25).
    Found by search against the real outline rather than hand-picked.
    The 5.20 mm inset is not arbitrary and is as close to the corner as these can
    legally sit: the M3 footprint carries a 6.4 mm GND pad, and constraint 2 requires
    copper -- pad edge, not hole centre -- to stay 2 mm clear of the long edges,
    which fixes the centre at 2.0 + 3.2 = 5.2 mm. H1/H2 are GND1 and are held
    entirely host-side of the barrier keepout; H3/H4 are GND2 and entirely
    isolated-side, so neither pair c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
    [isolator.kicad_pcb]
2026-07-31 feat(pcb): drop to three fiducials in an L, breaking the orientation ambiguity
    Four fiducials in symmetric corners have 180-degree rotational symmetry, so the
    pattern is identical on a board mounted the wrong way round and gives the placer
    no orientation reference. Three corners of a rectangle cannot be rotationally
    symmetric, so removing one fixes that by construction rather than by an offset a
    "best 3 of 4" fit could undo.
    Three is also what the process wants: two fiducials give X, Y and rotation, the
    third adds scale/stretch correction and a consistency check. A fourth adds
    nothing. Removing one costs no triangulation baseline either -- any three corners
    of a rectangle enclose the same a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
    [isolator.kicad_pcb, isolator.kicad_sch]
2026-07-31 feat(pcb): even 3.00 mm border at the corners -- holes concentric with the arcs
    The border could not be evened out at the old geometry. The hole's pad radius is
    3.2 mm and the corner radius was 3.0 mm; with the pad larger than the corner,
    every position on the 45-degree diagonal leaves the arc further from the pad than
    the straight edges are. The previous placement also applied the 2 mm long-edge
    pullback to y but only a 0.5 mm fab margin to x, so the pads sat 2.00 mm from the
    long edge and 0.50 mm from the end edge -- not even in any sense.
    It becomes exact when the corner radius equals the hole inset and the hole sits
    at the arc centre: distance from that centre to the arc is R and to eac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
    [isolator.kicad_pcb]
2026-07-31 feat(pcb): round the pour corners for constant copper-to-edge clearance
    The ground pours were rectangles inset 2 mm from the board's NOMINAL square
    corners. With a 6.2 mm corner radius the edge curves away from that corner, so
    the pour crowded the arc: 0.605 mm at the bottom-left against 2 mm along the
    straights. That is the barrier-shorting margin the pullback exists to protect,
    lost precisely where the extrusion grips.
    An inward offset of a circular arc is a concentric arc, so the fix is exact --
    each outer pour corner becomes an arc of radius (6.2 - 2.0) = 4.2 mm about the
    SAME centre as the board's corner arc. The inner edges facing the barrier are
    untouched; those are set by the keepou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
    [isolator.kicad_pcb]
2026-07-31 wip(pcb): shift right-side parts, reroute ISO_5V/PORT_VBUS, thermal pours
    - Move five footprints on the right side ~4.25 mm left; drop the old
    ISO_5V dogleg and route it up through 173,89 instead.
    - Add PORT_VBUS routing out to 202,107.9 and widen four segments to 0.3.
    - GND2 via at 170.5,90.5; remove the stale via/segments near 176.5,102.5.
    - Zone defaults: 1.0 mm corner radius, full smoothing, thermal-relief pad
    connection; all pours refilled.
    [isolator.kicad_pcb, isolator.kicad_sch]
2026-07-31 docs(spec): isolated-side net split and decoupling ownership
    Splits /ISO_5V, /DCDC_RAW and /PORT_VBUS into per-owner branch nets joined
    at three KiCad net ties, adds the three missing capacitors (ADuM4165 VBUS2
    bypass, TPS2553 output bypass, T1 centre-tap bulk), and restores the
    per-cap ownership Description convention to the isolated side.
    Schematic-only scope; board resync and reroute deferred to a follow-on plan.
2026-07-31 docs(spec): correct cap ownership after reading the rendered sheet
    The schematic already encodes ownership by drawing position, which the
    parsed netlist hid. C12 is drawn beside C13 at U1's VBUS2/VDD2 pins and is
    the VBUS2 bypass -- it is not a spare, and no new part is needed there.
    C14/C15 are drawn beneath U6 and are its output pair. Both landed elsewhere
    on the board because /ISO_5V and /PORT_VBUS each serve several pins.
    The genuinely missing part is U6's input cap, which never existed: C16.
    Renumbers the T1 centre-tap bulk C18 -> C17. Two new caps, not three.
2026-07-31 docs(plan): implementation plan for the isolated-side net split
    Six tasks, each splitting one net end-to-end so ERC stays green at every
    commit. Coordinates for NT1-NT3, C16 and C17 were checked against a full
    occupancy model of the sheet and against each section's graphic box, and
    both embedded scripts were run against the current netlist before being
    written down -- the gate's pre-split failure output in Task 1 is real
    output, not a prediction.
2026-07-31 feat(sch): split /DCDC_RAW into rectifier output and LDO input at NT2
    [isolator.kicad_sch]
2026-07-31 fix(sch): NT2 net tie must not appear in BOM
    in_bom yes on the placed NT2 instance overrode the Device:NetTie_2
    library default of in_bom no. Task 5's BOM acceptance check requires
    NT1-NT3 absent from isolator-bom.csv.
    [isolator.kicad_sch]
2026-07-31 feat(sch): split /PORT_VBUS into switch output and connector at NT3
    [isolator.kicad_sch]
2026-07-31 feat(sch): split /ISO_5V into LDO, VBUS2, switch and indicator branches at NT1
    [isolator.kicad_sch]
2026-07-31 feat(sch): add C16 TPS2553 input bypass and C17 T1 centre-tap bulk
    [isolator-bom.csv, isolator.kicad_sch]
2026-07-31 fix(sch): correct #PWR020 GND1 template parity and label overlaps on C16/C17
    - #PWR020 was missing (hide yes) on Reference, (justify left) on Value, and
    (fields_autoplaced yes) on the symbol block, unlike all 17 other power:GND1
    instances. The unhidden Reference rendered "#PWR020" directly over C17's
    body. Structure now verified byte-for-byte parity with #PWR05 (146 tokens,
    differing only in coordinates/uuid/reference).
    - C16 and C17's Reference/Value fields were placed with only a 0.254 mm offset
    (vs. the house-style 2.54 mm used by C6/C7/C12), causing real text overlap
    with their own net labels. #PWR020's Value "GND1" was also placed above the
    symbol instead of below, collidi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
    [isolator.kicad_sch]
2026-08-01 docs(sch): record each cap's owning pin and the three star points
    [isolator.kicad_sch]
2026-08-01 docs(sch): add C5's missing ADuM4165 VDD1 bypass Description
    Item 5 of the LAYOUT CONSTRAINTS block (commit 6915775) named C5 as one
    of the four ADuM4165 bypass caps, but the brief's Step 1 table omitted
    C5's own Description property, leaving it on the stock library string.
    Sets it verbatim per the brief author's follow-up text.
    [isolator.kicad_sch]
2026-08-01 fix(sch): finish sheet-wide GND2 label stub sweep
    Extends the last 2 of the 23 bare GND2 local-label stubs whose text
    overlapped their own pin's name text (J2's SH/A1 shield and GND pins),
    using the same 6.35 mm stub convention landed in 6915775. The other 21
    were already either fixed in 6915775 or found to have adequate
    clearance on inspection; no other true overlaps were found sheet-wide,
    and GND1 has zero bare local labels (all 18 instances use proper
    power:GND1 symbols, confirmed defect-free).
    One candidate (CY1's GND2 stub, near the BARRIER STITCHING title) was
    tried with the same extend-and-move fix and reverted: extending it
    introduced a new overlap against the title text where none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
    [isolator.kicad_sch]
2026-08-01 fix(sch): correct C7's stale centre-tap claim, R7 label overlap, DRC severities
    C7's Description still told a board worker the T1 centre-tap was a valid
    placement target after C17 took over that duty in 6915775 -- the exact
    ambiguity this branch exists to remove. Rewritten to point at C17 and rule
    out both the centre-tap and J1.
    R7's PORT_VBUS_J2 label grew three characters in the PORT_VBUS rename and
    started drawing through the DOWNSTREAM ESD box title's "(GND2)". Neither
    shortening the stub nor flipping the label's rotation cleared it -- the
    title text runs under x=250.5mm and R7 sits at x=247.65, so no vertical
    placement in that channel avoids either the title above or the resistor
    body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
    [isolator.kicad_sch]
2026-08-01 fix(sch): NT1 reference offset, PWR_FLAG stub overlaps, stale net names
    NT1 is a NetTie_4 (4-pin) but was using the NetTie_2 +1.27mm Reference
    offset, so the net-tie bar drew through the "T" of "NT1". Moved to +2.54mm,
    matching the wider footprint; NT2/NT3 (NetTie_2) were already correct.
    The two new PWR_FLAG stubs (ISO_5V_VBUS2, ISO_5V_SW) inherited the sheet's
    7.62mm stub convention, sized for names up to ~9 characters, but both text
    strings grow tall enough to draw through their flag diamonds. Extended to
    13.97mm/10.89mm respectively, matching VBUS_HOST's clearance; still inside
    the POWER FLAGS box bounds and clear of the neighbouring flags.
    Three Description properties named nets that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
    [isolator.kicad_sch]
2026-08-01 docs(spec): correct ERC-catches-everything claim, restate unchanged capacitance
    Verification item 1 claimed a mis-wired net tie always fails at ERC. True
    for five of the eight branches, but /ISO_5V_VBUS2 and /ISO_5V_SW each carry
    their own PWR_FLAG, which satisfies power_pin_not_driven on its own -- ERC
    would stay quiet if either tie came loose. decoupling_nets.py is the real
    backstop on those two. Corrected so the next reader doesn't over-trust ERC.
    Also strengthened the /PORT_VBUS_J2 risk entry with the point the review
    made: total output capacitance is unchanged by the split -- same C14/C15
    parts and values, only their position relative to the branch boundary is
    now pinned.
    Co-Authored-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
2026-08-01 docs: board resync design + implementation plan
    Seven tasks bringing isolator.kicad_pcb to the split netlist, then a full
    isolated-side re-place and re-route around the three net-tie star points.
    The decoupling gate is written first and watched to fail, same pattern the
    schematic pass used. Its ownership table -- 14 capacitors, each with an
    owning pin and a datasheet-derived distance budget, plus three ordering
    rules -- is the specification the placement task is measured against.
    Every pcbnew API the plan calls was run against the real board first;
    coordinate frames, gate signatures and the barrier geometry are all
    verified rather than assumed.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
2026-08-01 chore: track component datasheets in-repo
    datasheets/ was gitignored, so the PDFs lived only on my machine while
    the extracted pin tables that reference them were committed. Un-ignore
    the directory and add the 12 PDFs + manifest.json so the sourced
    datasheet and the extraction derived from it travel together.
    ~22 MB of PDFs. No git remote on this repo, so nothing is redistributed.
2026-08-01 test(gates): assert decoupling capacitor ownership and ordering on the board
2026-08-01 docs: correct measured distances to pcbnew's values, fix C8's owner rule
    The plan's 'current' column was hand-parsed from the .kicad_pcb text and was
    off by up to 0.9 mm against what pcbnew actually reports. The gate's numbers
    supersede it.
    More substantively, C8's rule was wrong. D1.1 and D2.1 are 6.21 mm apart and
    both feed the reservoir, so 'nearest owner pin wins' let C8 sit 4.13 mm from
    one cathode and 5.62 mm from the other and report compliant. C8 now measures
    to the FARTHER cathode, budget 4.5, which is what 'reservoir at the cathode
    junction' actually means.
2026-08-01 fix(gates): measure C8 to farther diode cathode, not nearest
2026-08-01 fix(gates): correct C12 distance figure in docstring (26.46→26.21)
2026-08-01 feat(pcb): resync board to the split netlist, park C16/C17/NT1-3
    [isolator.kicad_pcb]
2026-08-01 docs: correct the false 'Gate 3 passes today' premise
    Gate 3 fails on main and always has -- both pairs at ~2.9 mm intra-pair skew
    against its 0.15 mm limit. The spec and plan both asserted it passed, which
    made /PORT_D+/- read as a regression risk when it is actually an opportunity:
    that pair is ripped anyway, so Task 6 can match it properly.
    Ruling: match /PORT_D+/-, leave /HOST_D+/- frozen as a recorded pre-existing
    failure. Task 7's acceptance reads Gate 3's /PORT_D+/- line rather than its
    overall verdict. The 0.15 mm limit stays where it is -- 2.9 mm is ~19 ps,
    inside USB 2.0's real budget, but relaxing a limit to clear a failure is not
    how this gets closed.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
2026-08-01 feat(pcb): rip up all isolated-side routing and the VBUS_HOST rail
    [isolator.kicad_pcb]
2026-08-01 docs(pcb): correct false Gate-3 claim, note straddle-check limitation
    NEVER_RIP's comment claimed Gate 3 already passes on /HOST_D+-; it never has
    (~2.9 mm skew, verified against main). Reworded to state the pair is frozen
    by the plan, not by being correct. Also documented that the straddle test is
    a full-span detector, not an any-intrusion one -- deliberate, since U1/T1/CY1
    have pads legitimately inside the keepout span.
2026-08-01 chore(datasheets): keep PDFs out of git, prune stale parts
    Datasheet PDFs stay on disk but out of VCS -- vendor-copyright, ~20 MB of
    binary, re-fetchable from the MPNs in isolator-bom.csv. .gitignore now
    covers datasheets/*.pdf and manifest.json. The extracted/*-pins.md notes
    stay tracked: those are our own text, not vendor documents.
    Pruned five parts no longer in the schematic or BOM (verified absent from
    both): NUP4202W1T2G, TLV7041DBVR, TPS2121RUXR, USB2514B-AEZC, MIC29302WU,
    plus the TPS2121 and MIC29302WU pin extractions.
2026-08-01 feat(pcb): place the isolated side around the three star points
    Places NT1/NT2/NT3 first as topology decisions, then hangs every
    decoupling capacitor off the pin it actually serves. Decoupling gate
    goes from 9 failures to 1; all fourteen distance budgets now pass.
    C9 had 0.02 mm of margin (3.48 against 3.50) and now reads 1.85.
    C8 meets its farther-of budget by closing the D1/D2 cathode pitch
    from 6.21 to 4.20 mm rather than by chasing the cap outward.
    C14/C15 move north out of the /PORT_D+- corridor, leaving y 103.5-111
    empty from x 153 to 190 for Task 6 to length-match in.
    Gate 1 now passes: it was failing at 2.3250 mm between C17.1 and
    C16.2, the two footprints parked below the outline.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
    [isolator.kicad_pcb]
2026-08-01 docs: unfreeze C7, record the placement conflict, flag check_placement.py
    The C6-inboard-of-C7 rule was unsatisfiable with C7 frozen at 2.06 mm from
    U4.2 -- an exhaustive sweep put C6's floor at 2.19 mm. Unfreezing C7 is sound:
    the host-side freeze protected working routing, and /VBUS_HOST carries no
    copper after Task 3 ripped it. The arrangement is what the schematic's own
    Description properties on C6 and C7 already specify.
    Also records that tools/check_placement.py compares board-local thresholds
    against absolute coordinates and reports 58 false failures on an untouched
    board, and that the net-tie footprints have no courtyard.
2026-08-01 fix(pcb): swap C6/C7 at U4's VCC pin, clearing the last decoupling row
    decoupling.py now reports VERDICT: PASS -- all fourteen distance
    budgets and all three ordering rules.
    C6 and C7 were the one row the first pass could not satisfy. C7 sat
    at 2.0625 mm from U4.2 and was frozen; U4's and C7's courtyards leave
    a 0.080 mm gap on the only approach, so an exhaustive sweep put C6's
    floor at 2.1943 mm even with courtyards touching exactly. Alex
    unfroze C7: the freeze existed to protect working routing and Task 3
    had already ripped /VBUS_HOST, and the schematic Descriptions
    ("inboard of C7" / "outboard of C6") plus SN6505B Sec 10 specify this
    arrangement anyway. The old placement was what contrad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
    [isolator.kicad_pcb]
2026-08-01 chore(pcb): drop two DRC exclusions for vias deleted in Task 3
    pcbnew.SaveBoard prunes these deterministically on every save, so
    reverting the change only leaves a permanently dirty working tree.
    Both reference via_dangling items at (167.725, 105.025) and
    (168.725, 106.025). Those vias exist in 2c1167d but not on the board
    today -- Task 3 ripped them with the rest of the isolated-side
    routing. The one surviving exclusion still has matching copper, which
    is why KiCad kept it. This is dead-reference garbage collection, not
    a rules change.
2026-08-01 fix(pcb): delete two copper pours stranded by this task's moves
    Moving 18 footprints across a board with 261 zones without checking a
    zone left two F.Cu power pours ringing the wrong pads:
    /ISO_5V x 171.000-175.000 y 86.000-89.250, 8.043 mm2 stale fill
    now over U5.9 (GND2 thermal pad, entirely inside), U5.6
    (GND2) and U5.5/U5.8 (/DCDC_RAW) -- an /ISO_5V outline
    around an LDO's ground pad and its raw input.
    /DCDC_RAW x 158.800-166.500 y 81.750-91.500, 52.080 mm2 stale fill
    now over D1.1, D2.1, C8.1 (all /DCDC_RECT) and C8.2 (GND2).
    Neither contains a pad of its own net. Both were healthy at 26911ea --
    /ISO_5V held U5.1, U5.2, C10.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
    [isolator.kicad_pcb]
2026-08-01 docs(pcb): note the pad-centre limitation of the stranded-pour guard
    strip_stranded_pours() refuses to delete a pour that still holds a pad
    of its own net, but the test is pad-centre-in-outline. A pad whose
    centre sits outside the outline while its copper clips the edge would
    not trip it. Harmless for the two zones this targets -- neither has any
    pad of its own net within millimetres -- but worth recording so the next
    reader knows it was considered rather than overlooked, and knows to
    tighten it to pad-shape collision before pointing this at a pour that
    hugs its pads.
    Comment only. The board is unchanged.
2026-08-01 feat(pcb): route the eight branch nets through their star points
    Every branch reaches its trunk only through its net tie. Both pads of NT1,
    NT2 and NT3 carry track copper, no tie pad is fed by a pour, and no via sits
    on one. Measured min separation between each tie's two nets, board-wide, is
    0.45-0.50 mm and always at the tie itself.
    Three obstacles Task 4's review named:
    - NT2.1 <- C8.1 goes around C8's own GND2 pad to the south (y 88.300, up at
    x 167.400, entering NT2.1 from the west).
    - NT3.2 -> U3.5 climbs to y 99.350 north of U3 and drops into U3.5 down the
    0.95 mm gap between U3's pad columns, leaving x 194.675..196.975 free for
    Task 6's pair. D6/J2.A4/R7/R8 are reached under th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
    [isolator.kicad_pcb]
2026-08-01 fix(pcb): nudge C7 and C17 clear of the /PP_A and /PP_B windings
    Both caps sat inside DRC clearance of the frozen transformer primary drive as
    Task 4 placed them -- a track-to-PAD conflict a courtyard check cannot see:
    C7.1 y 84.750..85.750 vs /PP_B edges 85.7634..86.0634 -> 0.0134 mm
    C17.1 y 88.050..89.050 vs /PP_A edges 87.6634..87.9634 -> 0.0866 mm
    against a 0.15 mm PWR clearance. C7 moves north 0.20 mm, C17 south 0.12 mm,
    measured 0.2134 and 0.2066 mm after. Ruling: move the capacitors, do not
    re-route /PP_A or /PP_B.
    DRC [clearance] violations 2 -> 0, and no new one anywhere on the board.
    Total 22 -> 19, the remainder all silkscreen; diffed the silk list, one
    overlap cleared and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
    [isolator.kicad_pcb]
2026-08-01 fix(tools): make route_iso.py refuse a double run and assert at shape level
    Three review findings, tool only -- the board does not change.
    1. The script was not idempotent AND every guard passed on a re-run. _probe
    skips same-net items, so a second run collides with nothing, adds 93
    duplicate segments and vias, and connectivity, the tie-pad check, the
    keepout check and DRC all still pass. The only tell was "2 track leg(s)"
    in a column nothing asserted on.
    Both remedies, because they catch different failures: a pre-flight that
    refuses when any of the nine nets already carries copper (wholesale case,
    before anything is written), and an assertion in verify() of exactly one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
2026-08-01 feat(pcb): route PORT_D+/- matched and the remaining isolated-side signals
    /PORT_D+- comes back at 0.21/0.127, 90 ohm class, with Gate 3 reporting
    0.0001 mm intra-pair skew. The F.Cu backbone is 2c1167d's -- U1, U3 and J2
    never moved -- with two changes:
    * the crossover is rebuilt symmetrically at x 167.225..169.225, so it is
    length-neutral by construction rather than by luck;
    * U3.1 -> U3.6 can no longer run straight across the gap between U3's pad
    columns. Task 5 routes /PORT_VBUS_J2 down that 0.95 mm gap to reach U3.5,
    and neither side of it leaves the 0.505 mm a 0.21 mm trace needs. D+ hops
    it on 1.45 mm of B.Cu north of the pad row instead. The eight power nets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
    [isolator.kicad_pcb]
2026-08-01 fix(pcb): make PORT_D+/- structurally symmetric, move R3 for ILIM_SET
    The pair matched at 0.0001 mm skew but was built asymmetrically: D+ carried
    4 vias and 3.12 mm of B.Cu while D- stayed on F.Cu. Leg asymmetry is what
    converts differential into common mode, so that optimised the number the gate
    measures over the thing it protects.
    A planar crossing forces exactly one conductor onto the other layer, but not
    which one. D+ already carries a forced 2-via, 1.450 mm B.Cu hop over
    /PORT_VBUS_J2's trunk at U3, so the crossover dip moves to D- and its diagonal
    is sized to 1.450 mm exactly. Both legs now read 2 vias, 1.4500 mm B.Cu and
    48.5680 mm F.Cu on the measured path. Skew 0.0001 mm, Zdiff [OK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
    [isolator.kicad_pcb]
2026-08-01 docs(spec): rule that D+'s layer hop at U3 stands
    Freeing the inter-column lane was assessed and works geometrically, but total
    pair vias stay at four either way -- removing D+'s hop just inverts the
    asymmetry -- and it requires via-in-pad, a fab-spec change. The hop sits after
    U3's ESD clamp and ~4 mm from the connector. Both legs now carry 2 vias and
    1.450 mm of B.Cu, which was the actual goal.
2026-08-03 wip: manual schematic re-layout and isolated-side board rework
    Hand work done in the KiCad GUI, committed as a checkpoint. Not finished.
    Schematic (nearly every symbol repositioned):
    - VBUS_HOST, VDD1 and VDD2 are now driven by power symbols instead of
    local labels, so the nets lose their leading "/" and are global.
    - NT2 deleted; /DCDC_RECT and /DCDC_RAW merge into one net.
    - U3's two USBLC6 channels swapped (J2 D+ now enters on pin 3, D- on
    pin 1) and the J2-side labels removed, splitting /PORT_D+/- at the
    ESD part.
    - D5 reversed: pin 2 now on VBUS_HOST, pin 1 on GND1.
    - /RECT_A and /RECT_B swapped at T1's secondary (pins 4 and 6).
    - /PG_LED_A and /PG_LED_K labels dropped.
    - D3/D4 v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
    [isolator.kicad_pcb, isolator.kicad_sch]
2026-08-03 feat(sch): make C6 an 0805 so PP_A/PP_B clear beneath it
    C6 goes from C_0603_1608Metric / CC0603KRX7R9BB104 to
    C_0805_2012Metric / CC0805KRX7R9BB104 (100 nF 50 V X7R, LCSC C49678).
    The value is unchanged and deliberately so: SN6505B Sec 9.2.2.4 puts the
    device bypass at 10-100 nF, and 100 nF is already the top of that range.
    The package change buys routing room only. Inter-pad channel goes 0.650
    -> 0.900 mm; two HOST_SIDE traces at 0.2 mm width and 0.15 mm clearance
    need 0.85 mm, so both push-pull legs clear beneath C6 on an 0805 and
    neither pair fits on an 0603.
    Net membership is byte-identical before and after; ERC is unchanged (the
    one remaining error is the pre-existing U5 pin 8 power_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
    [isolator-bom.csv, isolator.kicad_sch]
2026-08-04 wip: manual board re-import and placement pass
    Hand work in the KiCad GUI after the C6 0805 change: schematic re-import,
    board placement and routing. Committed as-is at Alex's request; not yet
    re-verified against the gates.
    [isolator.kicad_pcb, isolator.kicad_sch]
2026-08-04 fix(pcb): restore barrier netclass coverage, swap C6/C7 at U4
    The schematic label rework renamed thirteen nets out from under the
    netclass patterns, which still match the slash-prefixed local-label names
    (/VBUS_HOST, /ISO_5V, /PORT_VBUS, /VDD1, /VDD2, /DCDC_*). VBUS_HOST, VDD1,
    ISO_5V, PORT_VBUS, VDD2, Net-(D1-K), Net-(D3-A/K), Net-(D4-A/K),
    Net-(J2-CC1/CC2) and Net-(U6-ILIM) all fell through to Default, so the
    barrier rules in isolator.kicad_dru -- gated on hasNetclass('HOST_SIDE')
    && hasNetclass('ISO_SIDE') -- never fired on them. DRC reported zero
    violations because those pairs were never tested, and Gate 1 declined to
    run at all rather than report a result it could not trust.
    Each net's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
    [isolator.kicad_pcb]
2026-08-04 feat(pcb): ground pour on both outer layers, stitched
    Four zones, not two: GND1 host-side and GND2 isolated-side on each of F.Cu and
    B.Cu. A single pour per outer layer would bridge the barrier, the same reason
    the inner layers are split. Outlines are cloned from the GND_SPLIT_A planes so
    the 2 mm edge pullback and rounded corners match exactly -- letting the
    board-outline clip generate the corners instead would leave outer copper 0.3 mm
    from the corner edge, closer than the inner layers, on the two layers that
    actually face the extrusion.
    Filled: F.Cu 2157.9 mm2 GND1 / 2030.7 mm2 GND2, B.Cu 2434.4 / 2400.4. Island
    removal is ALWAYS, so no fill region survives without a connection to its ne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
    [isolator.kicad_pcb]
2026-08-04 fix(pcb): rebuild stitching as one 4 mm grid, fence both USB pairs
    The previous pass used add_gnd_stitching_vias with `around_refs`, which anchors
    a fresh grid on every named reference. Five refs on the isolated side produced
    five interleaved phases (x mod 6 mm = 0.88, 2.20, 4.10, 5.72, 5.88) and three on
    the host side, which is why the right half read as scattered and the left as
    merely sparse. Evenness is the point of a stitch grid.
    tools/stitch_and_fence.py replaces it. All 171 vias from that pass are removed
    and rebuilt from the 72 routing vias in 59a6405:
    - 188 grid vias on a single board-anchored 4 mm lattice, 13 columns per side,
    one phase throughout (was 6 mm and multi-phase).
    -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
    [isolator.kicad_pcb]
2026-08-04 docs(gates): record measured +5% bias in diffpair Zdiff estimate
    JLCPCB's field solver returns 8.61 mil (0.2187 mm) for a 90 ohm non-coplanar
    pair on L1/L2 at 5 mil spacing on JLC04161H-7628. The IPC-2141 closed form in
    z_diff_microstrip returns 94.50 ohm at that width, so it reads 5.0% high across
    0.210-0.225 mm -- the mask and etch taper the form omits, in the direction the
    module docstring already predicted.
    The board's 0.210 mm geometry prints 96.28 ohm and is ~91.7 ohm in JLC's terms,
    which is the difference between reading as near the edge of the +/-10% band and
    comfortably inside it. Correction is documented, not applied: it was measured
    for this stackup at this width, and folding it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
2026-08-04 chore(konnect): track project config, correct layer count, record ENIG
    fab_constraints was carrying layer_count 2 from the 2-layer ancestor of this
    board; the stackup is JLC04161H-7628, so it is 4. surface_finish records the
    ENIG decision alongside the (copper_finish "ENIG") now set in the board file --
    the finish drives the JLCPCB order form, and nothing else in the repo said which
    one to pick.
    min_trace_width_mm and min_clearance_mm stay at 0.15, deliberately above the
    board's 0.127 mm floor. That floor exists for the connector-neckdown escape
    inside the J1/J2 courtyards, not as a general routing target.
2026-08-04 fix(fp): correct T1 land pattern to datasheet 11.31 mm pad pitch
    WE_750313638 had its pad columns at +/-4.705 mm, which is the lead *inner
    edge* distance, not the pad centre. Every pad sat 0.95 mm too far inboard,
    so the part's 12.7 mm lead span overhung the copper by ~0.7 mm per side and
    the imported STEP would not sit on the pattern.
    Pads moved to +/-5.655 mm (11.31 mm column pitch, datasheet p.1). Pad size
    1.9 x 1.14 and 3.05 mm row pitch were already correct and are unchanged.
    Knock-on fixes:
    - Courtyard to +/-6.855 x +/-4.82; the old +/-6.6 now falls inside the pads.
    - Pin-1 dot to (-5.655, -4.3); its old spot at (-6.15, -3.05) is inside the
    new pad 1. Pad 1 is rect vs roundrect for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
    [isolator.kicad_pcb]
2026-08-04 chore: keep vendor CAD downloads in lib/ out of the repo
    The SnapEDA/SnapMagic license shipped with these packages grants the right
    to distribute boards built from the models but forbids redistributing the
    models themselves, and this repo is public. Same treatment datasheets/*.pdf
    already gets, and the comment records which MPN each directory came from so
    they can be re-fetched.
    T1's footprint references ${KIPRJMOD}/lib/750313638/WE-PPTI_1209.step, so a
    fresh clone will not resolve that 3D model until the package is downloaded
    again. The land pattern itself is in isolator-lib.pretty and is tracked, so
    fabrication output is unaffected.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
2026-08-04 feat(fp): attach CY1 3D model from the LCSC package for C2914611
    EasyEDA carries a model for the exact SKU (Songtian Q07F3Z102MA5B0S0N0,
    LCSC C2914611), package CAP-TH_L7.0-W5.0-P14.0-D0.6 -- 7.0 mm dia, 5.0 mm
    thick, 14.0 mm pitch. No stock KiCad C_Disc_* model exists at 14 mm pitch,
    which is why this footprint had none.
    The vendor footprint centres its origin on the body (pads at +/-7.0) while
    this one sits on pad 1 (pads at 0 and 14), hence offset (7, 0, 0) with no
    rotation. Verified in a render: body centred between the holes, seated on
    the top surface, leads through.
    The model is 5.0 mm thick; the datasheet gives T = 5.0-5.5 mm max, so this
    is the thin end of the tolerance. Add 0.5 mm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
2026-08-05 wip(pcb): routing pass, plus T1 and CY1 3D model transforms
    Board-side counterpart to d3eae8f: CY1 now carries the C2914611 model and T1
    carries a corrected transform for the SnapEDA STEP, which previously rendered
    far off its pads at identity.
    Routing since cc2154e: traces 239 -> 251, arcs 155 -> 167, vias 285 -> 295,
    zones 179 -> 213. T1's corrected land pattern is intact (pad 1 at x=141.22).
    Snapshot of work in progress, not a fab-ready state. DRC reports one error:
    an invalid_outline from two zero-length Edge.Cuts shapes, a degenerate polygon
    at (0, 0) and a zero-length line at (86.875, 95.0). Connectivity is clean
    (0 unconnected).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
    [isolator.kicad_pcb]
2026-08-05 fix(pcb): repair board outline, notch edge for USB-C cable clearance
    Outline: removed a zero-length Edge.Cuts segment at (86.875, 95.0) that was
    tripping invalid_outline. The Edge.Cuts polygon flagged alongside it is the
    isolation-barrier slot and was left alone.
    Cable clearance: J1 and J2 both sat 1.43 mm behind the board edge (faces at
    x=88.305 and x=205.445 against edges at 86.875 and 206.875), so a bulky USB-C
    overmould hit the board before the plug seated. Cut a 14 mm wide relief in
    each edge, 1.43 mm deep, taking the local edge to the connector face. The
    notch spans y 94.703..108.703, centred on the connectors at y=101.703 and
    2.5 mm clear of the 9.04 mm connector body on each side.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
    [isolator.kicad_pcb]
2026-08-07 feat(pcba): JLC sourcing pass, test points, via stitching, no-via-in-pad rule
    - LCSC + MPN properties on every BOM line for JLC assembly. R8 uses
    C228101 (YAGEO AC0603FR-0793K1L) rather than C273780 (RC0603FR-...);
    same 93.1k 1% 0603, but the AC series is the one JLC has depth on.
    - 19 test points (TP1-TP19) on the rails and control nets.
    - PWR_FLAG/power symbol renumbering shakes out of the above.
    PCB:
    - Routing pass; ground stitching takes vias 298 -> 954.
    DRU:
    - no-via-in-pad, expressed as physical_hole_clearance 0.2 mm so it
    survives the same-net clearance exemption. Derivation is in the rule
    comment: 0.5/0.3 mm via geometry against JLC's minimum mask dam.
    Co-Author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
    [isolator.kicad_pcb, isolator.kicad_sch]
2026-08-08 docs(spec): rev B isolated 4-port hub design
    Fresh design taking the ADuM4165 + SN6505B core from rev A and the hub
    architecture from 4port-archive, plus three things neither had:
    - Upstream USB-C CC current sensing, so the board can legally draw
    ~870 mA from a host advertising 1.5 A instead of being capped at the
    USB 2.0 default. This is what makes bus-powered operation useful.
    - Synchronous buck replacing the post-rectifier LDO.
    - Plastic enclosure with two local RF shields instead of a metal case.
    The CC sense drives SN6505B.EN on GND1, and the external supply reaches
    ISO_5V through the mux independently, so the whole power state machine
    works with no signal crossing the barrier.
    R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
2026-08-08 docs(plan): rev B hub schematic implementation plan
    Twelve tasks from project skeleton to reviewed schematic. Scoped to
    schematic capture only — PCB layout, shield placement and creepage
    budgeting, fabrication, and bring-up are follow-on plans.
    Two tasks exist because the spec left real uncertainty rather than
    detail:
    - Task 2 resolves the post-rectifier converter. The spec understated
    this: DCDC_RAW may sag to ~5.4 V at 625 mA, putting a 5.0 V buck at
    ~93% duty, so the task evaluates buck vs buck-boost vs a turns-ratio
    change rather than assuming a buck fits.
    - Task 10 rebuilds the power budget from the parts actually captured,
    because the spec's 390 mA rests on an 85% transform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
2026-08-09 feat(pcba): fab-prep pass — fiducials, tooling holes, sourcing fixes
    Prepares rev A for assembly:
    - FID1-3 grow from 0.5mm/1.5mm mask to 1mm/2mm mask, in both the
    schematic and the board, so the assembler's vision system can find
    them.
    - TH1/TH2 tooling holes added to the board.
    - R8's MPN corrected AC0603FR-0793K1L -> RC0603FR-0793K1L
    (LCSC C228101 -> C273780). The RC series is the +/-1% +/-100ppm/K
    family the ILIM calculation assumes; AC was the wrong series.
    - Zones refilled; count unchanged at 211.
    [isolator.kicad_pcb, isolator.kicad_sch]
2026-08-09 chore(sourcing): track DigiKey/Mouser BOM work, ignore fab outputs
    bom/ is curated sourcing, not generated output -- it carries the
    substitution reasoning (e.g. the Murata 4.7uF being obsolete at DigiKey,
    substituted with Taiyo Yuden) and the per-quantity order CSVs for 5/10/25
    boards. That judgement is worth keeping.
    Ignored instead: production/ (one-click regenerable), the freerouting
    .dsn intermediates, and the DRC violations dump. Kept
    fabrication-toolkit-options.json -- it is the config that makes the
    outputs reproducible, not an output.
    [digikey-5boards.csv, isolator-bom-digikey.csv, mouser-5boards.csv]
2026-08-09 feat(revb): project skeleton on shared isolator-lib
    [hub.kicad_pcb, hub.kicad_sch]
2026-08-09 docs(revb): part selection — converter topology, 3V3 rail, comparators
2026-08-09 docs(revb): fix TPS2121 CP2/PR1 polarity, R_extra argument, switch drops
2026-08-09 docs(revb): correct EN pull-up arithmetic, worst-case switchback band
2026-08-09 fix(revb/docs): correct TPS2121 mechanism and the CC wire-OR pull-down
    Two errors I wrote into the spec and plan, found by Task 2 and confirmed
    against the datasheets on review. Both would have reached hardware.
    TPS2121: the spec's DR-06 carry-forward and plan Task 6 Step 3 both said
    "CP2 must be driven by the 3 A-detect net." Per SLVSEA3F Table 9-3, CP2
    high with PR1 low selects IN2 -- the converter -- so that wiring makes the
    mux ignore an external supply exactly when it has been confirmed good, and
    fall into VCOMP mode when it has not. VCOMP picking the higher input is
    the precise failure DR-06 exists to prevent, so the instruction delivered
    the bug it was written to avoid. The behaviour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
2026-08-09 feat(revb/sch): upstream USB-C, ESD, ADuM4165 Side 1, crystal
    Task 3: host-side USB-C receptacle (J1), USBLC6-2SC6 ESD array (U2),
    ADuM4165 GND1-side pins (U1), 24MHz crystal network (Y1/C5/C6), CC
    pulldowns (R1/R2), and VBUS_HOST protection/bypass caps (D1/C1/C2/C3),
    plus VDD1 bypass (C4).
    Produces nets VBUS_HOST, GND1, HOST_D+, HOST_D-, VDD1, CC1_HOST,
    CC2_HOST. VBUS_HOST capacitance budget: C1+C2+C3 = 4.9uF of 10uF limit.
    GND1/GND2 domains kept separate; U1's GND2-side pins left unconnected
    for later tasks. ERC exit 0 (11 expected violations: PWR_FLAGs deferred
    to Task 9, U1 GND2-side pins deferred to Task 5+).
    [hub.kicad_sch]
2026-08-09 fix(revb/sch): layout-only pass on hub.kicad_sch overlap sites
    Fixes four text-overlap sites flagged in review (U2 ref/value on its own
    pin numbers, section title colliding with the frame's row-index glyph,
    J1's Value field crowding the B6 pin row, C3/C4 bypass-cap label stack
    interleaving with their power-net labels), plus one collision (D1
    ref/value) introduced by autoplace while fixing the others.
    Connectivity unchanged: netlist hash verified identical to the
    pre-fix baseline (2b127eee2f7068bca0e8665d0f312b04d2413b00) after every
    edit in this pass. ERC exit 0 throughout.
    [hub.kicad_sch]
2026-08-09 fix(revb/sch): resolve Task 3 text-overlap round 2, add overlap checker
    Round 1's autoplace_schematic_fields left Reference/Value pairs on 11
    components (U1, Y1, U2, R1, R2, C1-C4, C5, C6) exactly 1.27mm apart —
    one line-pitch, zero clearance — and never touched power-symbol Value
    fields, leaving #PWR017/#PWR021 and J1/#PWR013 colliding too.
    Add tools/check_sch_text_overlap.py: parses the schematic's own
    S-expression tree, extracts every visible text item (symbol
    properties, net labels, free text), and flags any pair closer than
    the project rule of thumb (2.54mm Reference-to-Value, 1.27mm
    everything else). Reusable gate for Tasks 4-8.
    Fix all 15 overlaps it found by repositioning Refer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
    [hub.kicad_sch]
2026-08-09 feat(revb/sch): upstream CC current-advertisement sensing
    Task 4: adds the CC1/CC2 comparator sensing circuit (U3 TLV7042DDFR, R3-R9,
    C7-C8, Q1-Q2, D2) that produces HOST_PWR_OK from a VBUS_HOST-referenced
    0.66V divider, per decision record section 4.2. Wire-OR polarity is
    inverting-comparator + pull-up + NMOS inverter, not the brief's original
    either/or. Adds design-note text recording the threshold rationale, the
    VBUS_HOST-only constraint, the VCONN false-high caveat, and the R_EN
    sizing math.
    [hub.kicad_sch]
2026-08-09 fix(tools): width of multi-line text is the longest line, not the sum
    Summing every character across newlines made a wrapped note span the whole
    page and collide with everything on it. Task 4 spent several iterations
    chasing the false positives.
    Also records the related trap in a comment: KiCad's parser rejects raw
    newlines inside a (text ...) value -- kicad-cli reports "Failed to load
    schematic" while direct SVG rasterisation renders the same file fine, so
    the breakage is invisible unless you explicitly re-export. The convention
    here is one single-line text node per line.
2026-08-09 feat(revb/sch): SN6505B isolated DC-DC gated by host CC sense
    Task 5 of the revb-hub-schematic plan — the isolated power chain and
    first GND2-domain circuitry (push-pull converter, rectifier, buck-boost).
    - U5 (SN6505BDBV) push-pull driver: VCC/GND on GND1 via C10 (0.1uF bypass)
    + C11 (4.7uF mandatory VCC bulk); EN <- HOST_PWR_OK (the change from both
    predecessor boards, which tied EN to VBUS permanently).
    - T1 (750313638) transformer bridges GND1 (primary) to GND2 (secondary,
    CT2 -> GND2). C12 centre-tap bulk trimmed to 0.1uF (see budget below).
    - D3/D4 (SS34, Device:D_Schottky) full-wave centre-tap rectifier into
    DCDC_RAW, side by side per the brief.
    - U6 (TPS630701RNMR, fixed 5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
    [hub.kicad_sch]
2026-08-09 feat(revb/sch): external USB-C input, 3A detect, TPS2121 priority mux
    Task 6. Adds J2 (power-only USB-C 6P) with per-CC Rd to GND2, TVS/bulk
    caps on EXT_5V, a second TLV7042DDFR 3A-detect instance (1.23V
    threshold, GND2 domain) driving the TPS2121 priority mux via a 2N7002
    inverter, and the mux itself producing ISO_5V.
    Per the corrected decision record (part-selection.md §4.3, overriding
    the brief's original Step 3): CP2 is a static bias from IN2
    (ISO_5V_PRE) via 23.7k/10.2k -- never driven by the 3A detect, which
    was the original error. PR1 is what the 2N7002 inverter drives, via
    17.8k/10.0k from EXT_5V. This gives a designed switchback (handback to
    the converter) at IN1 ~4.18V nominal, 3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
    [hub.kicad_sch]
2026-08-10 fix(revb/sch): A3 paper, and teach the checker about page bounds
    The A4 sheet ran out around Task 5 and content began spilling past the
    left frame edge, where it is silently clipped on plot. Tasks 7 and 8 add
    roughly fifty more parts.
    Paper changed A4 -> A3 (297x210 -> 420x297). Neither MCP server exposes
    paper size, so this is a hand edit to hub.kicad_sch, made with explicit
    approval from the project owner and against a netlist-identity gate:
    59 nets, sha 38d337af069d, byte-identical before and after. The edit
    touches one token and no UUID, reference, or structural element.
    The overlap checker missed this entirely because it only compares text
    bounding boxes pairwise -- it had no concept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
    [hub.kicad_sch]
2026-08-10 fix(revb/sch): A3 re-flow — left-justify off-page design notes, clear Task 6 header space
    Fixes all 22 off-page/under-title-block text items flagged by
    tools/check_sch_text_overlap.py on the new A3 paper: the CC-sensing and
    Task 6 design-note blocks were center/near-top justified and ran off the
    left edge or top frame. Re-added left-justified within the frame, and
    nudged the handful of J2-cluster field labels that collided with the
    relocated Task 6 header. Text-only changes plus small field-label
    repositions; netlist verified unchanged (59 nets, sha1 38d337af069d...)
    after every batch.
    Isolated-power decluttering was attempted but reverted: move_region and
    move_connected both snap non-gri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
    [hub.kicad_sch]
2026-08-11 feat(revb/sch): ADuM4165 Side 2, USB2514B hub, 3V3 rail (hand-captured)
    Captured directly in eeschema rather than through MCP tooling; the file is
    now eeschema-generated (version 20260306). 59 -> 91 nets, 105 components.
    Verified against the plan's constraints:
    - no pin appears on more than one net (no shorts)
    - VDD2 = exactly U1.18 + C29 0.1uF, nothing else
    - PORT_D+/- = U1.12/13 to U11.31/30
    - RBIAS = R32 12.0k 1% on U11.35
    - PGOOD2 driven through Q4 with R31 100k gate pull-down, per rev A
    - isolation check clean: only U1 and T1 bridge domains (CY1 still pending)
    PRTPWR1-4 and OCS1-4 are single-pin nets by design; Task 8 connects them.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
    [hub.kicad_sch]
2026-08-11 fix(revb/sch): pull J2, U11 and EXT_5V field text back inside the A3 frame
    Four of five off-page items fixed: J2's Reference/Value sat above the top
    frame line (y 2.5/5.1), U11's Value below the bottom (y 288.3), and
    #PWR113's EXT_5V value in the top margin. All would clip on plot.
    The remaining one is a GND2 net label at y 293.4, which needs a label-move
    tool -- Konnect is disconnected, so it stays for now.
    Netlist unchanged at 91 nets.
    [hub.kicad_sch]
2026-08-11 chore(revb): KiCad-populated hub.kicad_pro project settings
    The skeleton created in Task 1 was a stub; opening the project in KiCad
    filled in the board design settings, netclasses and defaults block.
2026-08-23 feat(revb/sch): Task 8 ports 1-3 — 2x TPS2553 USB-A switches, 1x USB-C w/ CC pull-ups
    Port 1 (J3, USB-A) and Port 2 (J4, USB-A) complete: TPS2553DBV switch,
    46.4k 1% ILIM (sized from SLVS841F's three threshold equations so
    I_OS(min) clears the 500 mA per-port target), USBLC6-2SC6 ESD, TVS,
    in/out bypass caps, wired to the hub's PRTPWRn/OCSn/USBDM_DNn/USBDP_DNn
    pins.
    Port 3 (J5, USB-C) complete: same switch block plus two dedicated 56k
    CC pull-ups (never shared, per Default USB Power / rev A brown-out
    lesson), D+/D- pinned together across the connector's redundant pads.
    Port 4 (J6, USB-C) not yet placed — ran out of contiguous free sheet
    area near the other three; needs a placement deci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
    [hub.kicad_sch]
2026-08-23 feat(revb/sch): Task 8 complete — Port 4 (J6, USB-C) placed and wired
    Port 4 needed a compact single-row template in the ~35x130mm pocket
    above the design-notes text at bottom-left (x=0-140, y=190-225) — the
    only contiguous free area left after ports 1-3 filled the right
    column. J6 is rotated 90 deg so its 38mm pin spread runs horizontally
    where there's room, instead of vertically where there wasn't.
    All four ports now verified structurally identical per net topology:
    - PORT{1-4}_VBUS: switch OUT + both bulk caps + TVS + ESD VBUS + every
    physical VBUS pin on the connector (USB-C ports tie 4 redundant
    VBUS pads together automatically — same schematic point).
    - PRTPWR{1-4}/OCS{1-4}: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
    [hub.kicad_sch]
2026-08-23 feat(revb/sch): Task 9 complete — CY1, PWR_FLAGs, ERC zero
    CY1 (1 nF Y1-rated, 400 VAC) placed between GND1/GND2 as the sole
    intentional barrier bridge, Description field documents the safety
    rating. Seven PWR_FLAGs added in a dedicated corner block for every
    externally-driven power net ERC couldn't otherwise resolve: GND1,
    GND2, VBUS_HOST, EXT_5V, VDD1, DCDC_RAW, ISO_3V3.
    ERC driven from 48 violations down to 2 (both a confirmed-benign
    kicad-cli lib_symbol_mismatch quirk on TLV7042DDFR — byte-identical
    content verified against the library master, re-sync doesn't clear
    it). Isolation check holds: only U1, T1, CY1 bridge domains.
    Along the way, fixed real bugs surfaced by driving ERC to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
    [hub.kicad_sch]
2026-09-10 chore(revb): checkpoint current KiCad files before TI revision
    [hub.kicad_pcb, hub.kicad_sch]
2026-09-10 feat(revc): capture TI hub and hardware power protection
    [hub-converter.kicad_sch, hub-distribution.kicad_sch, hub-external.kicad_sch, hub-host.kicad_sch, hub-hub.kicad_sch, hub-isolation.kicad_sch, hub-port_c3.kicad_sch, hub-port_c4.kicad_sch]
2026-09-10 feat(revc): assign exact BOM and verified local land patterns
    [BOM-covers.csv, BOM.csv, hub-converter.kicad_sch, hub-distribution.kicad_sch, hub-external.kicad_sch, hub-host.kicad_sch, hub-hub.kicad_sch, hub-isolation.kicad_sch]
2026-09-10 feat(revc): place synchronized unrouted board and correct bus startup
    [BOM.csv, bypass-placement.csv, hub-bus_start.kicad_sch, hub-converter.kicad_sch, hub-distribution.kicad_sch, hub-external.kicad_sch, hub-host.kicad_sch, hub-hub.kicad_sch]
2026-09-10 feat(revc): finish verified TI hub routing handoff
    [BOM-covers.csv, BOM.csv, bypass-placement.csv, hub-bus_start.kicad_sch, hub-converter.kicad_sch, hub-distribution.kicad_sch, hub-external.kicad_sch, hub-host.kicad_sch]
